RMSHE-MSH/Mechanical_Design_Course_Project_Open_Source/README.md

# 机械设计课程设计开源项目
# Mechanical Design Course Project Open Source

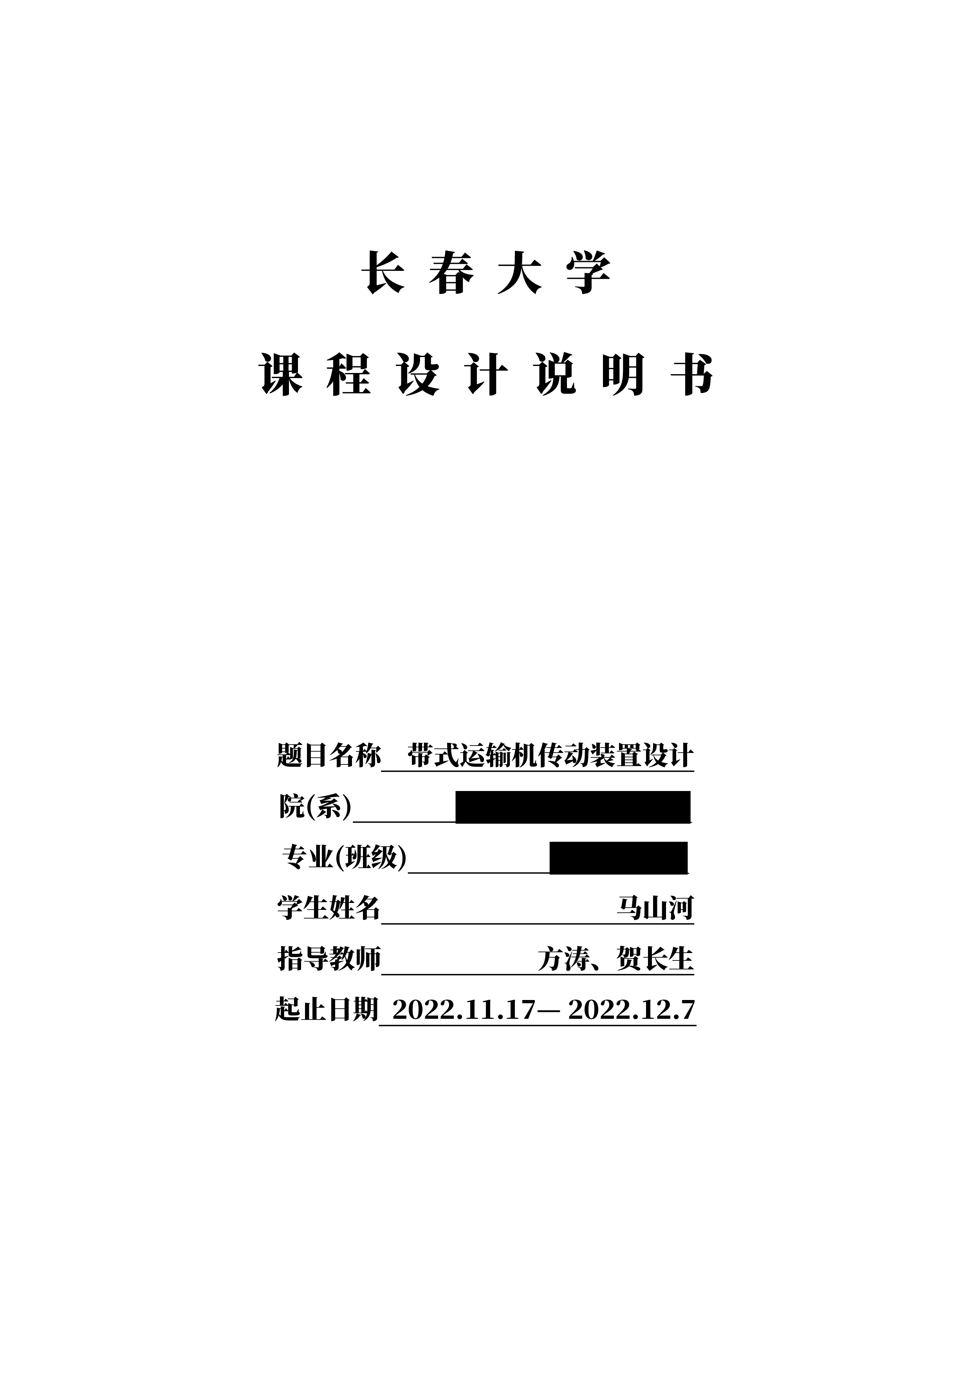
[picture p1: instruction/1.png]
instr

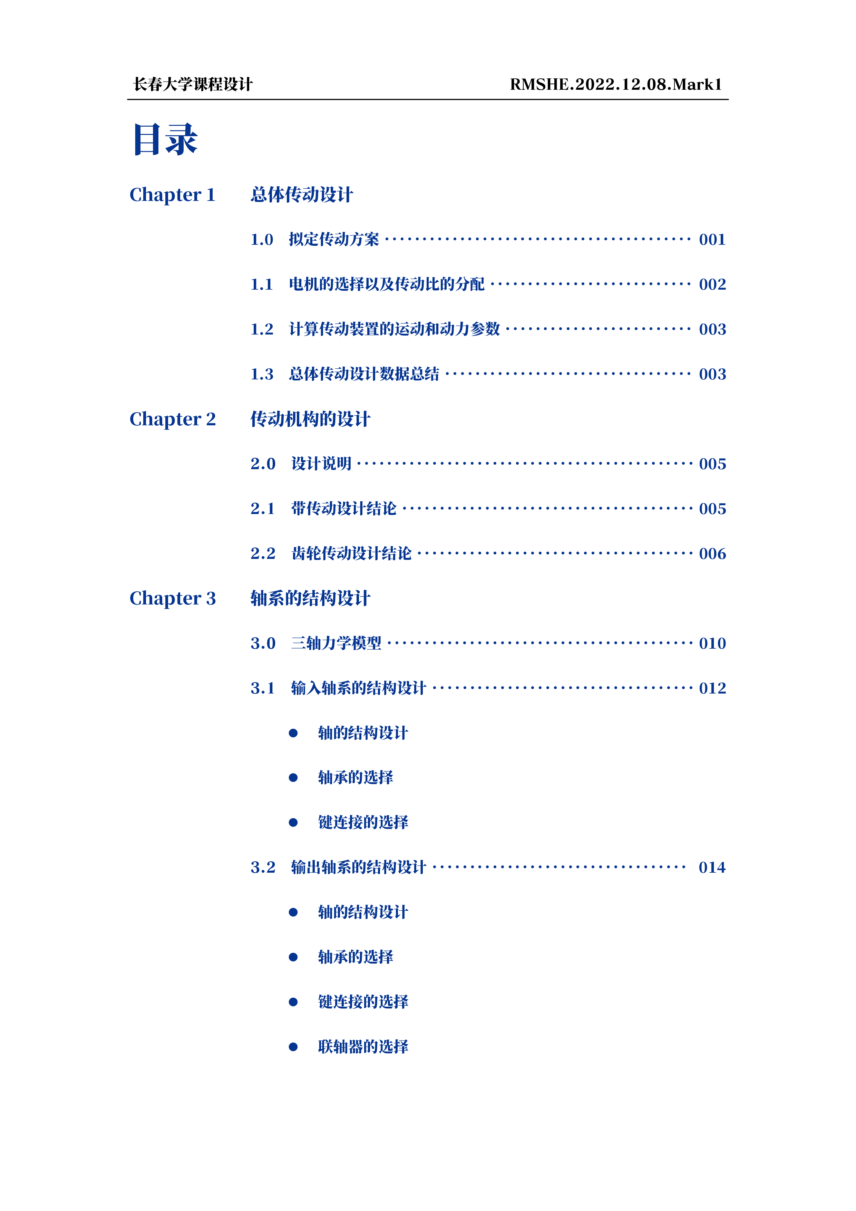
[picture p2: instruction/2.png]
instr

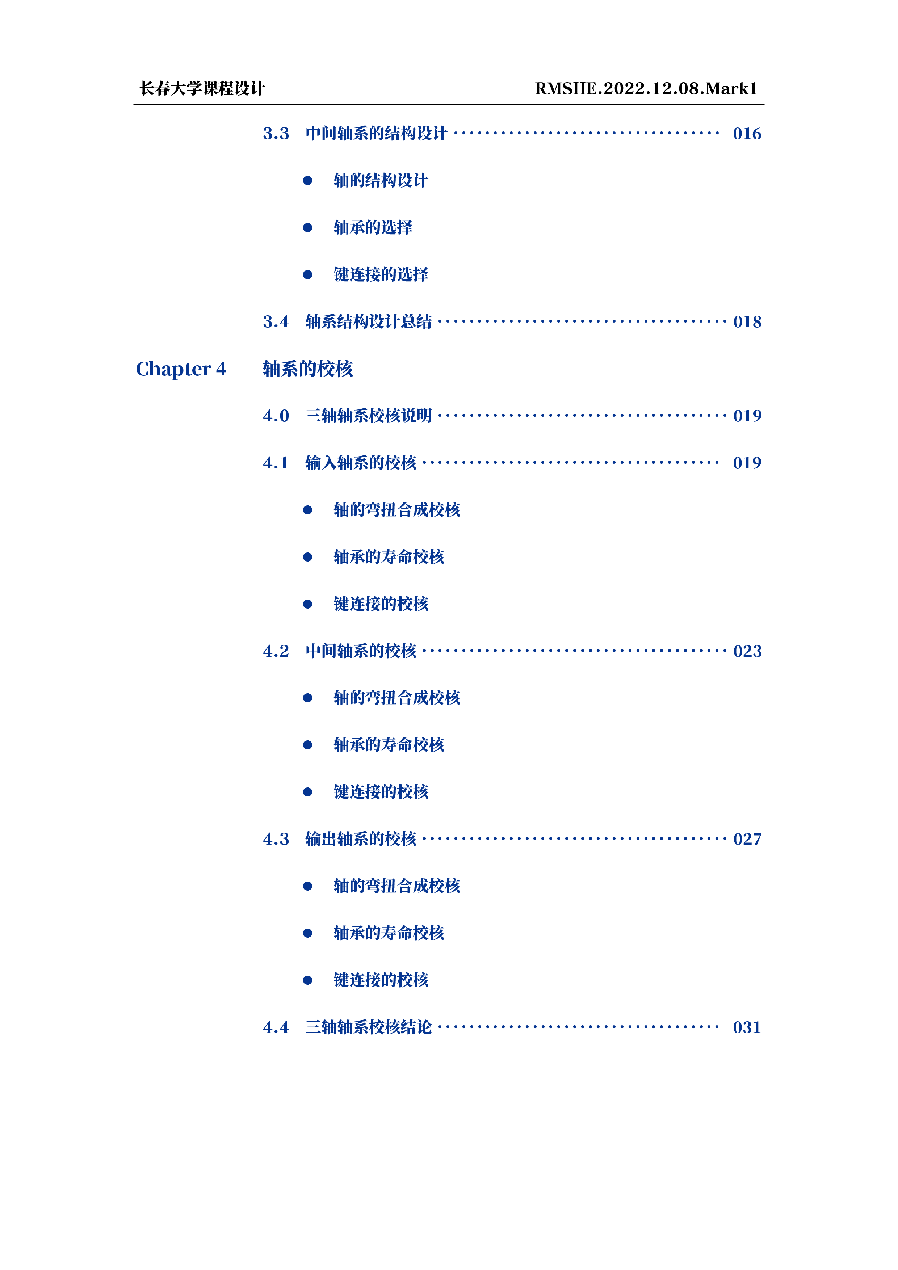
[picture p3: instruction/3.png]
instr

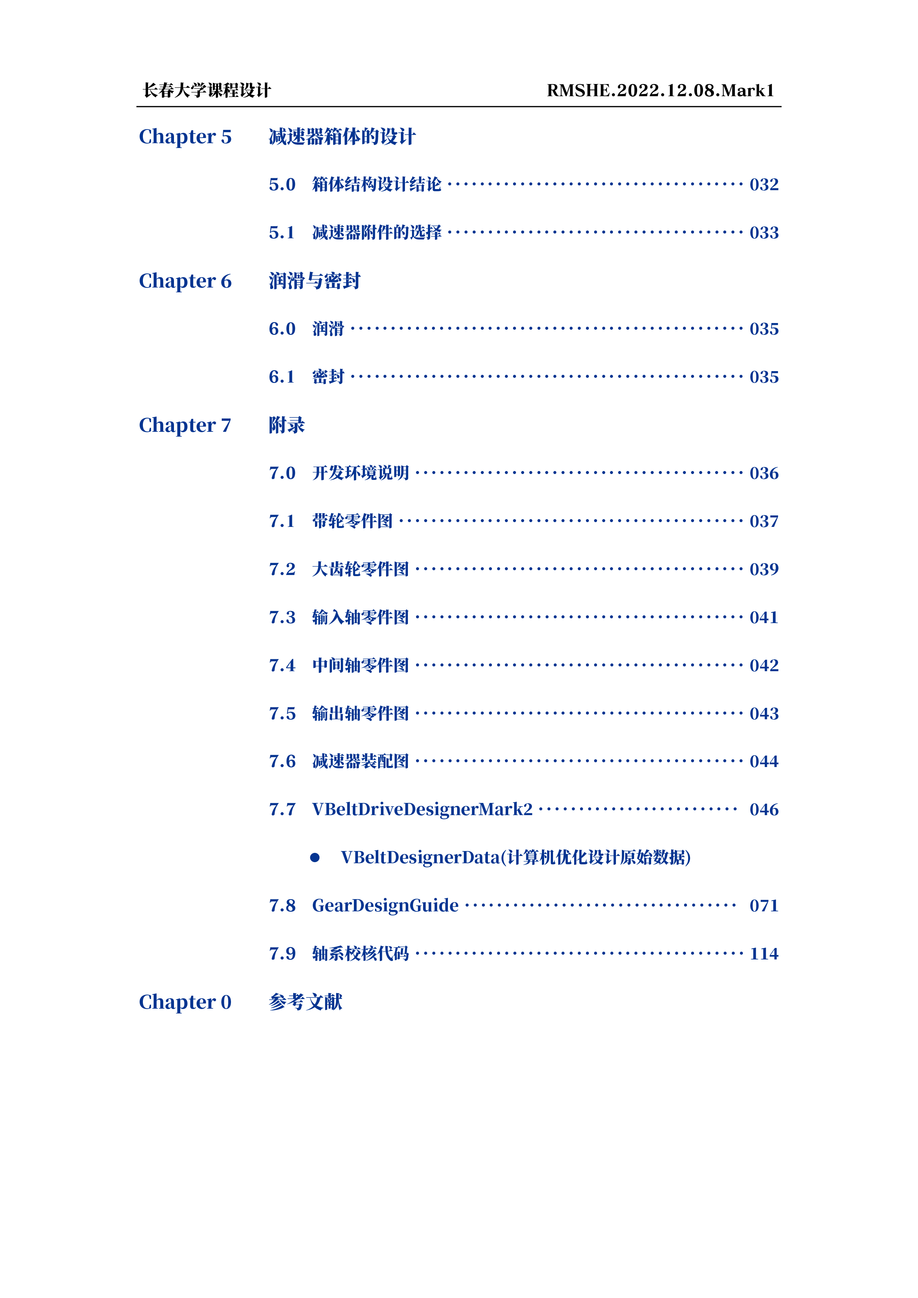
[picture p4: instruction/4.png]
instr

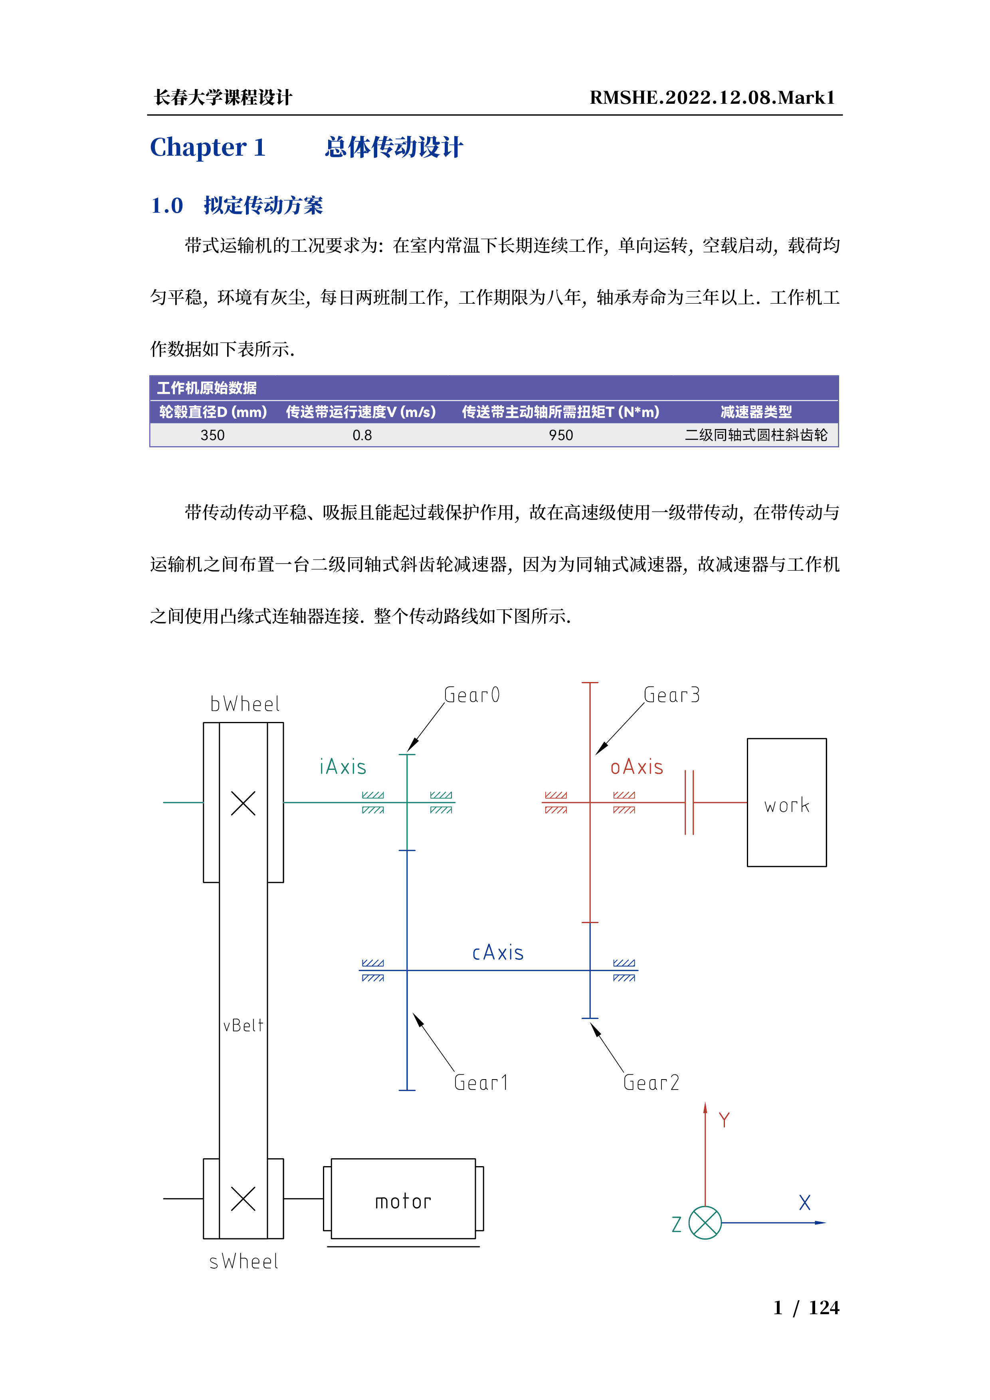
[picture p5: instruction/5.png]
instr

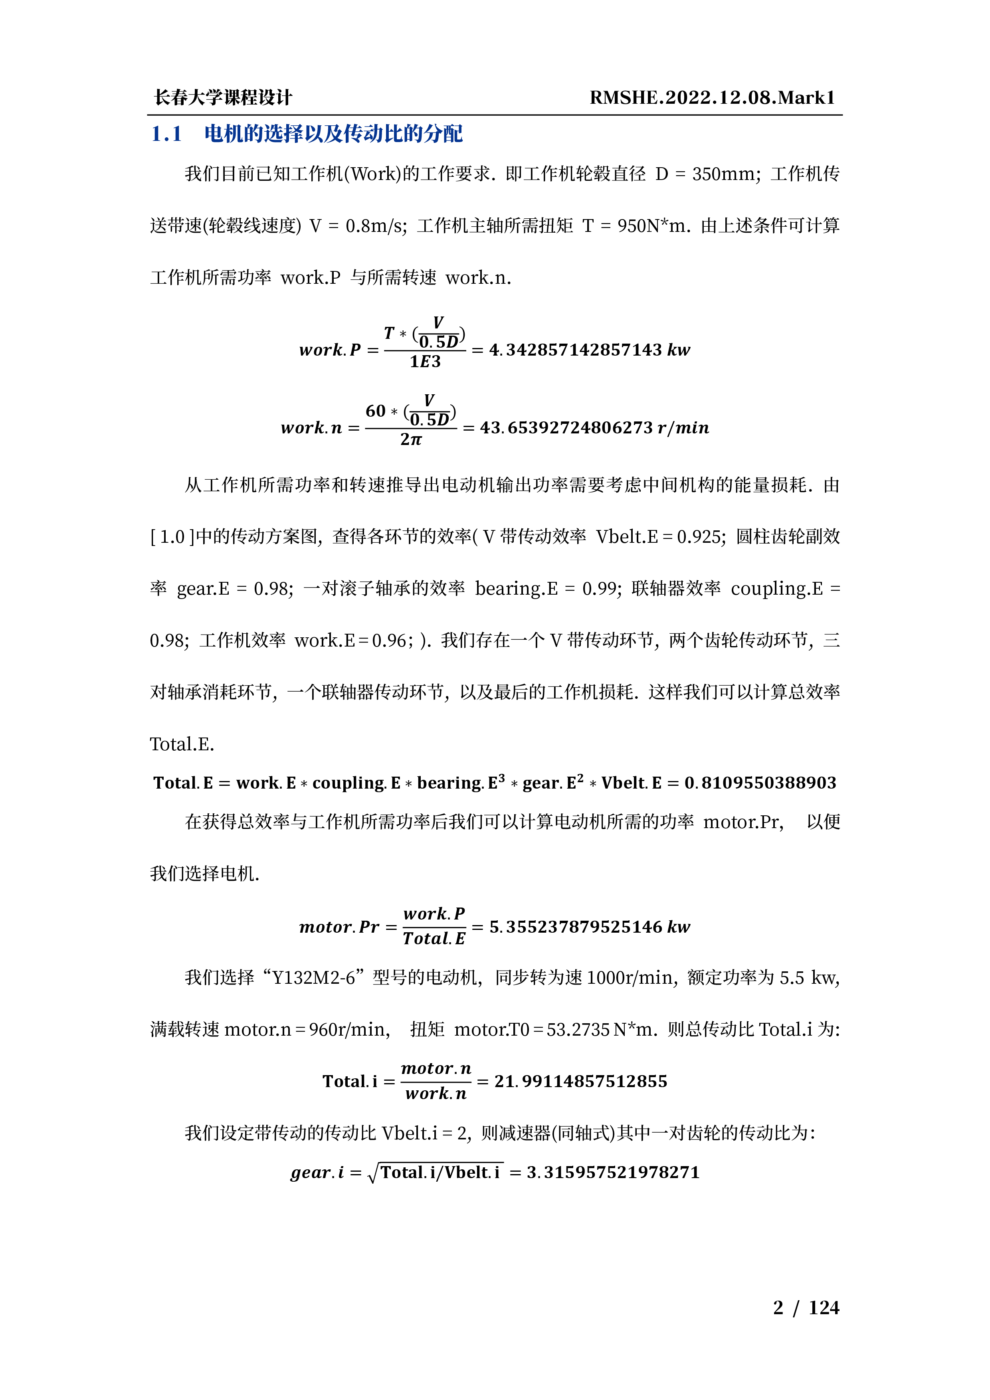
[picture p6: instruction/6.png]
instr

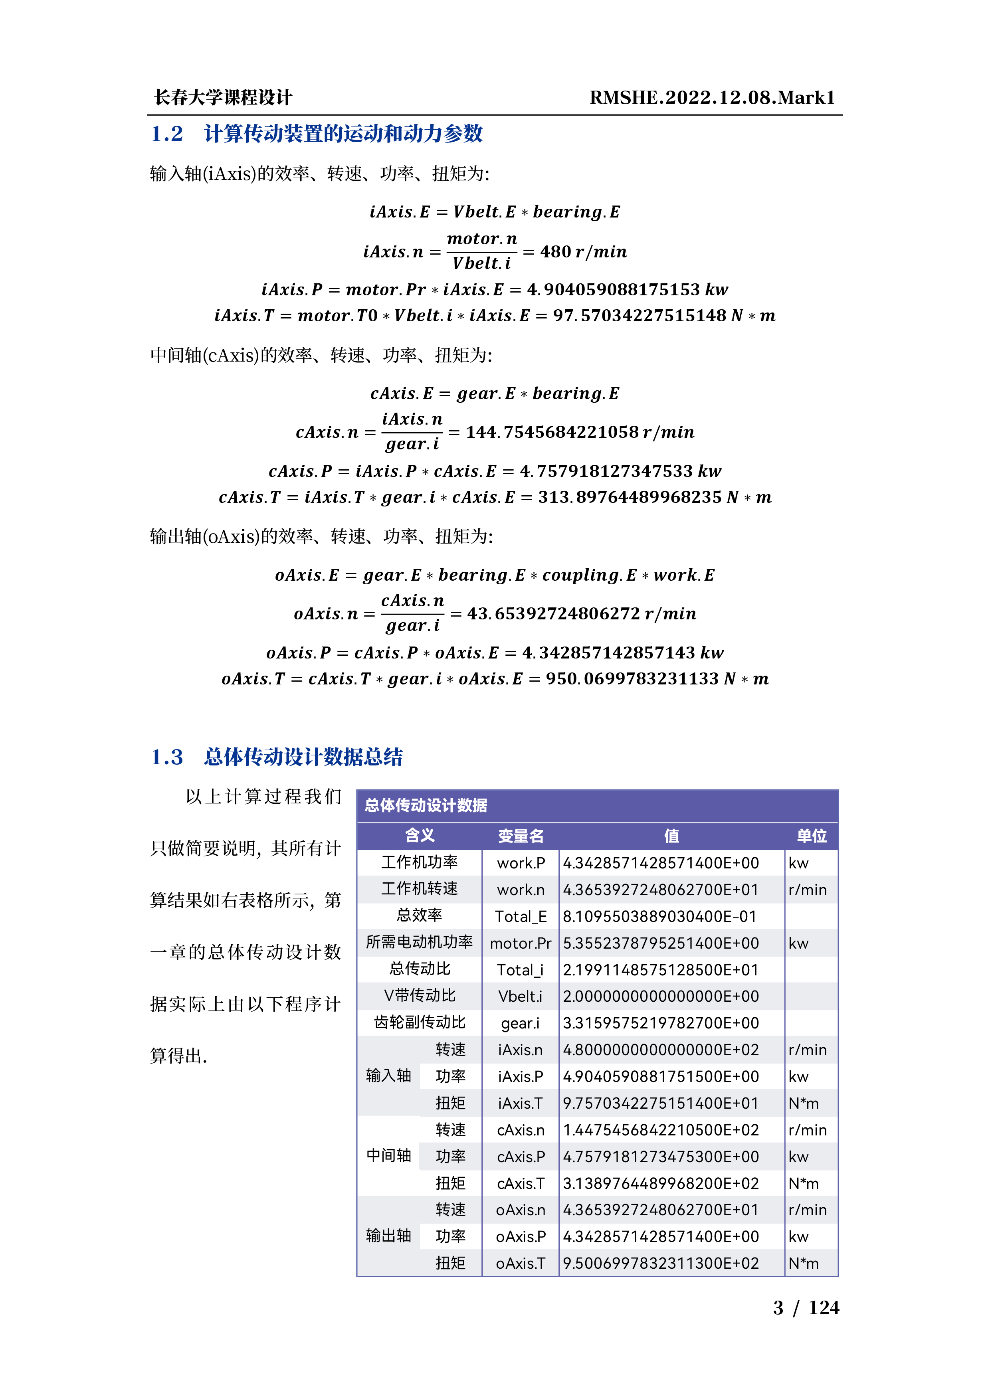
[picture p7: instruction/7.png]
instr

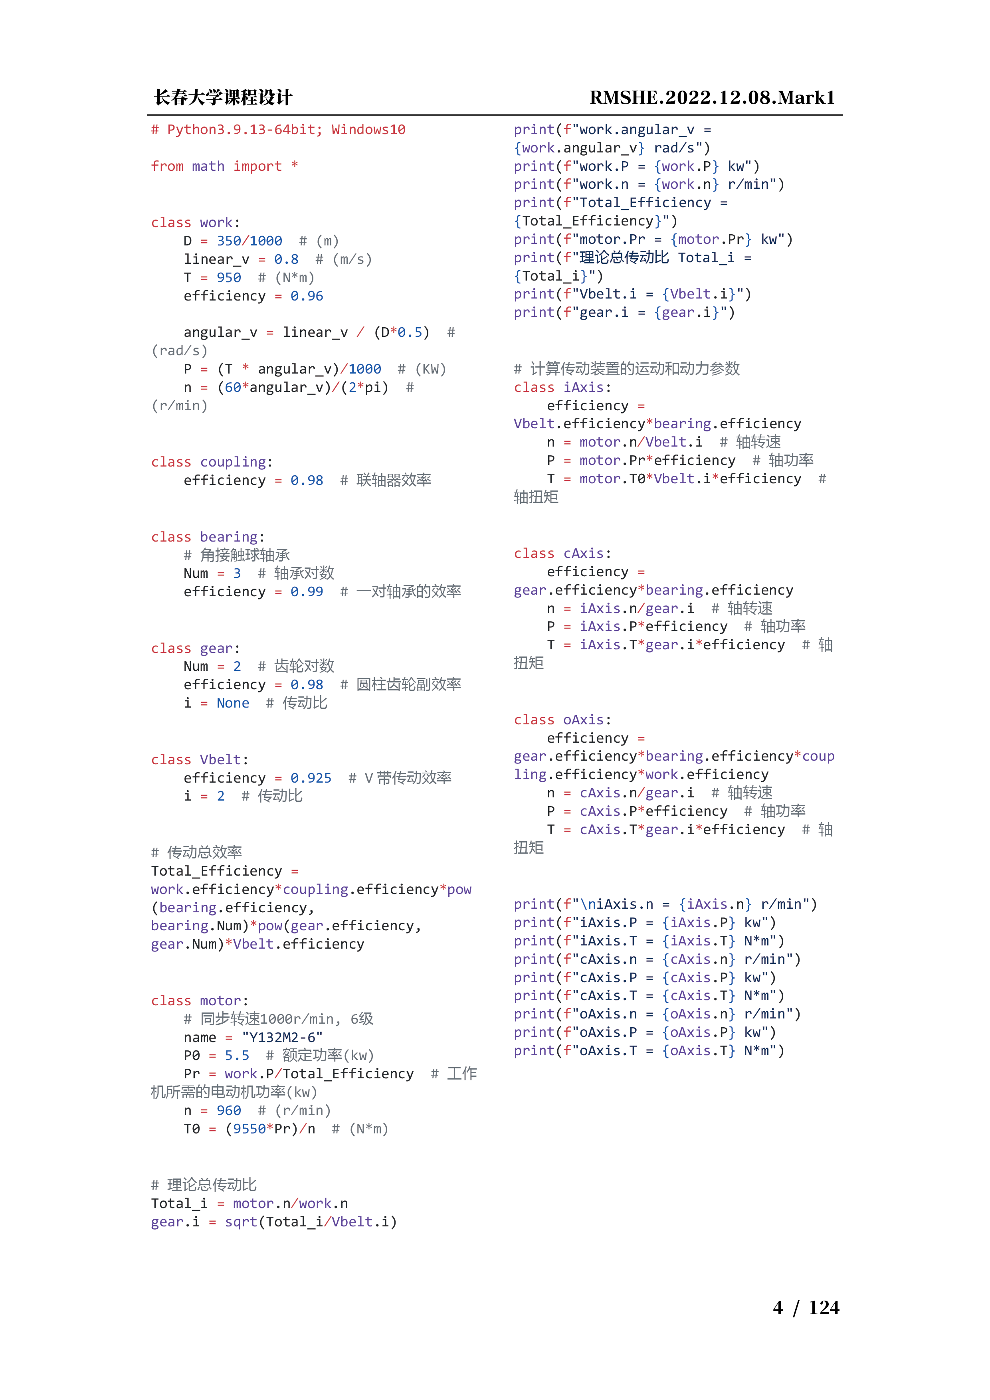
[picture p8: instruction/8.png]
instr

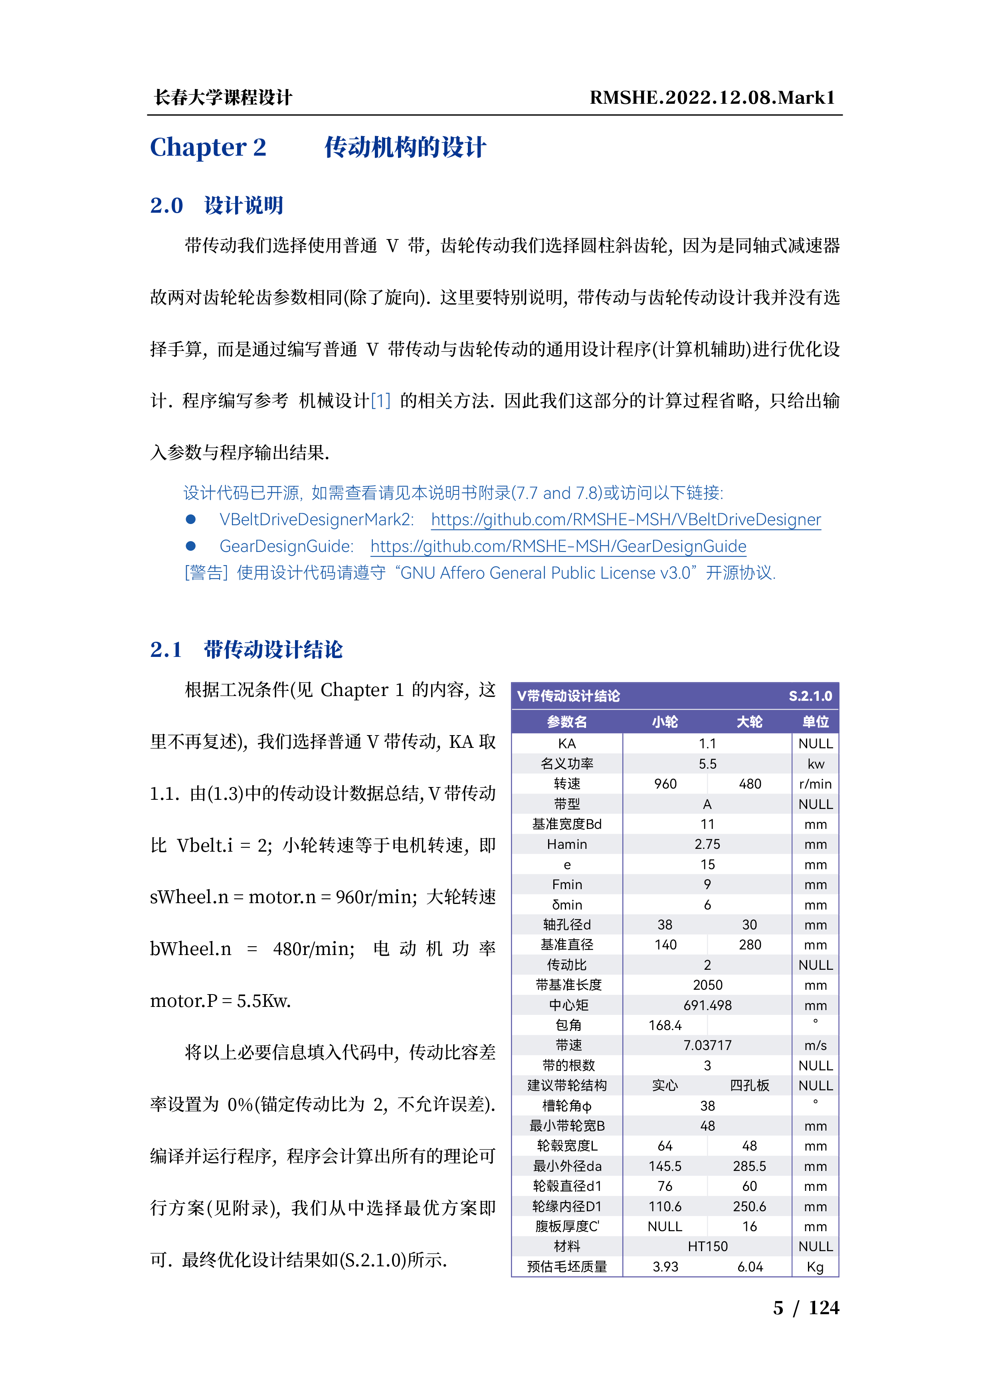
[picture p9: instruction/9.png]
instr

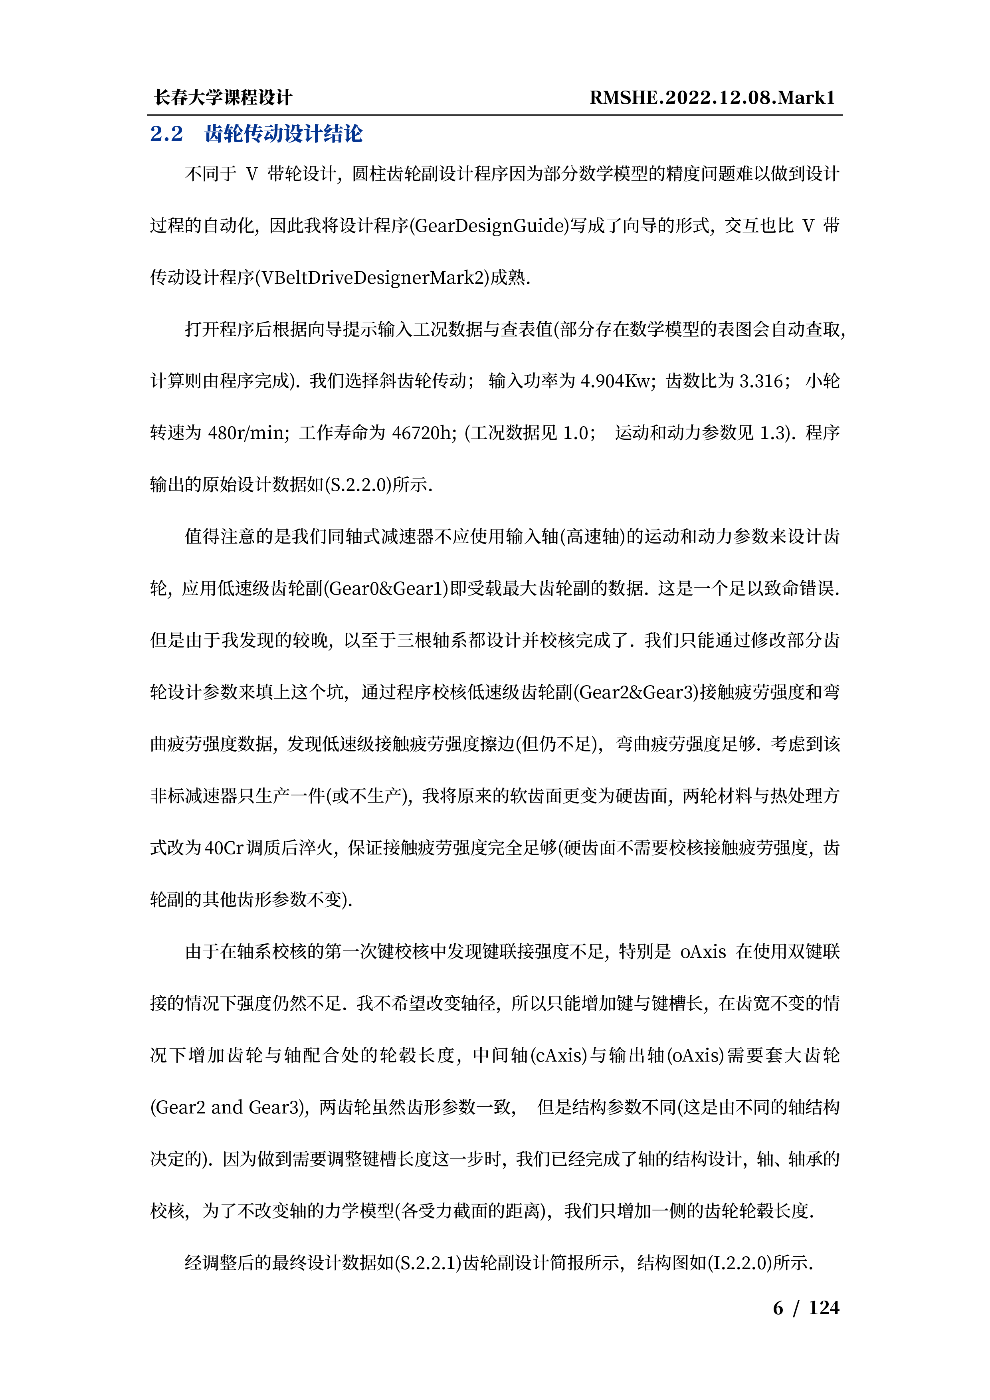
[picture p10: instruction/10.png]
instr

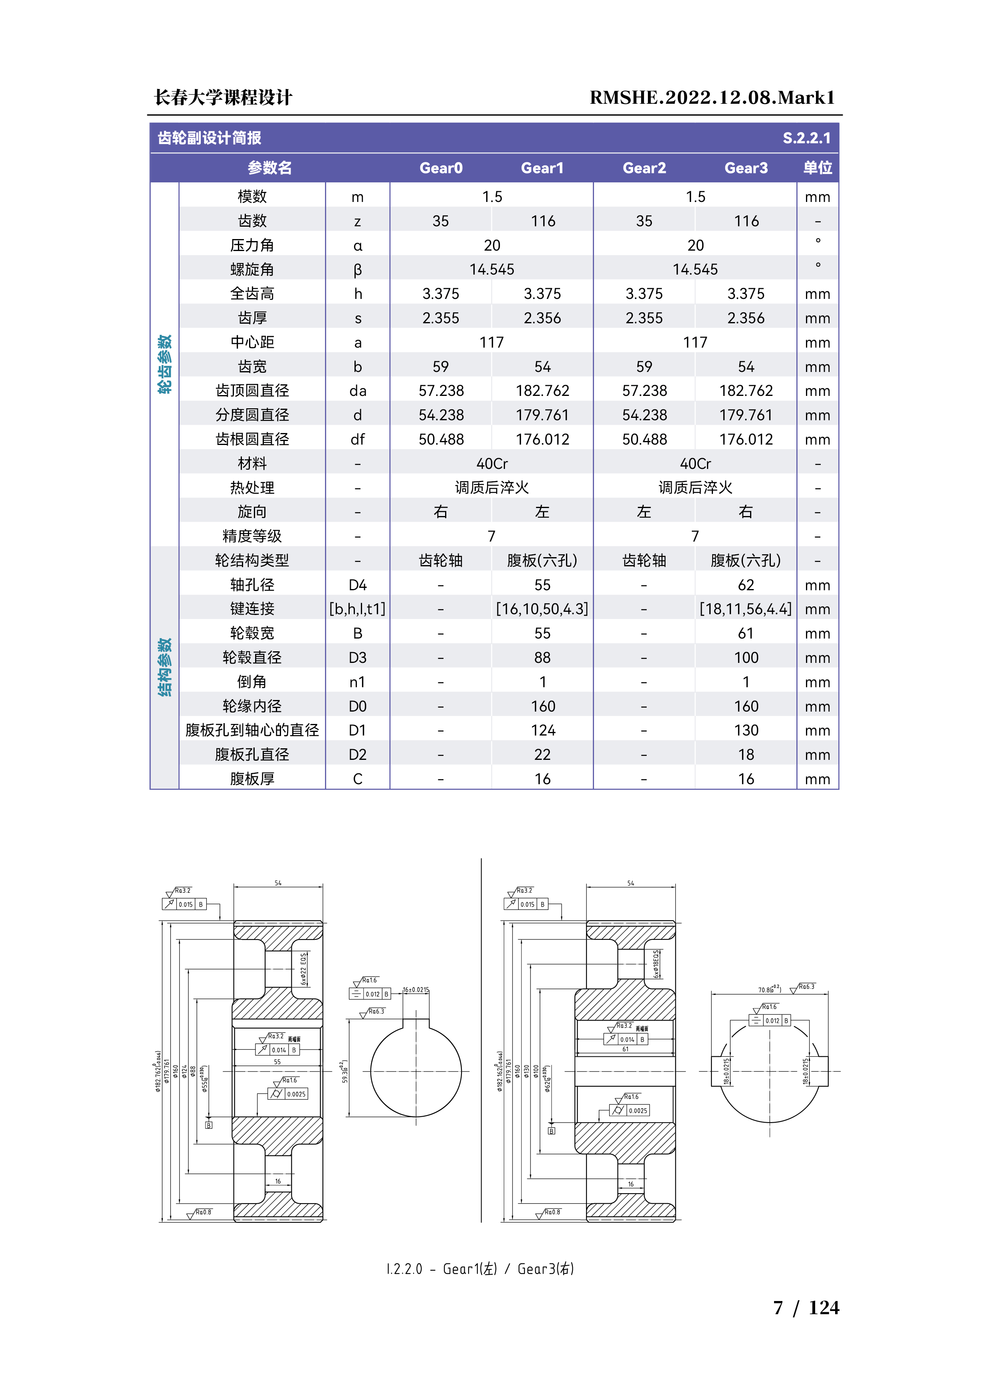
[picture p11: instruction/11.png]
instr

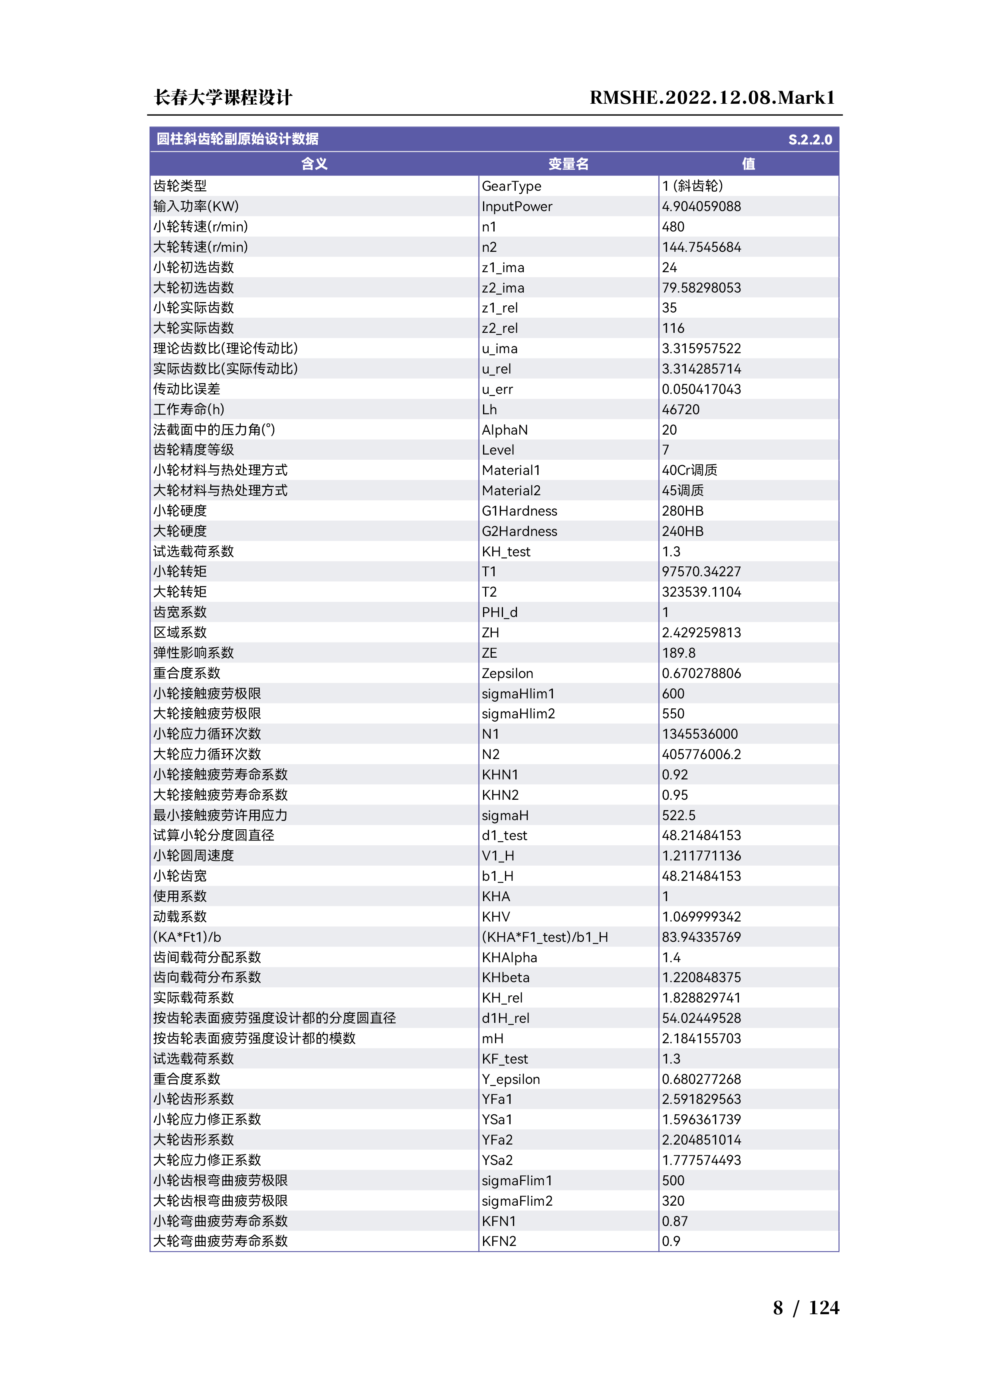
[picture p12: instruction/12.png]
instr

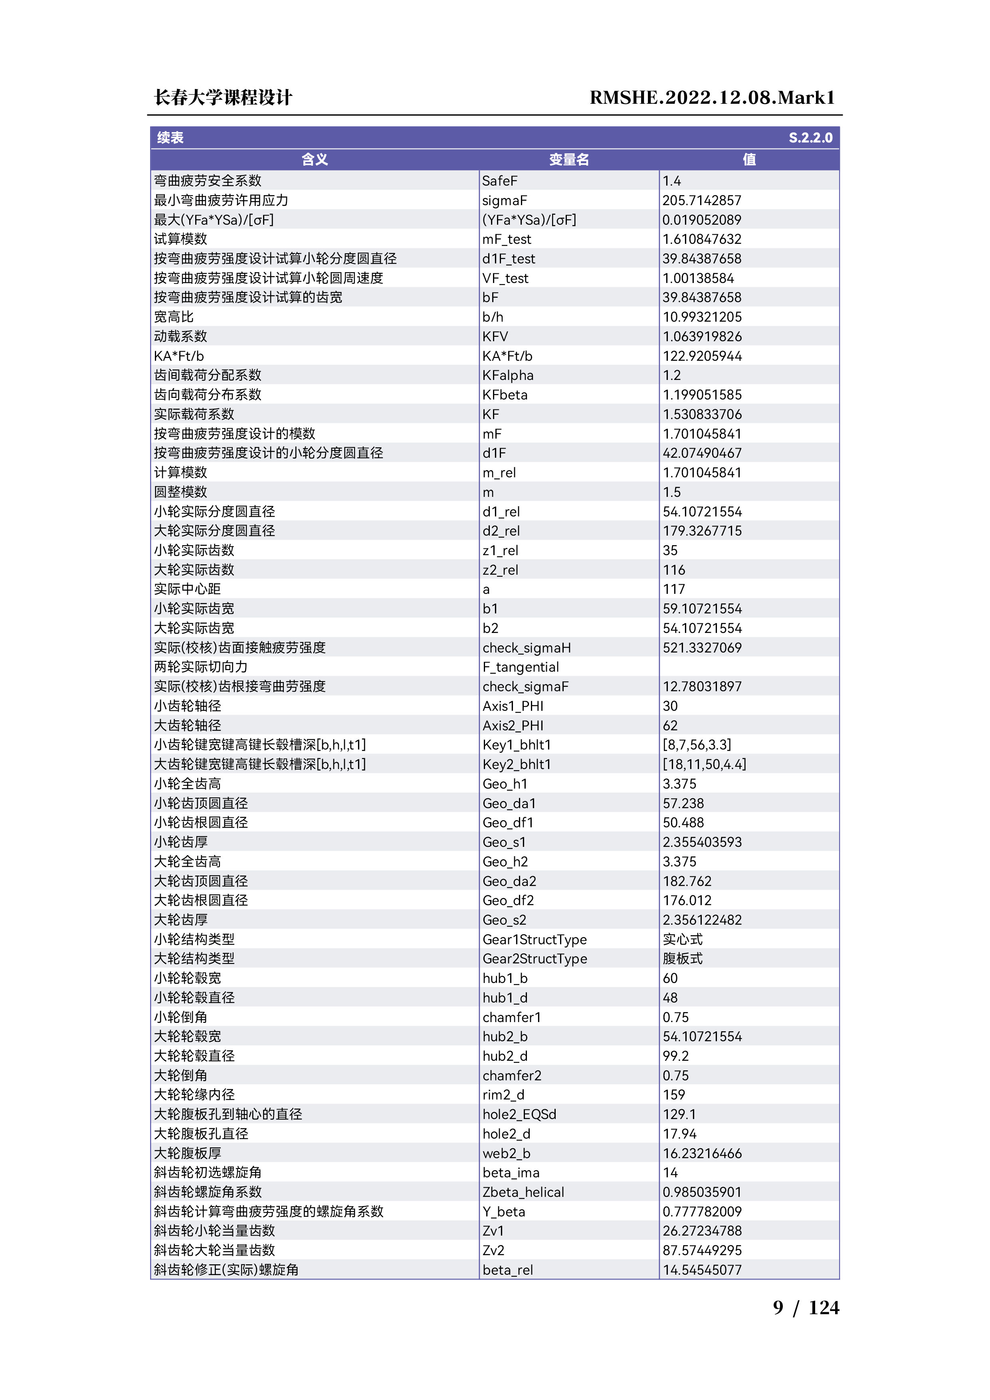
[picture p13: instruction/13.png]
instr

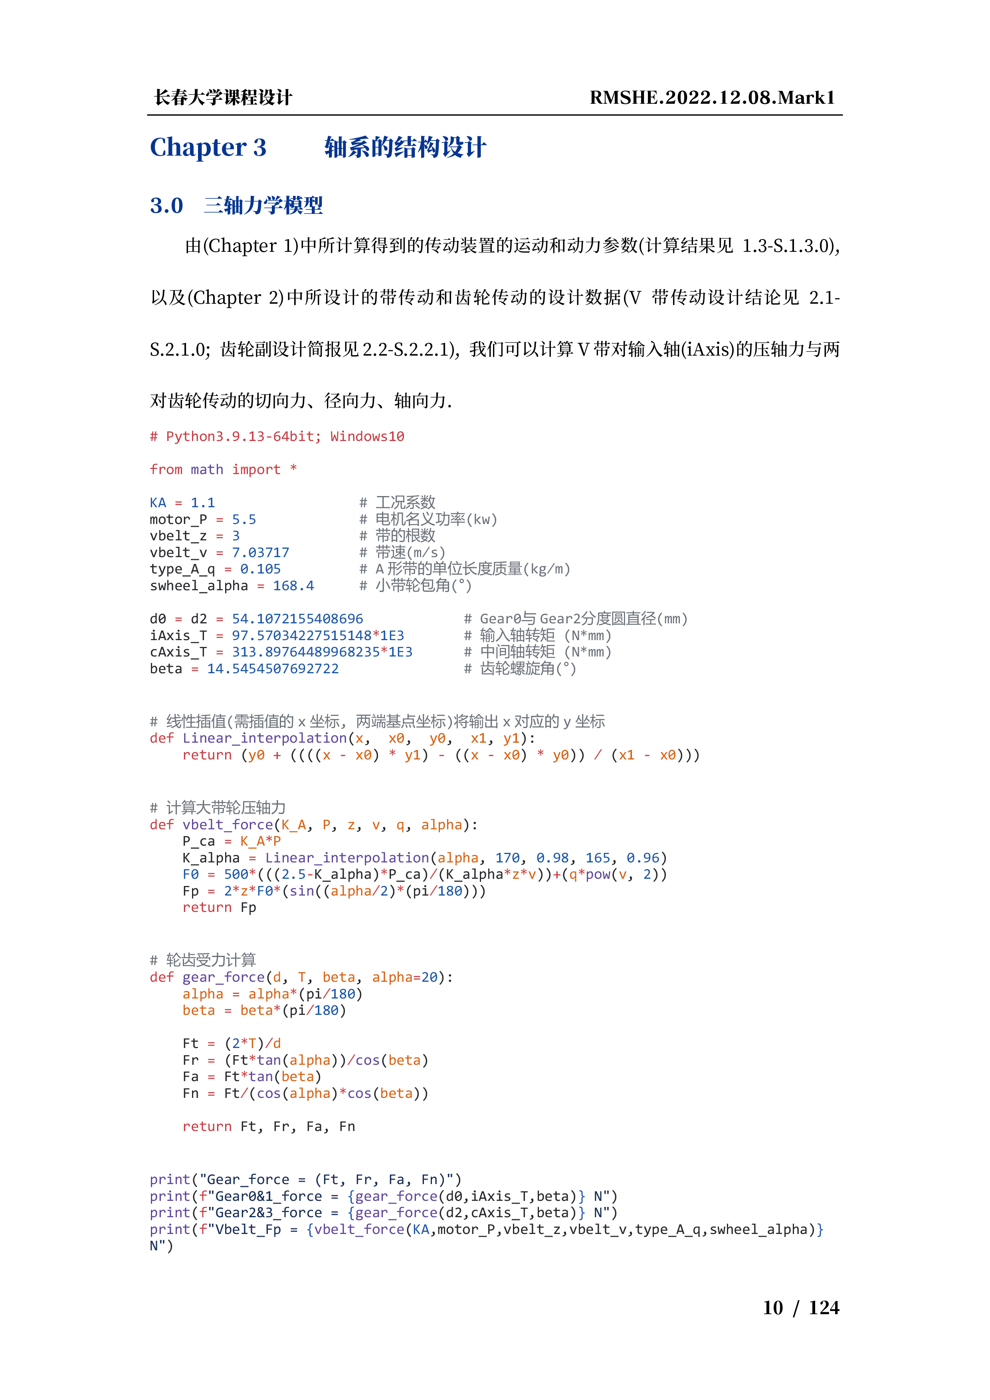
[picture p14: instruction/14.png]
instr

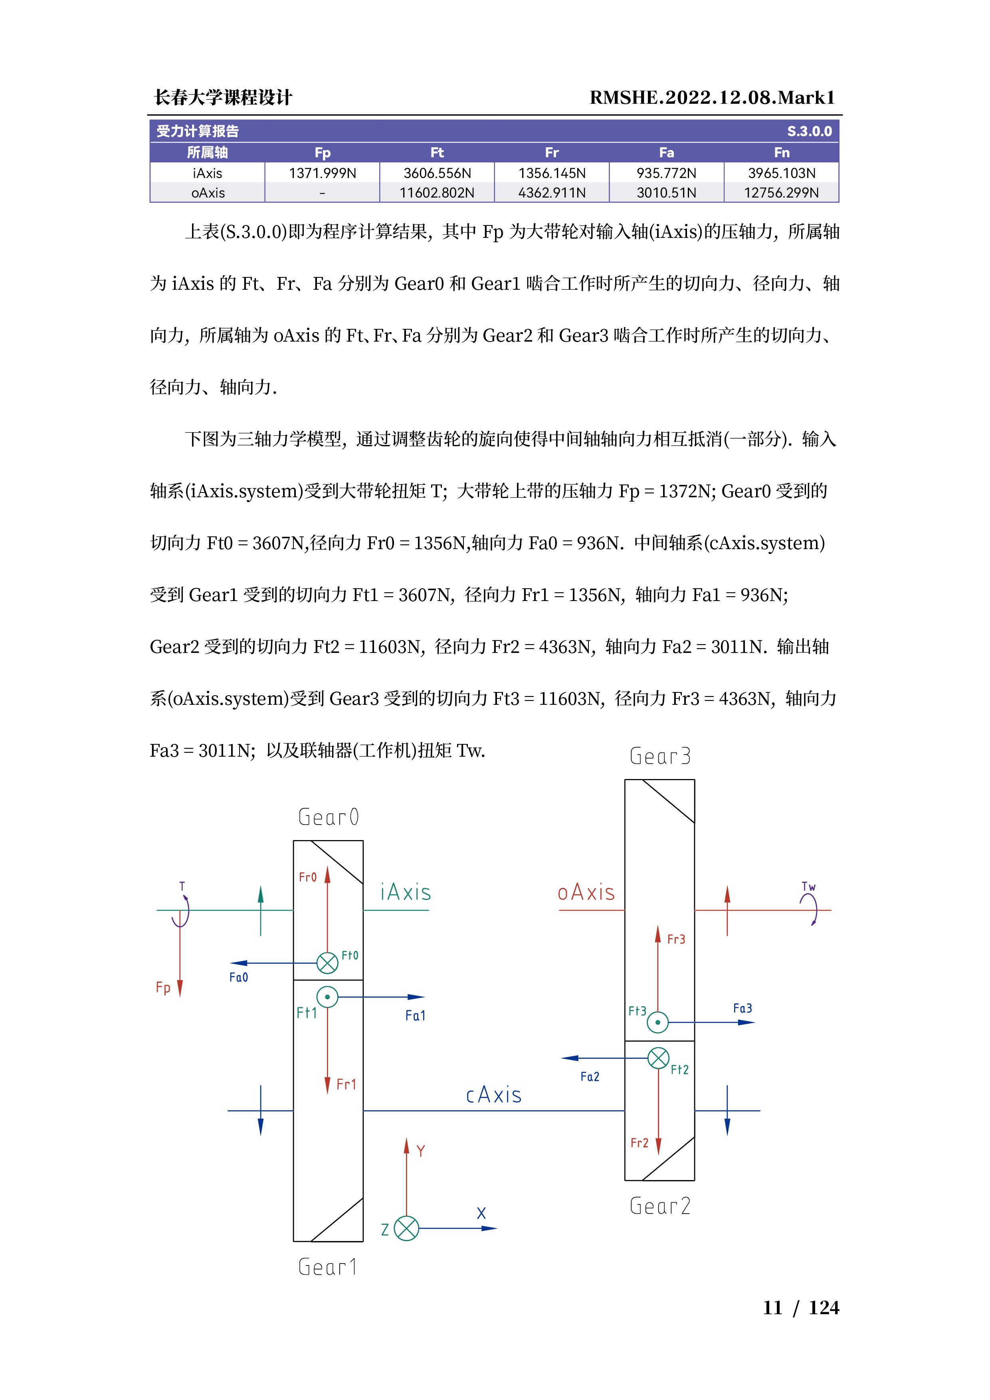
[picture p15: instruction/15.png]
instr

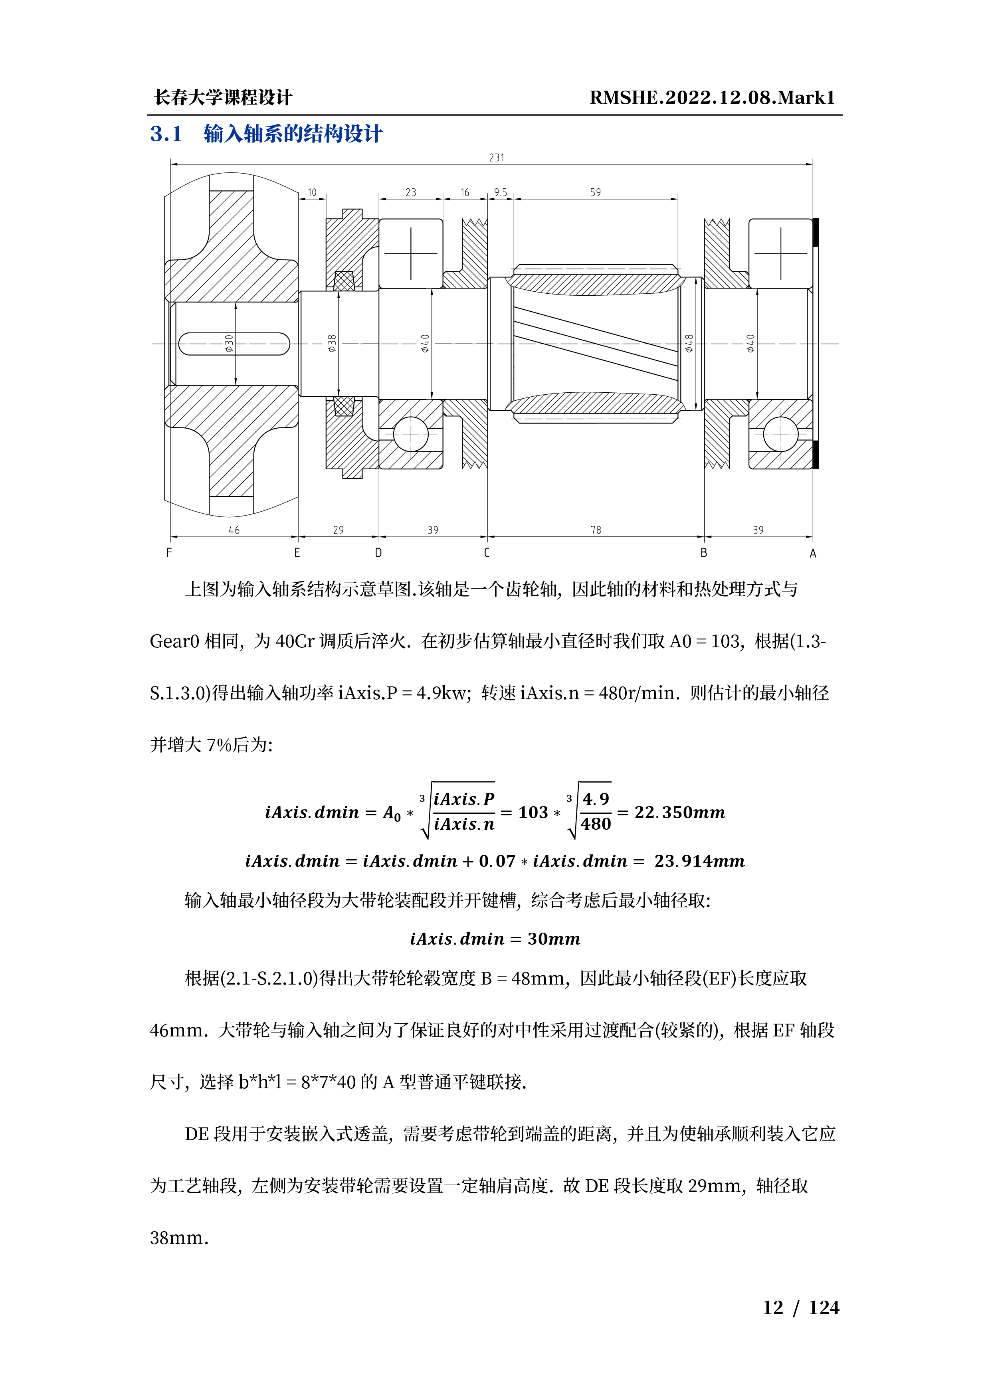
[picture p16: instruction/16.png]
instr

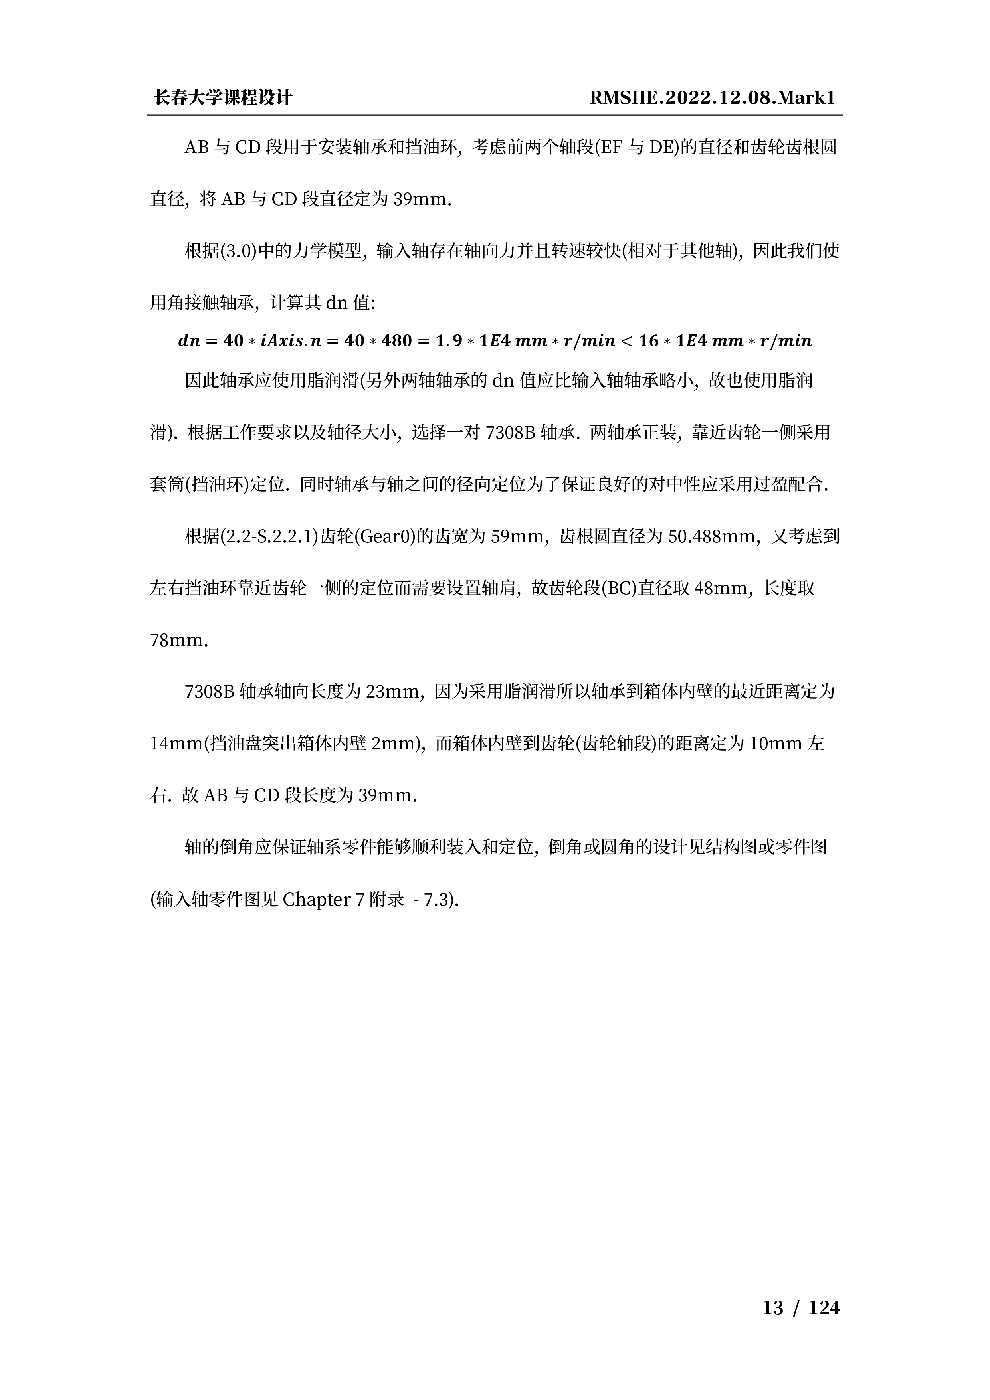
[picture p17: instruction/17.png]
instr

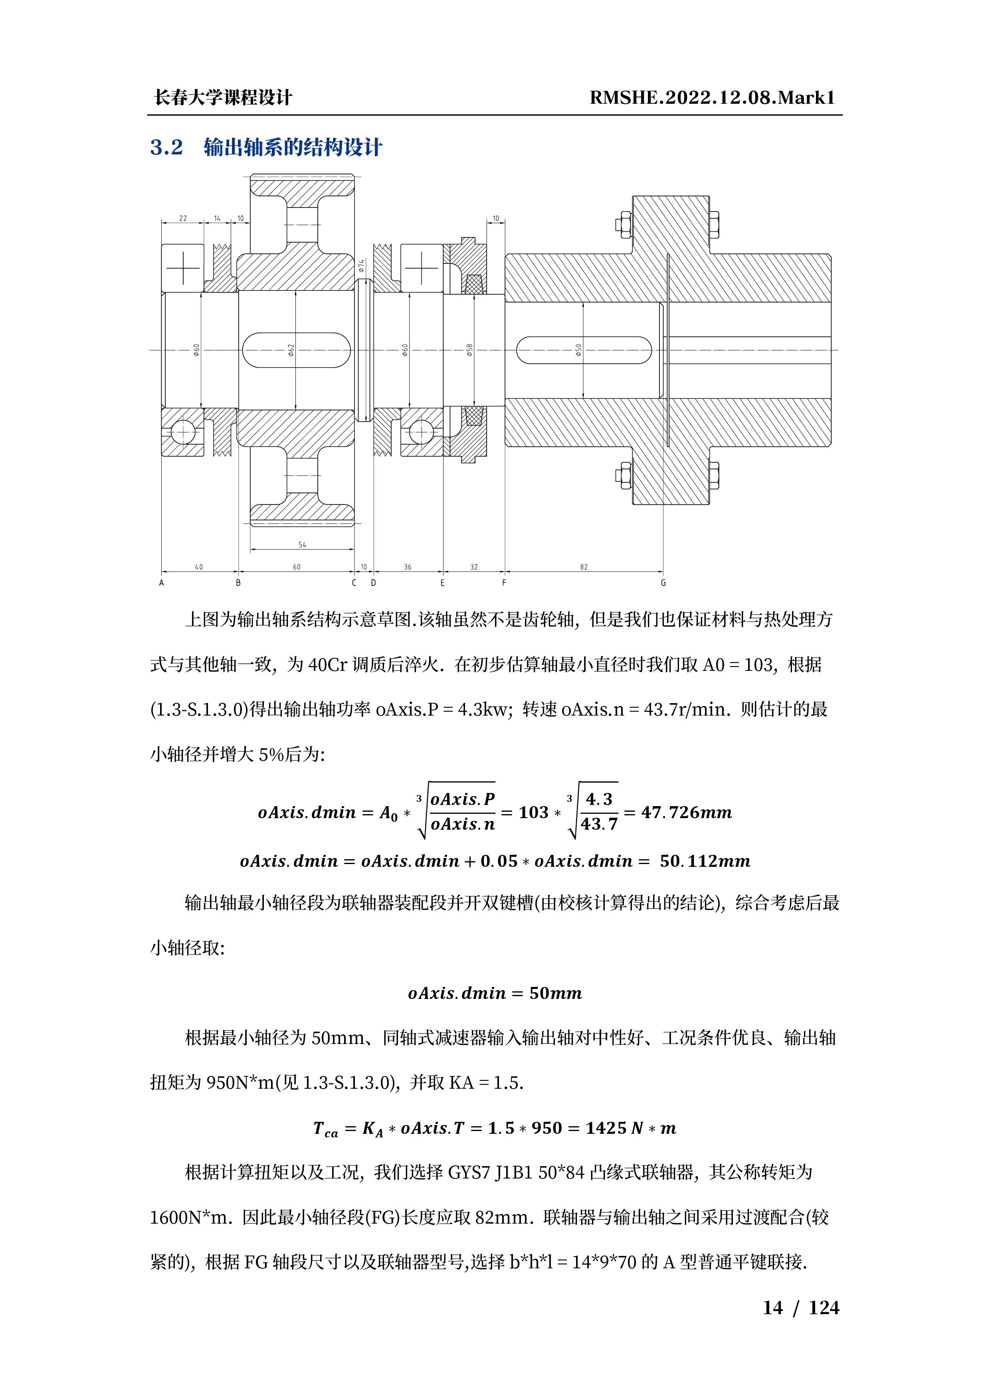
[picture p18: instruction/18.png]
instr

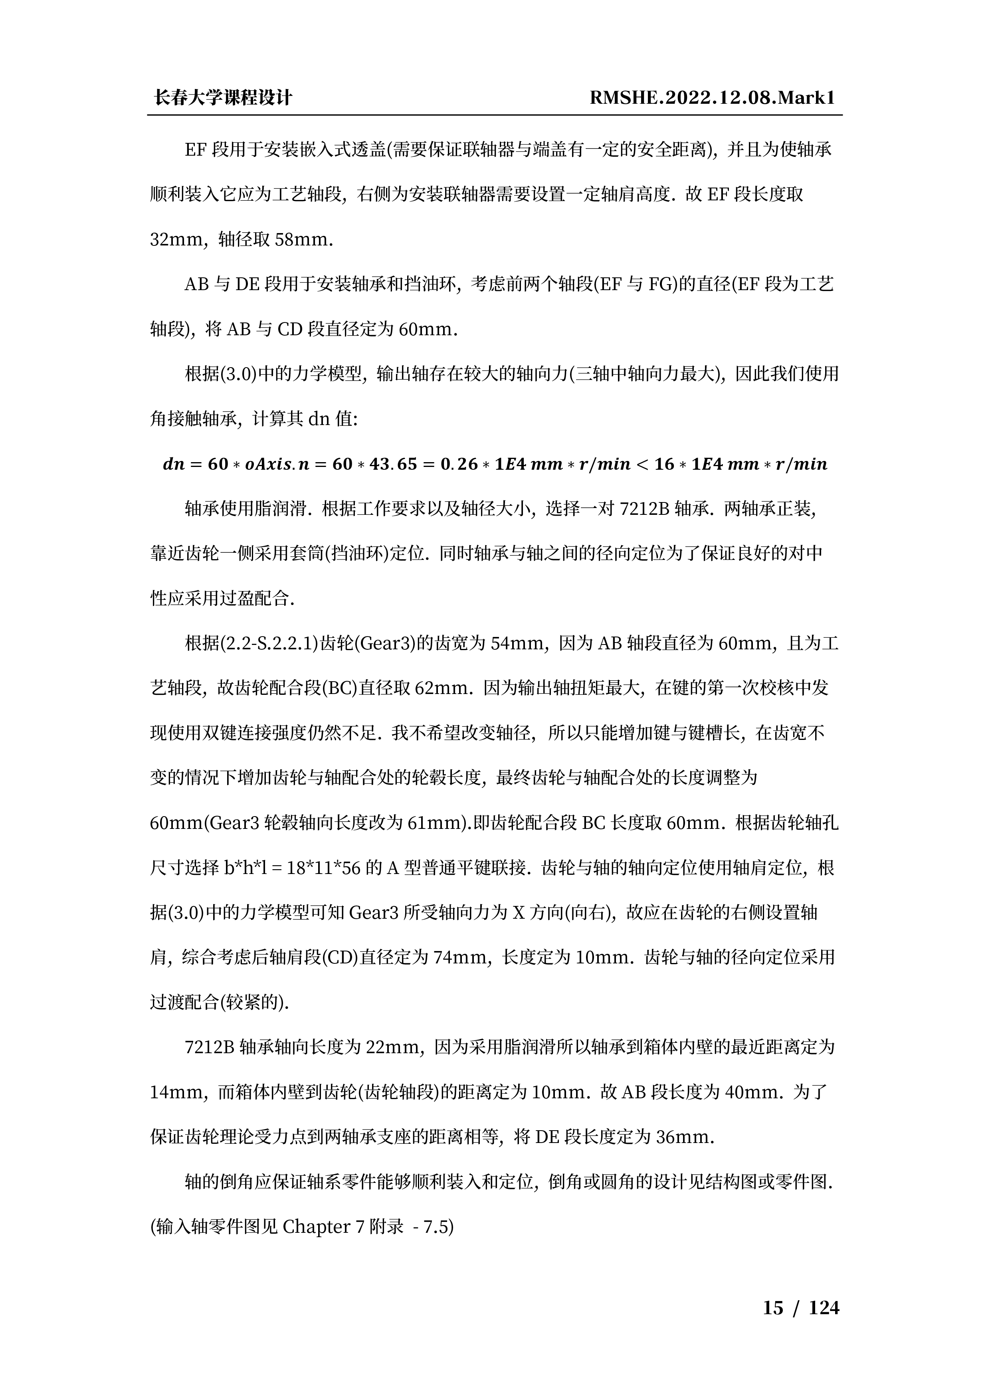
[picture p19: instruction/19.png]
instr

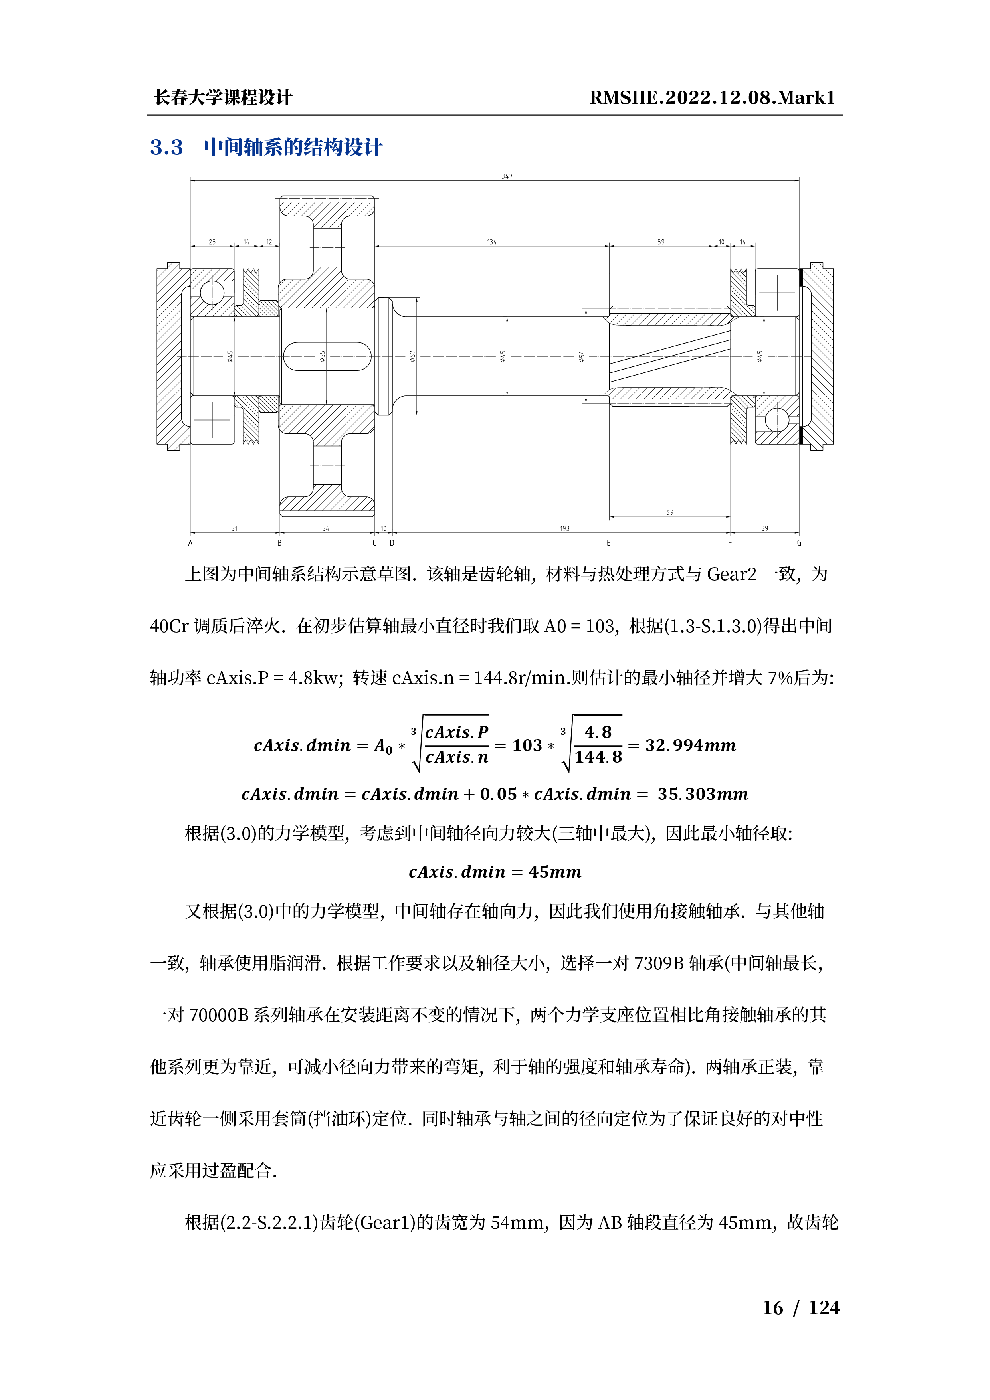
[picture p20: instruction/20.png]
instr

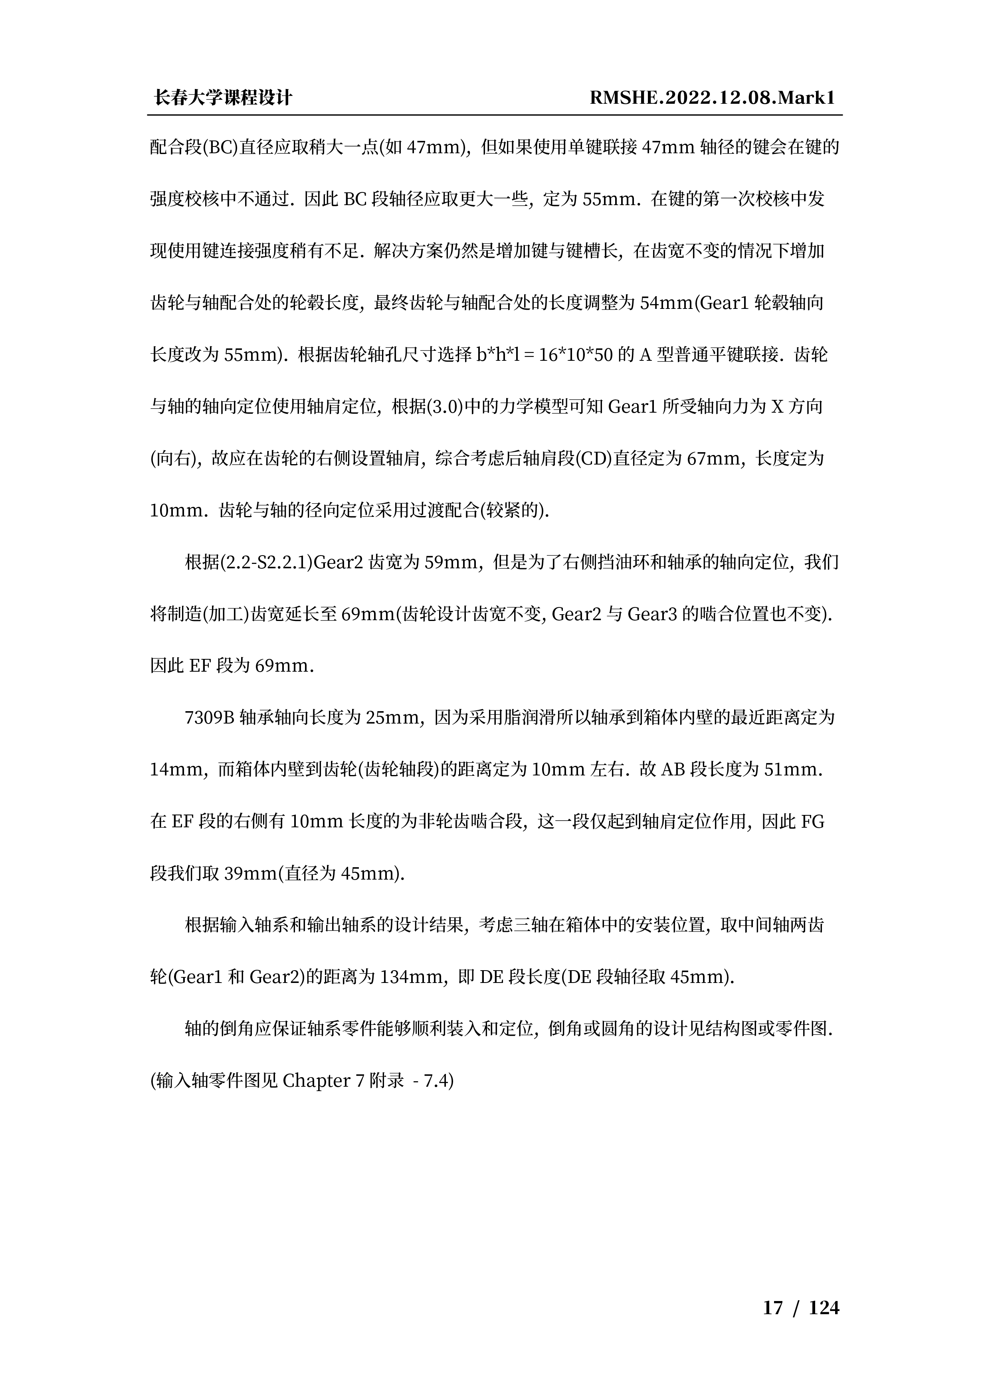
[picture p21: instruction/21.png]
instr

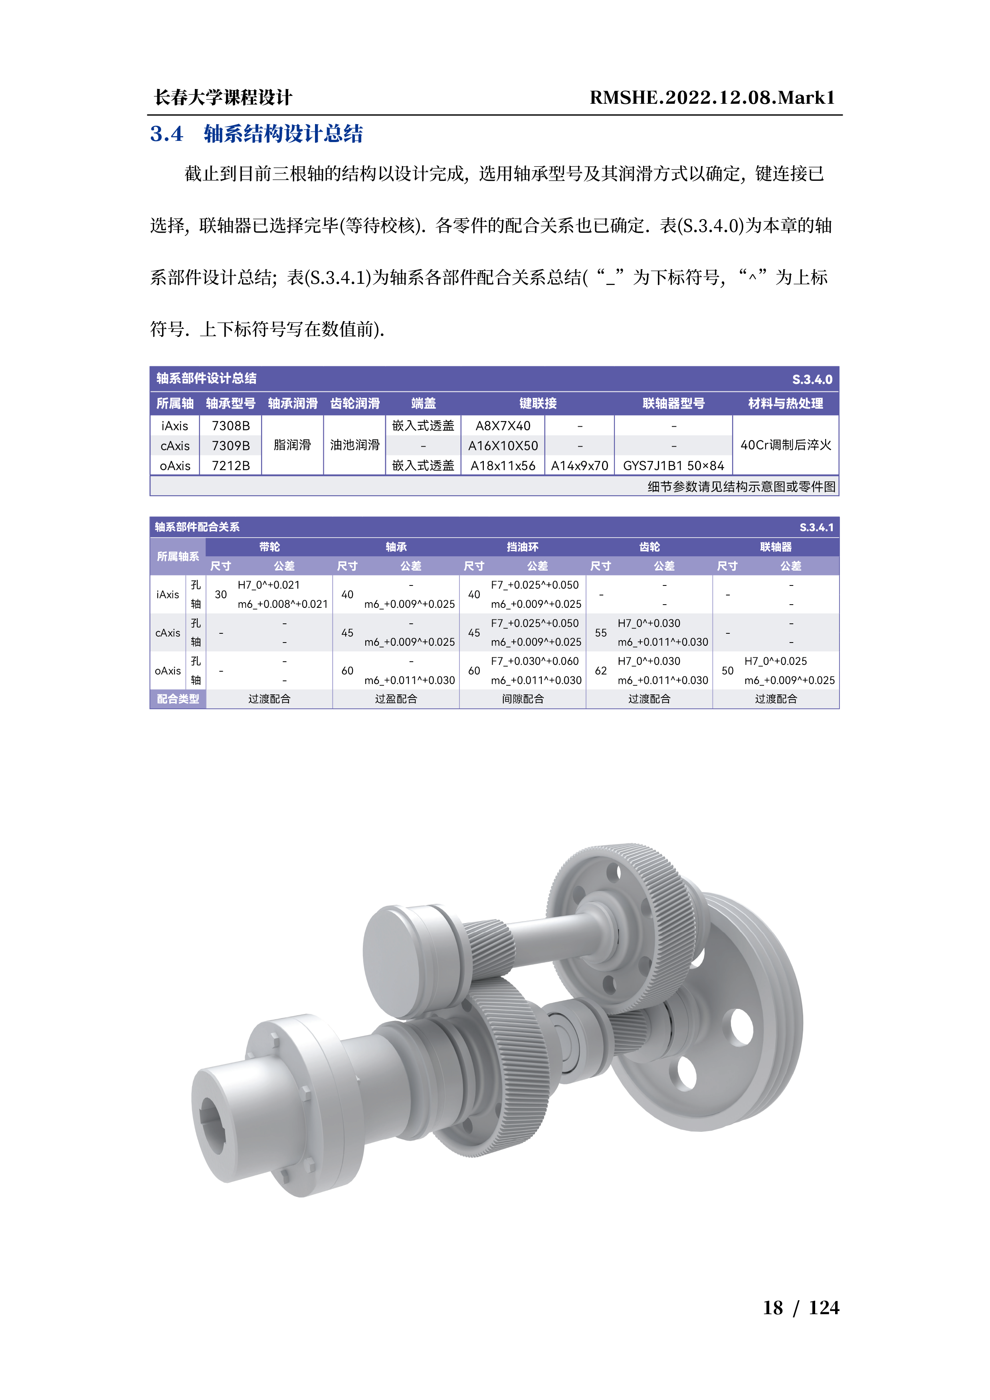
[picture p22: instruction/22.png]
instr

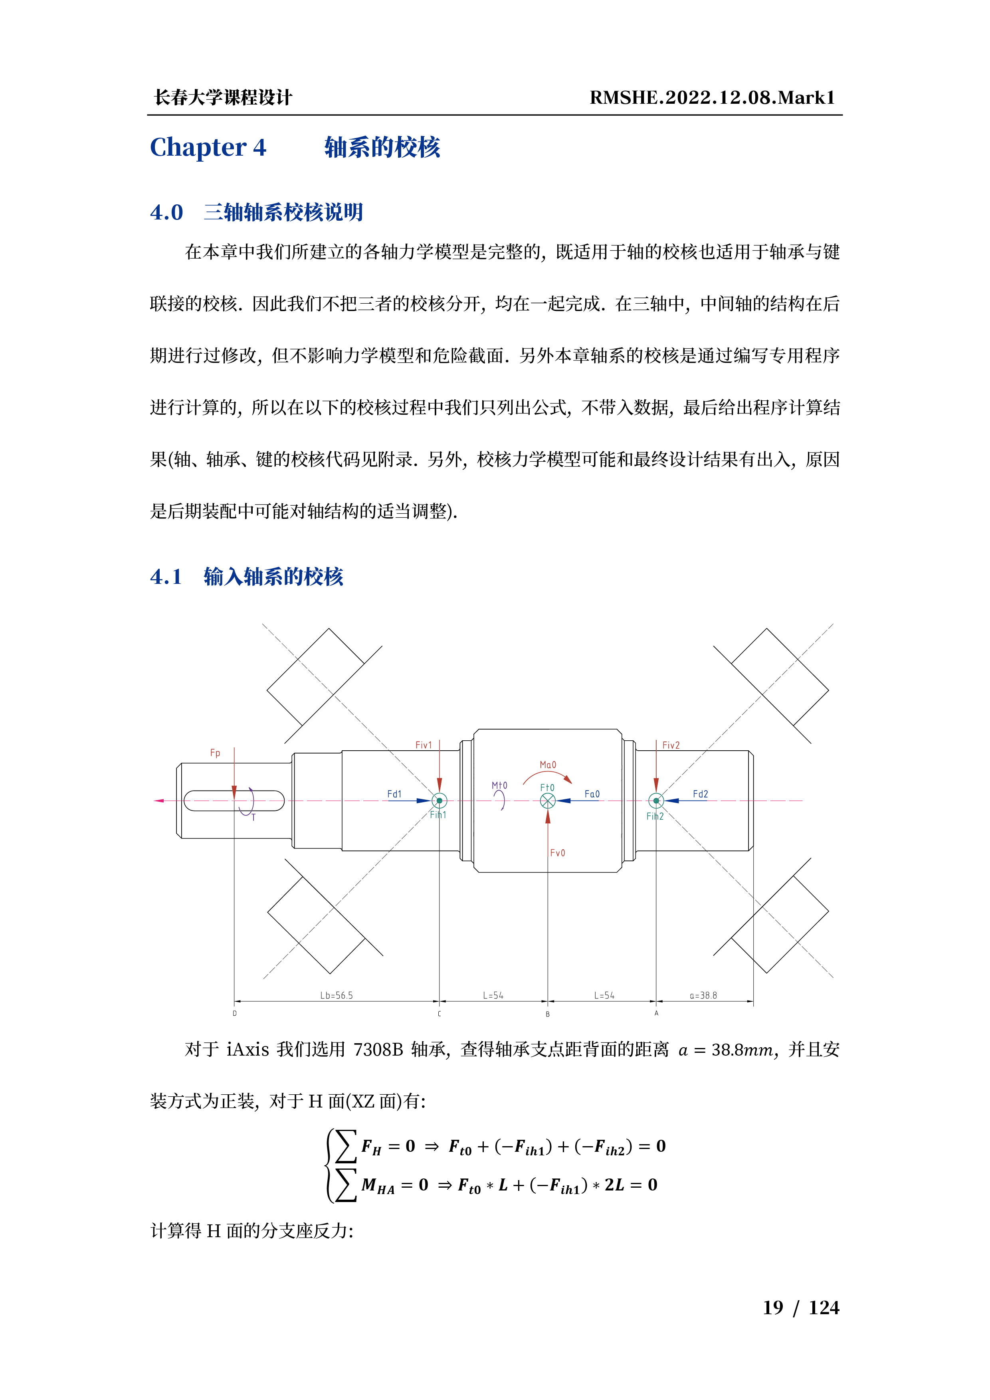
[picture p23: instruction/23.png]
instr

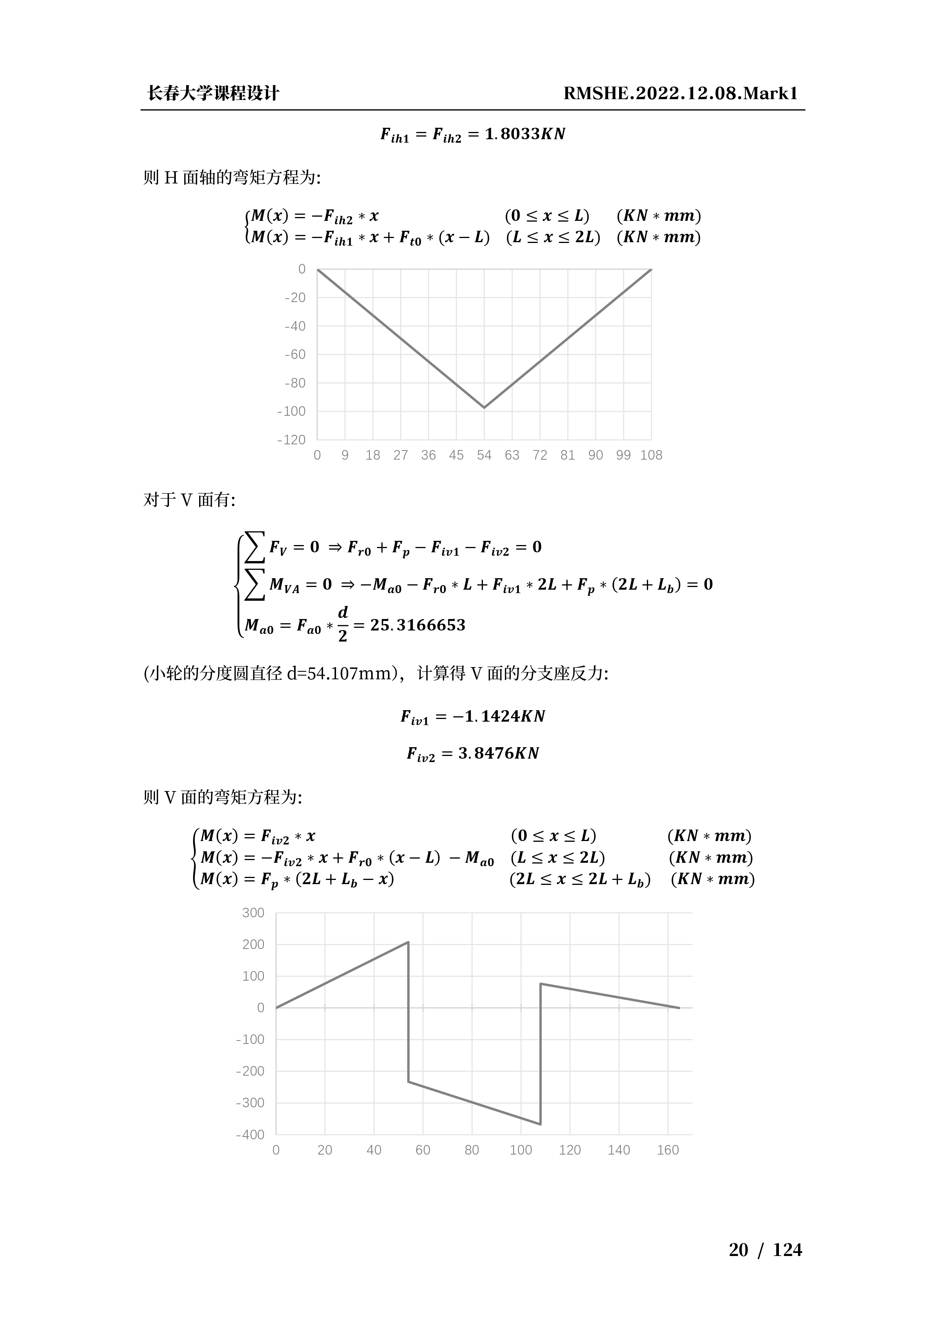
[picture p24: instruction/24.png]
instr

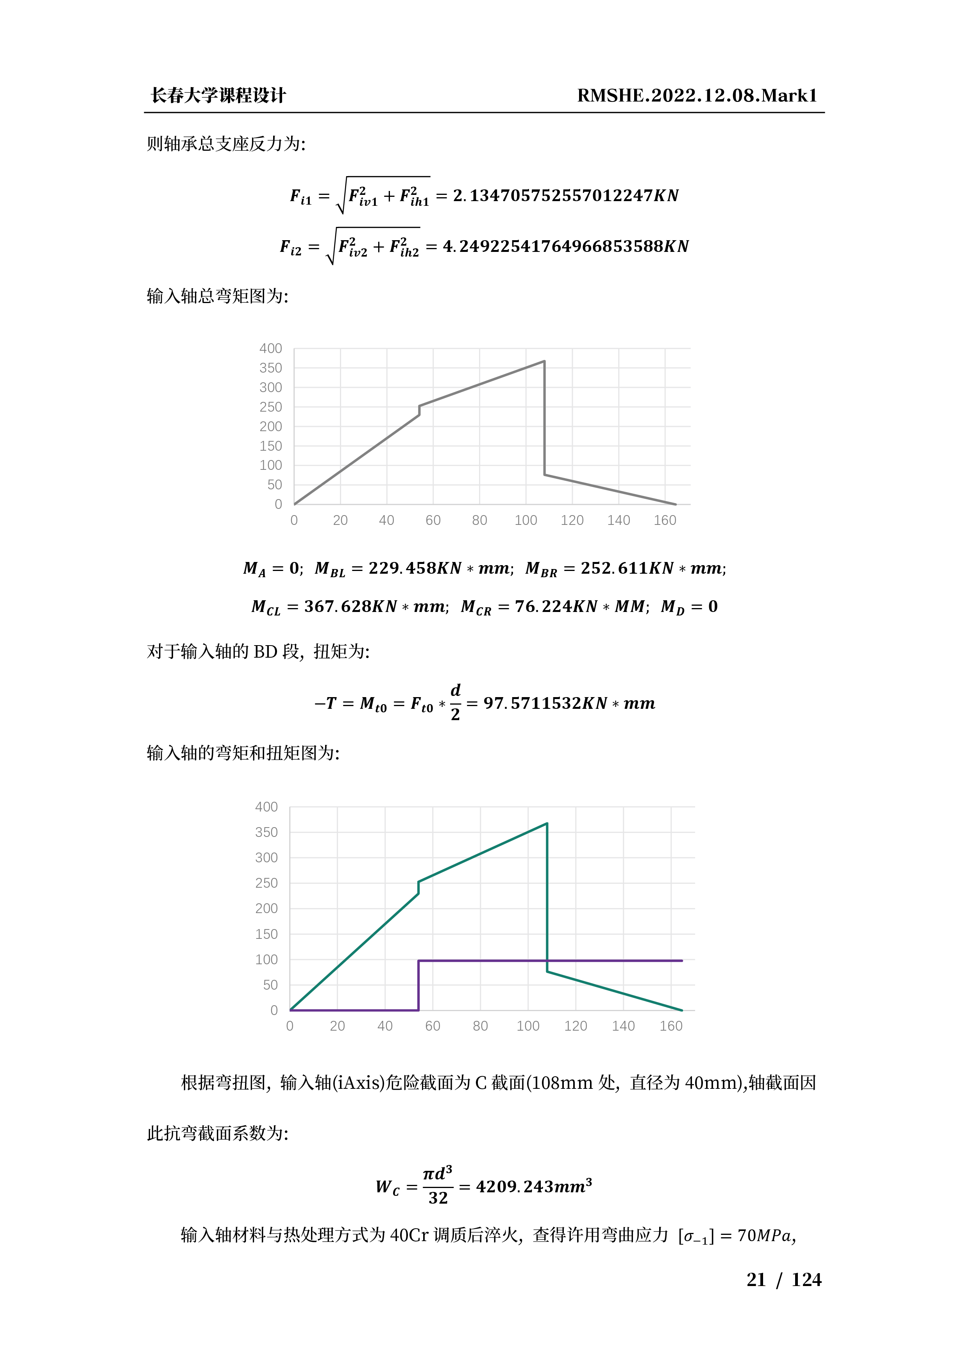
[picture p25: instruction/25.png]
instr

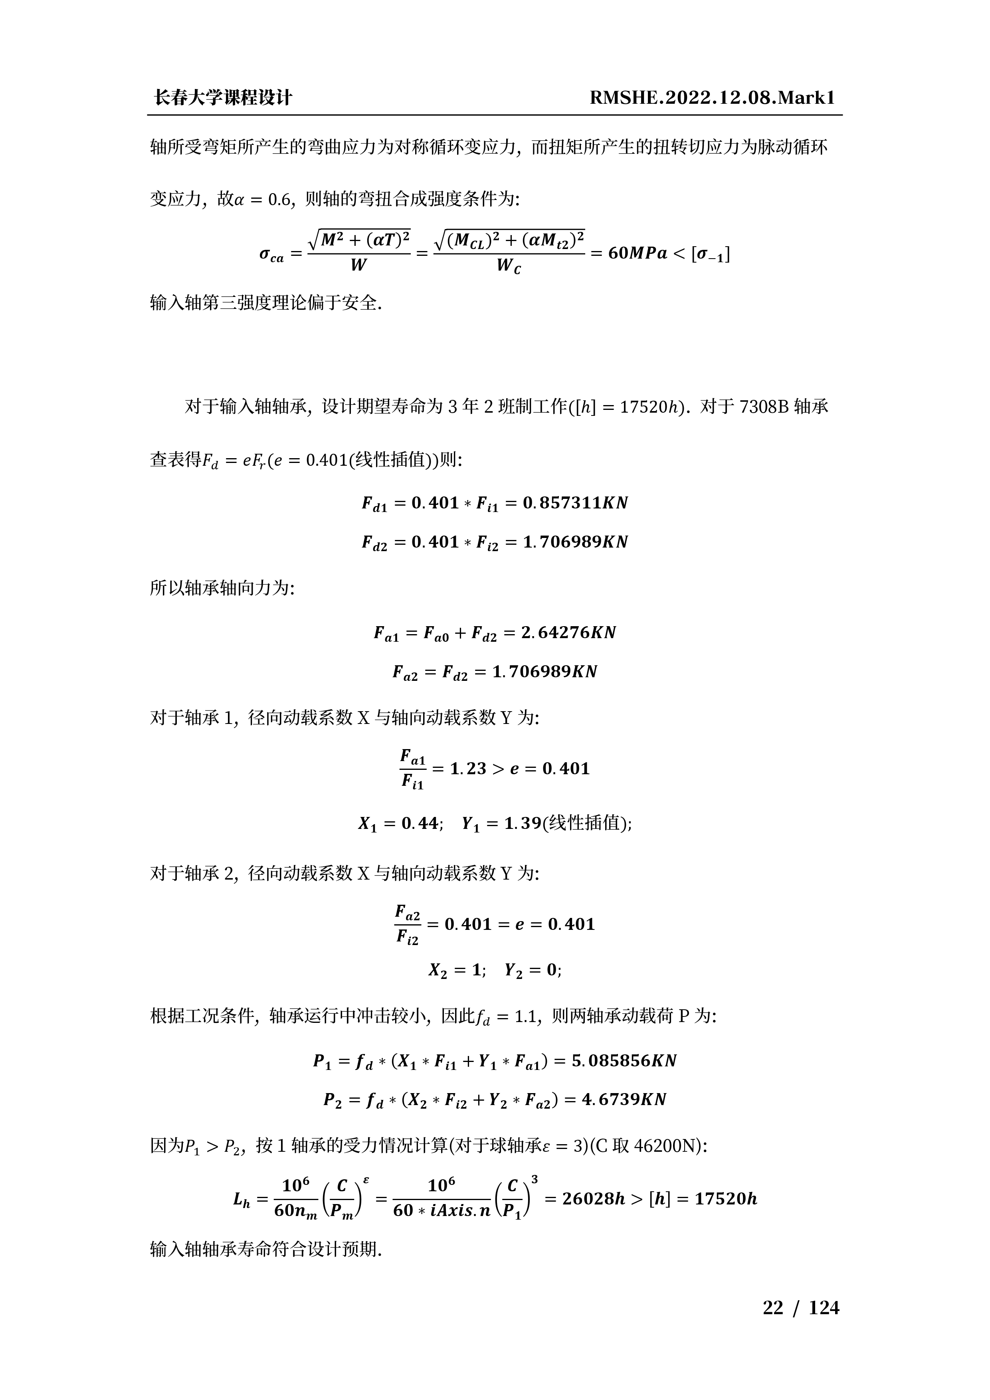
[picture p26: instruction/26.png]
instr

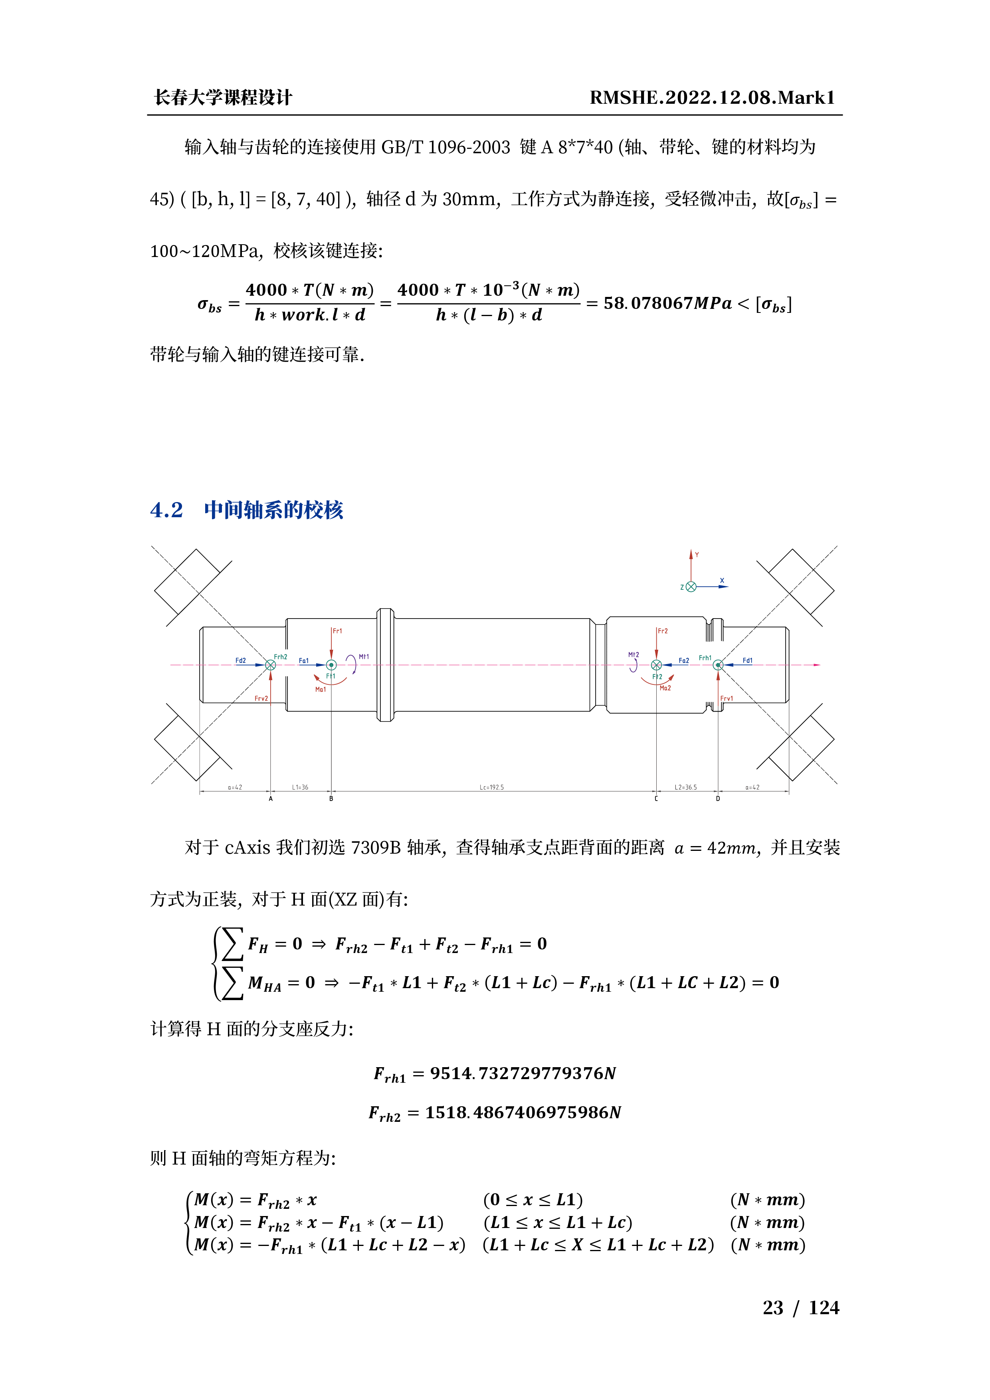
[picture p27: instruction/27.png]
instr

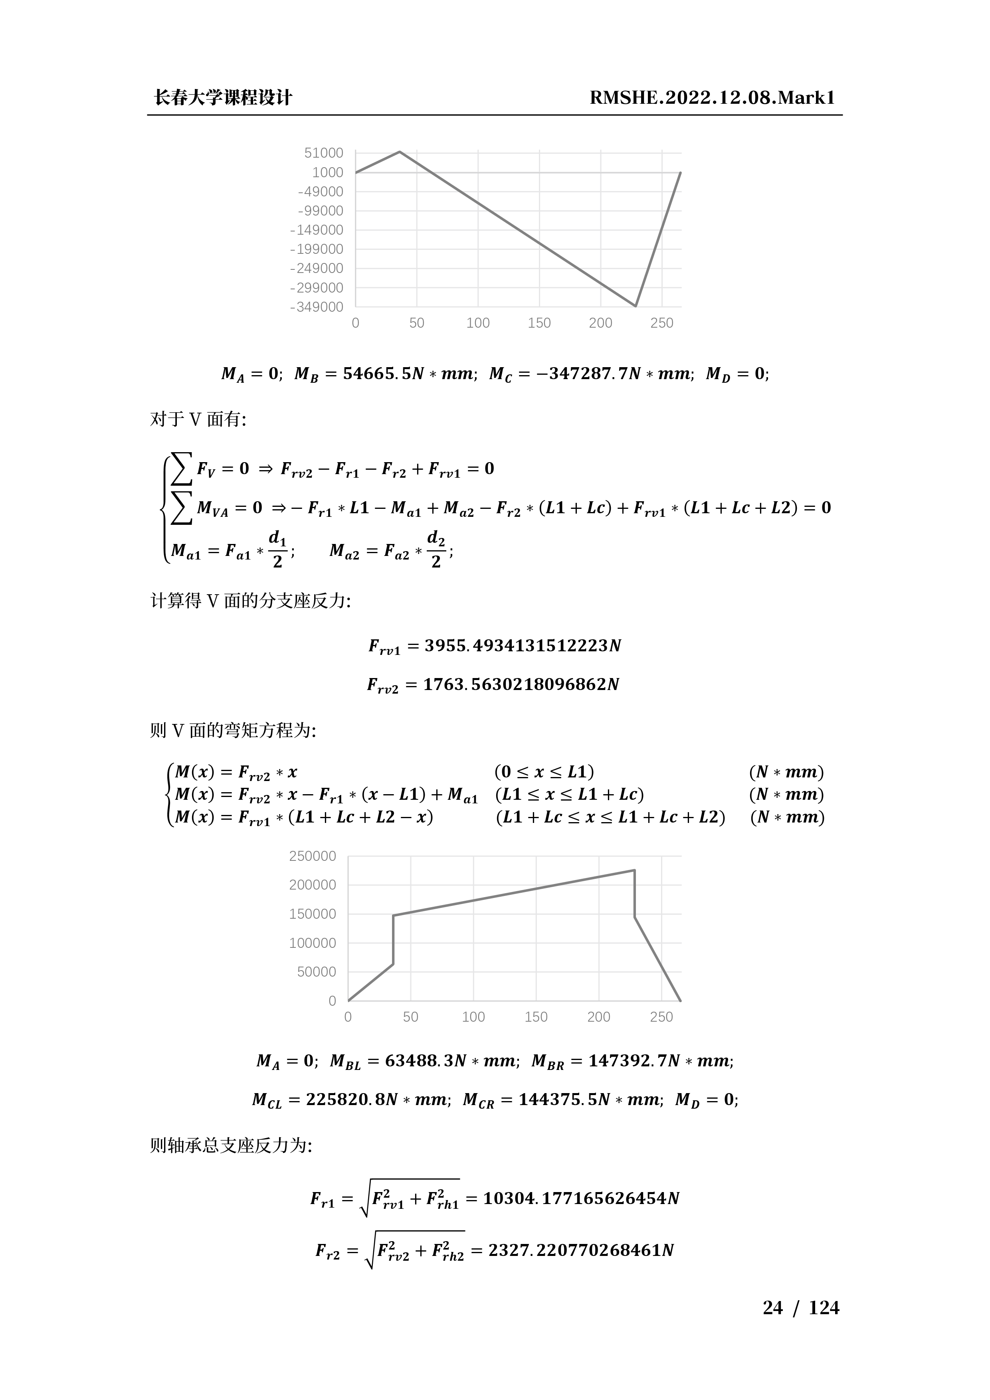
[picture p28: instruction/28.png]
instr

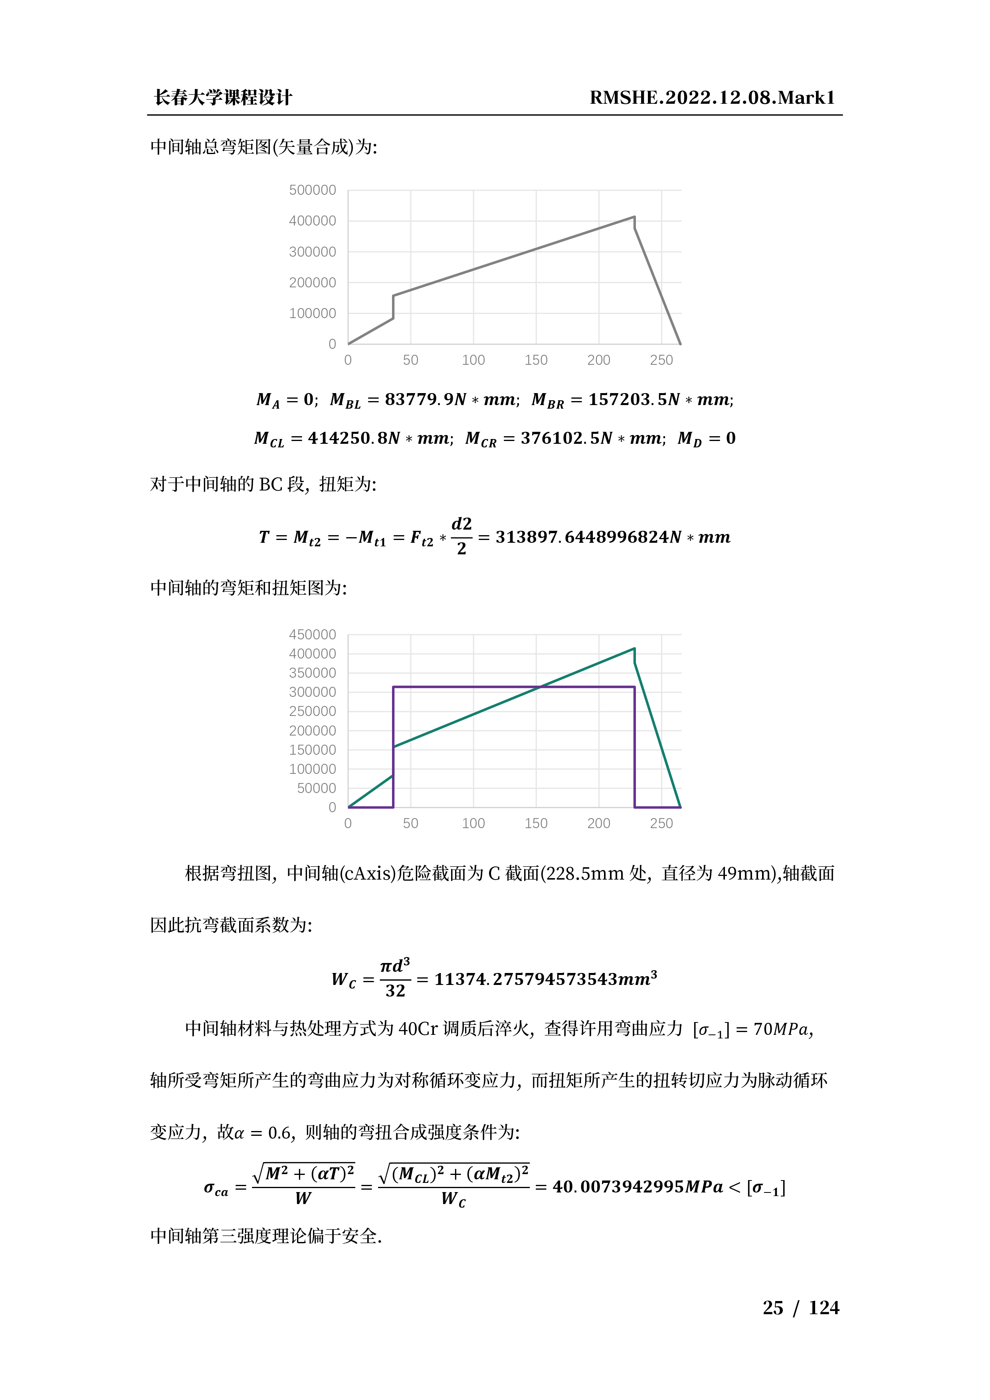
[picture p29: instruction/29.png]
instr

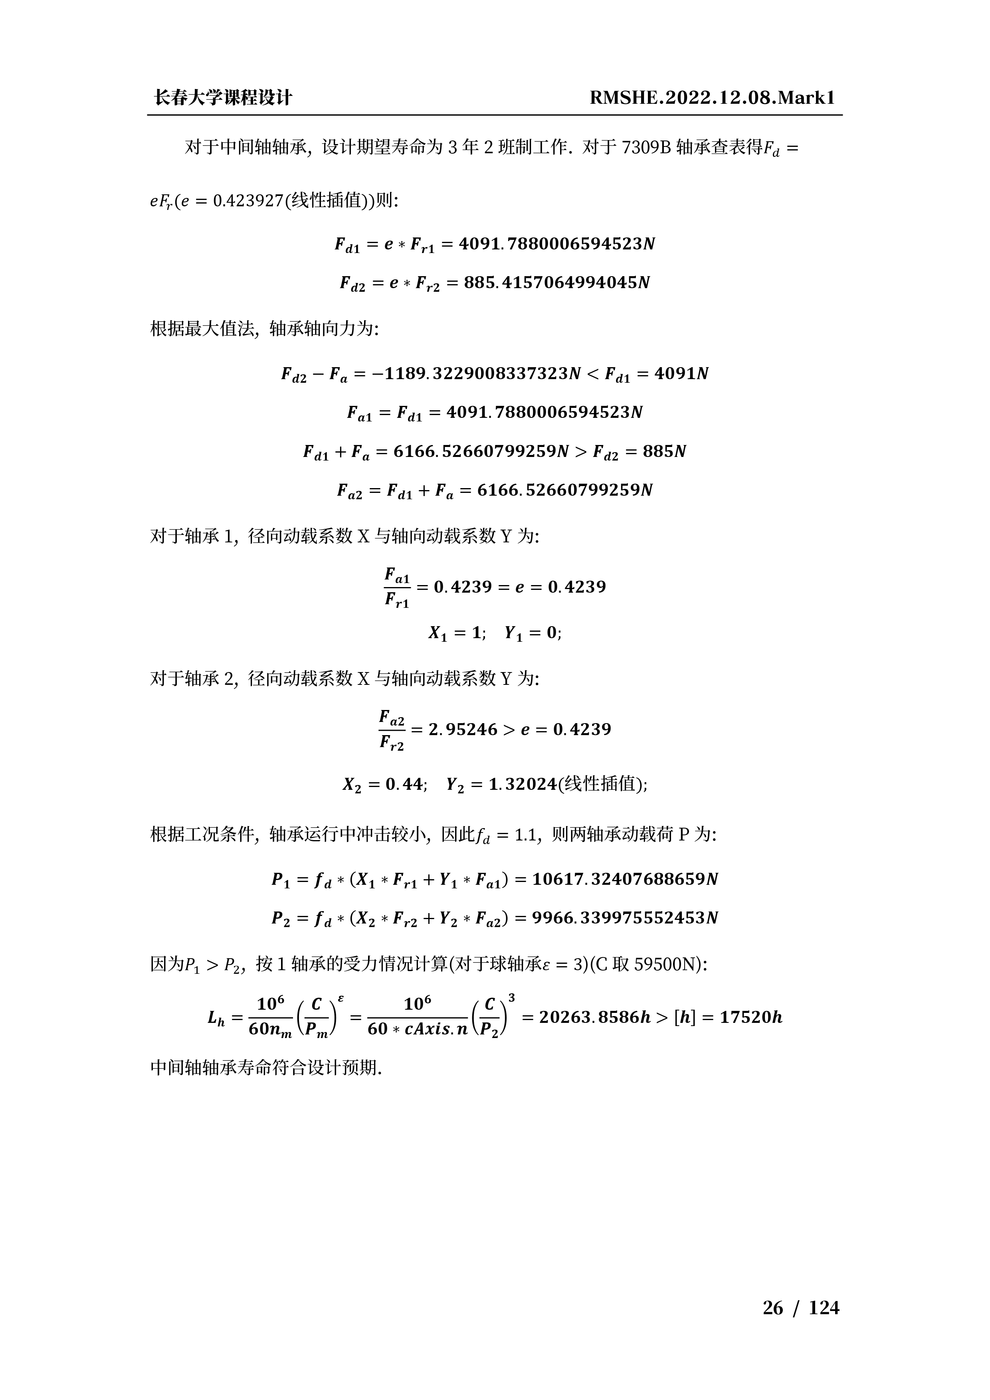
[picture p30: instruction/30.png]
instr

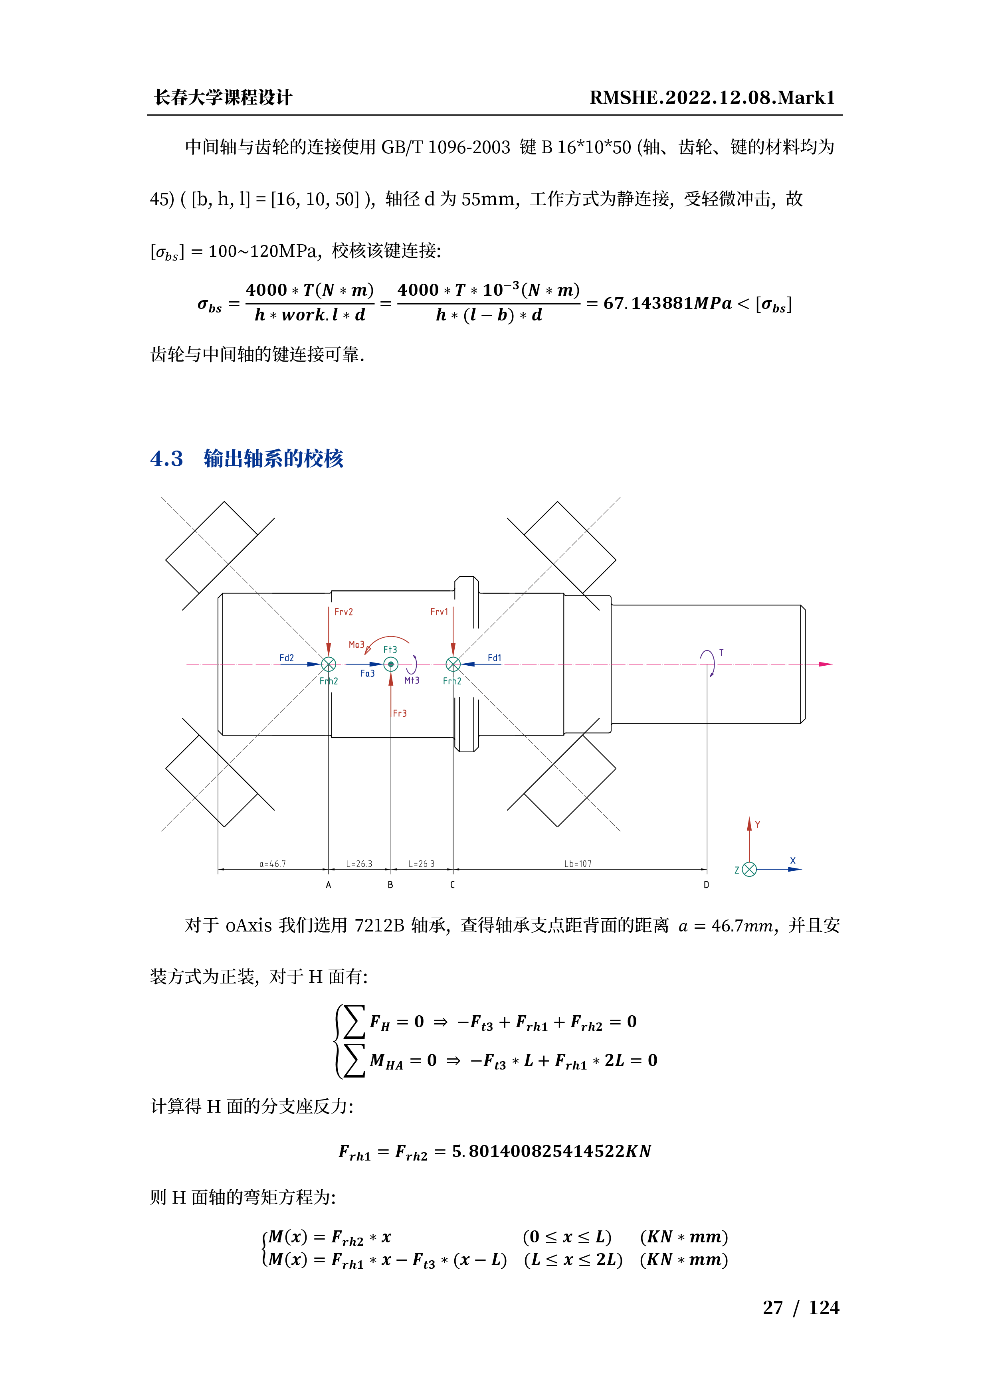
[picture p31: instruction/31.png]
instr

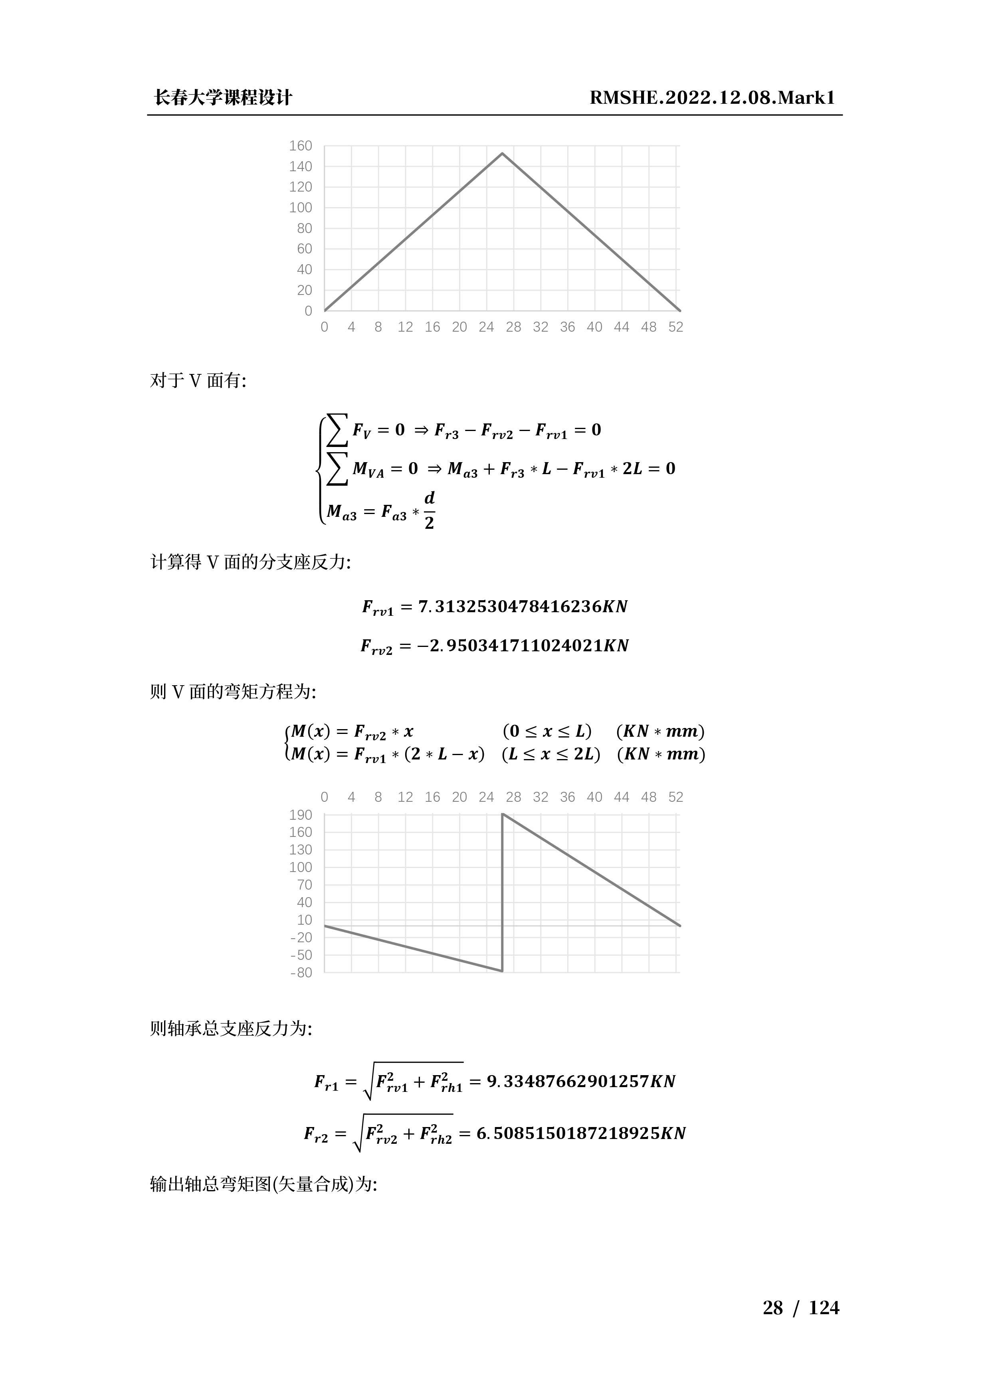
[picture p32: instruction/32.png]
instr

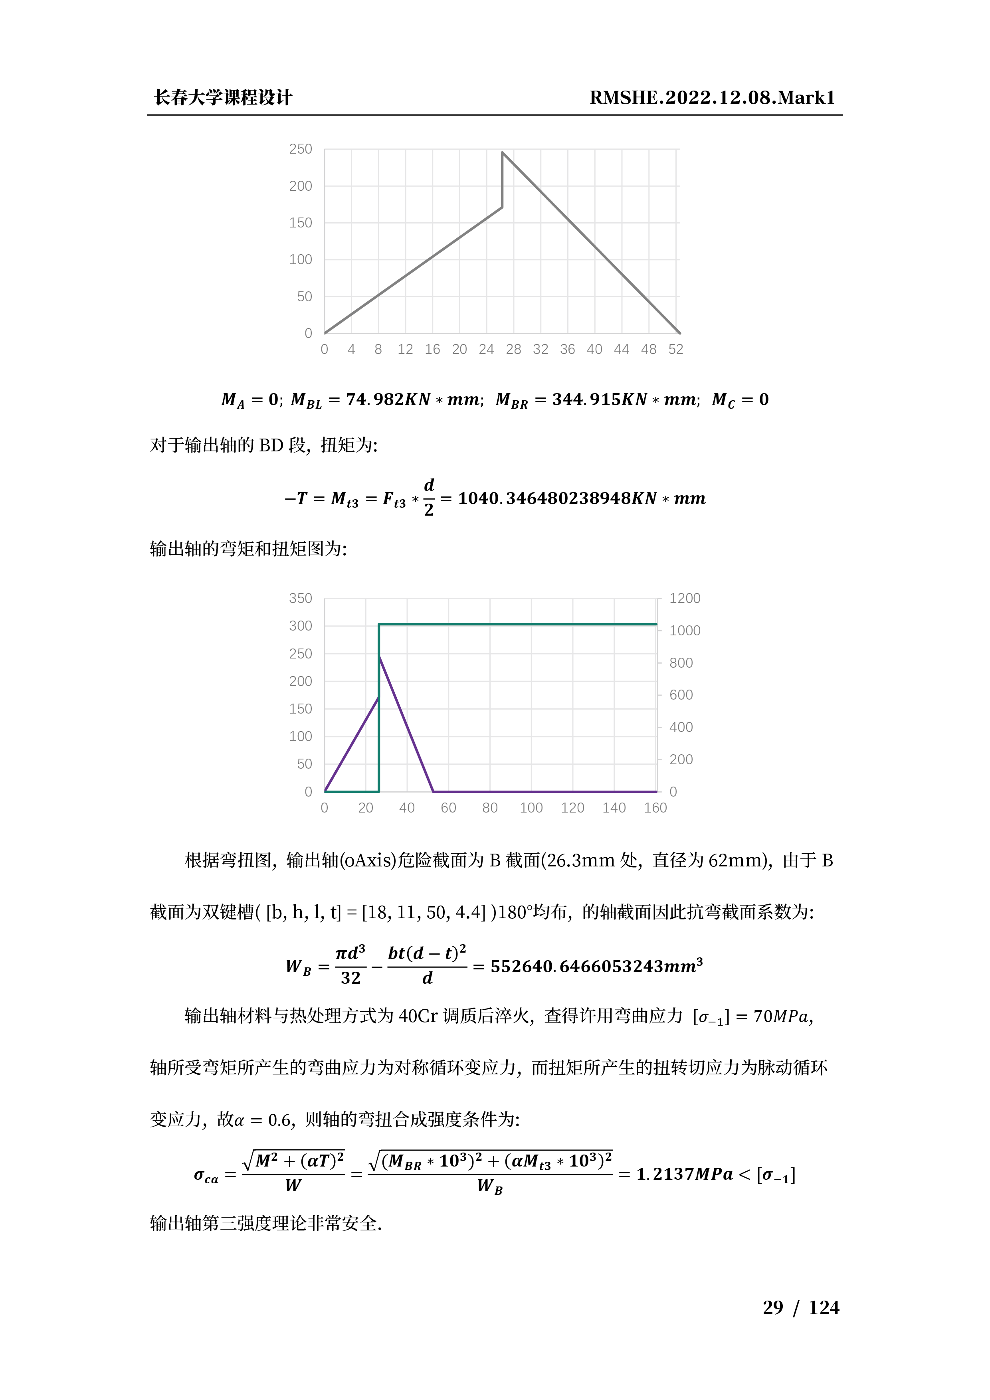
[picture p33: instruction/33.png]
instr

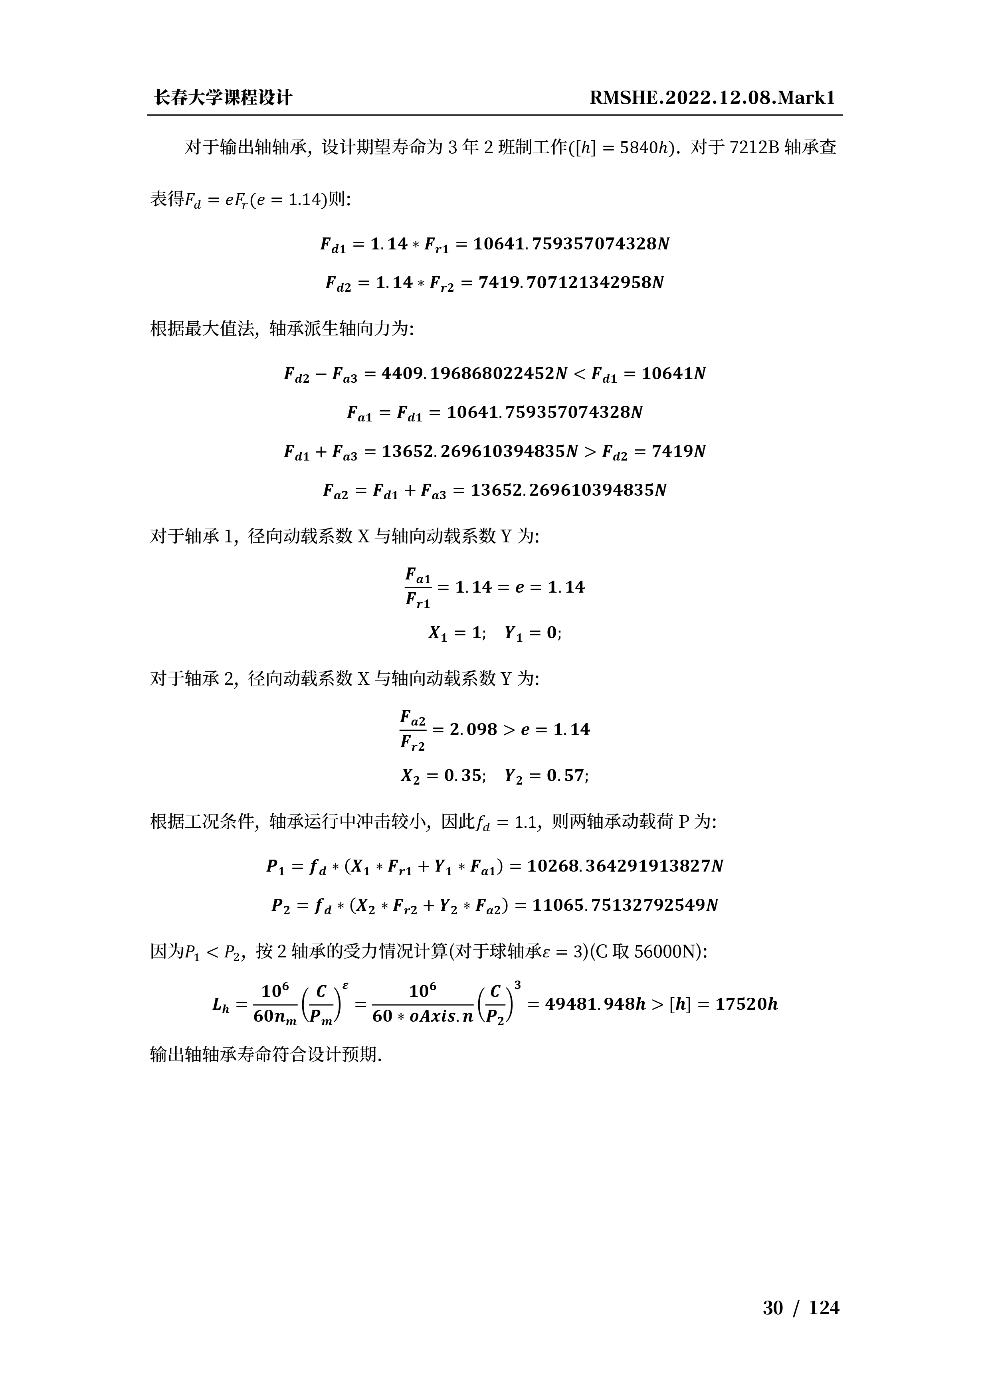
[picture p34: instruction/34.png]
instr

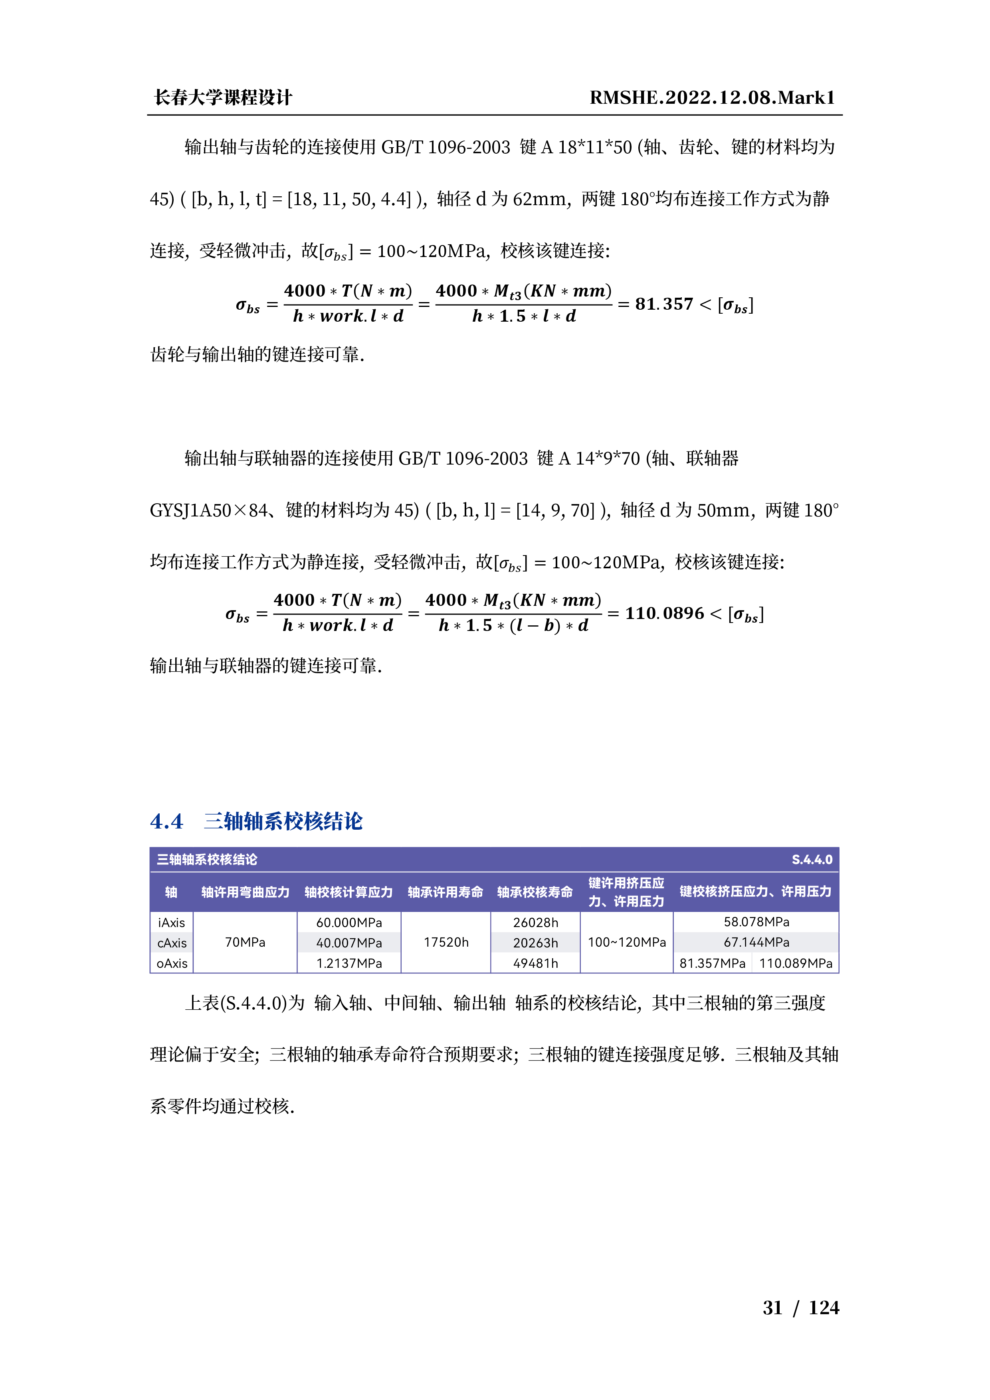
[picture p35: instruction/35.png]
instr

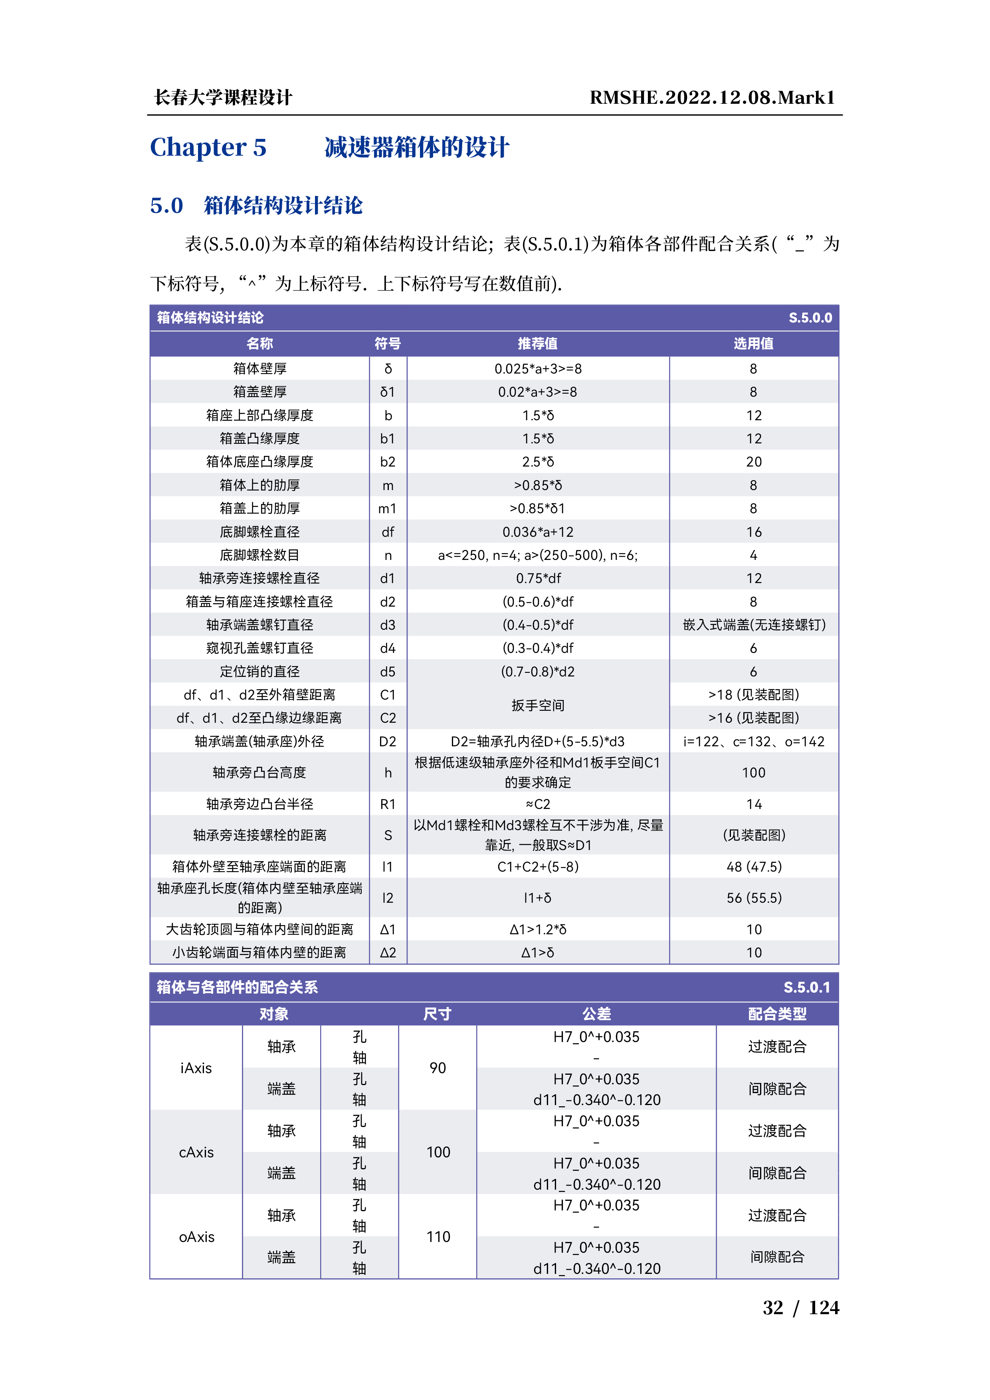
[picture p36: instruction/36.png]
instr

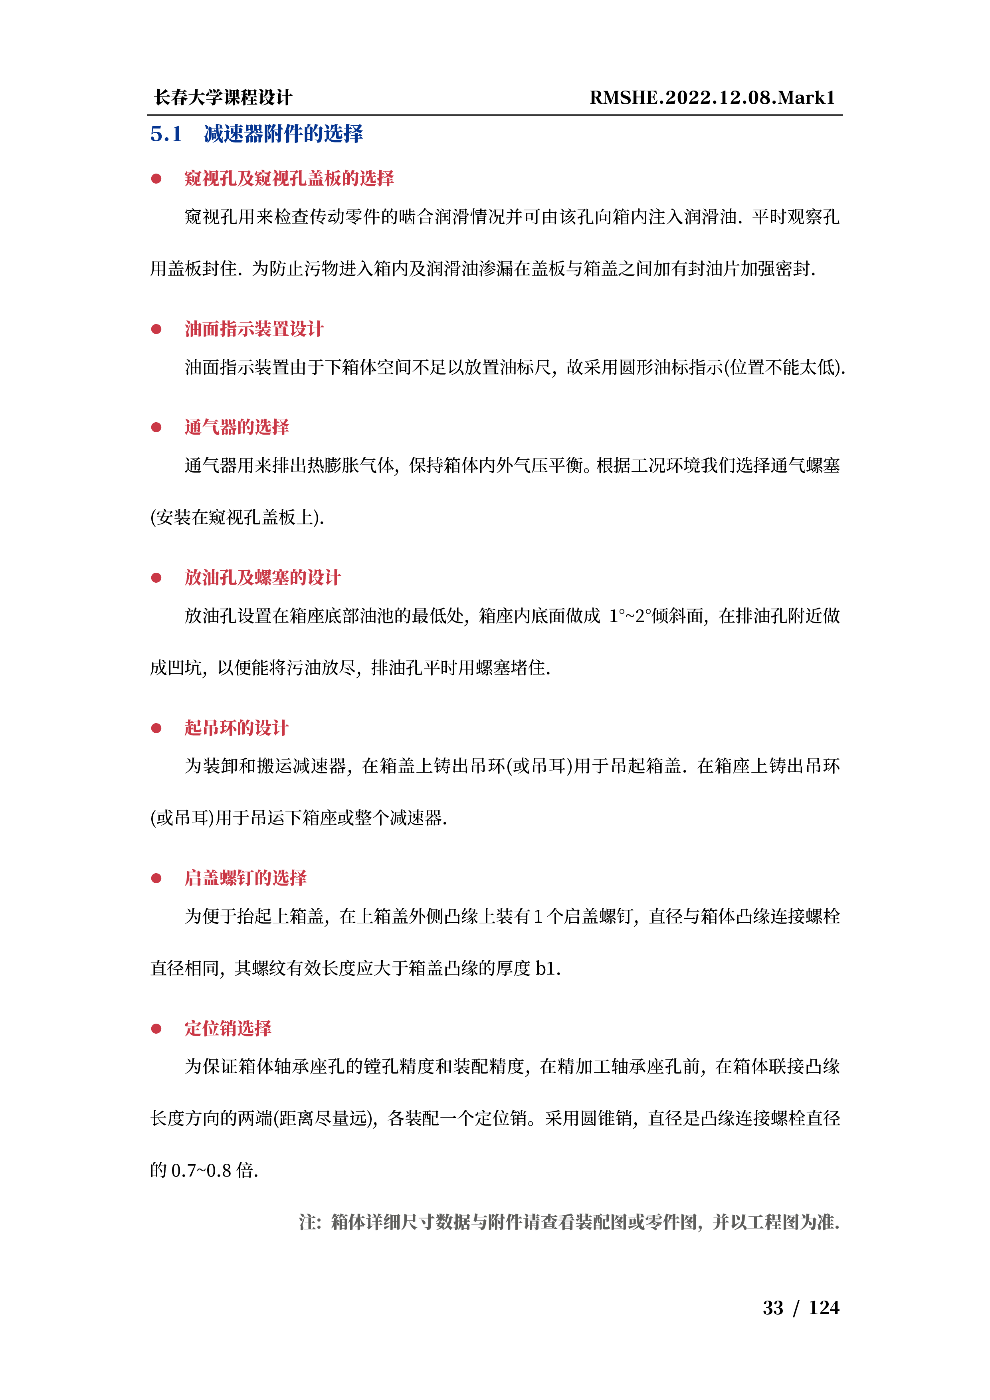
[picture p37: instruction/37.png]
instr

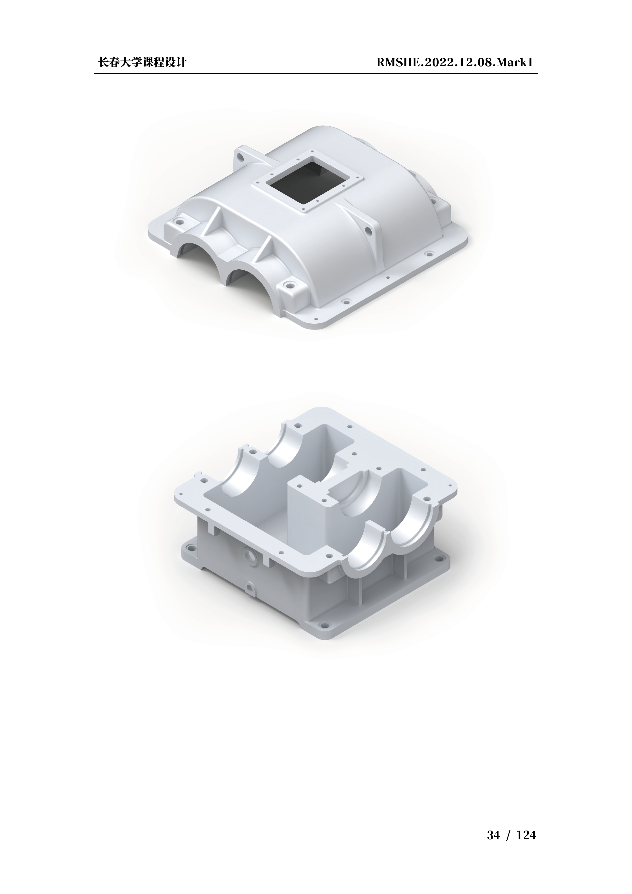
[picture p38: instruction/38.png]
instr

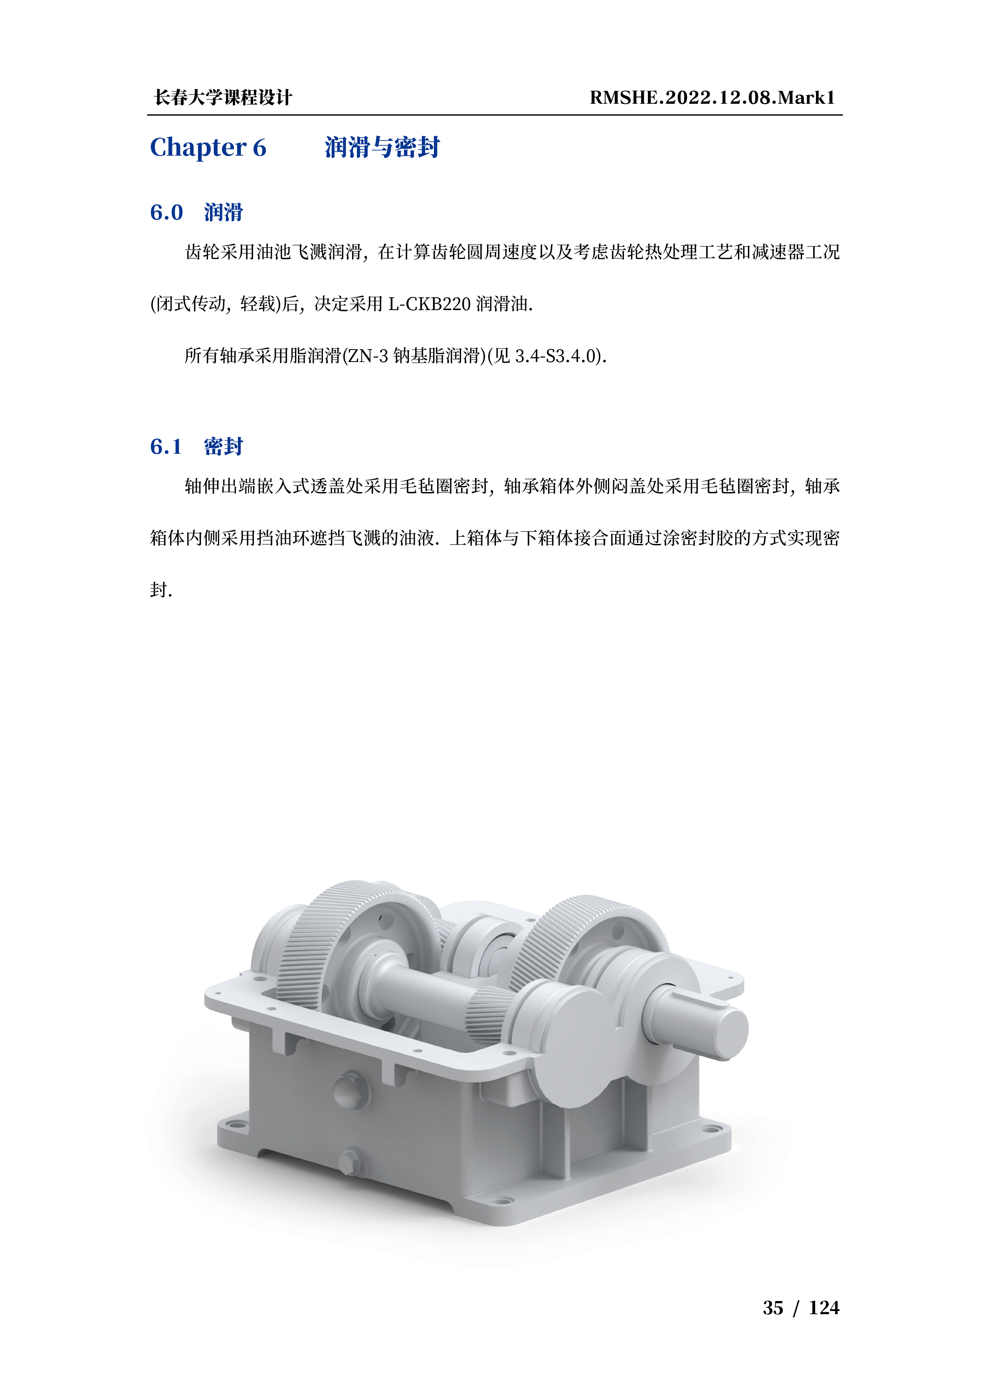
[picture p39: instruction/39.png]
instr

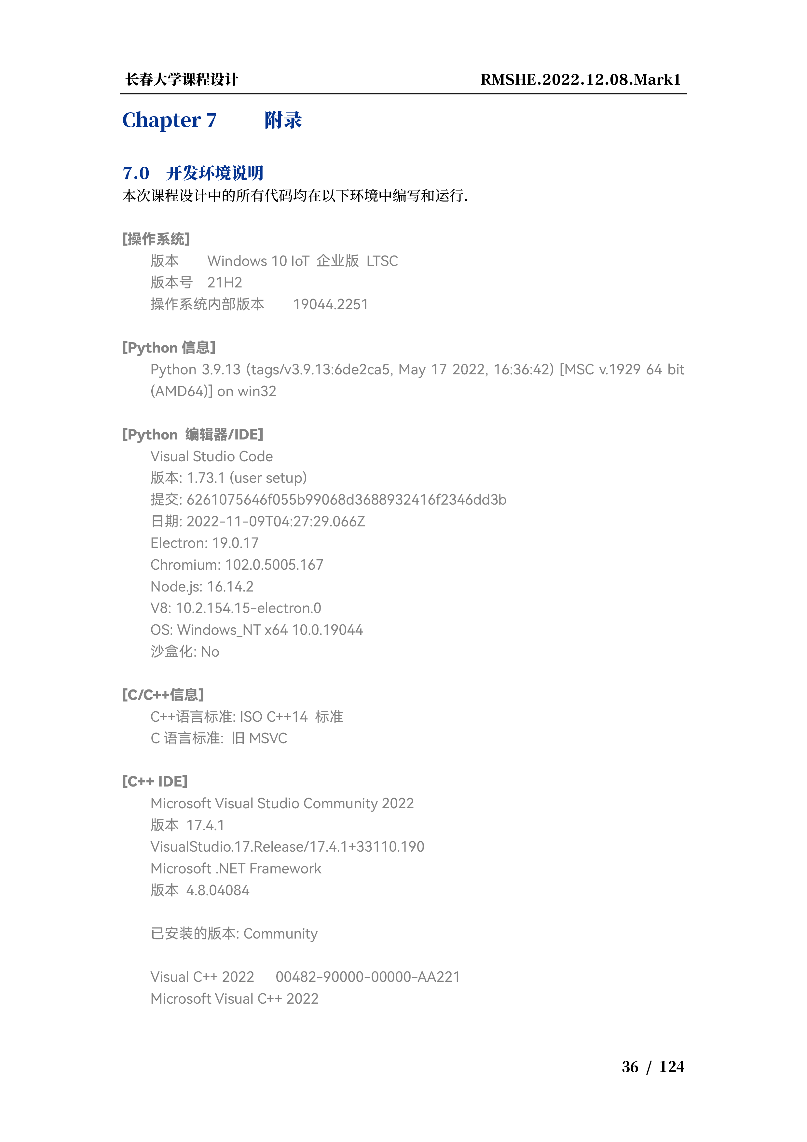
[picture p40: instruction/40.png]
instr

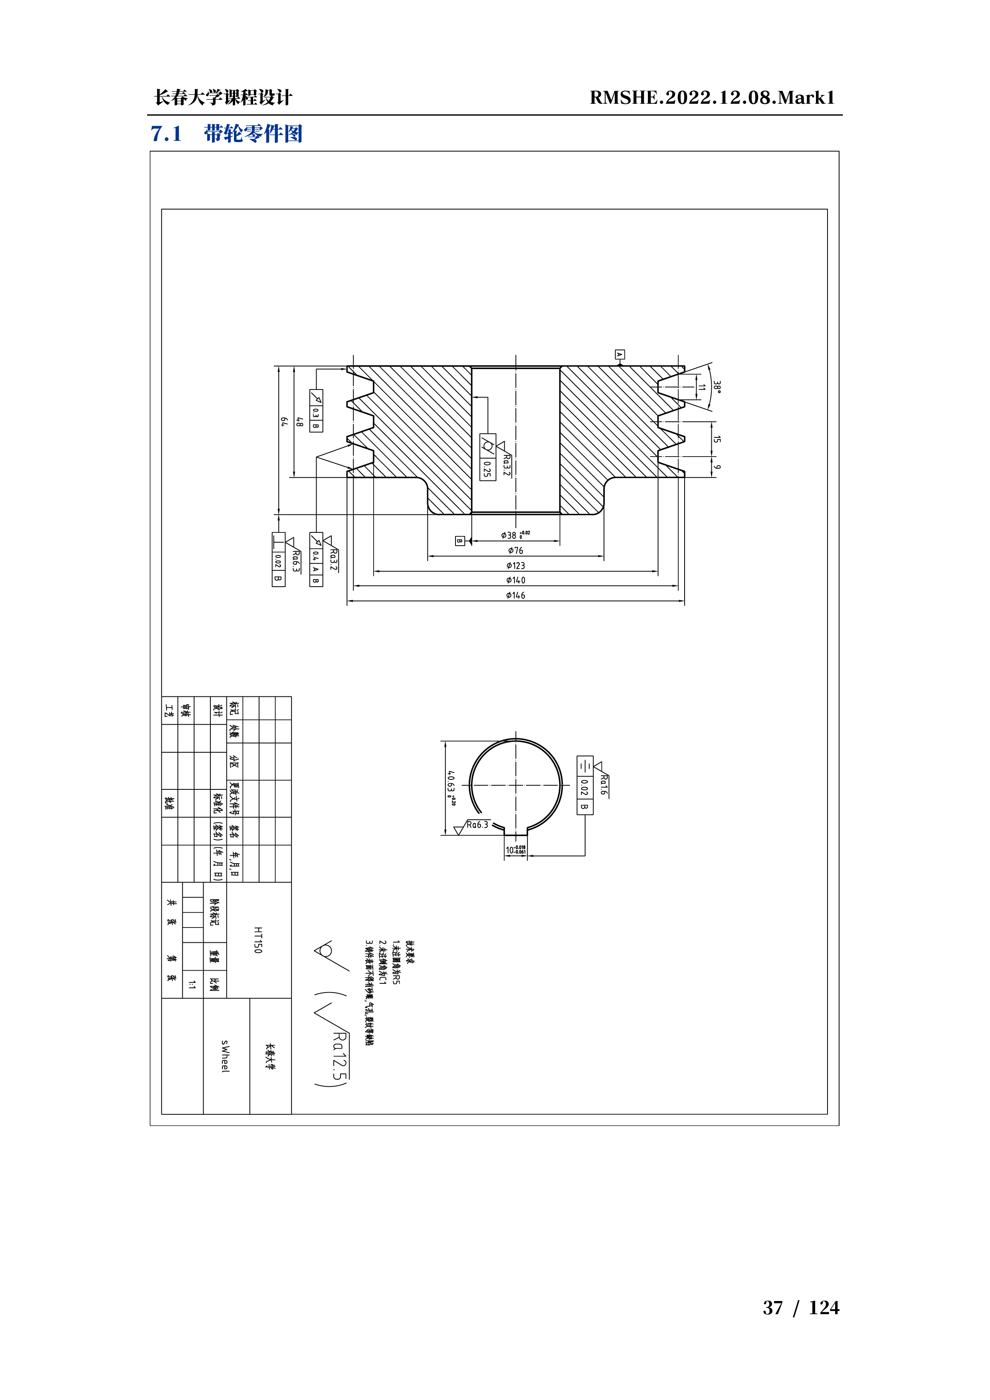
[picture p41: instruction/41.png]
instr

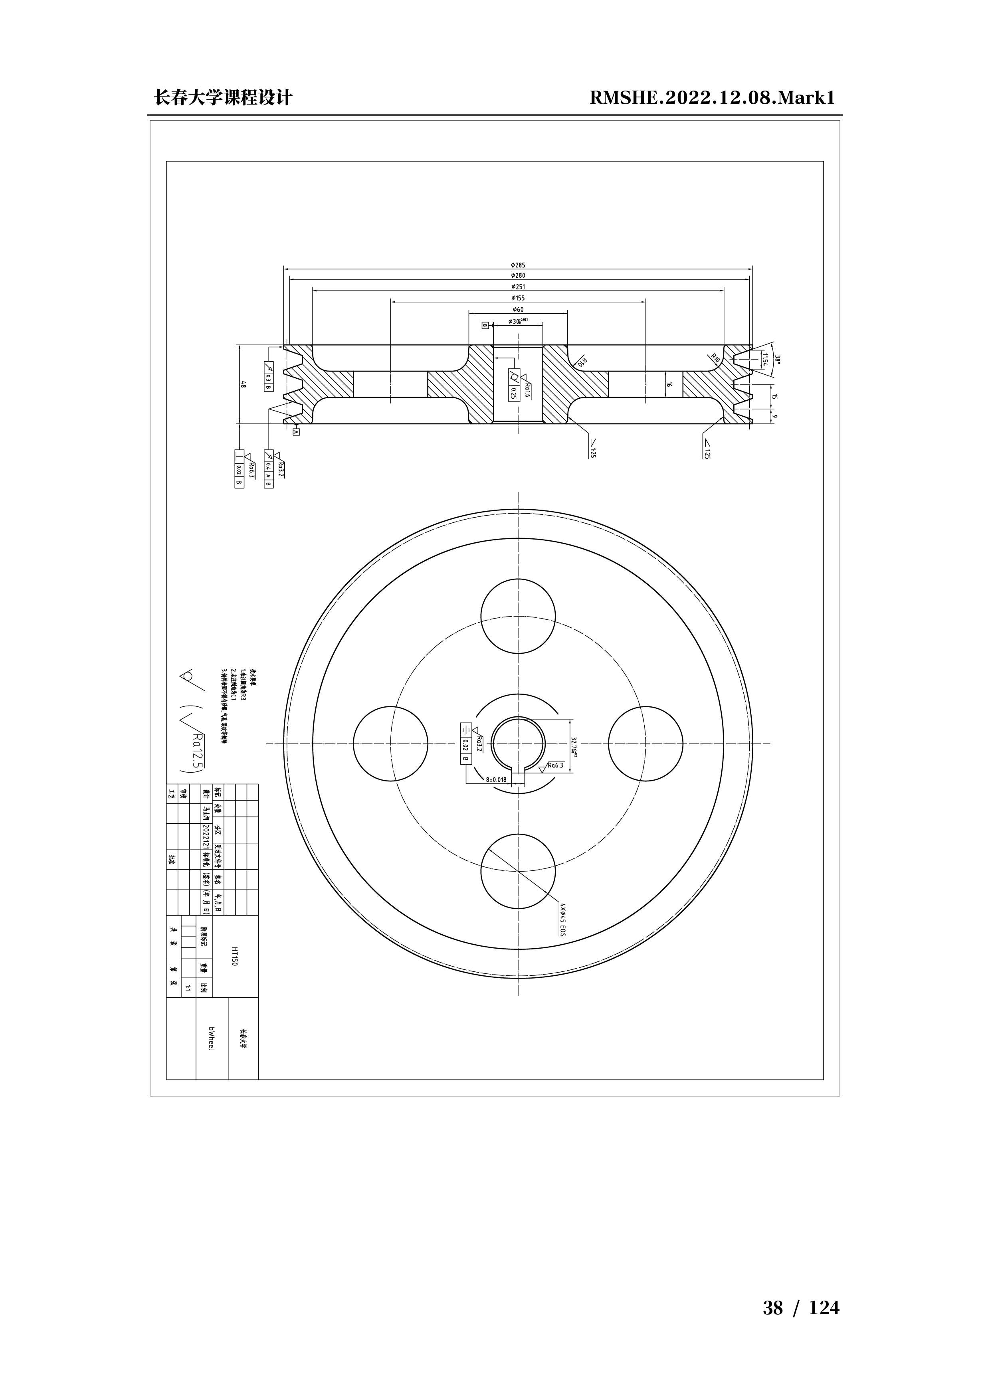
[picture p42: instruction/42.png]
instr

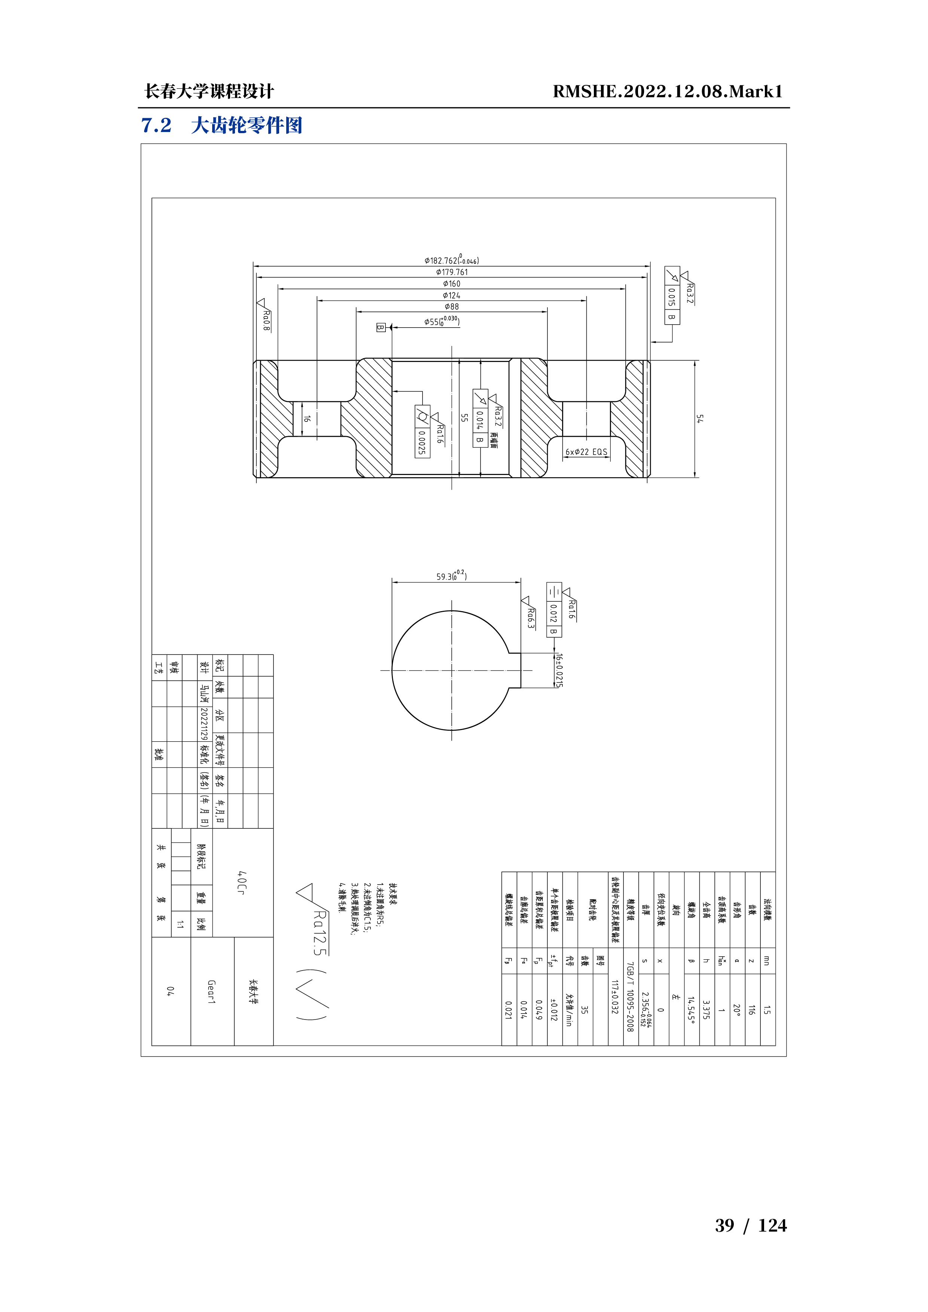
[picture p43: instruction/43.png]
instr

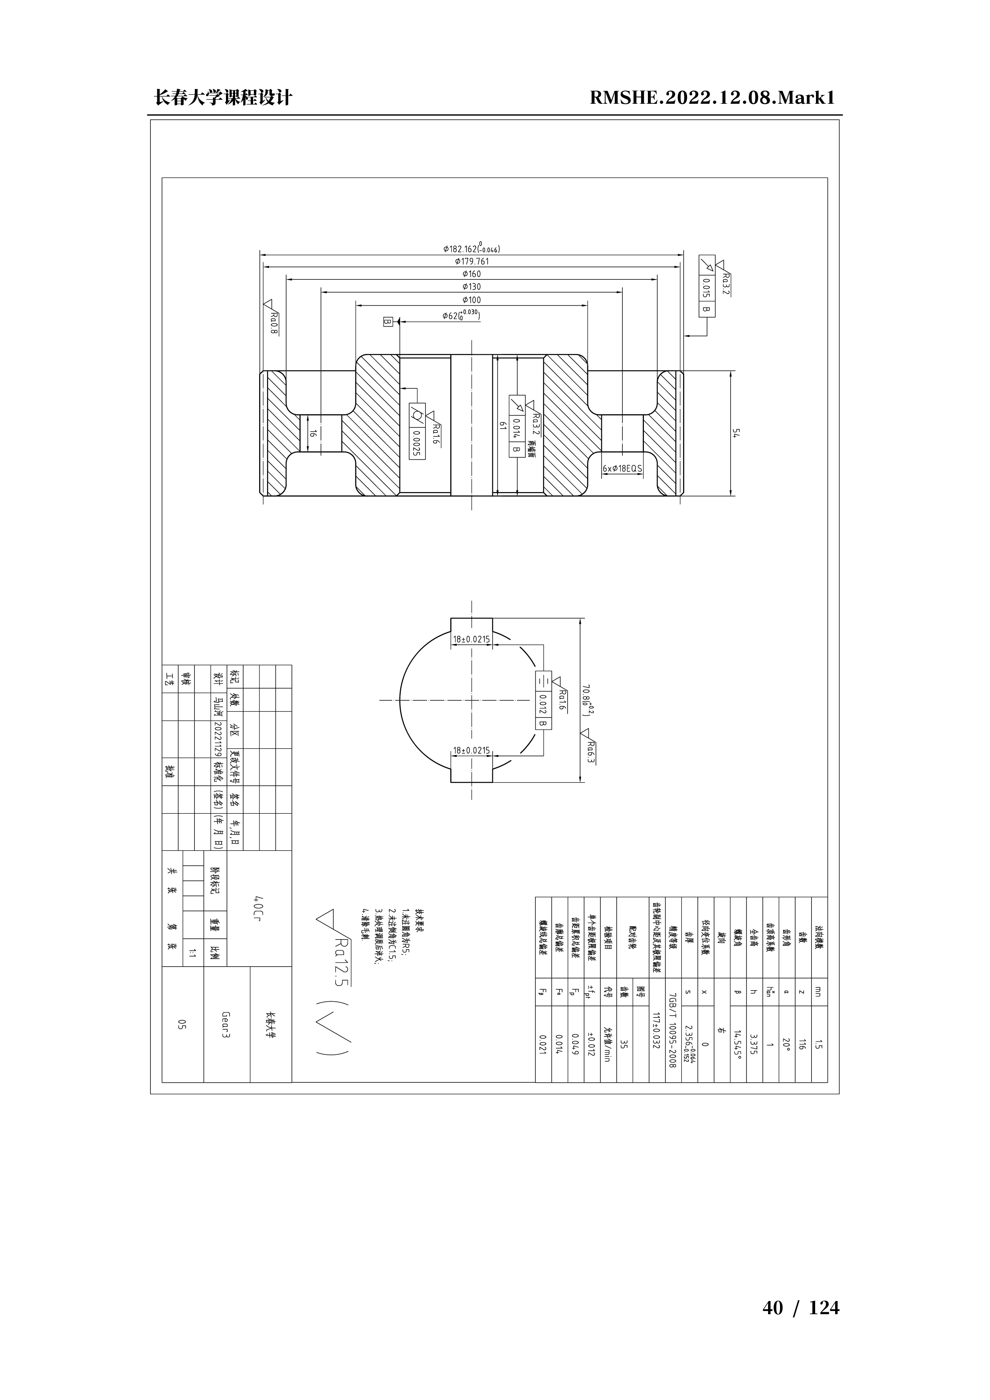
[picture p44: instruction/44.png]
instr

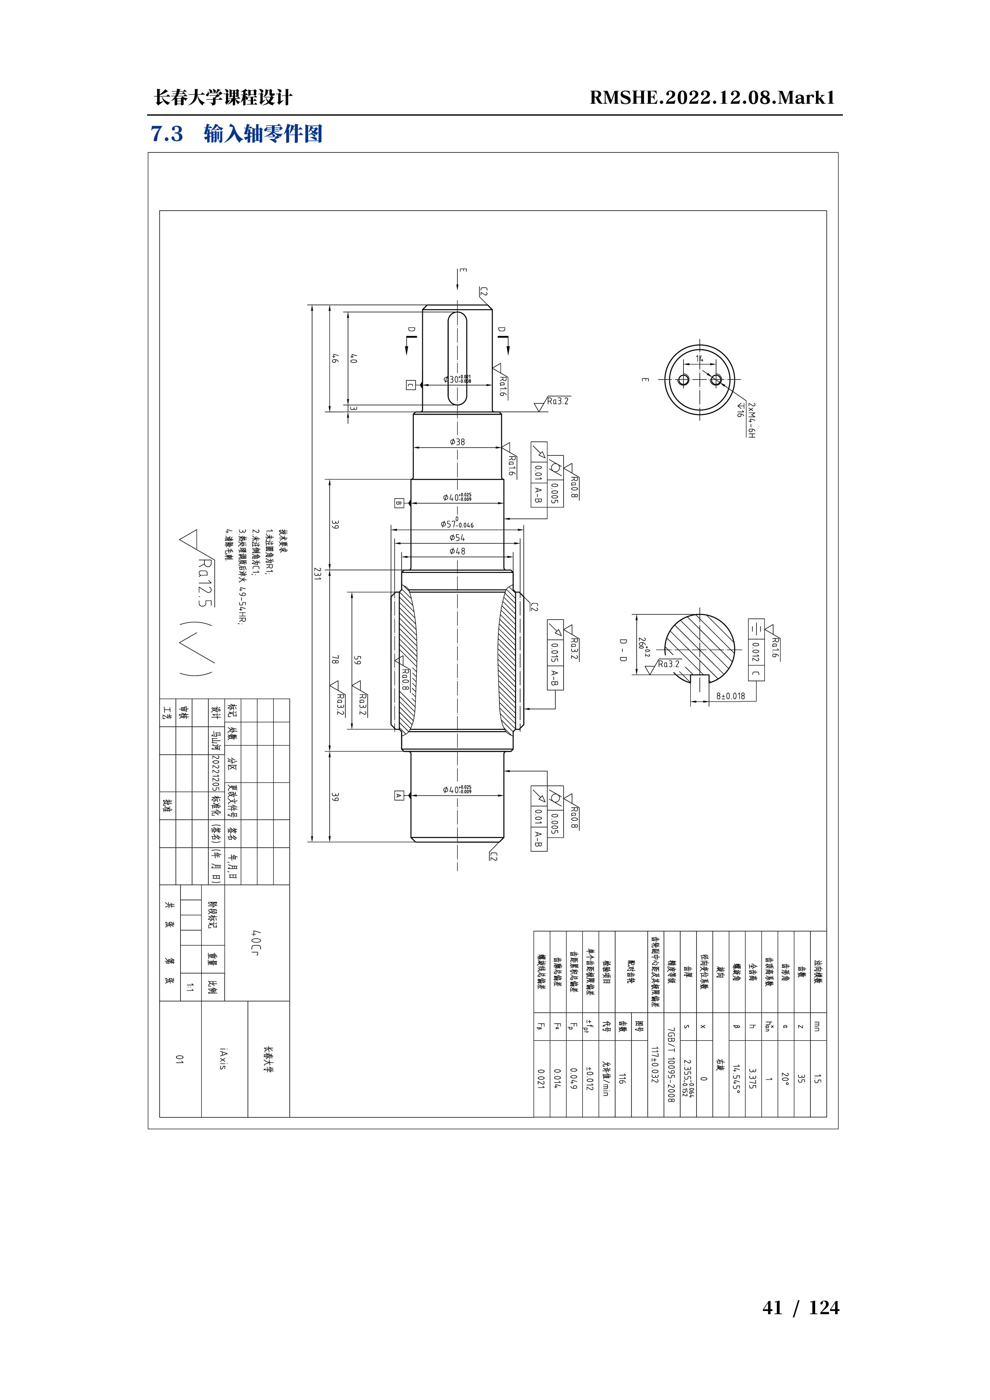
[picture p45: instruction/45.png]
instr

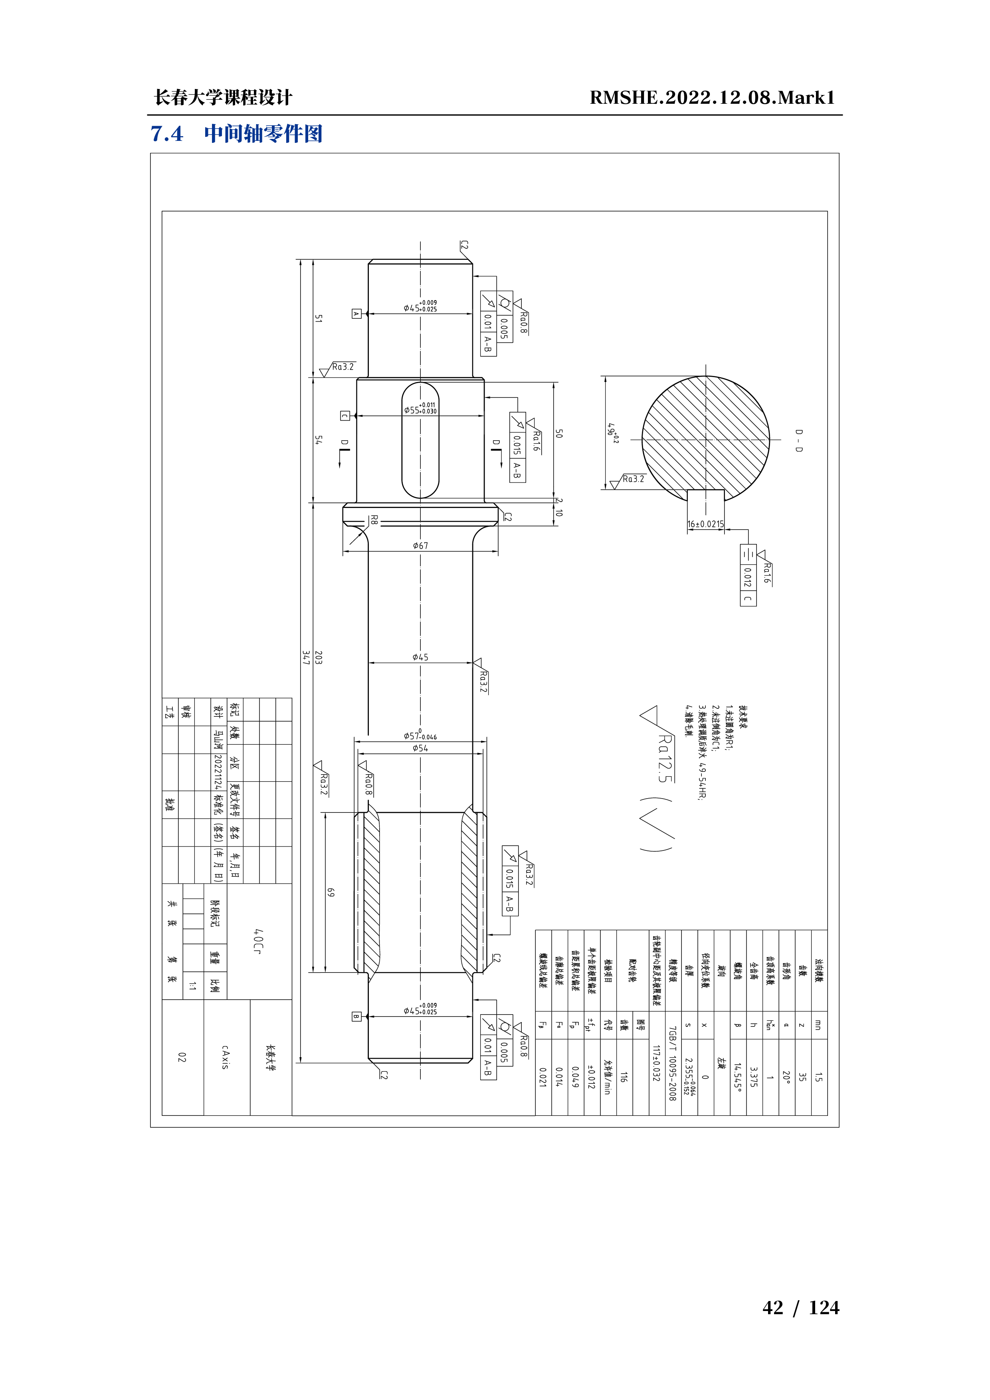
[picture p46: instruction/46.png]
instr

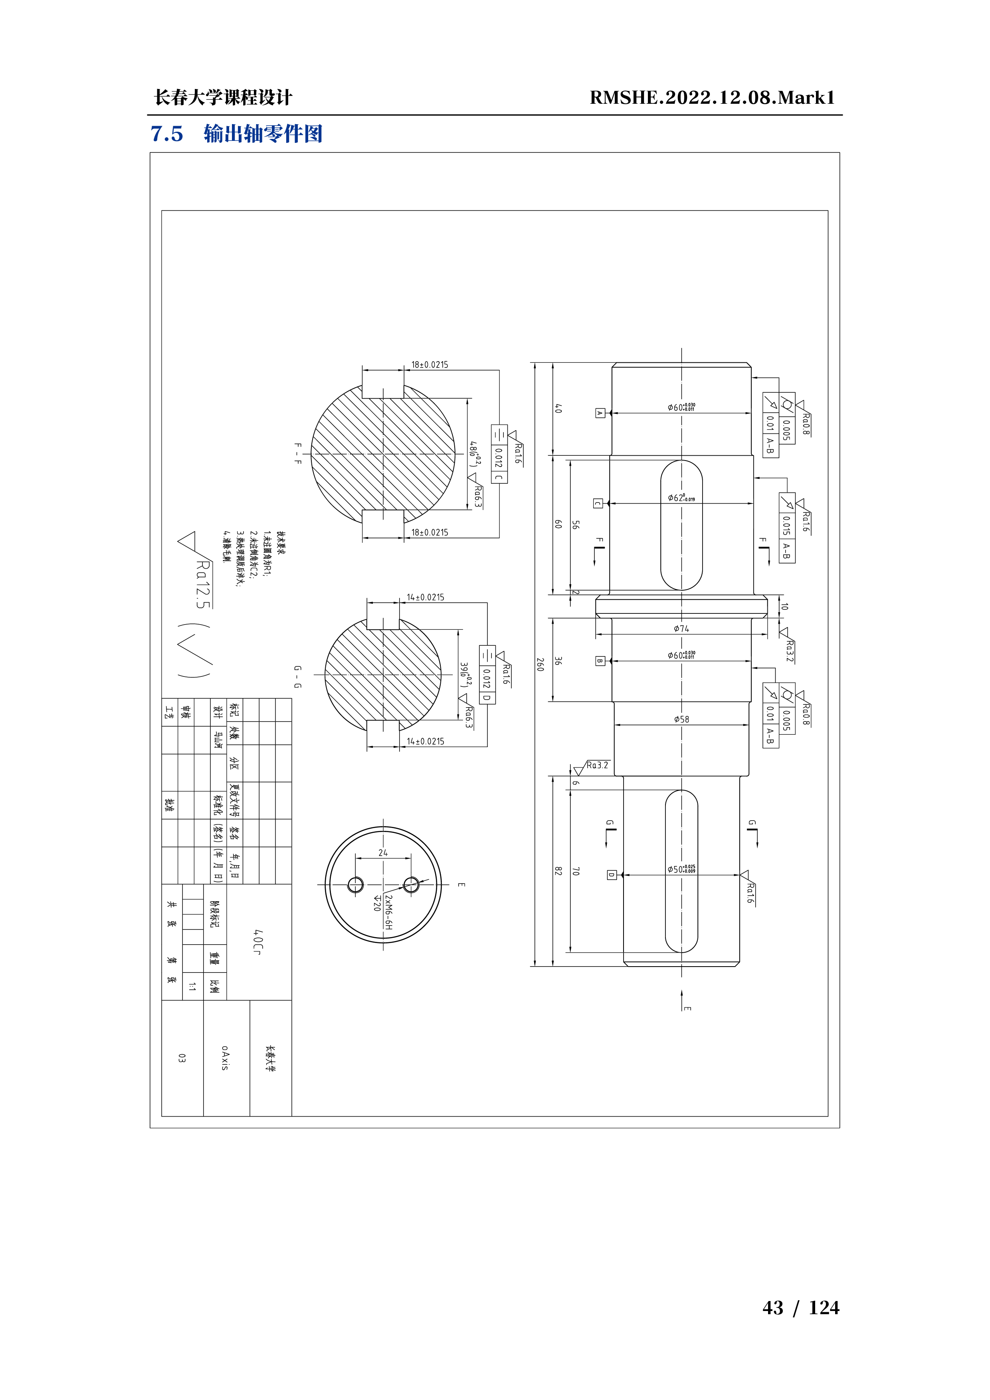
[picture p47: instruction/47.png]
instr

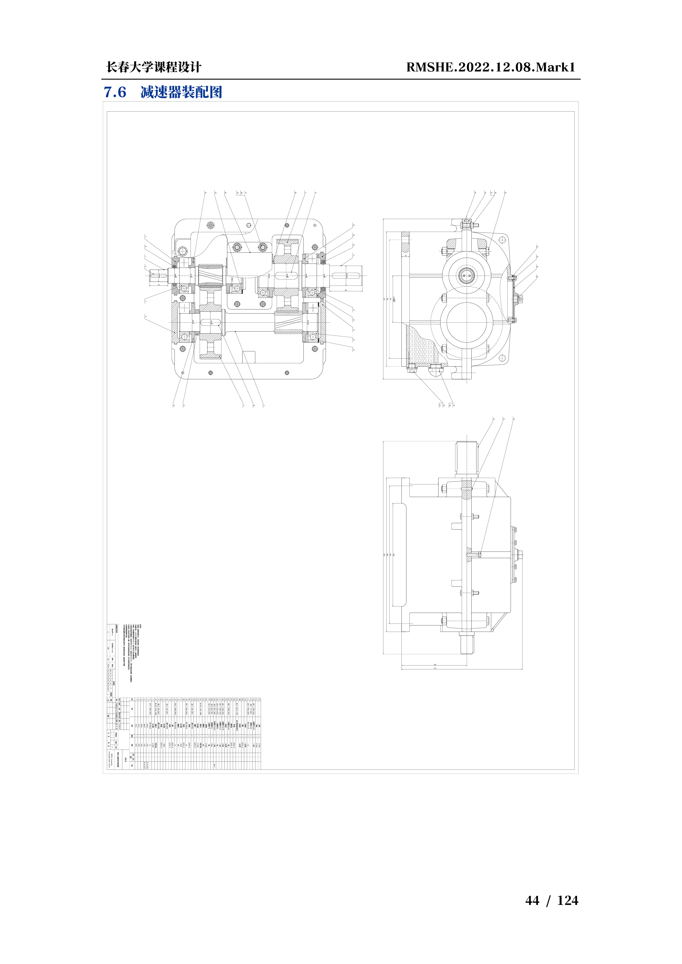
[picture p48: instruction/48.png]
instr

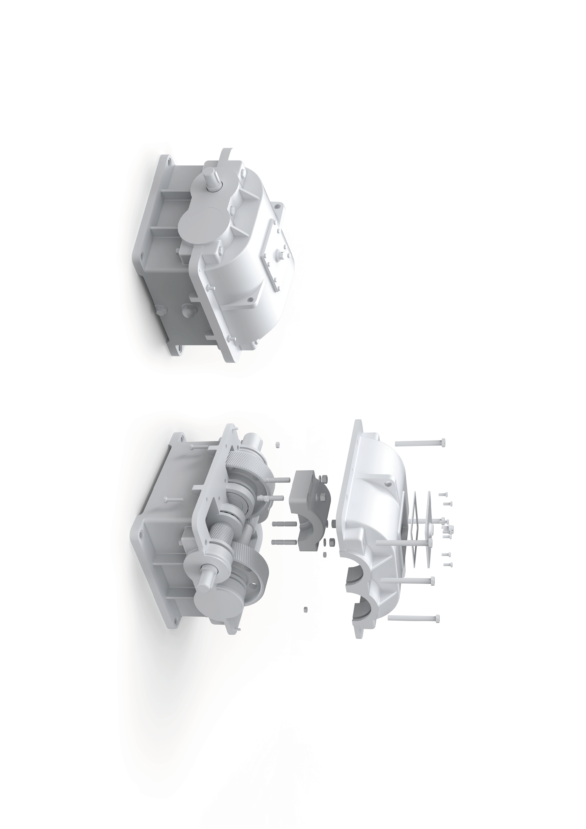
[picture p49: instruction/49.png]
instr

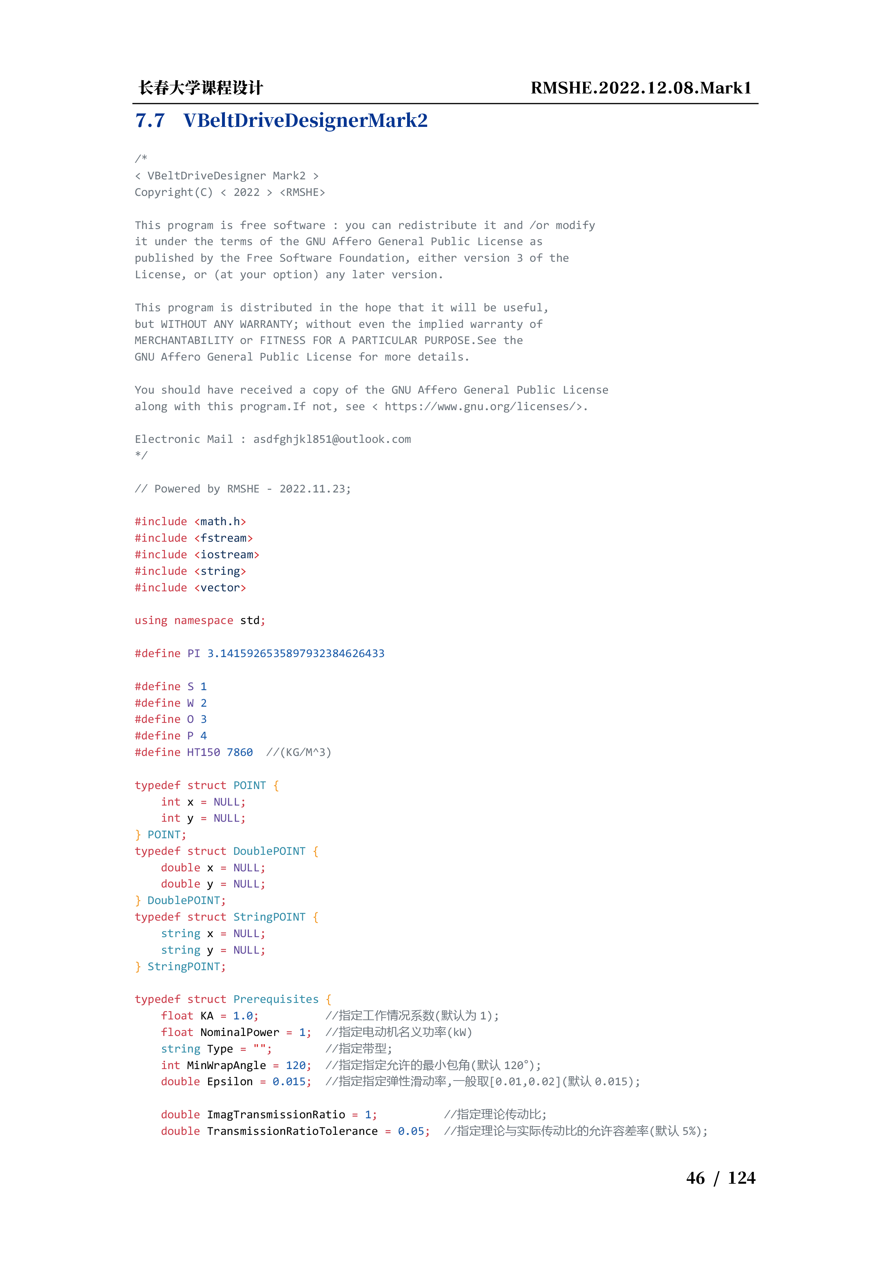
[picture p50: instruction/50.png]
instr

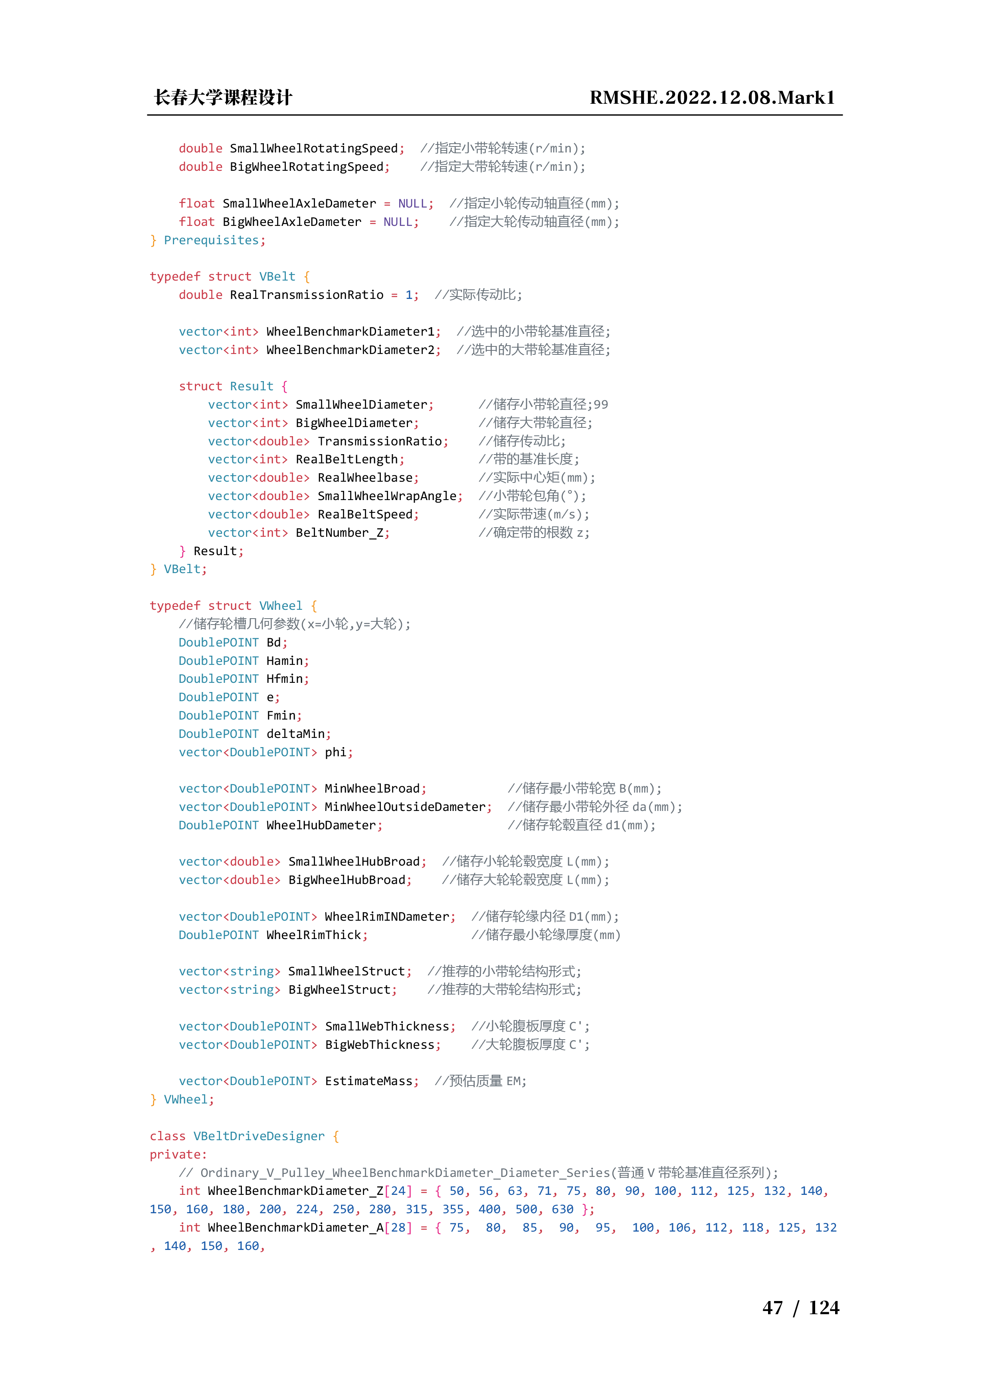
[picture p51: instruction/51.png]
instr

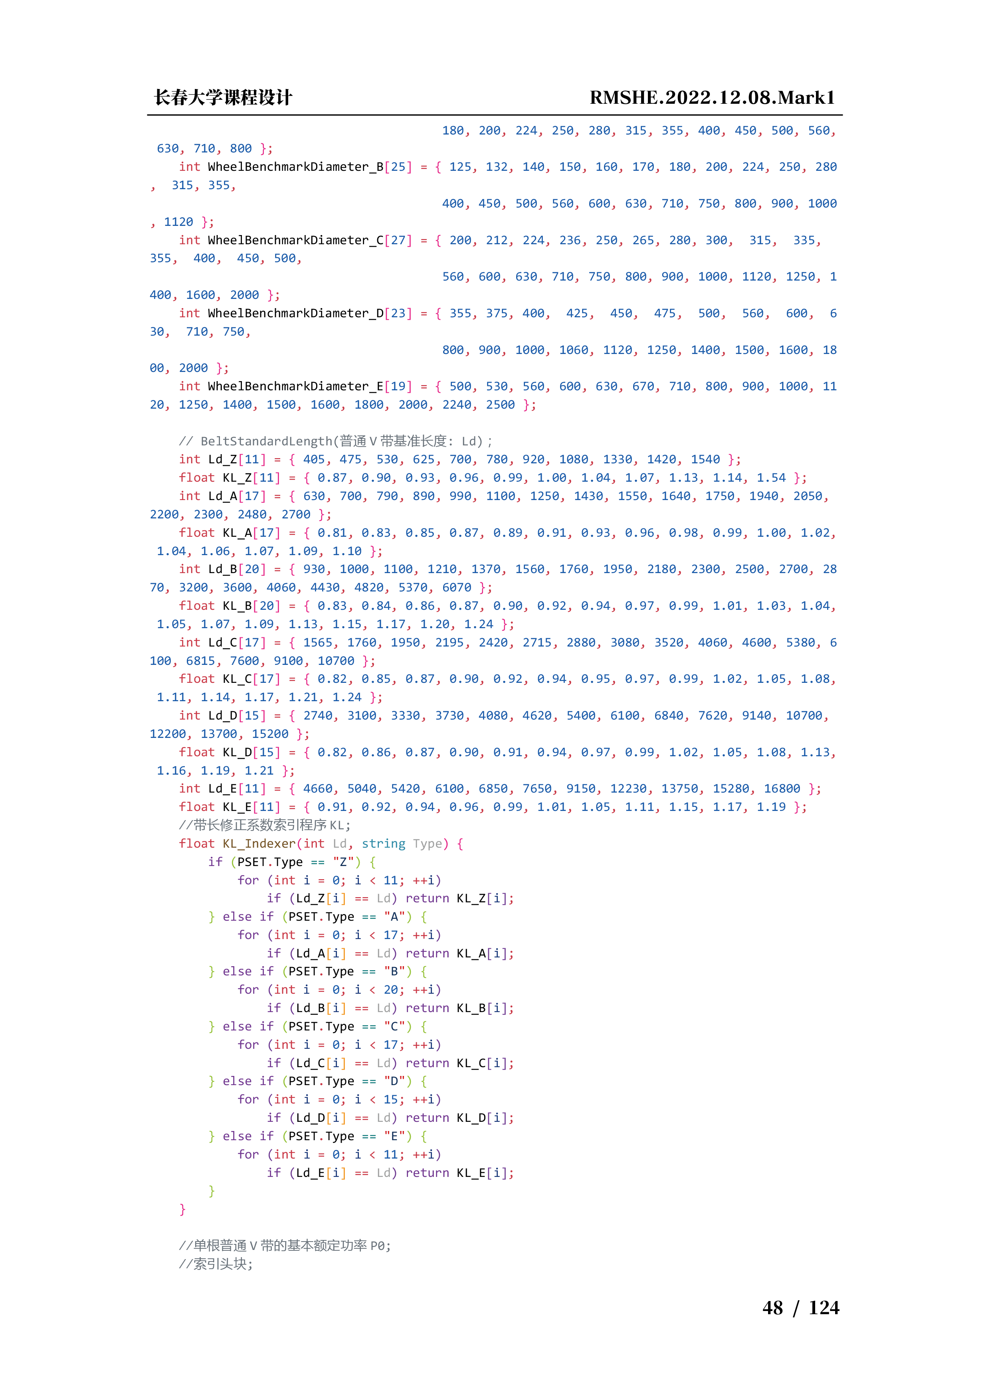
[picture p52: instruction/52.png]
instr

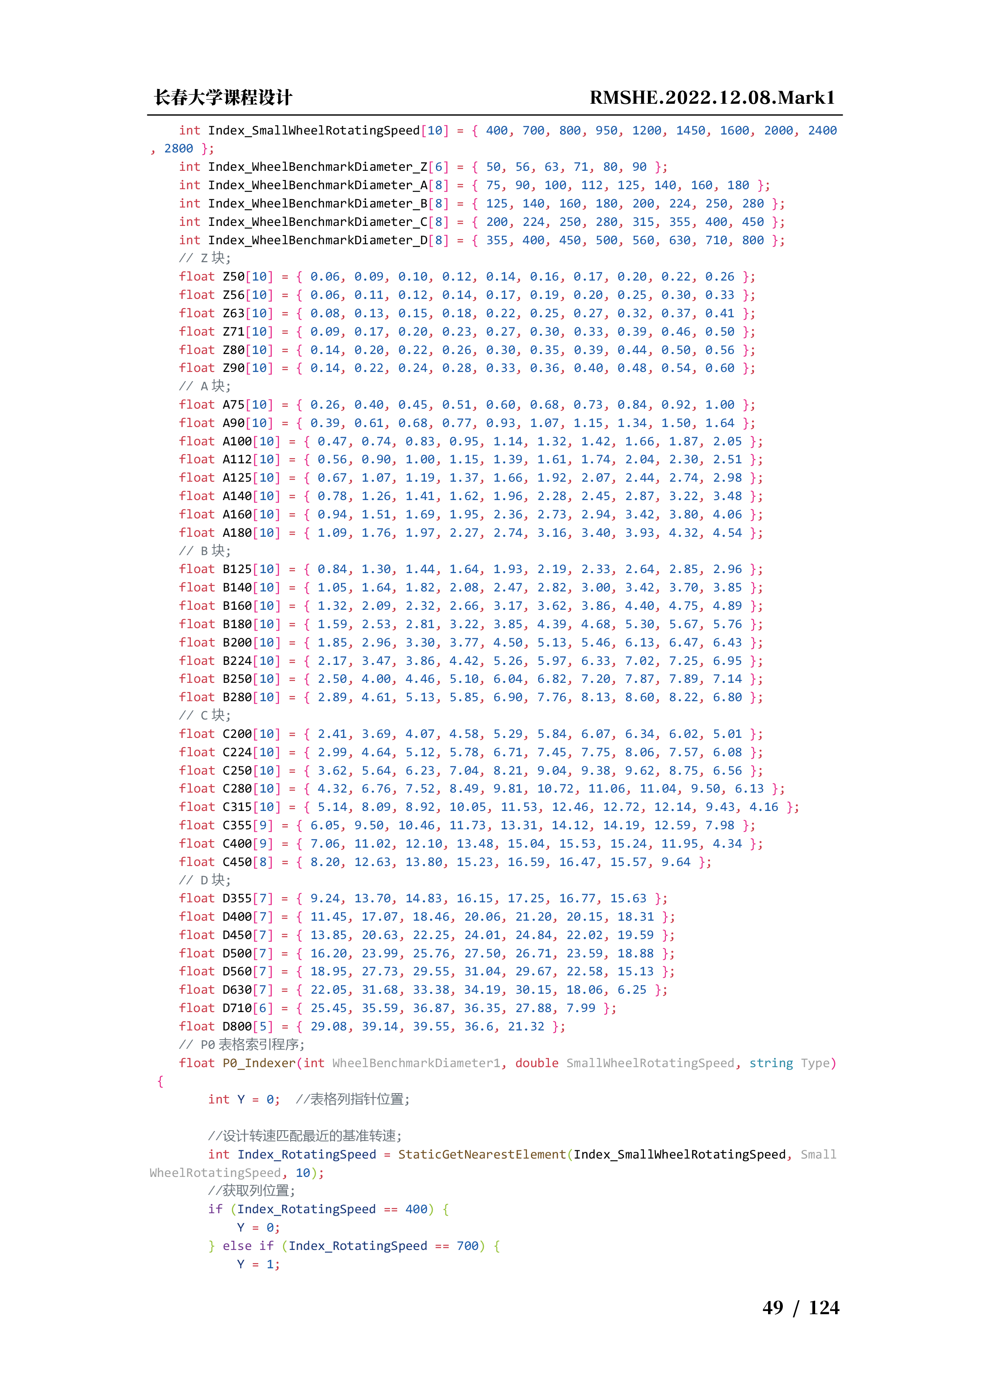
[picture p53: instruction/53.png]
instr

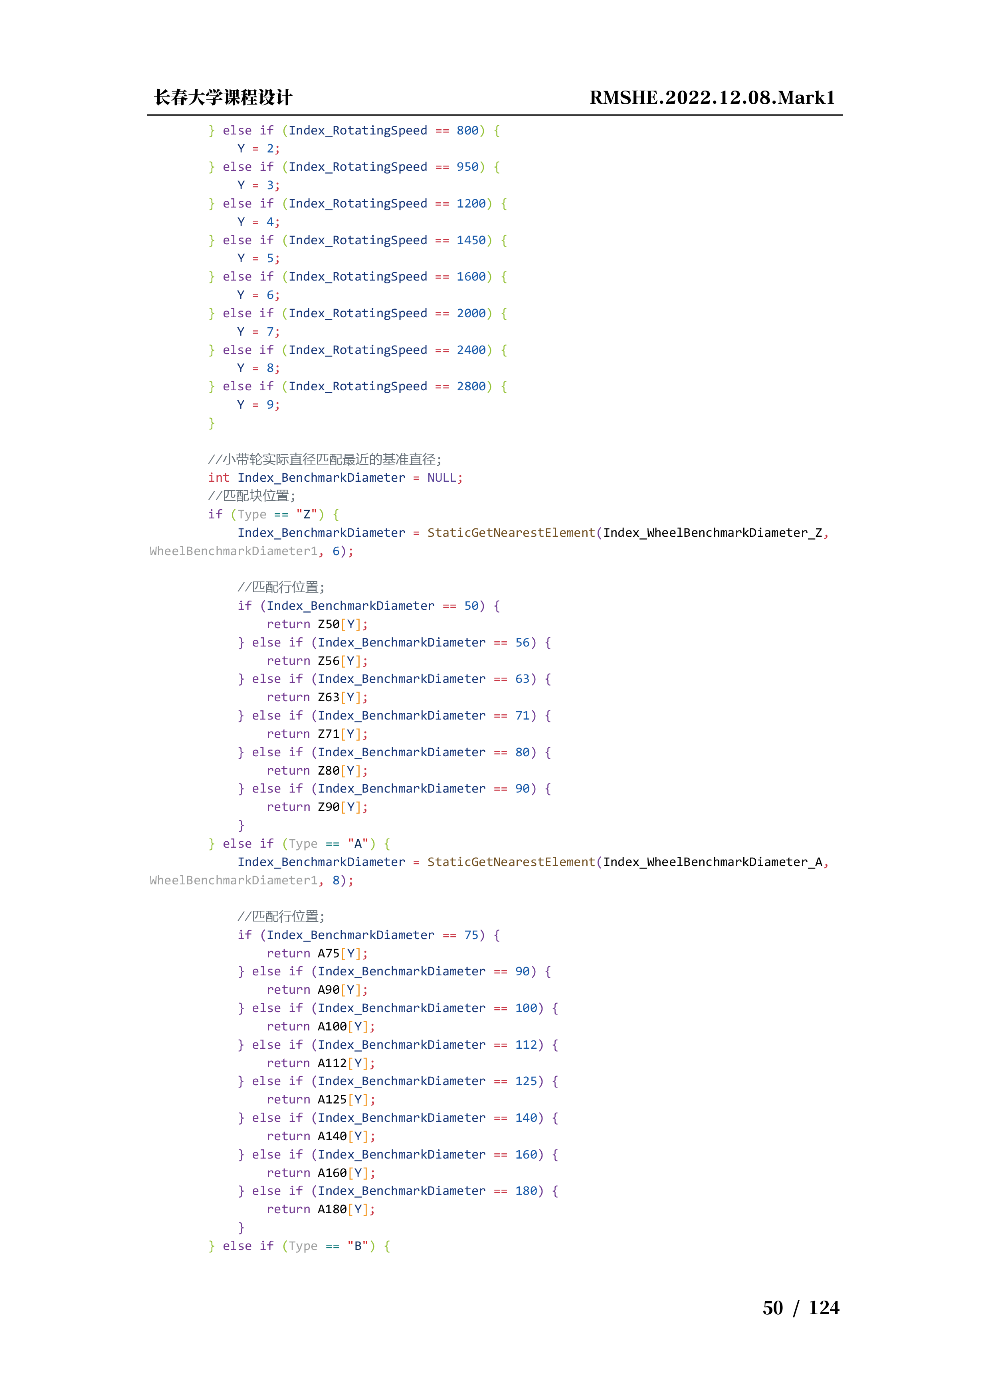
[picture p54: instruction/54.png]
instr

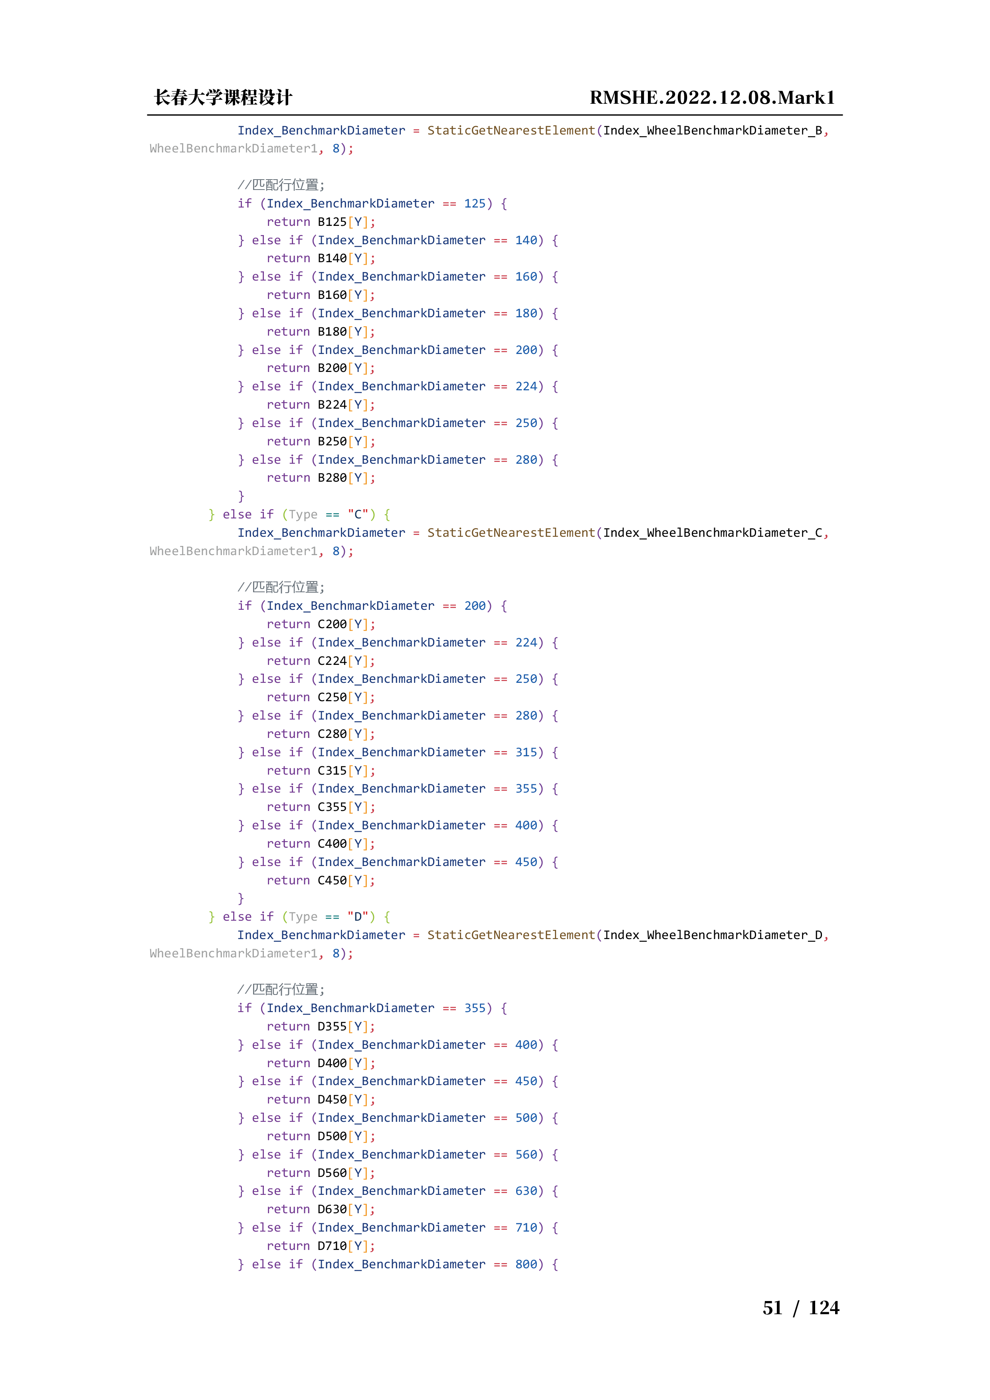
[picture p55: instruction/55.png]
instr

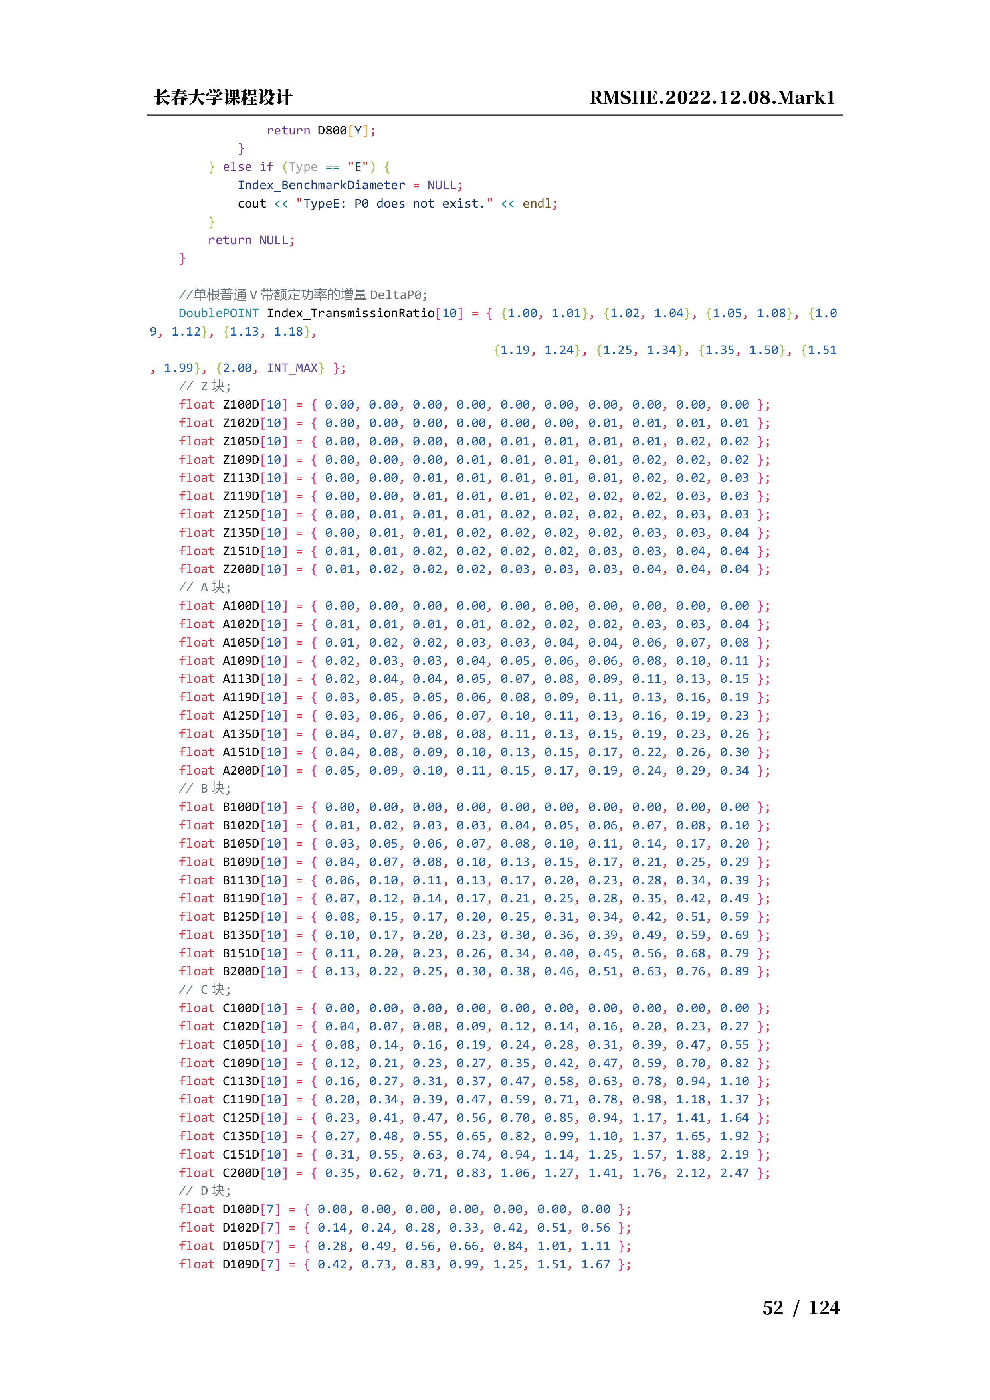
[picture p56: instruction/56.png]
instr

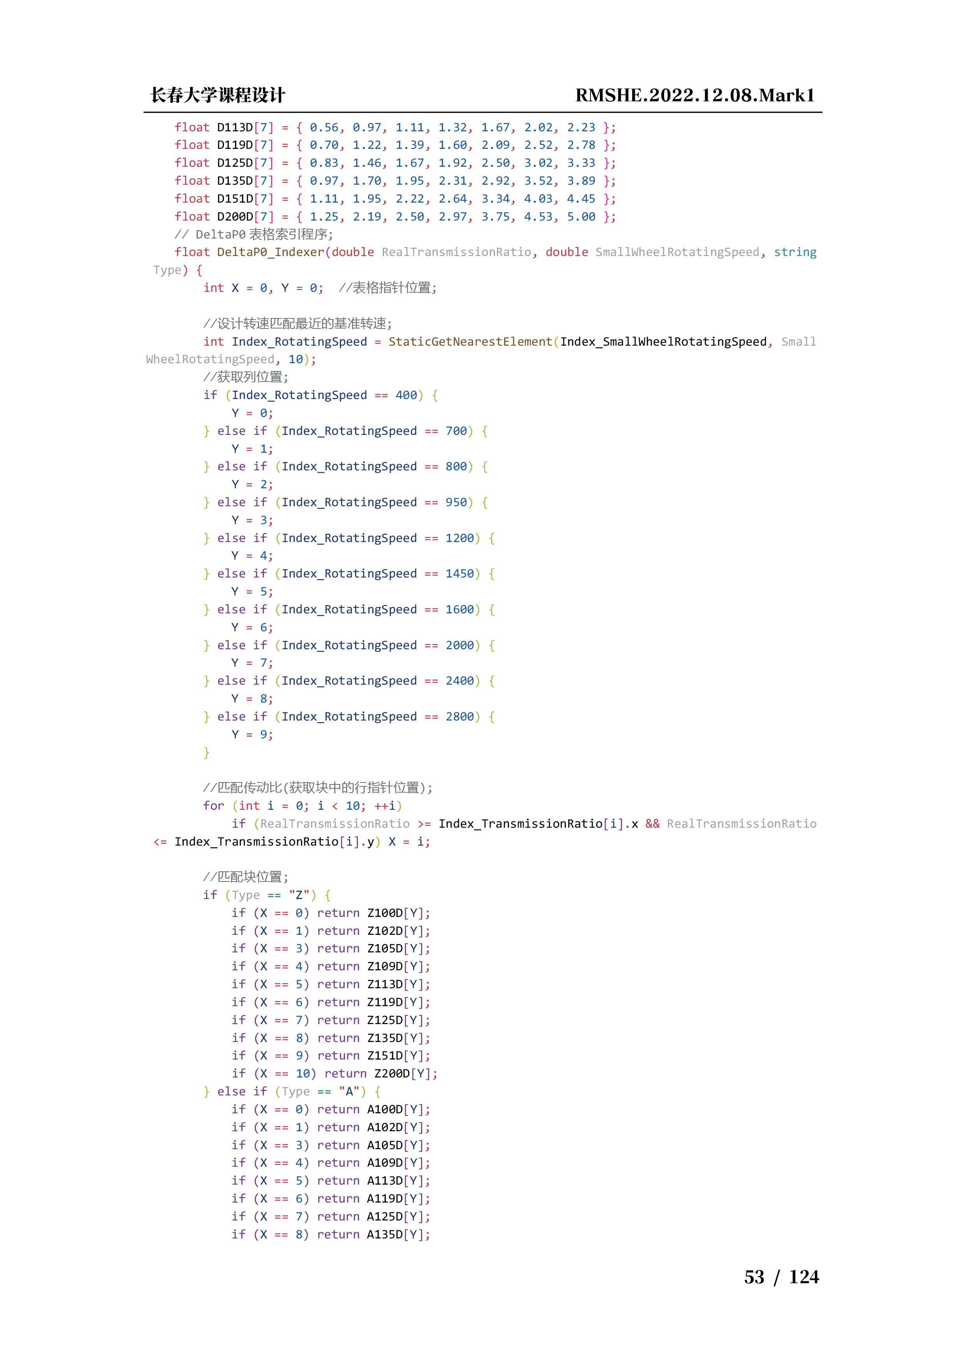
[picture p57: instruction/57.png]
instr

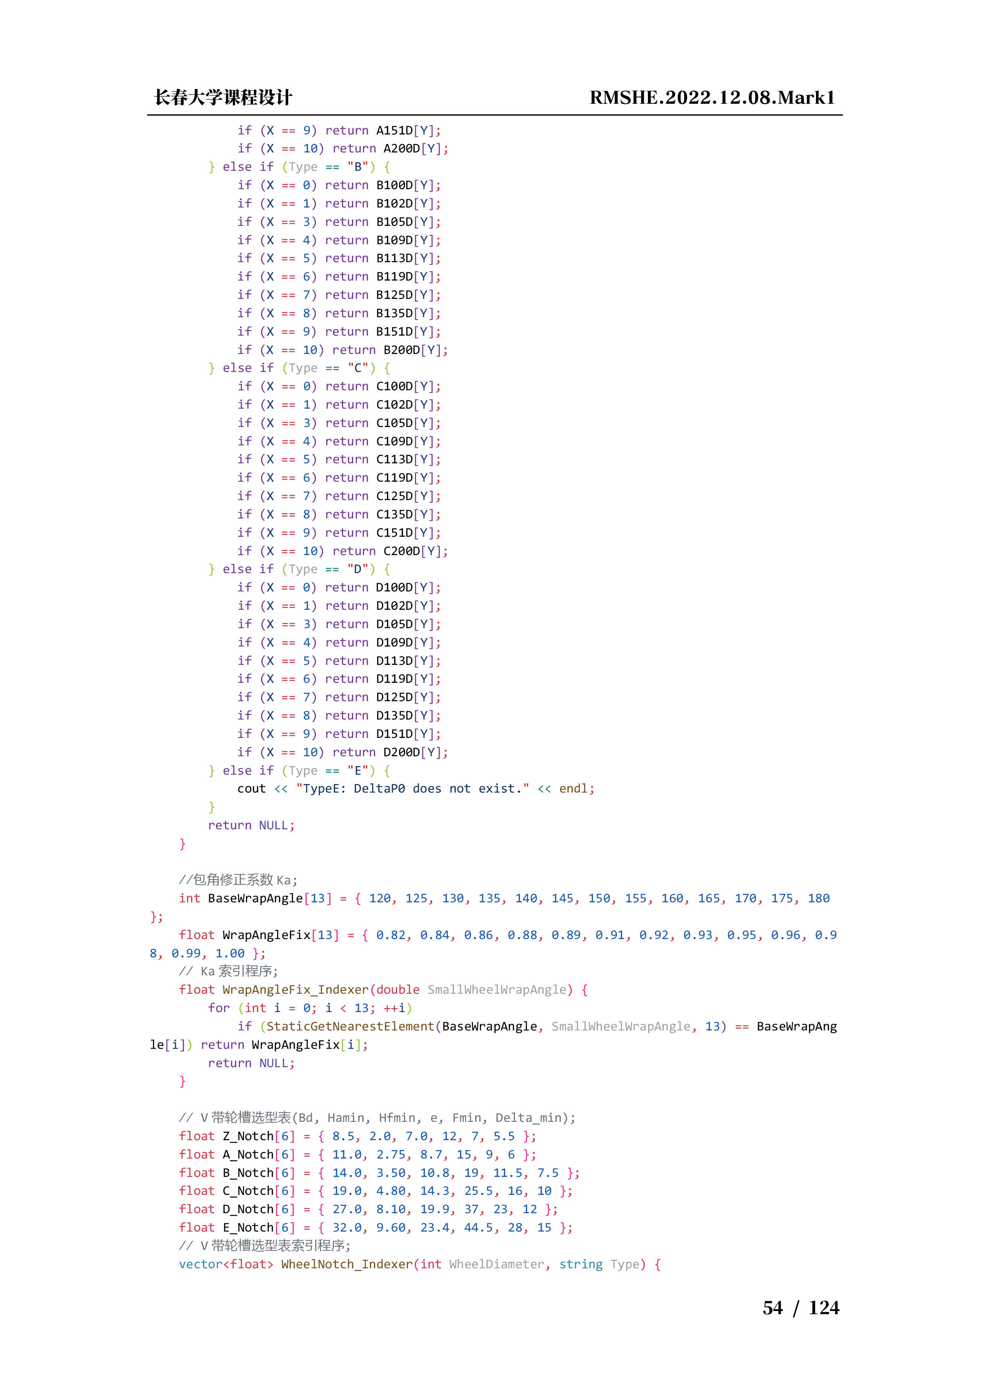
[picture p58: instruction/58.png]
instr

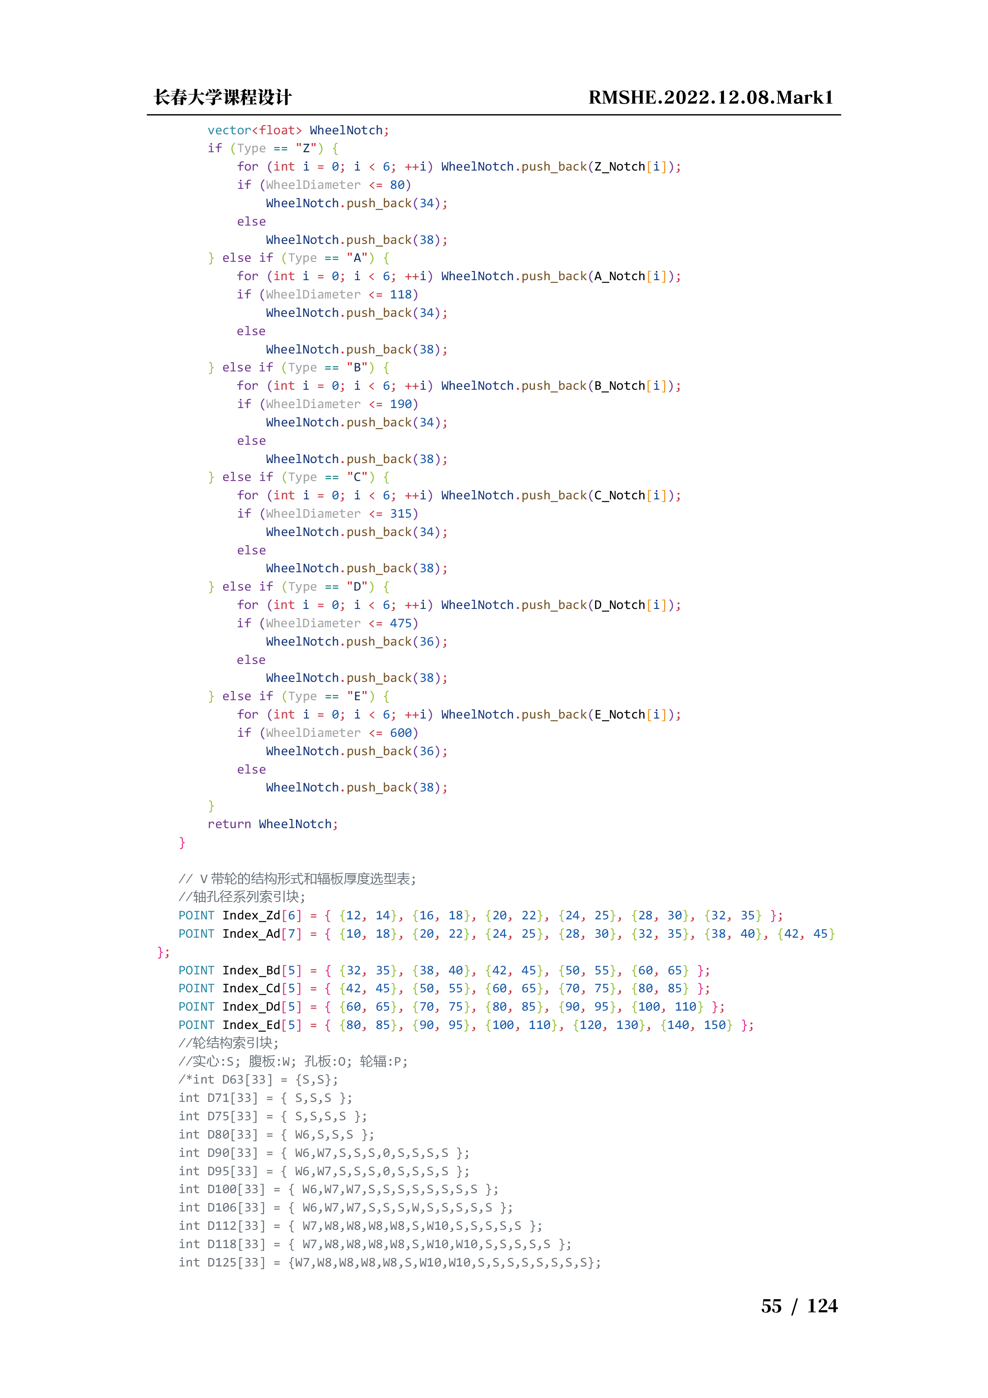
[picture p59: instruction/59.png]
instr

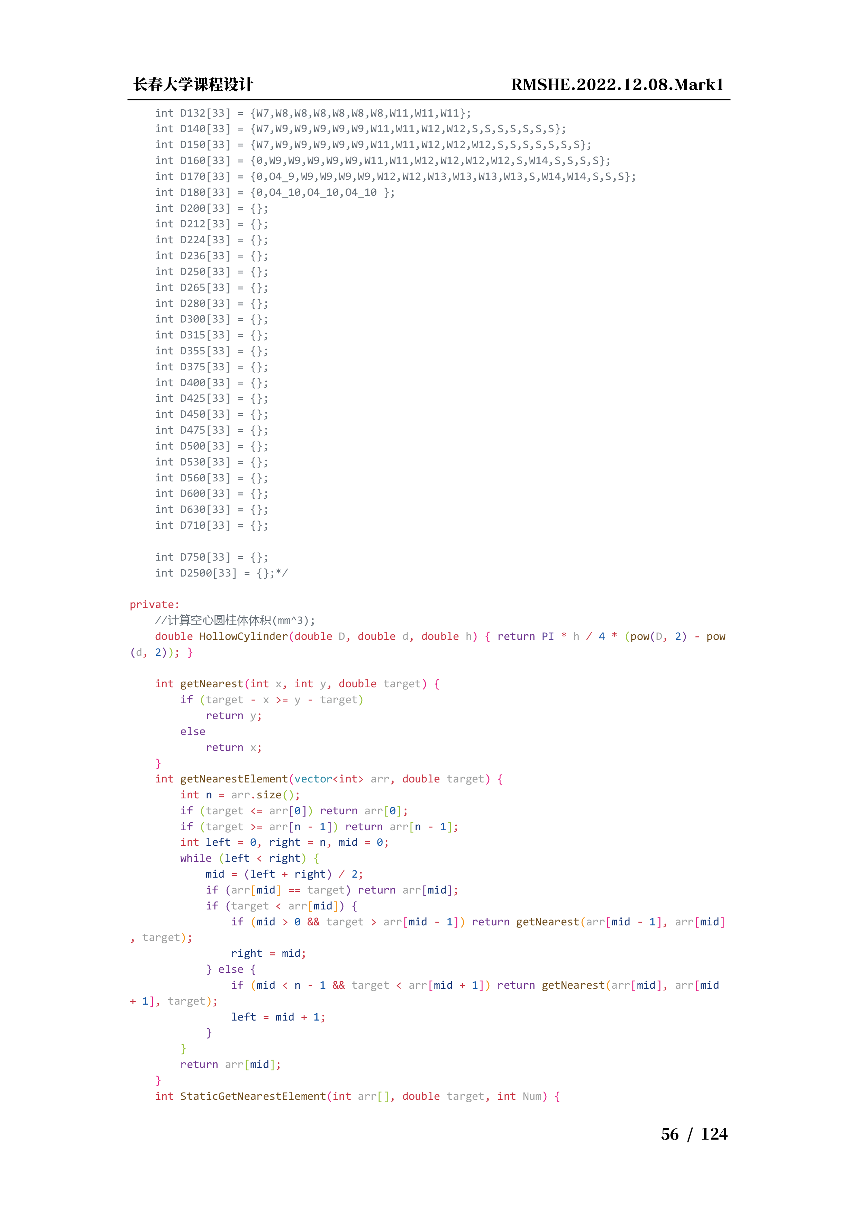
[picture p60: instruction/60.png]
instr

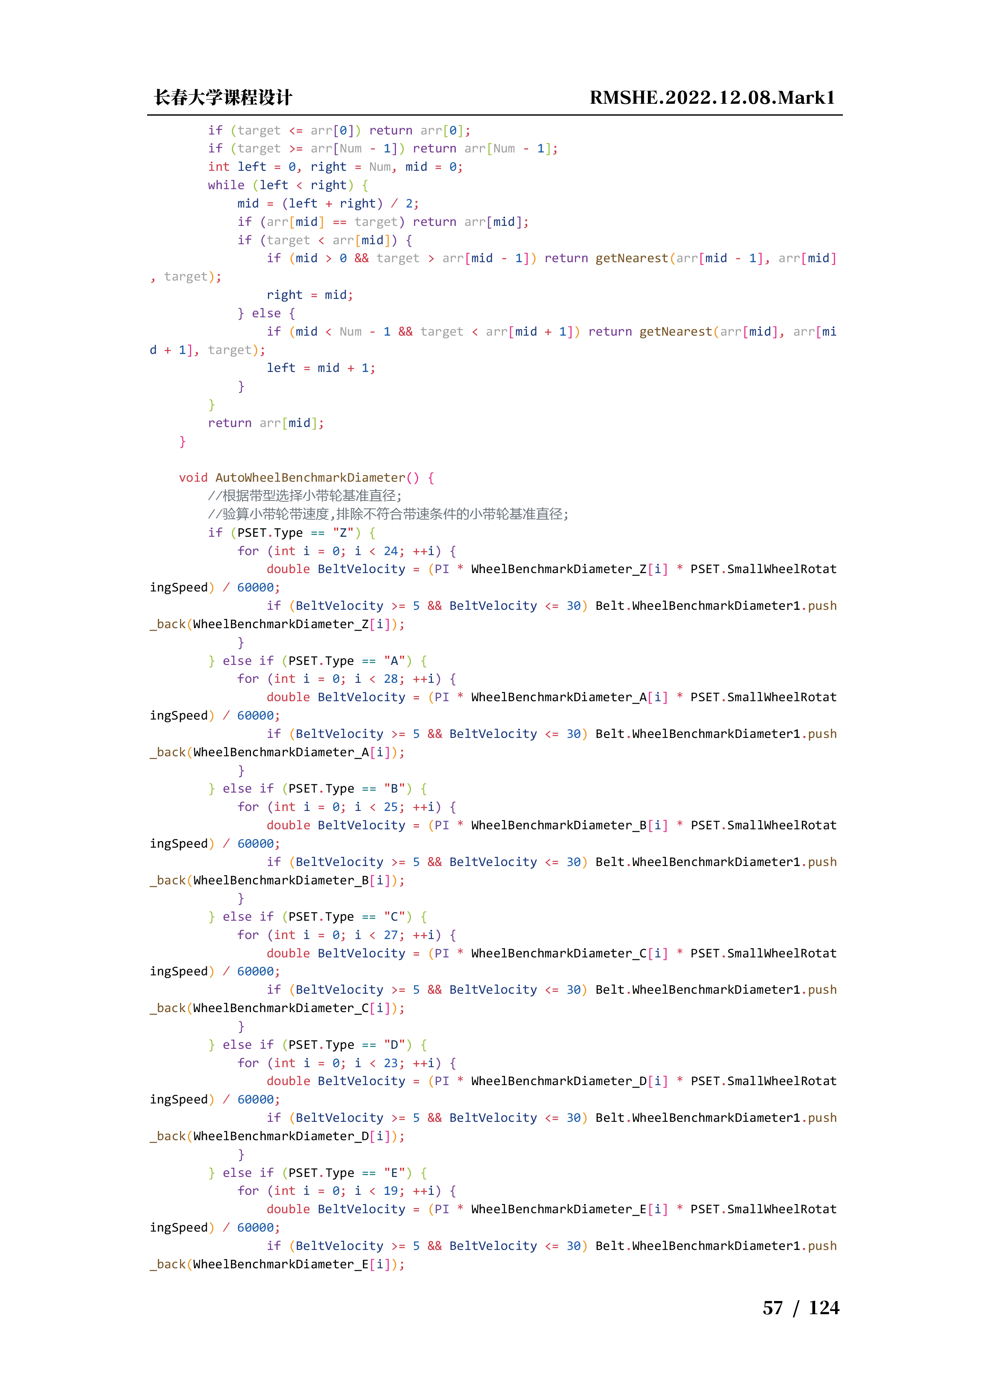
[picture p61: instruction/61.png]
instr

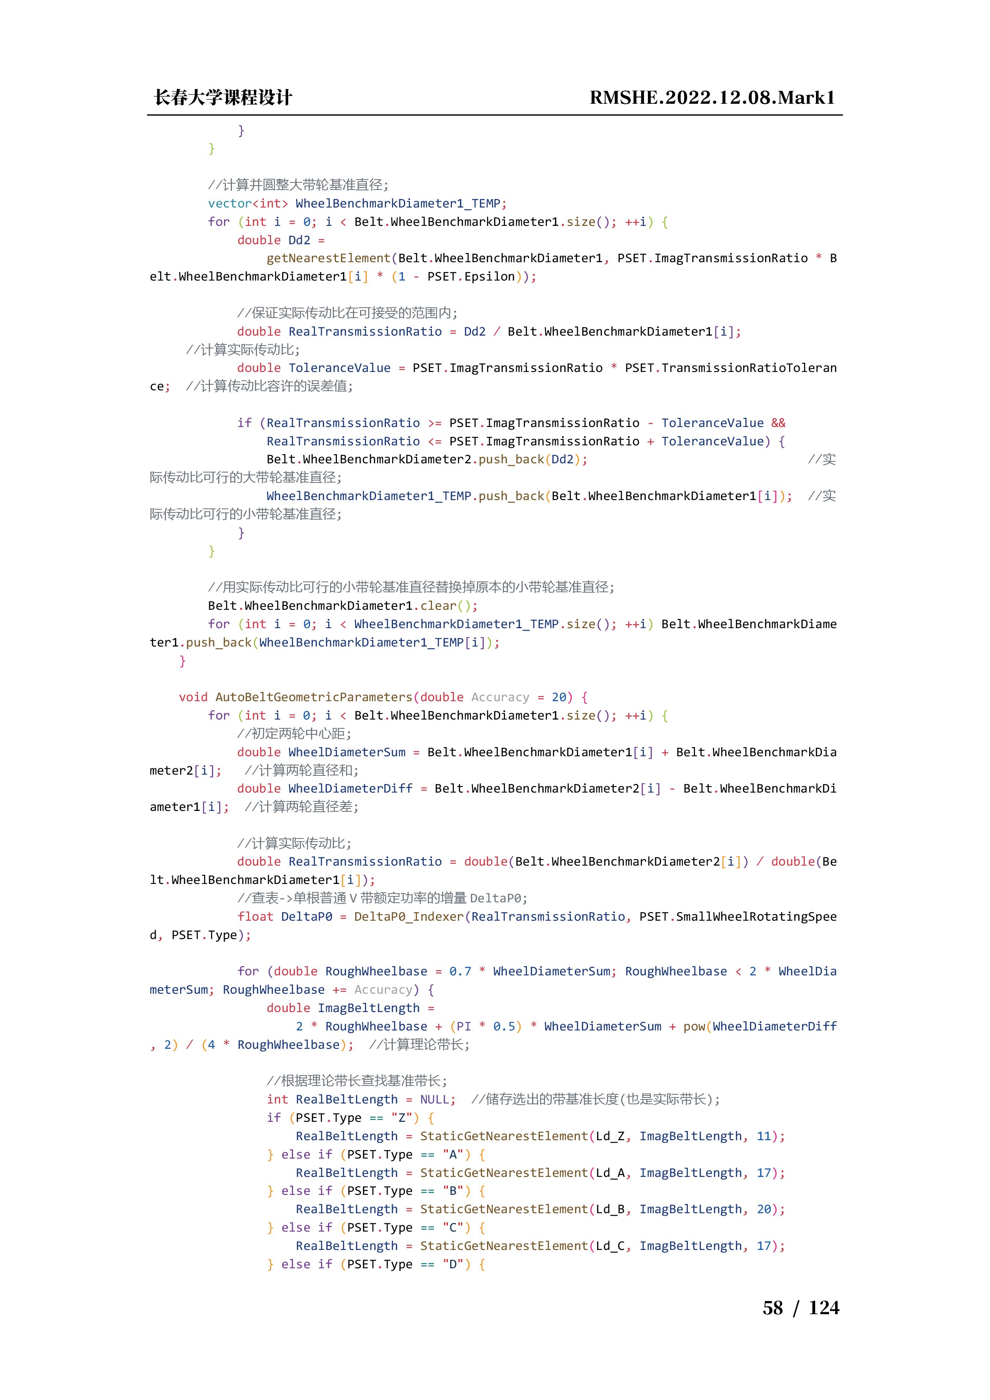
[picture p62: instruction/62.png]
instr

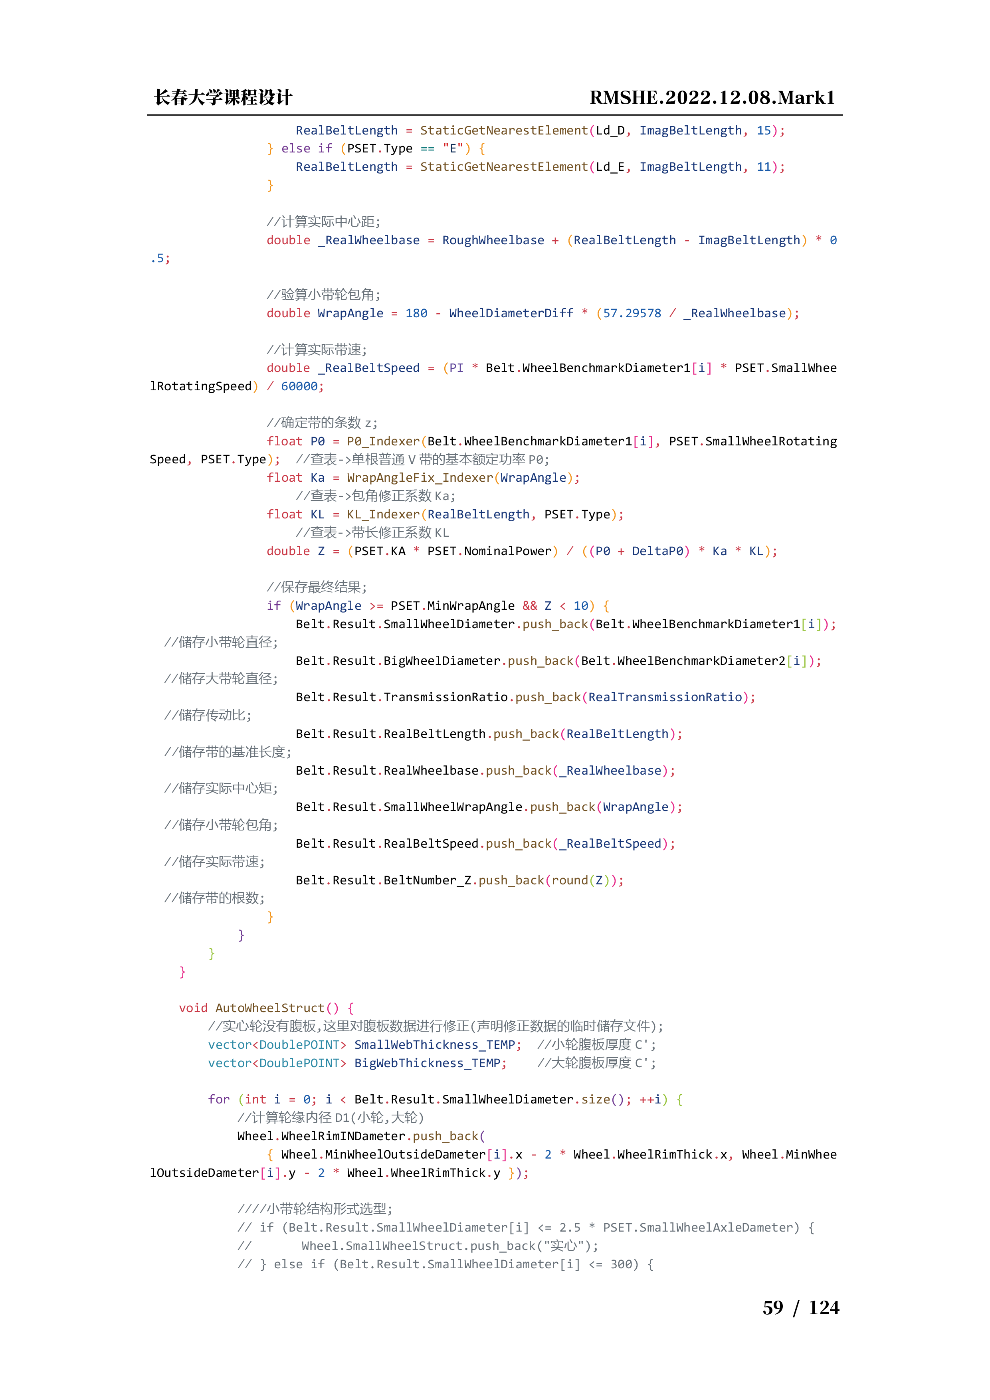
[picture p63: instruction/63.png]
instr

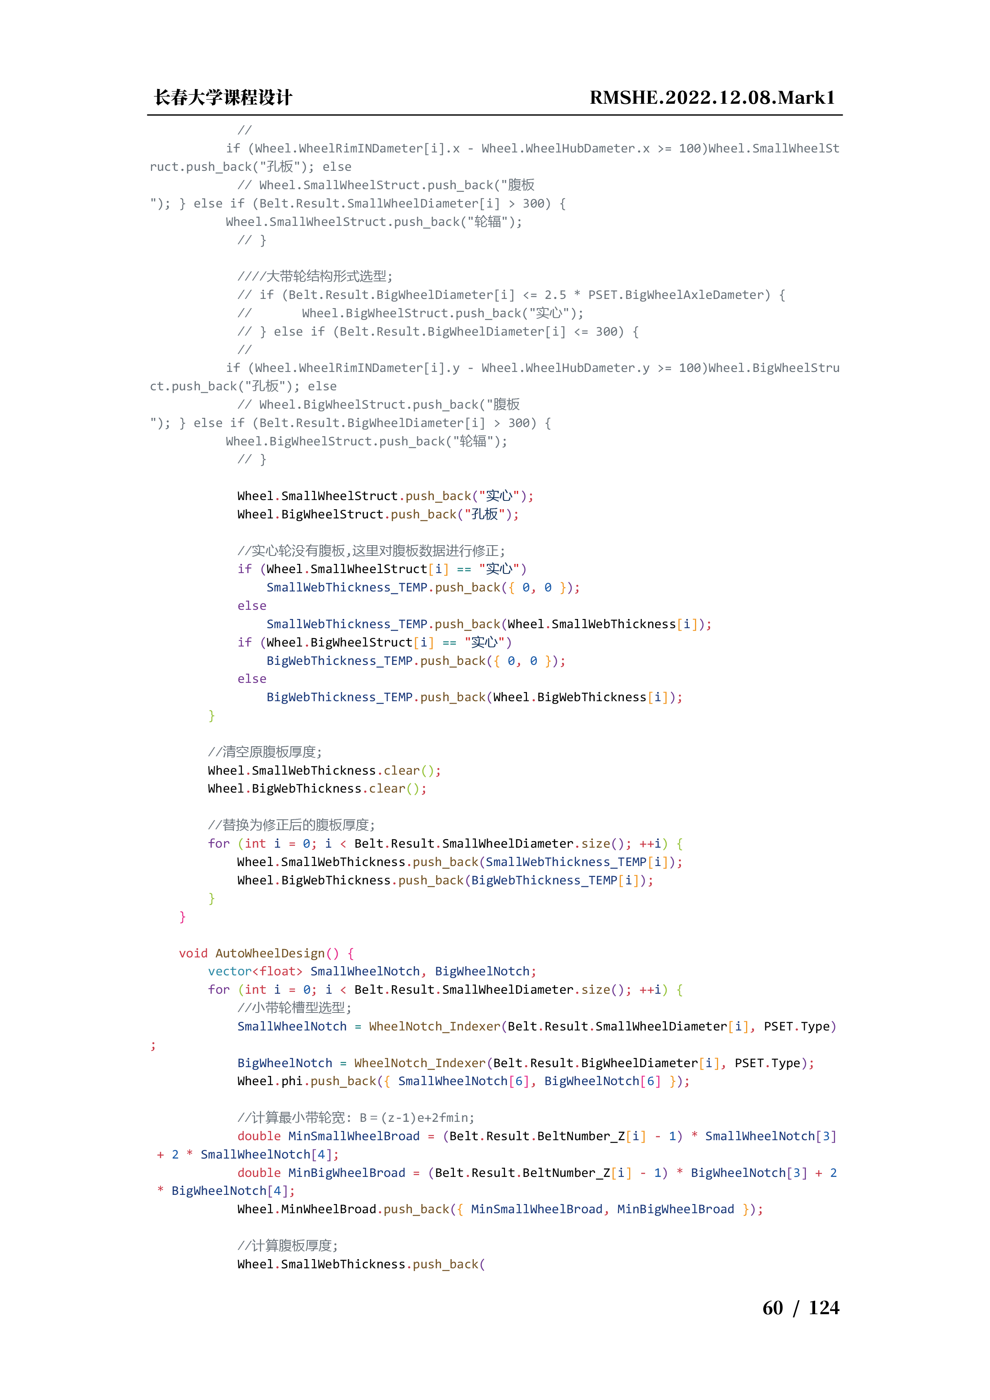
[picture p64: instruction/64.png]
instr

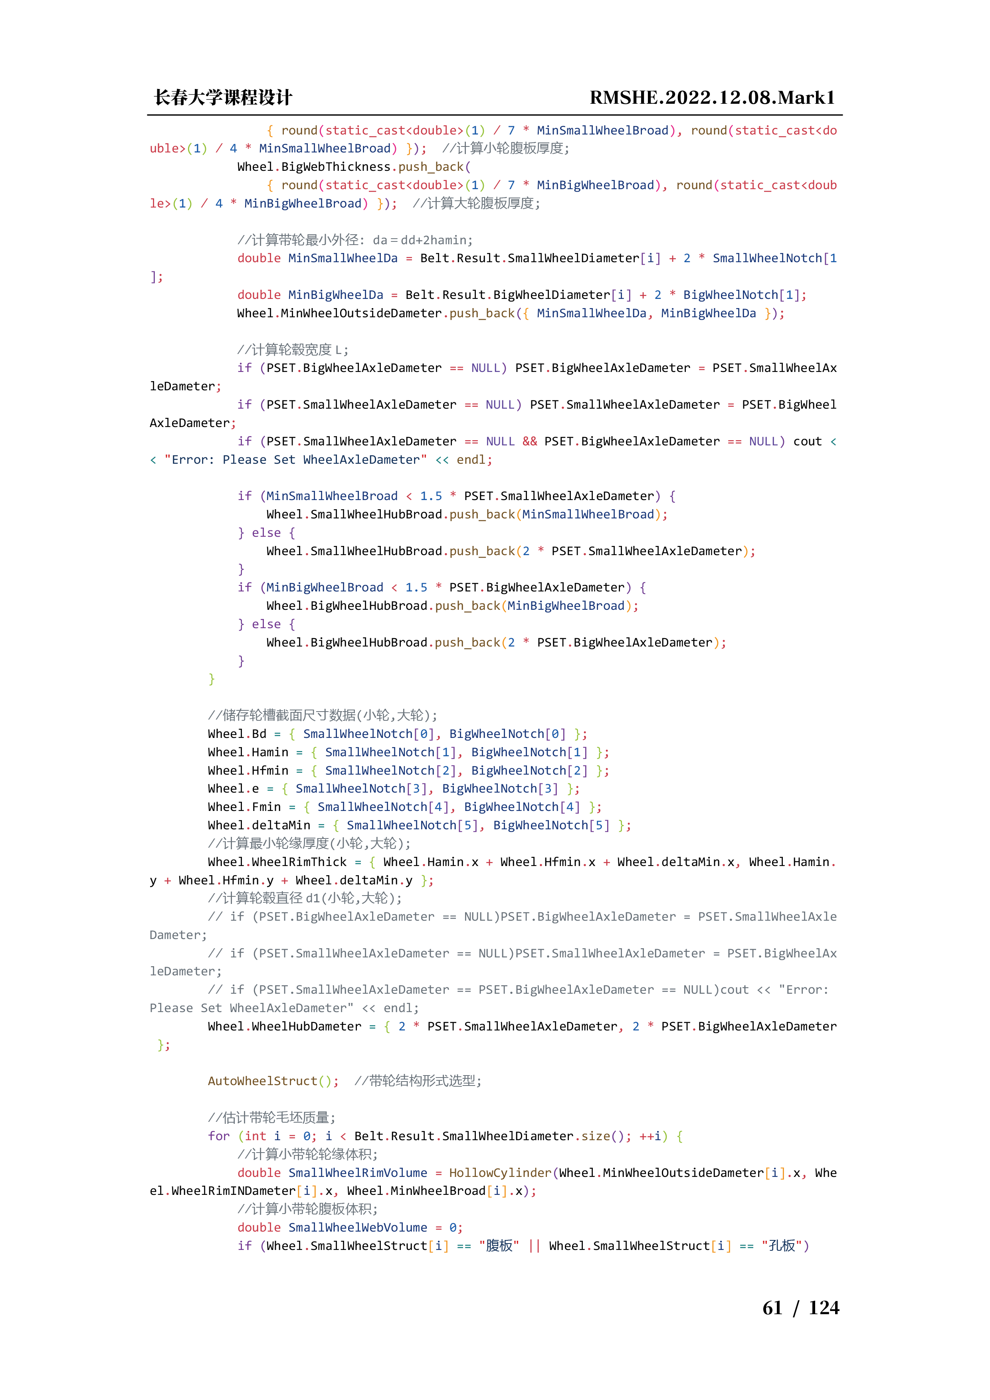
[picture p65: instruction/65.png]
instr

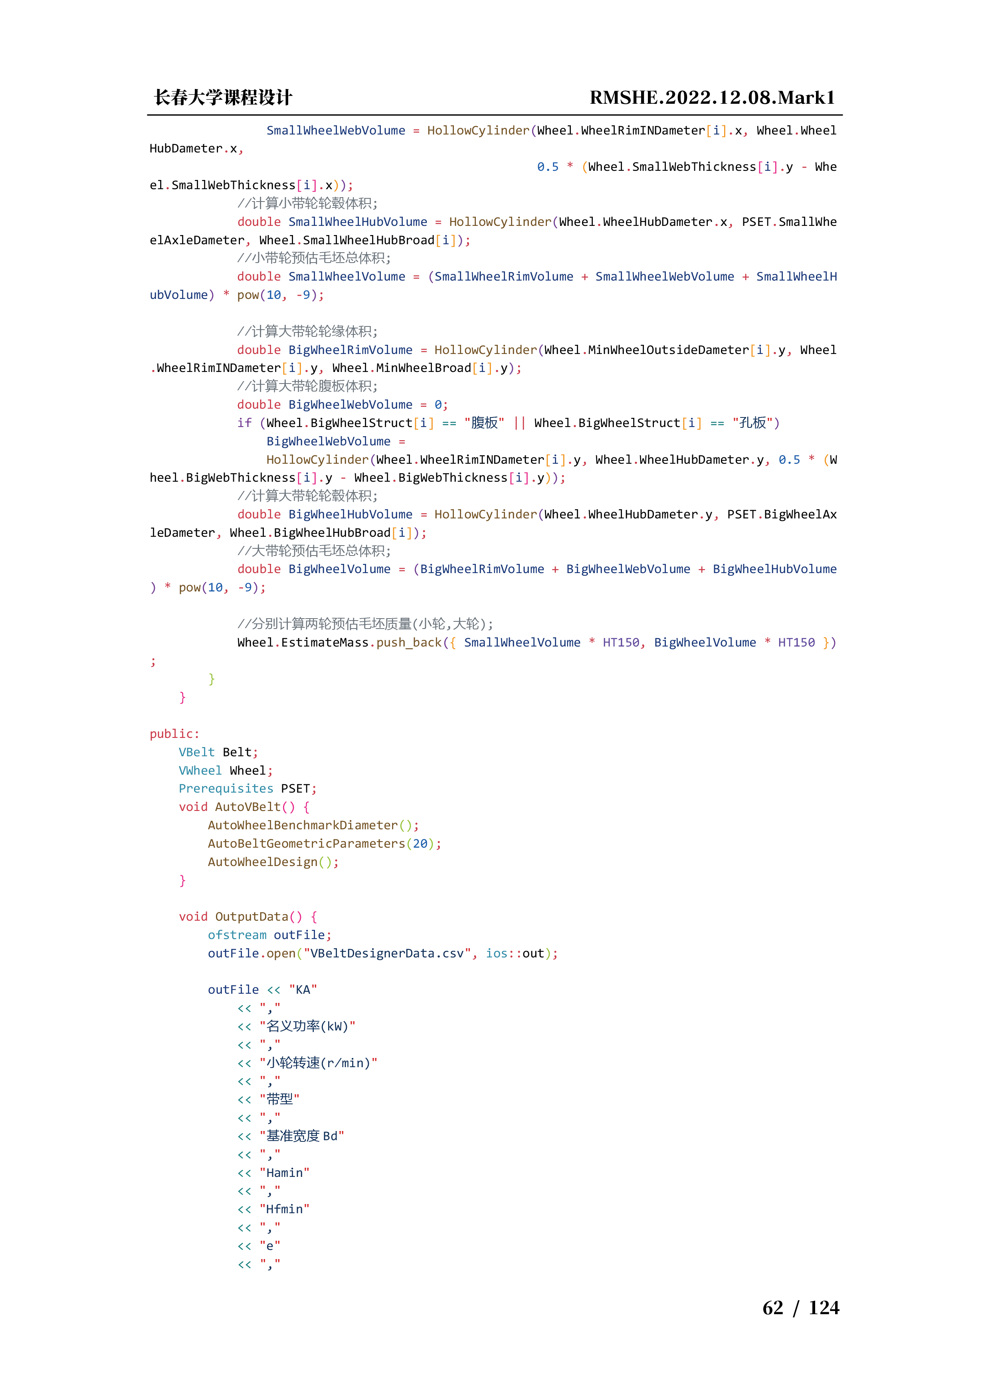
[picture p66: instruction/66.png]
instr

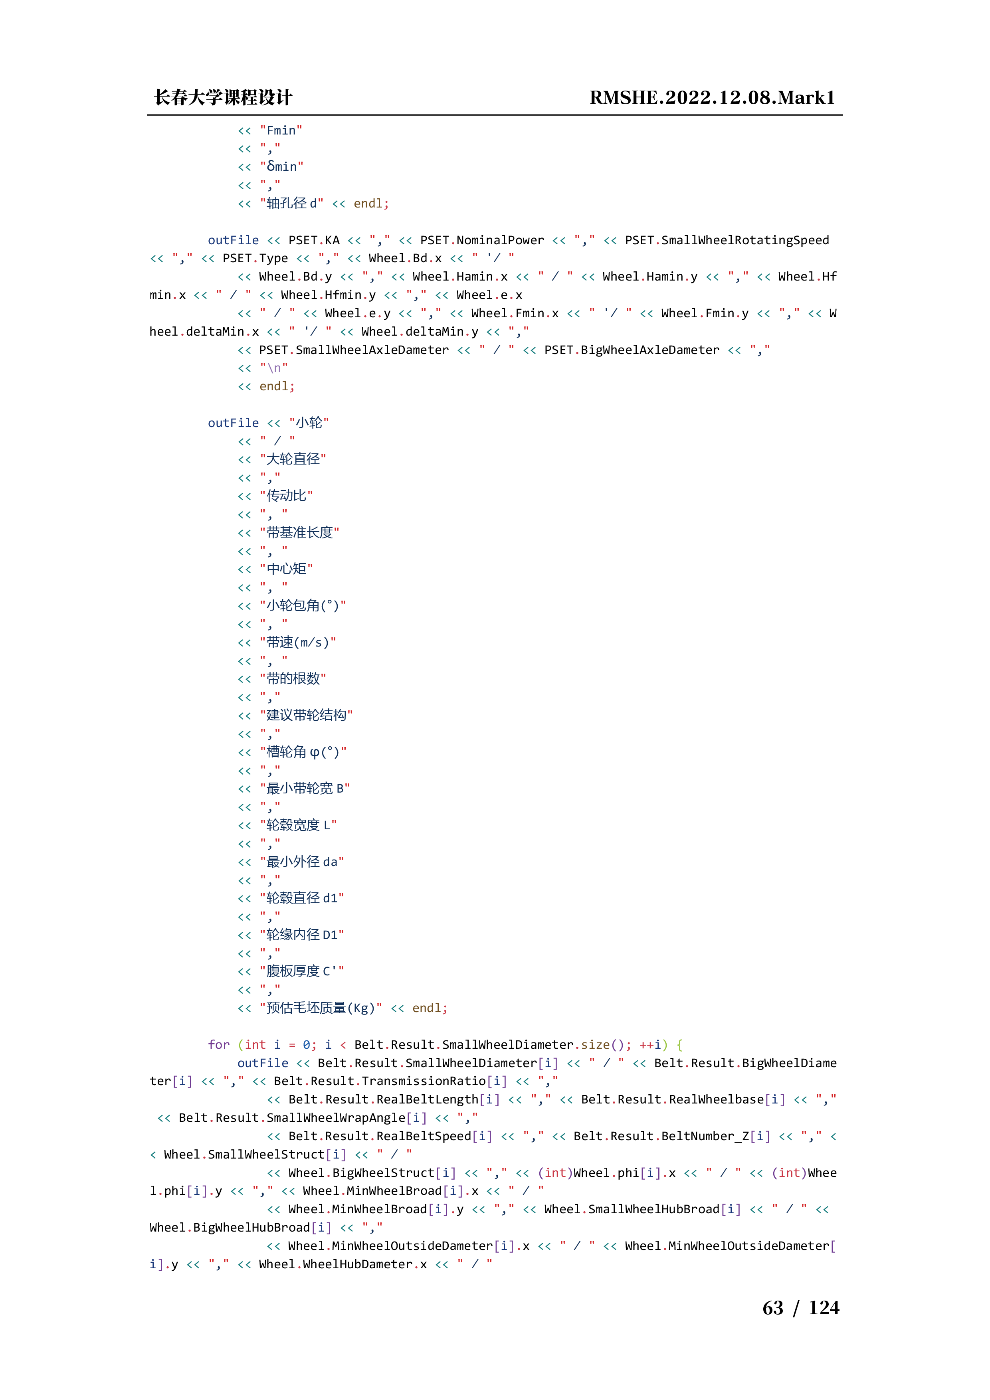
[picture p67: instruction/67.png]
instr

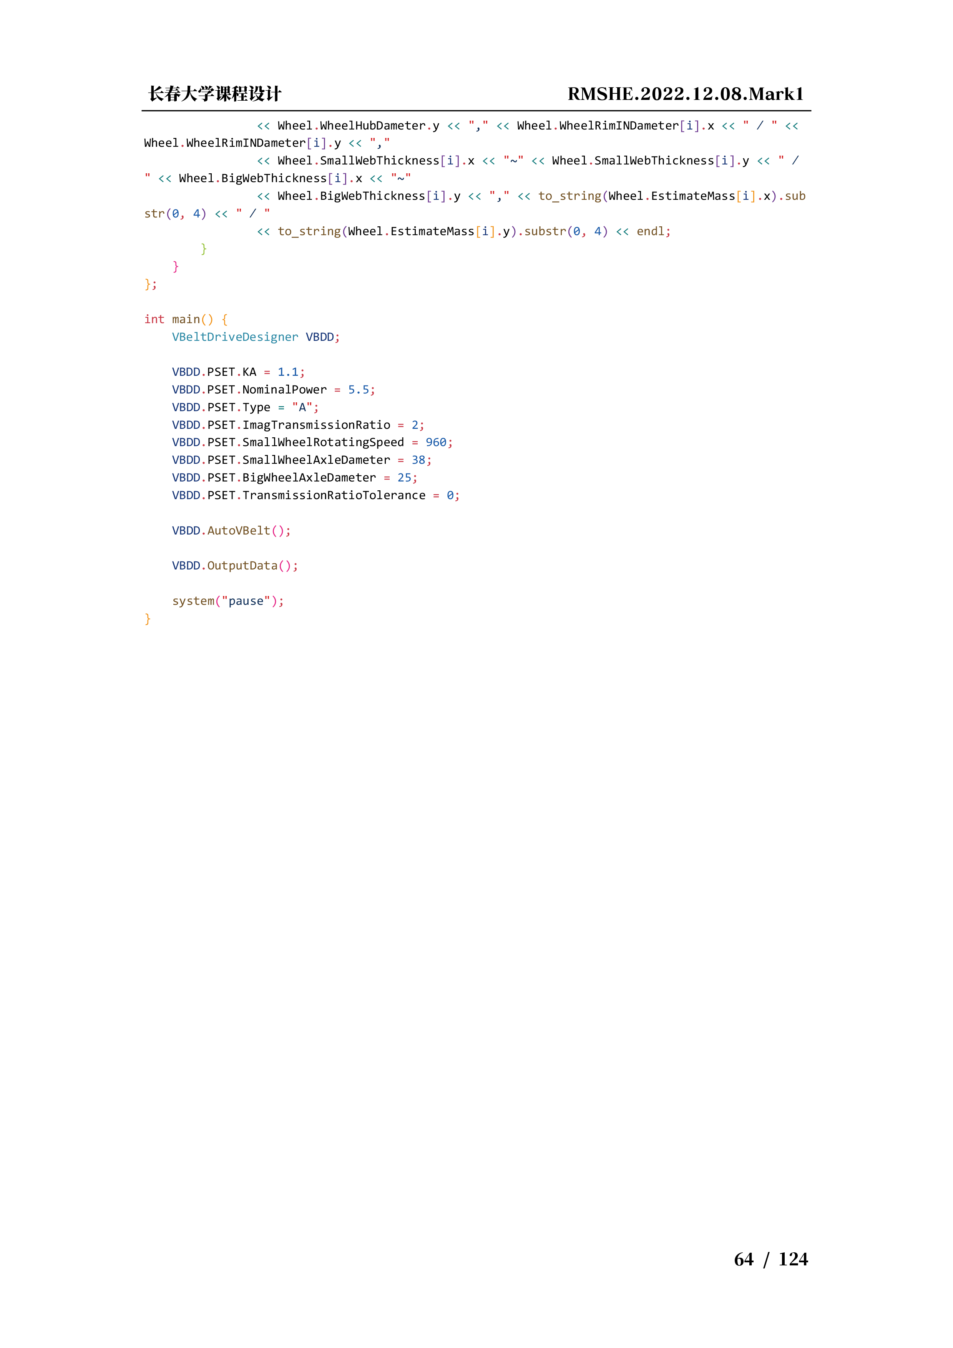
[picture p68: instruction/68.png]
instr

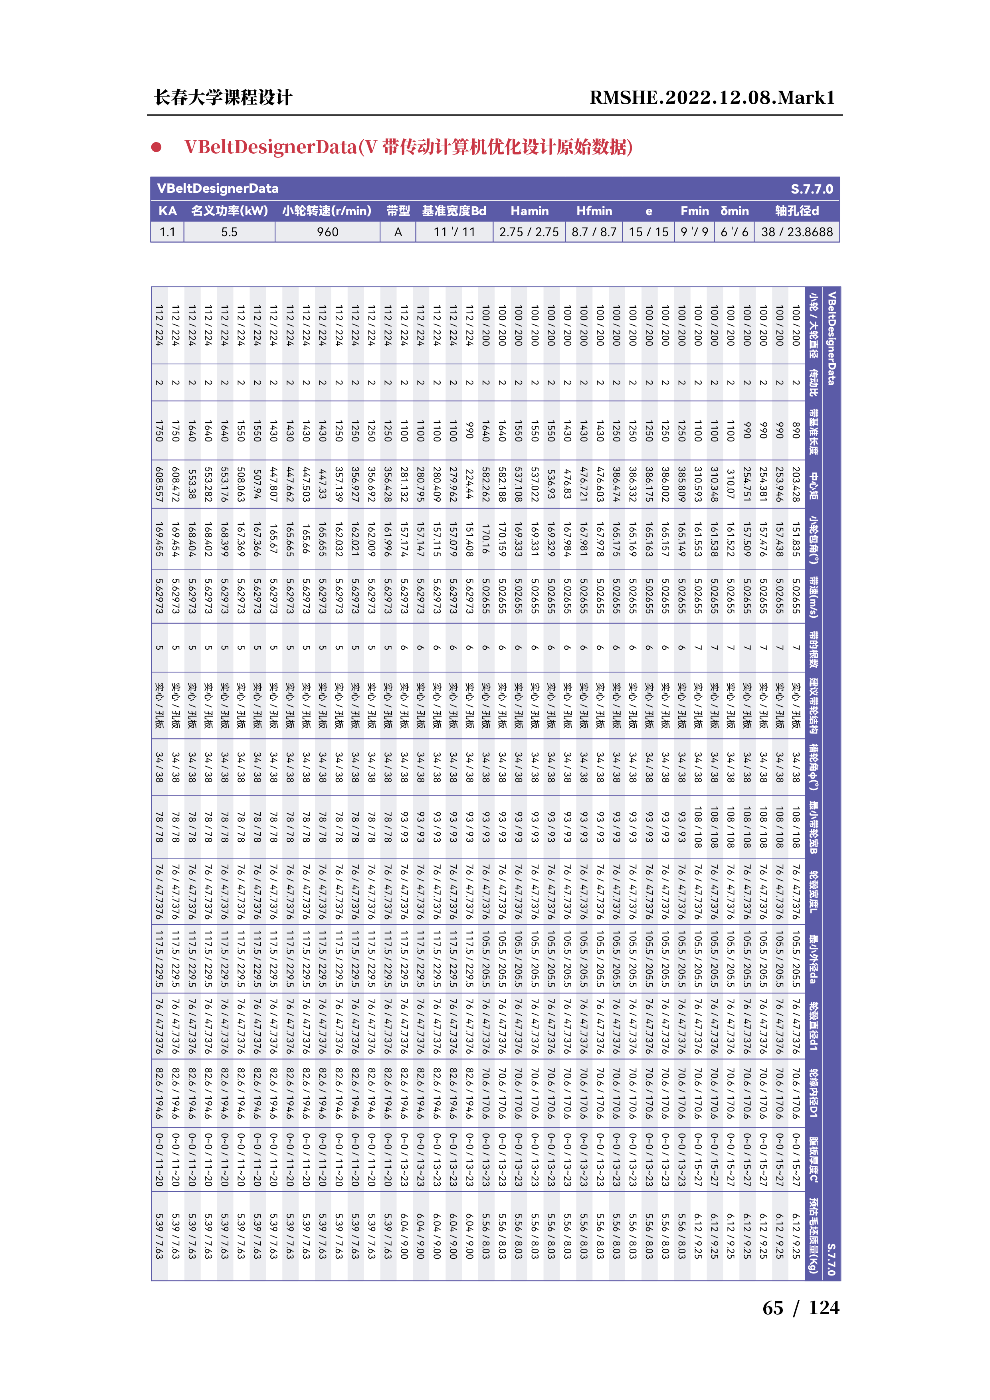
[picture p69: instruction/69.png]
instr

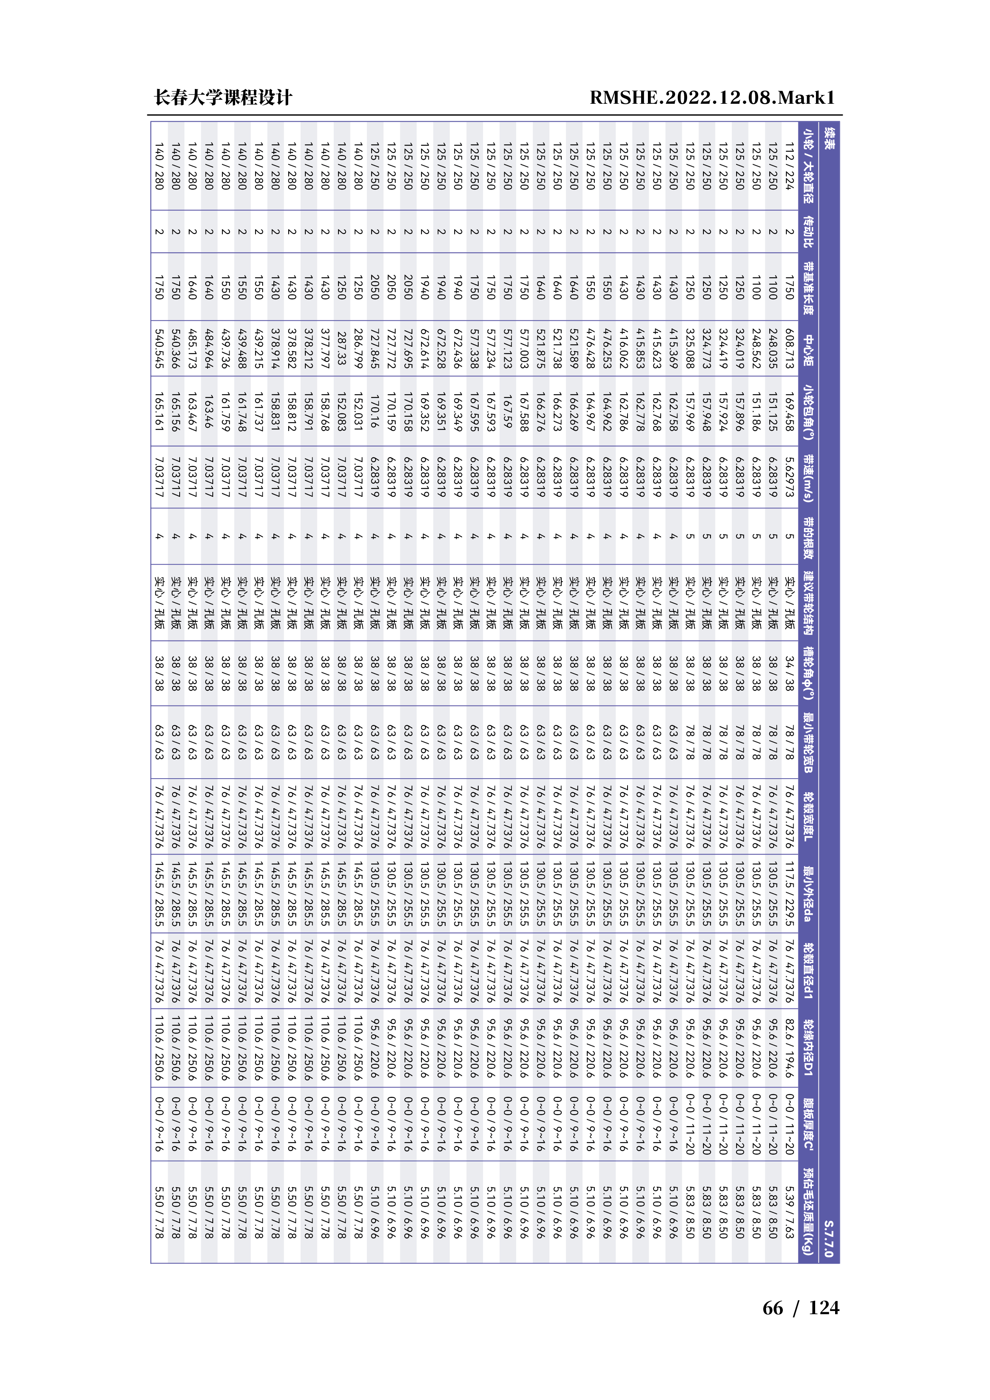
[picture p70: instruction/70.png]
instr

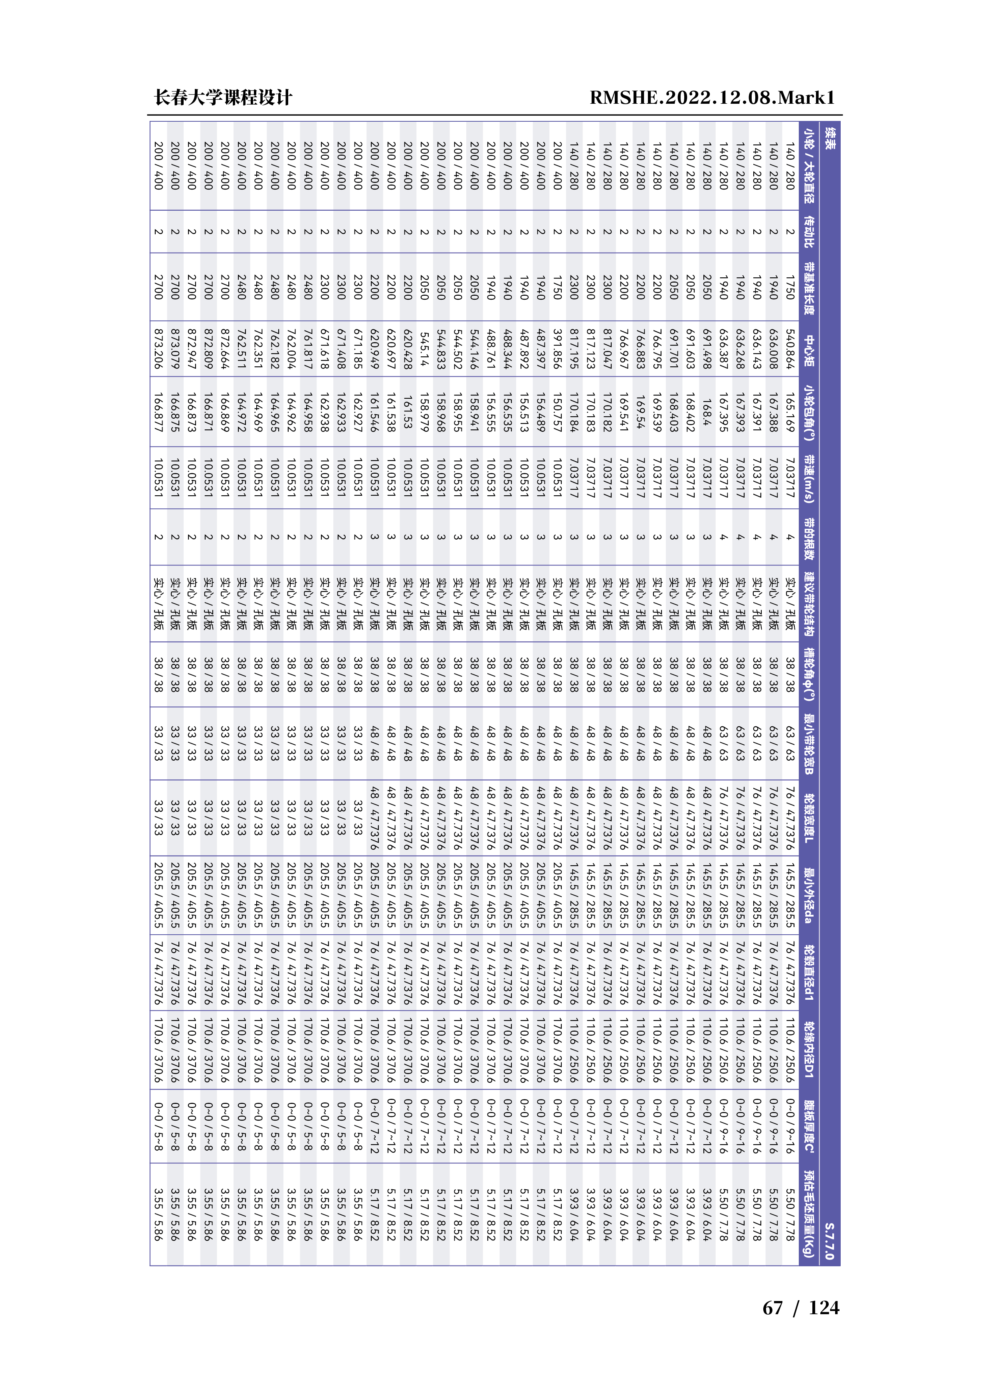
[picture p71: instruction/71.png]
instr

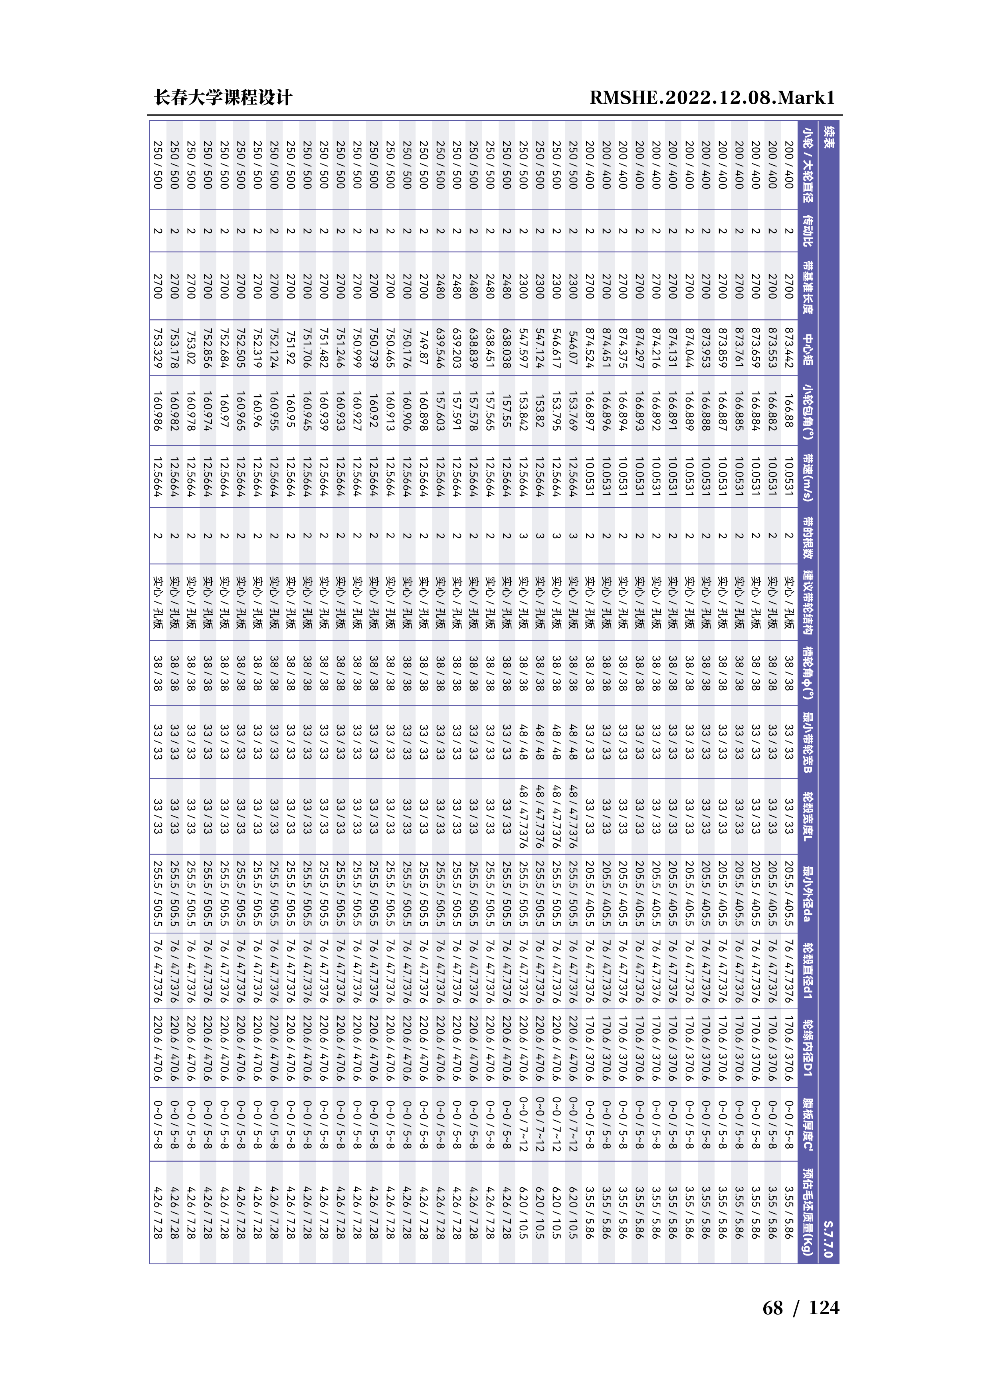
[picture p72: instruction/72.png]
instr

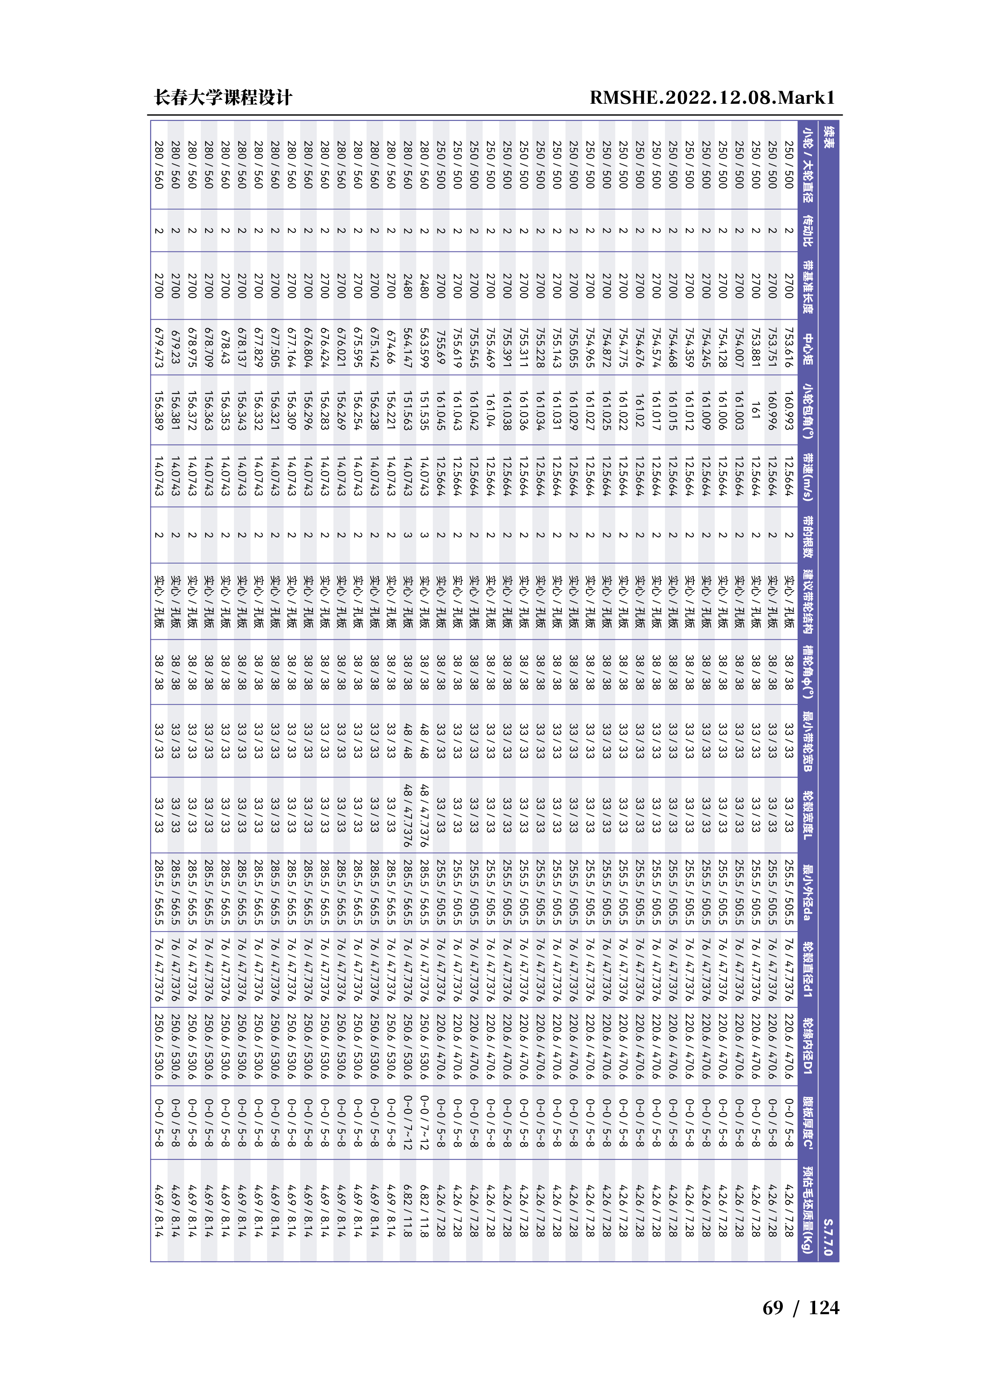
[picture p73: instruction/73.png]
instr

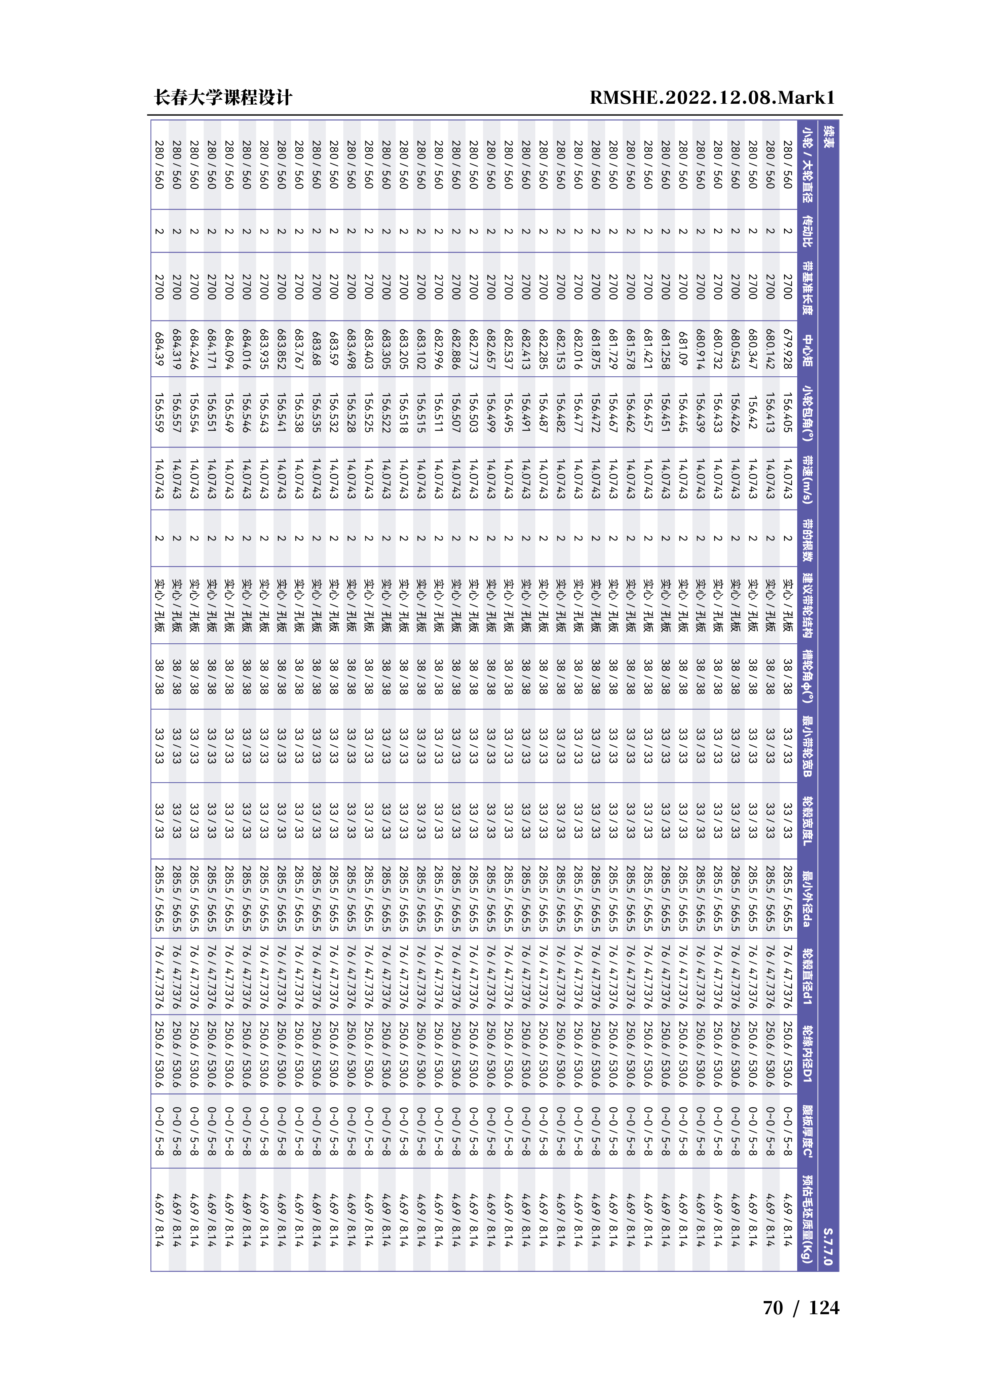
[picture p74: instruction/74.png]
instr

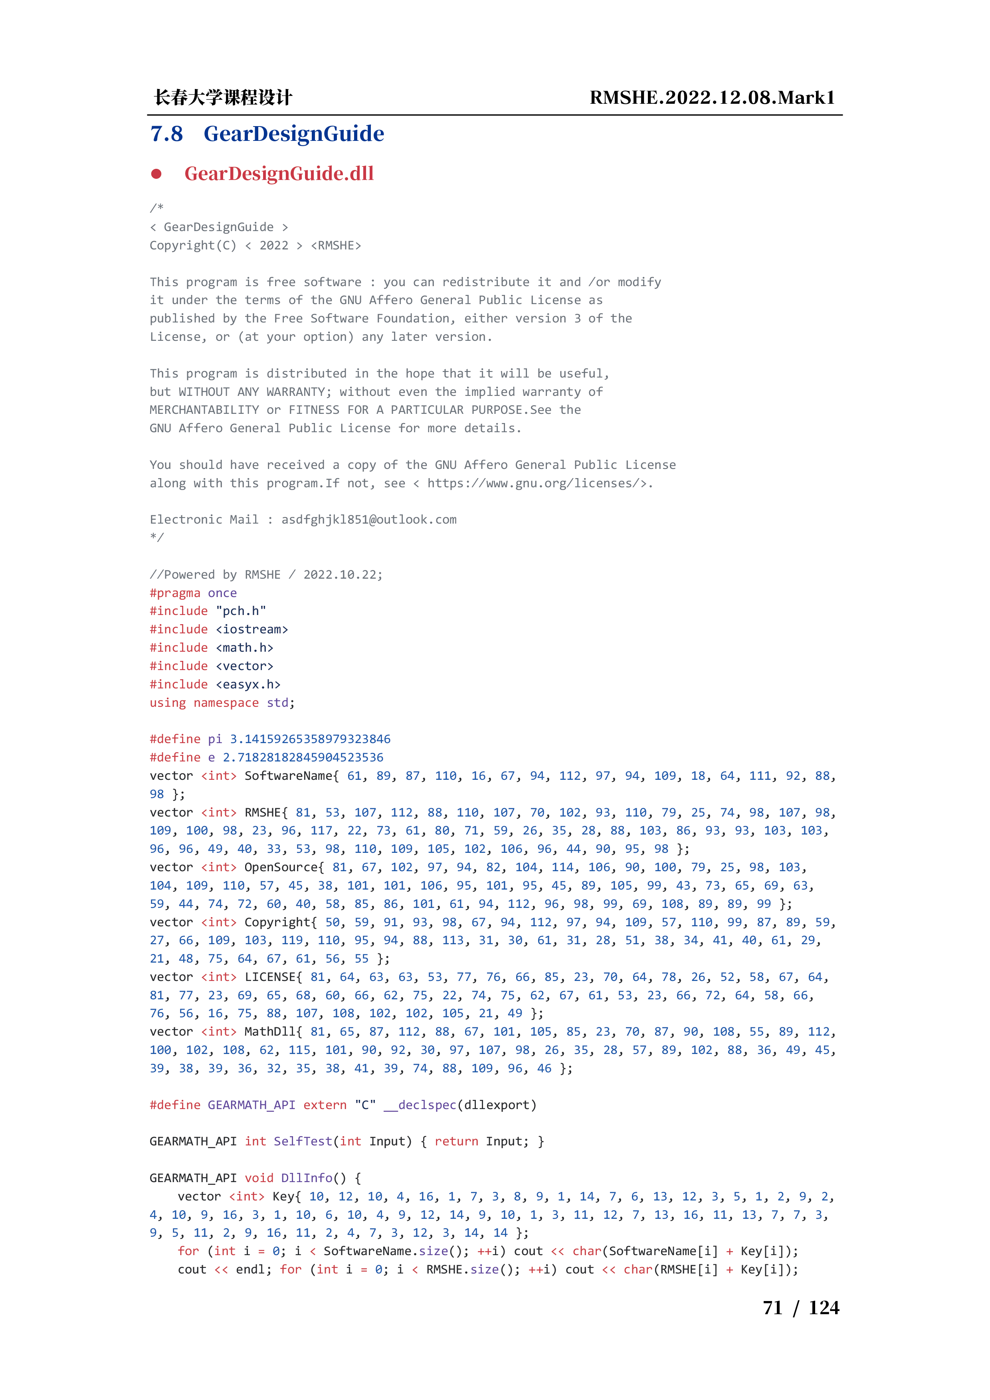
[picture p75: instruction/75.png]
instr

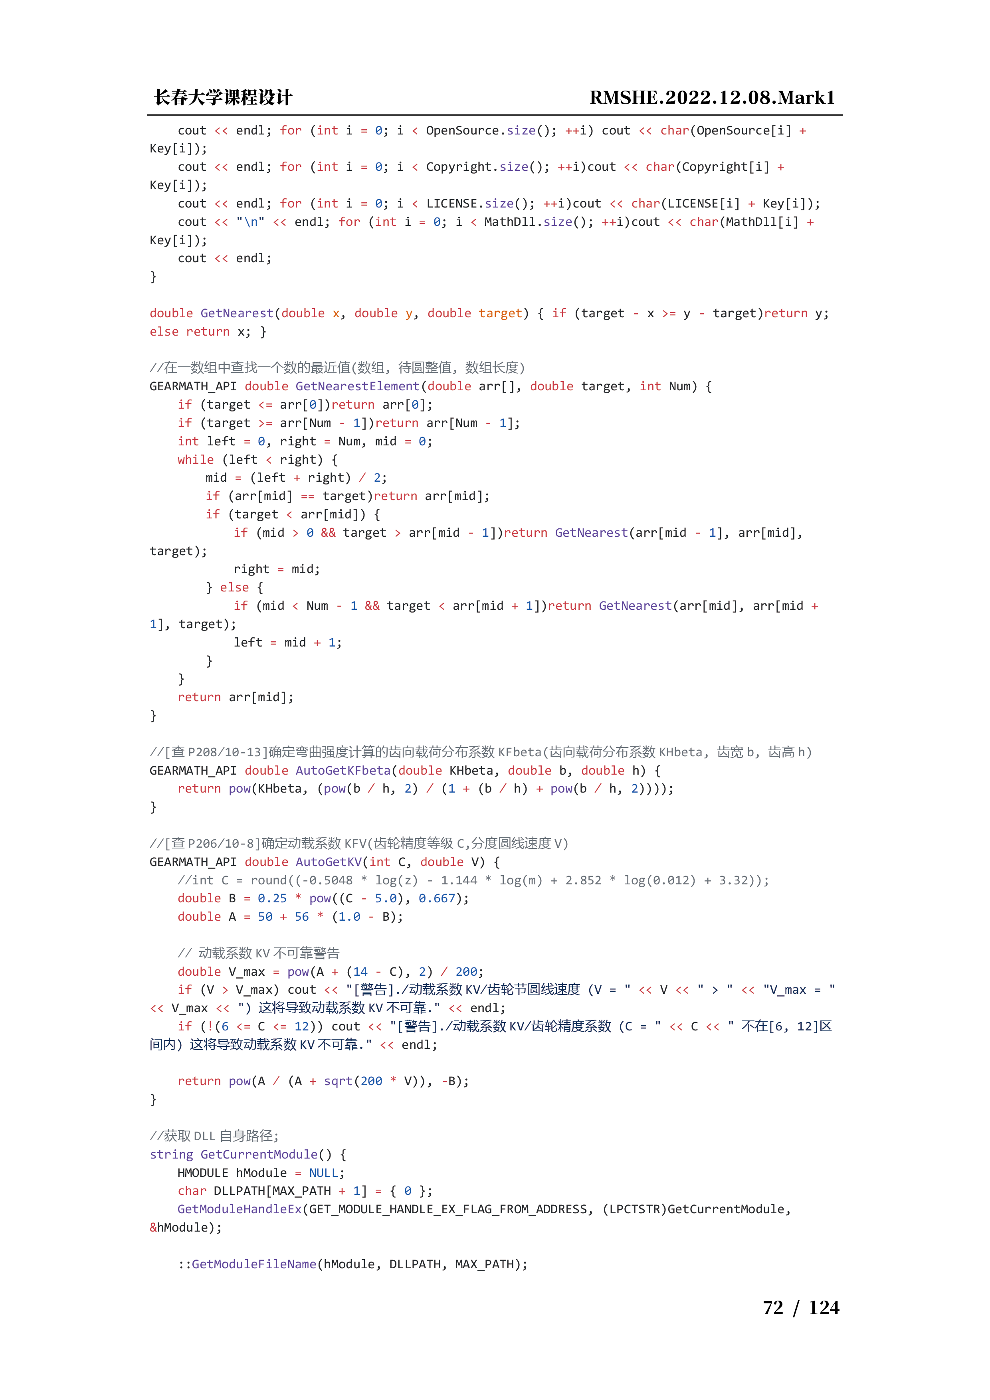
[picture p76: instruction/76.png]
instr

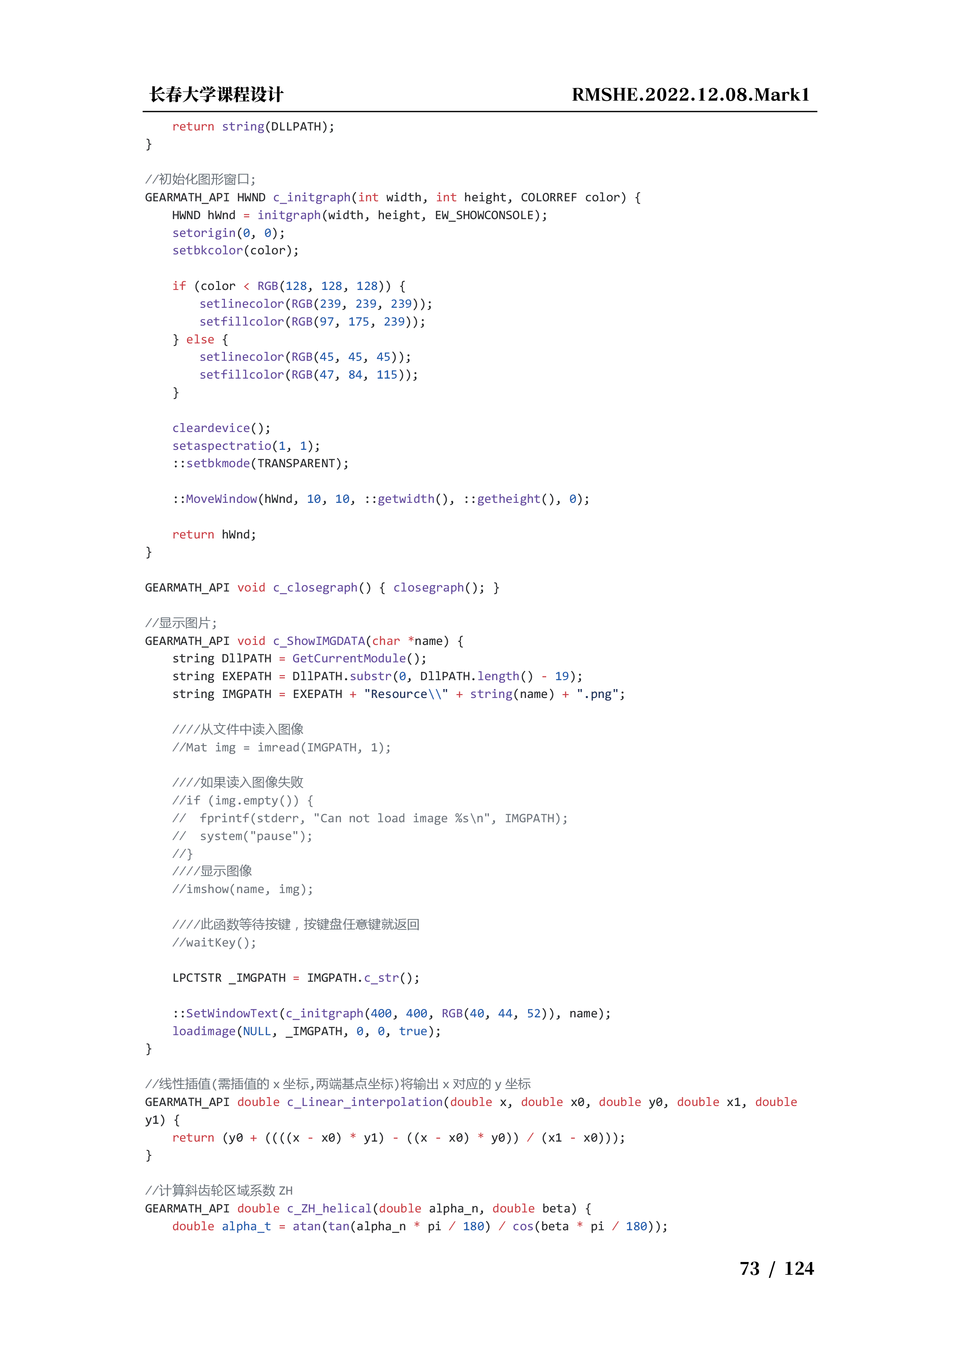
[picture p77: instruction/77.png]
instr

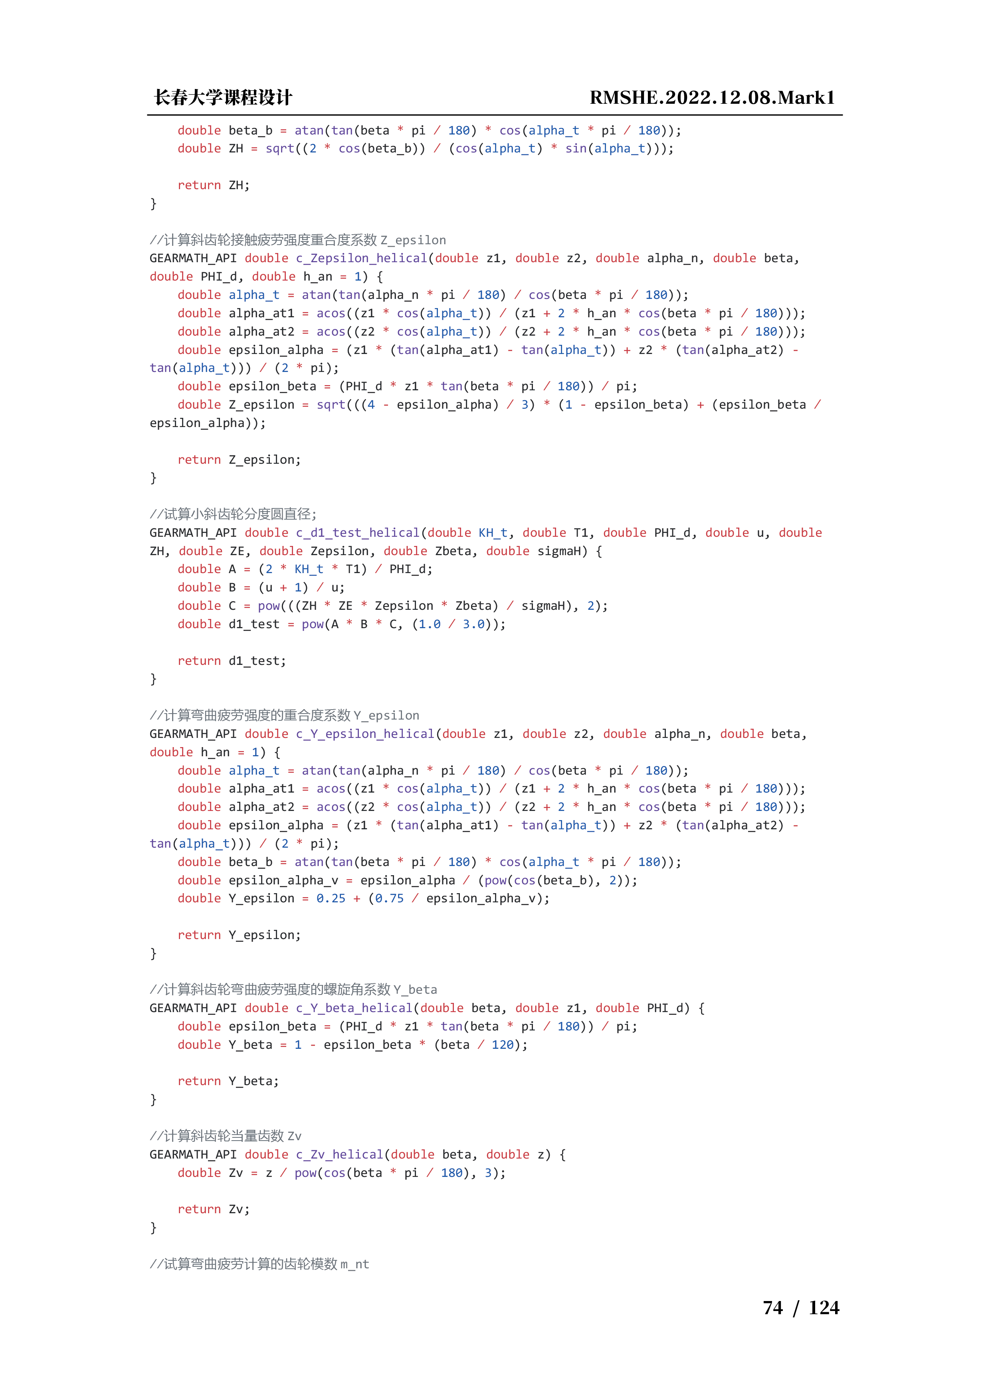
[picture p78: instruction/78.png]
instr

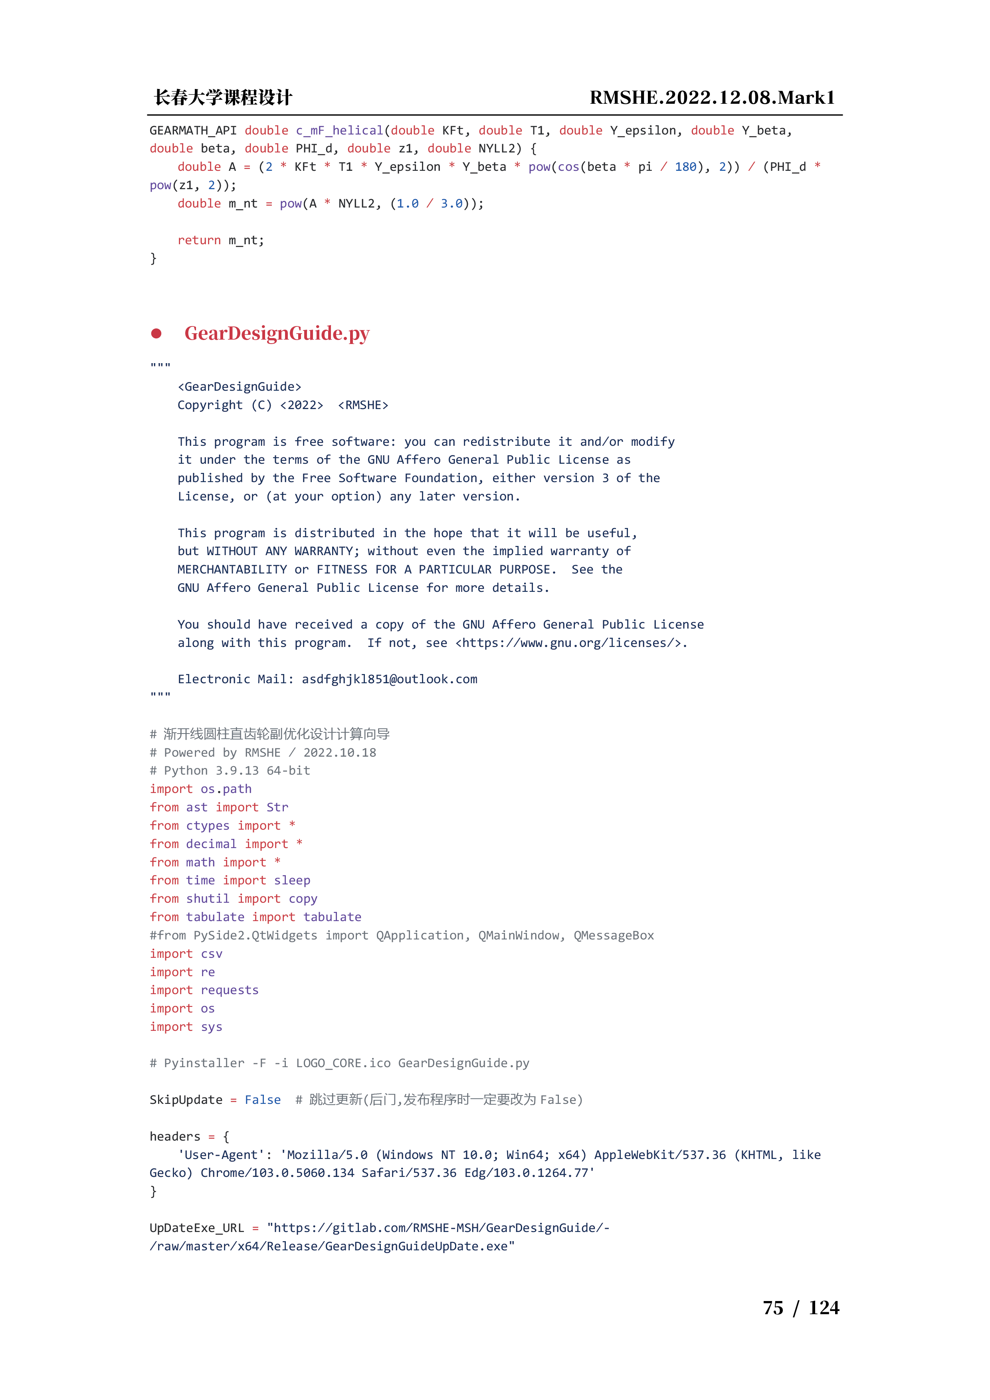
[picture p79: instruction/79.png]
instr

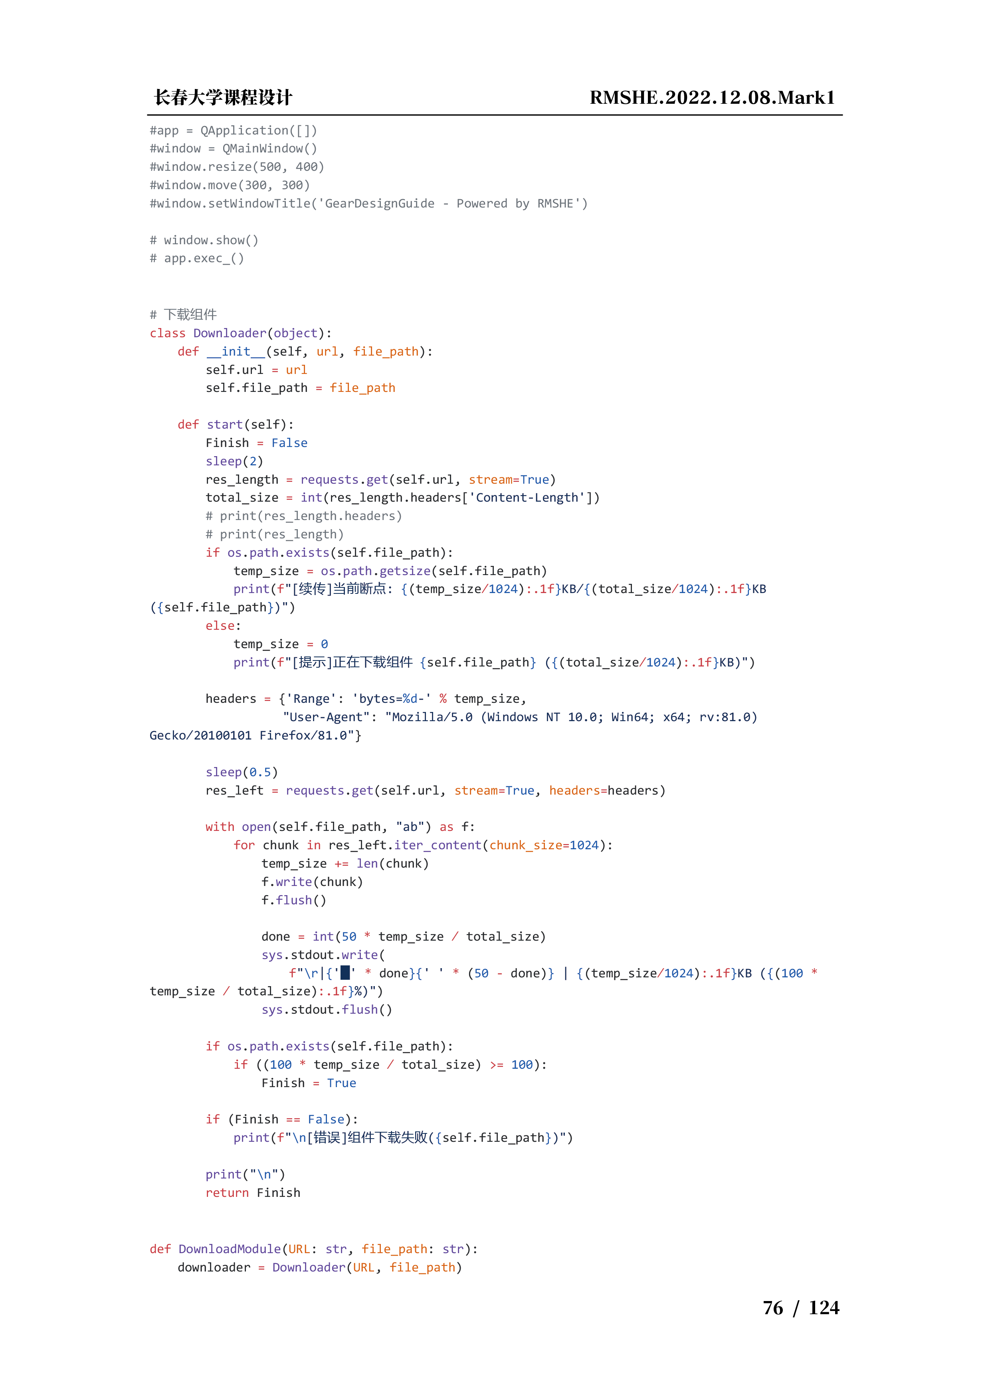
[picture p80: instruction/80.png]
instr

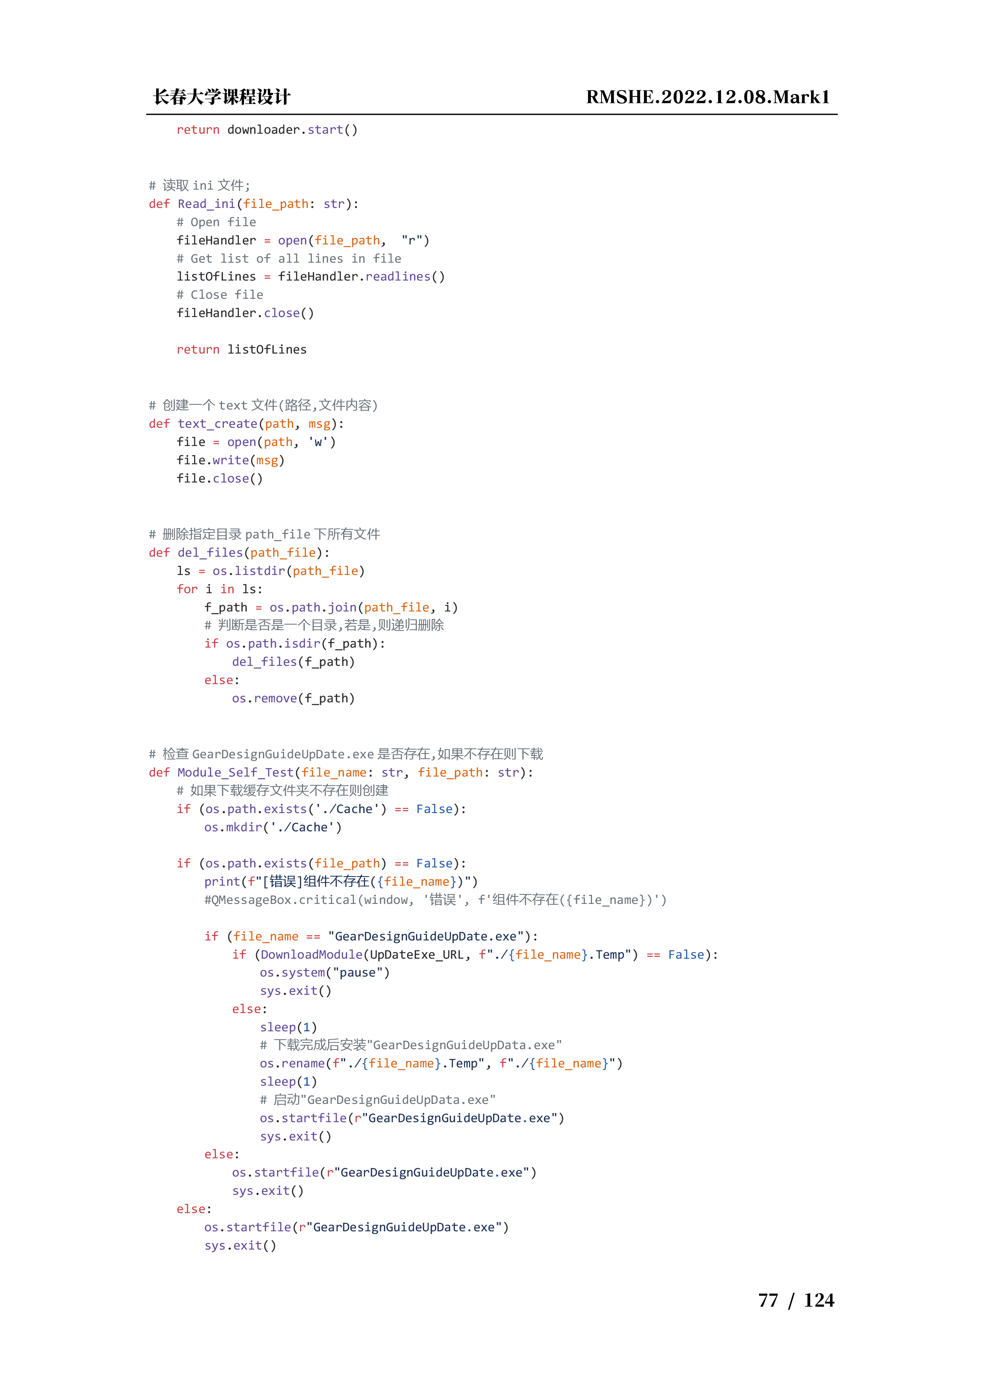
[picture p81: instruction/81.png]
instr

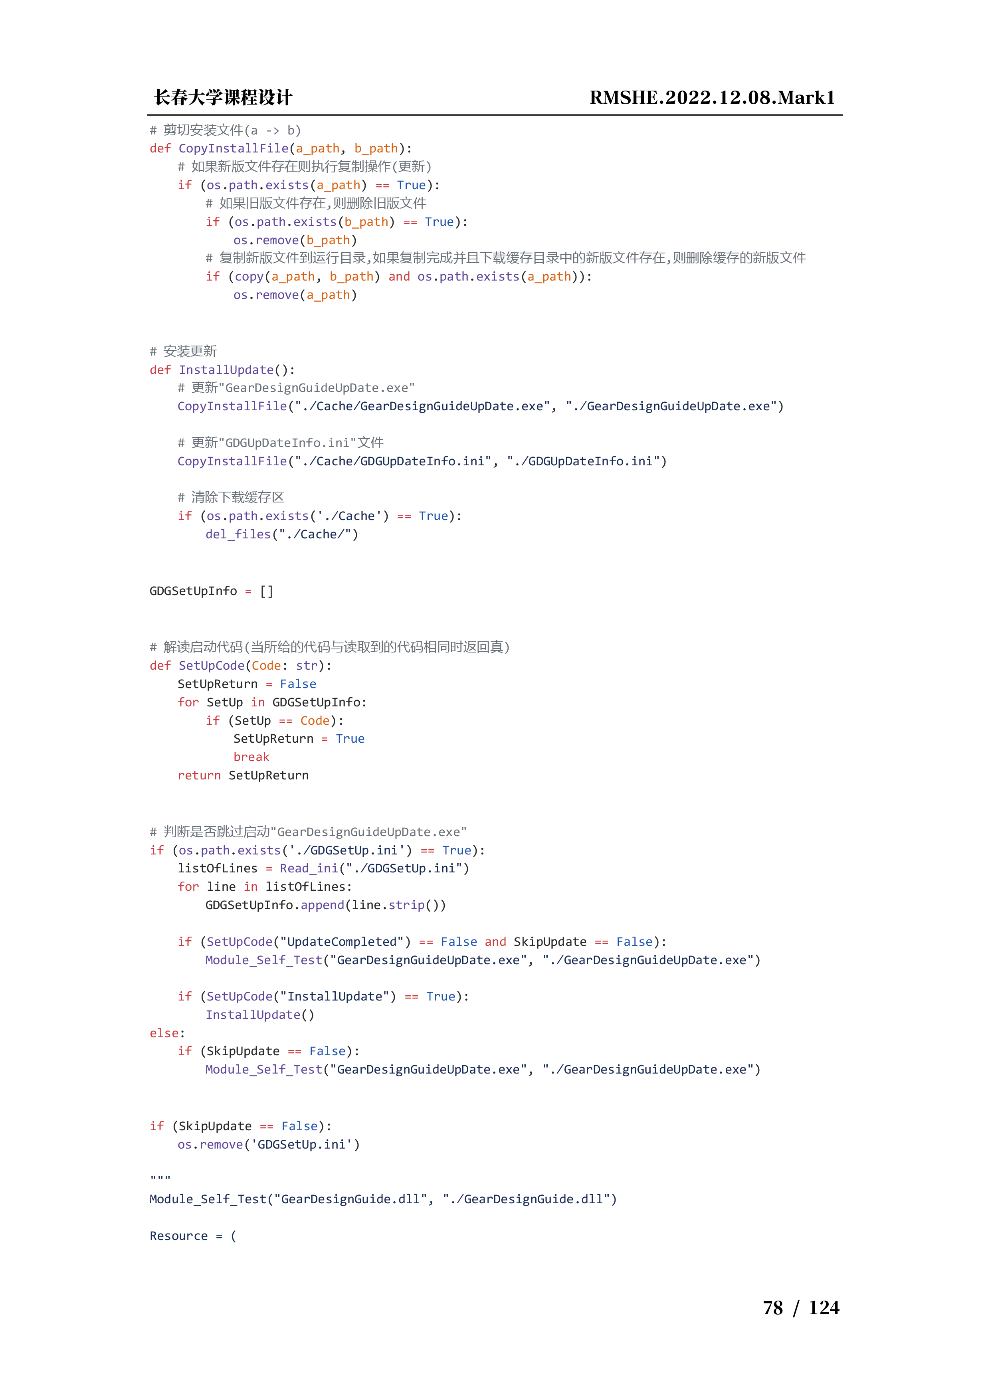
[picture p82: instruction/82.png]
instr

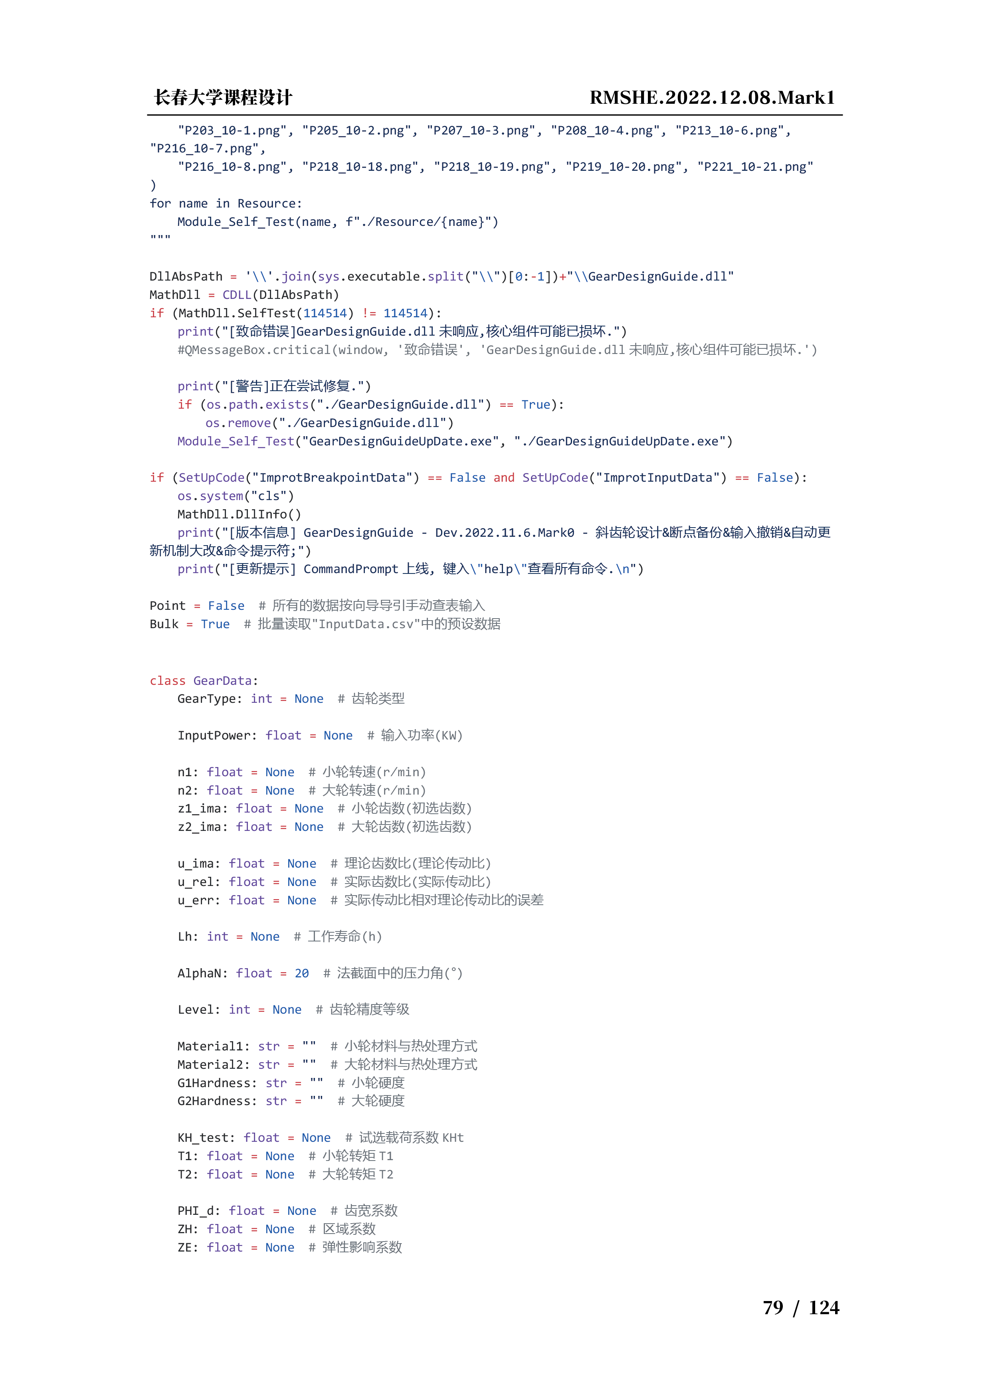
[picture p83: instruction/83.png]
instr

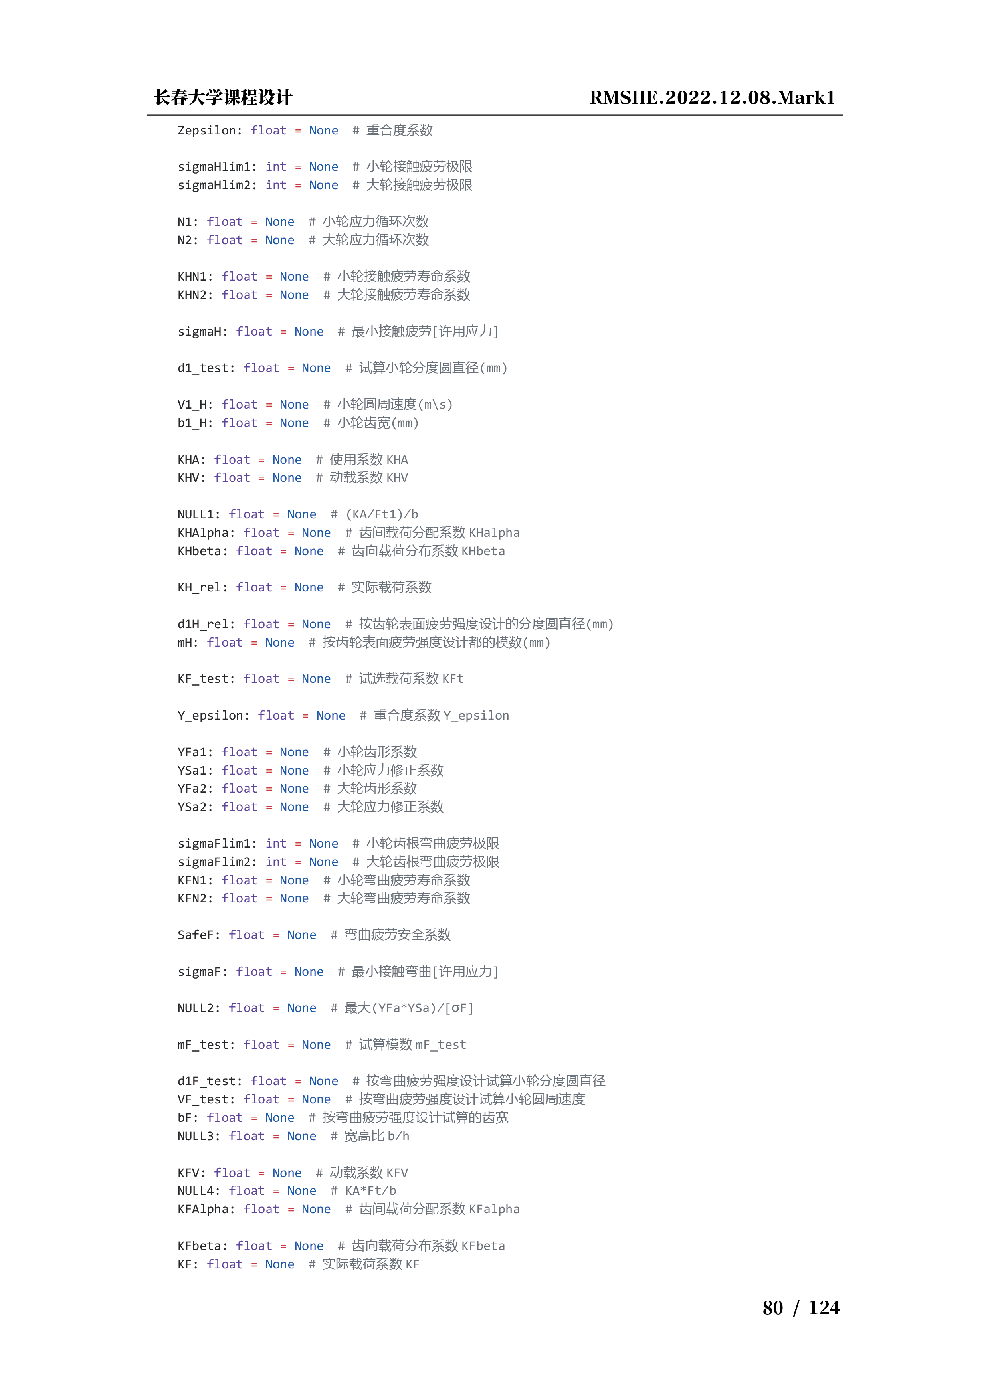
[picture p84: instruction/84.png]
instr

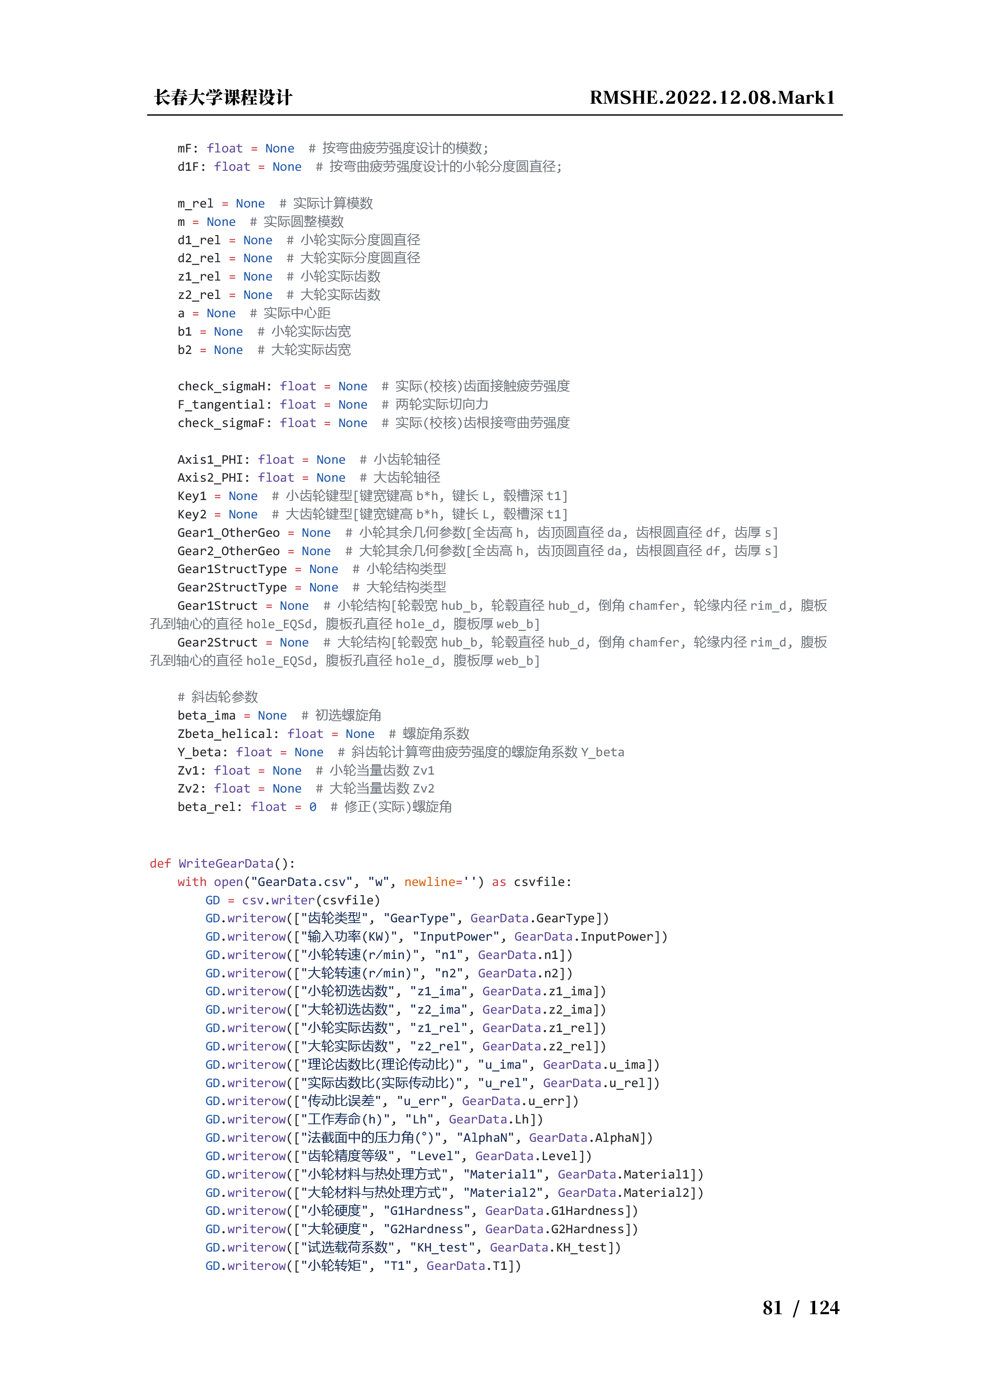
[picture p85: instruction/85.png]
instr

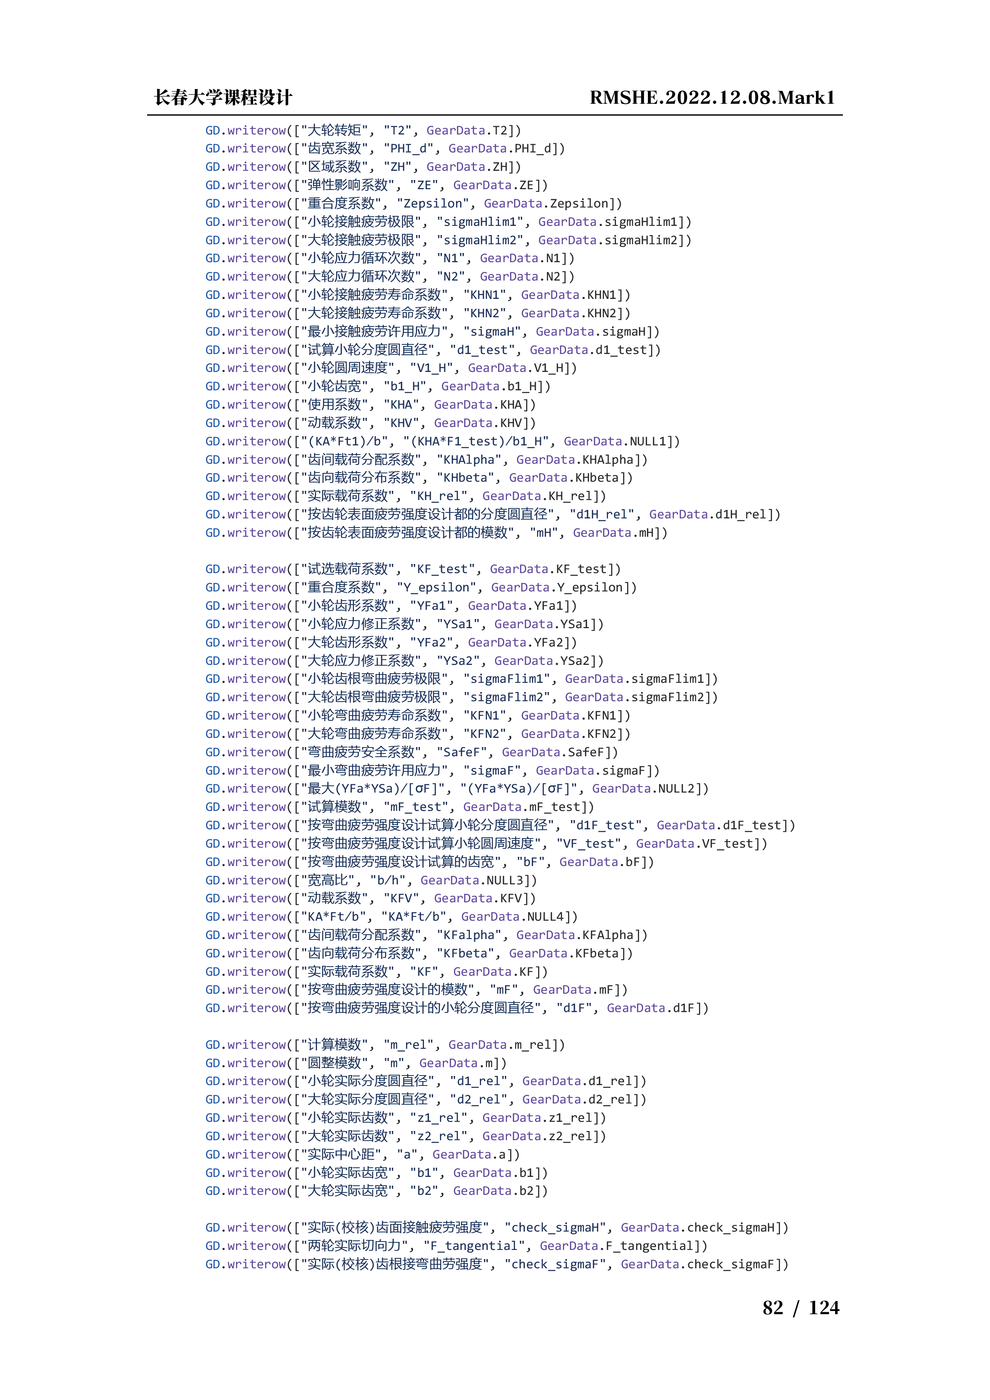
[picture p86: instruction/86.png]
instr

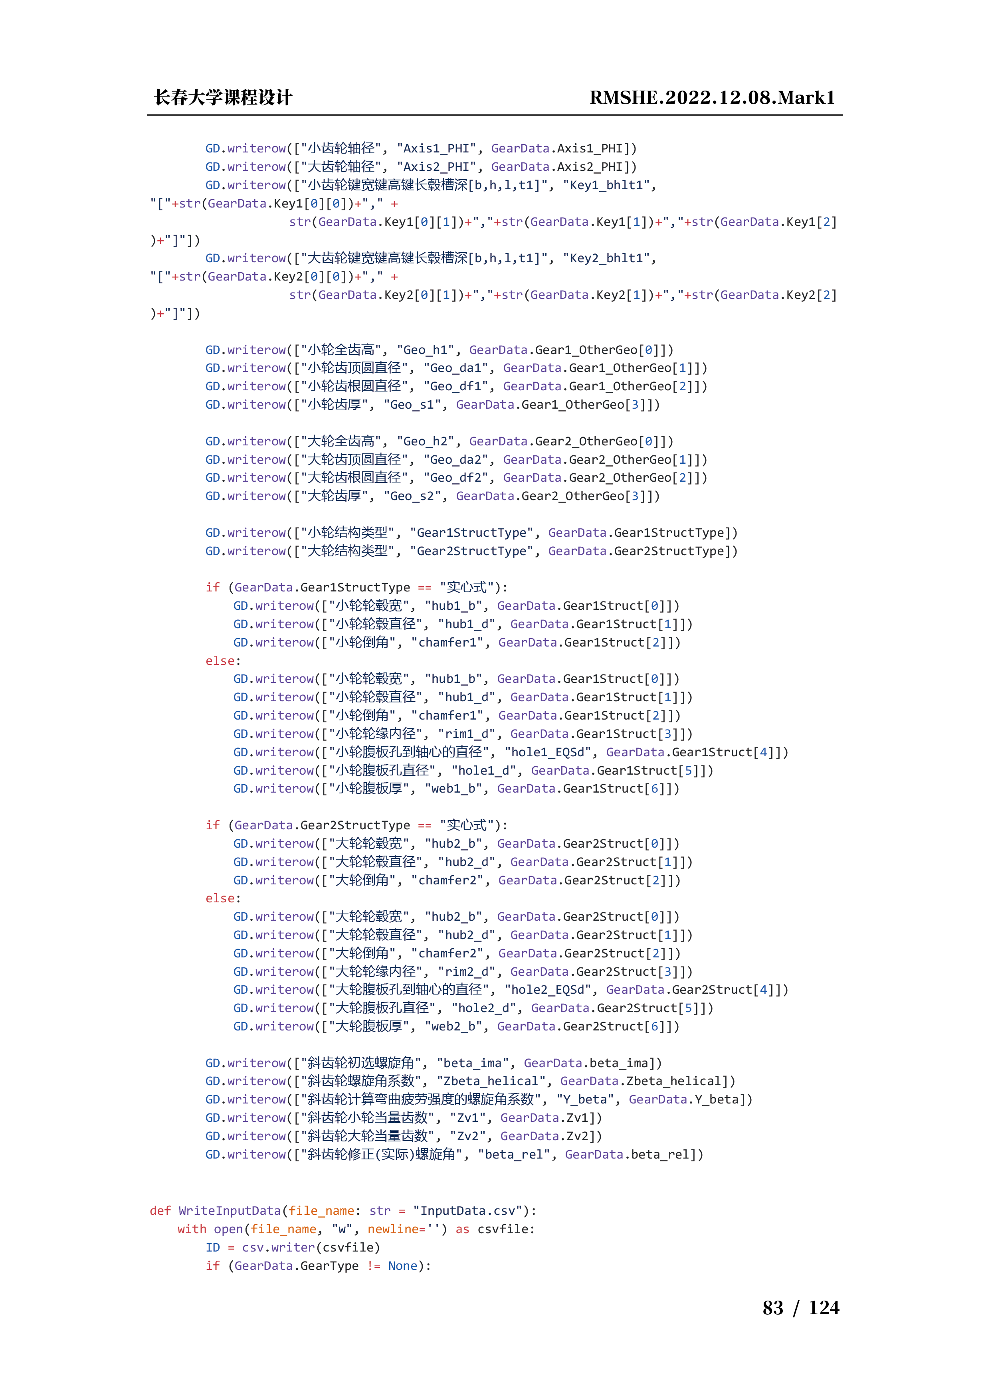
[picture p87: instruction/87.png]
instr

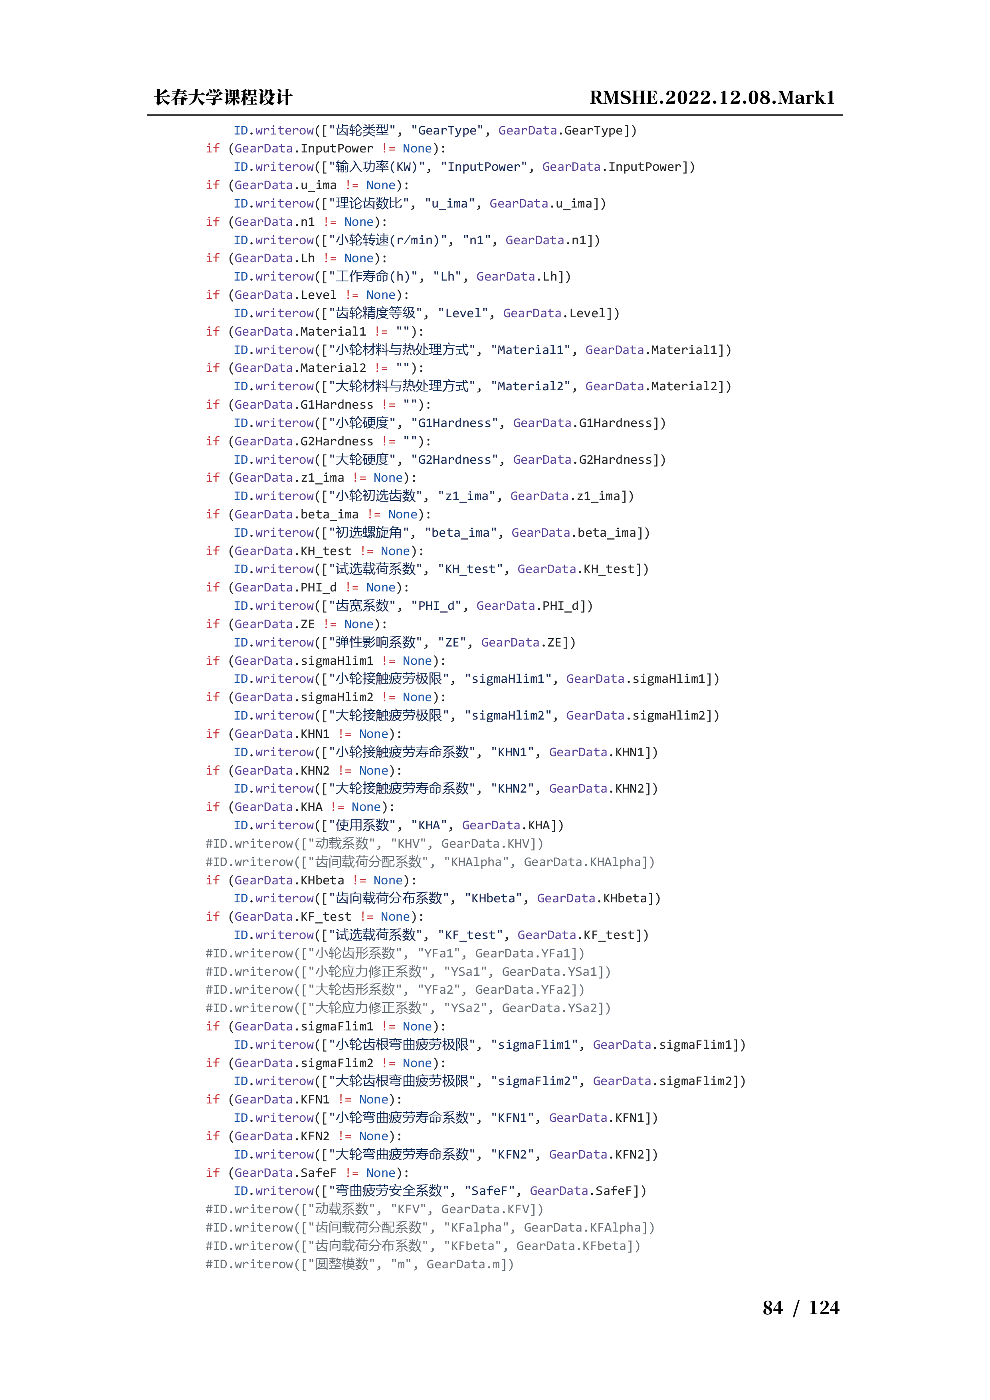
[picture p88: instruction/88.png]
instr

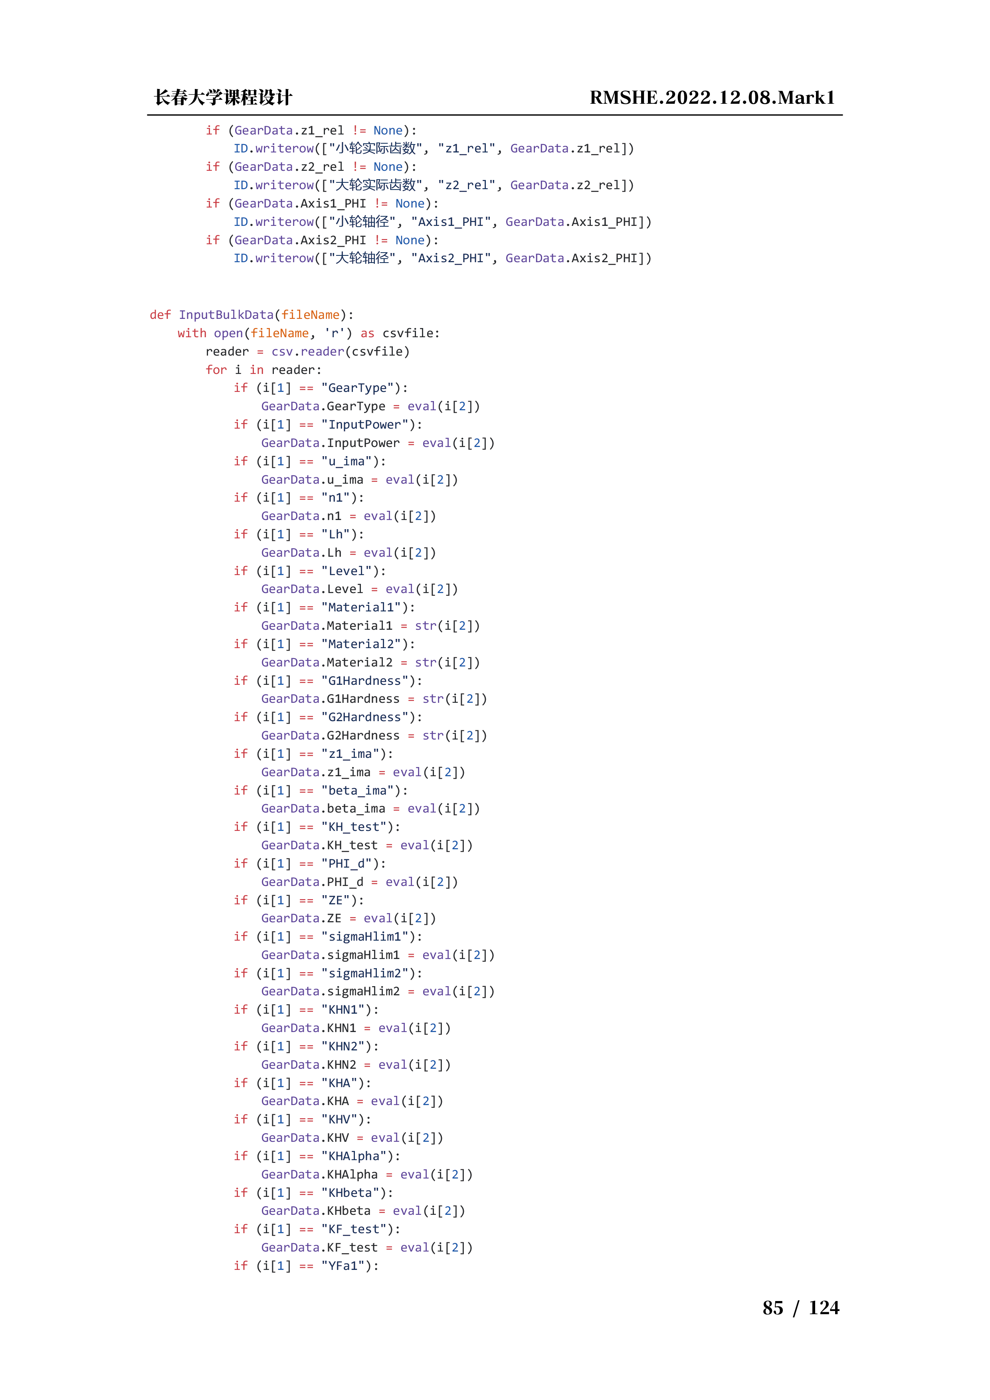
[picture p89: instruction/89.png]
instr

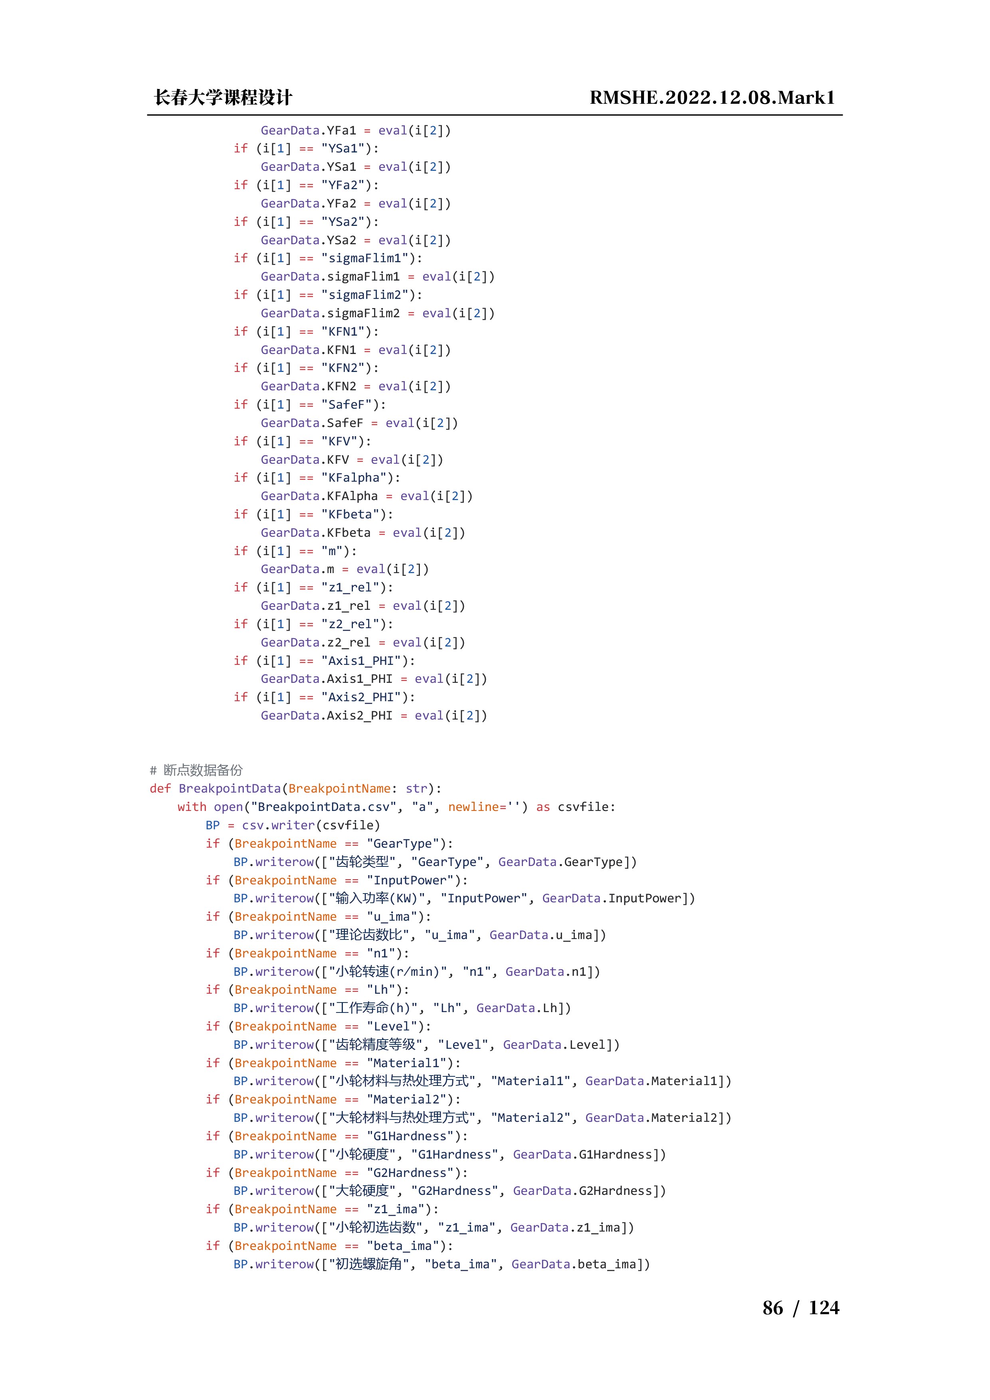
[picture p90: instruction/90.png]
instr

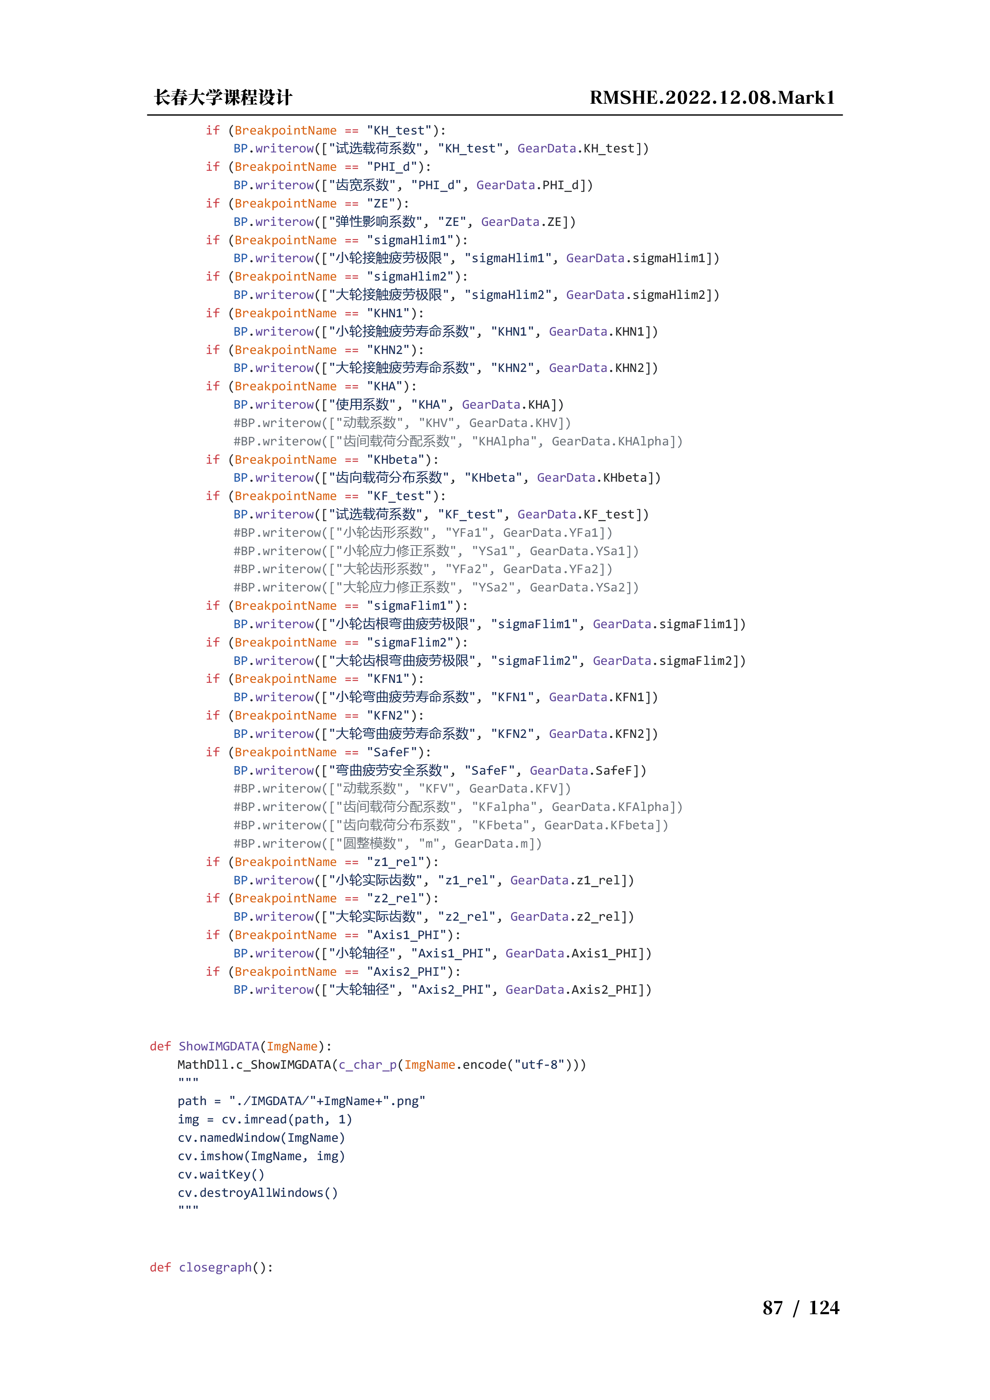
[picture p91: instruction/91.png]
instr

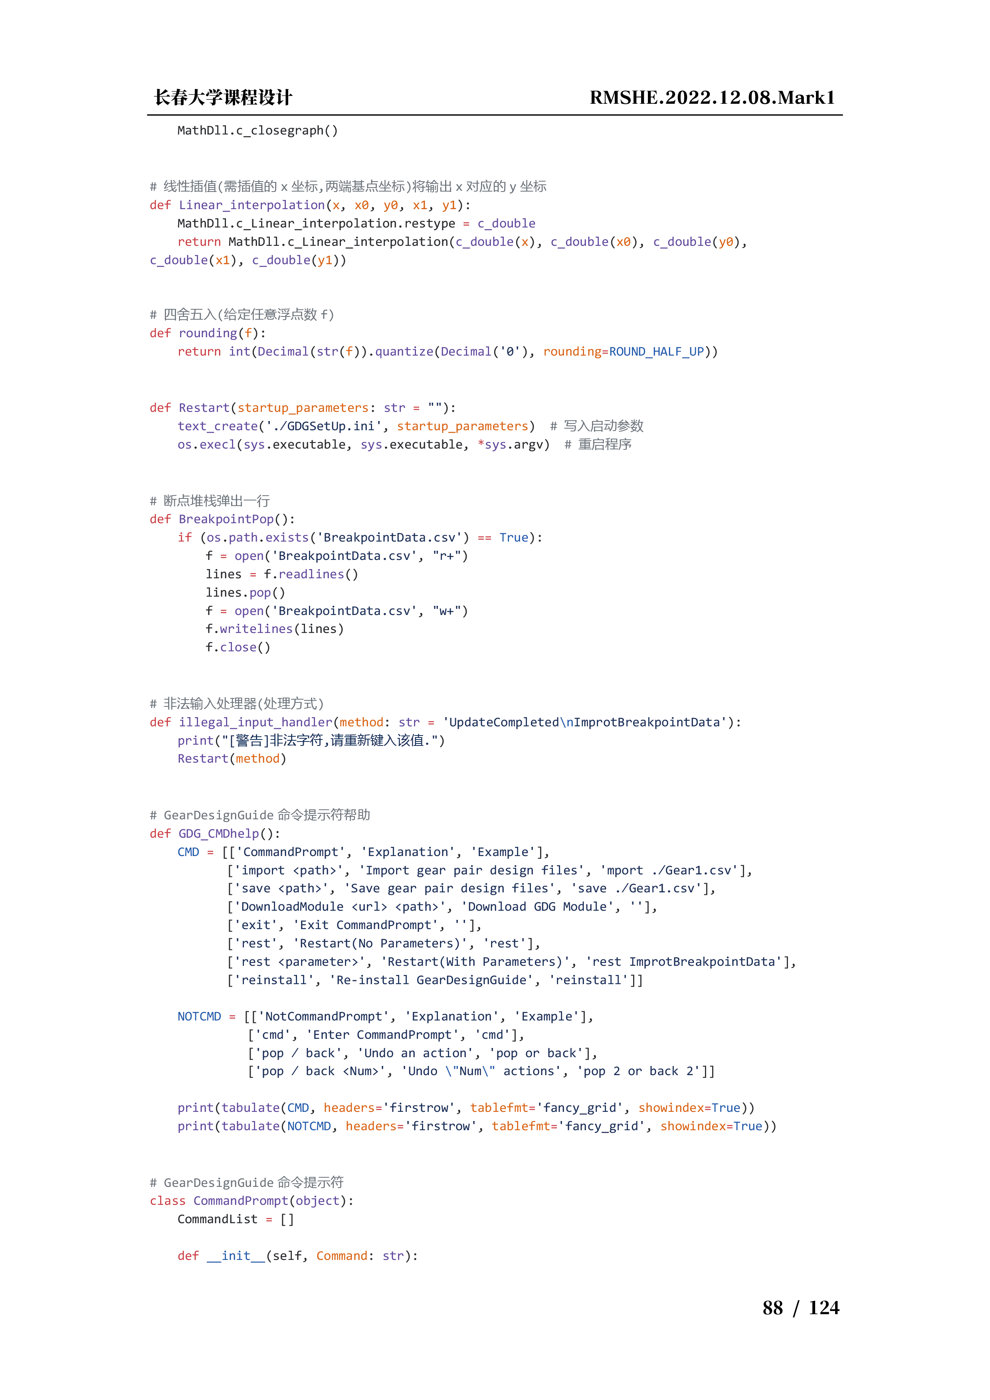
[picture p92: instruction/92.png]
instr

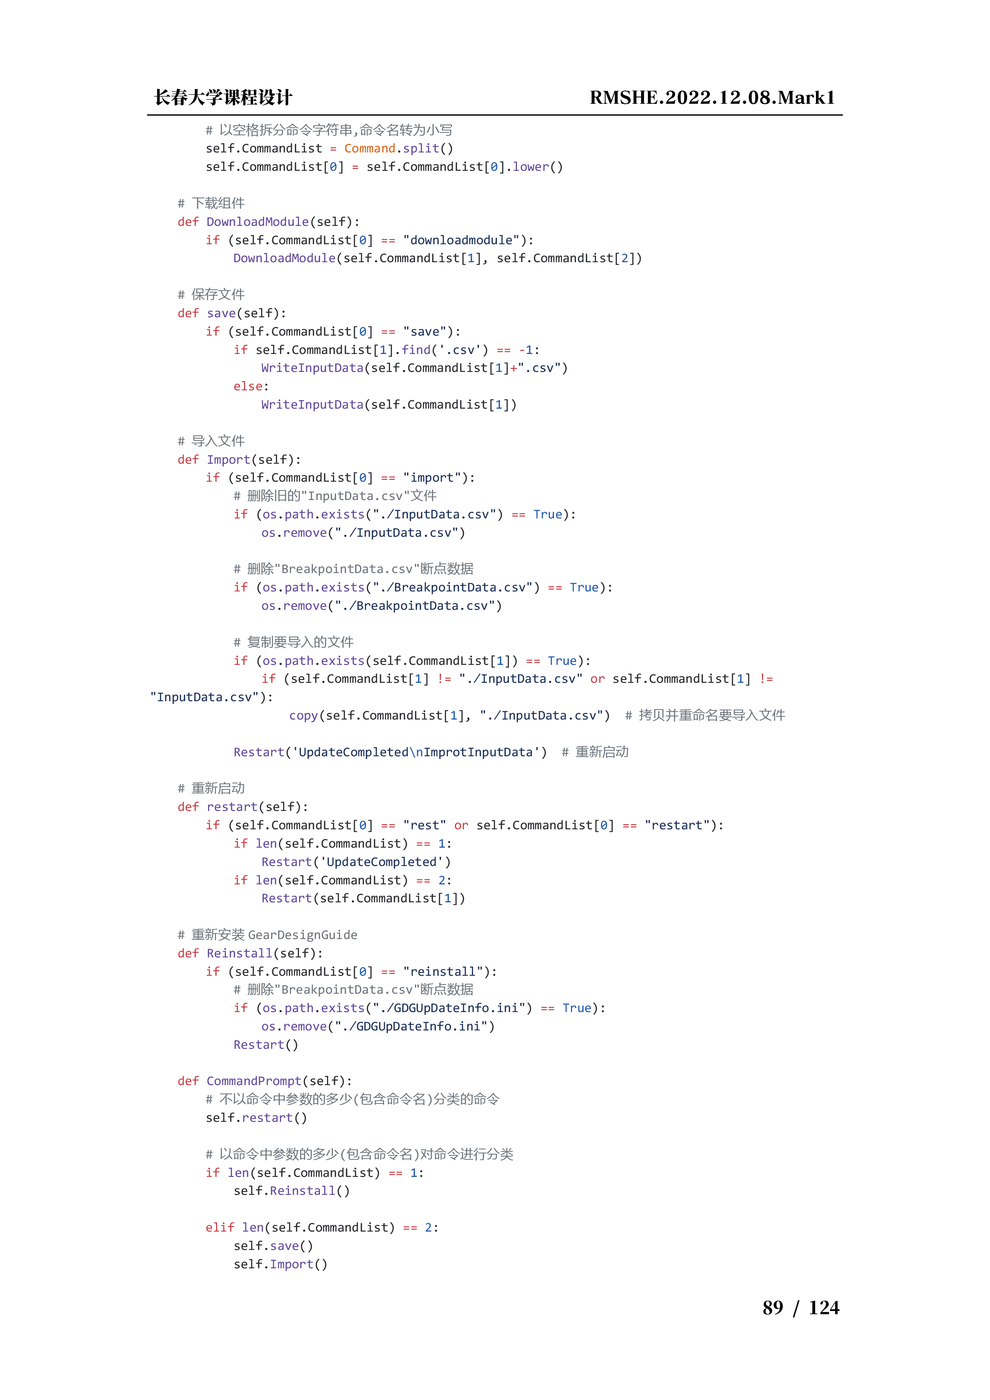
[picture p93: instruction/93.png]
instr

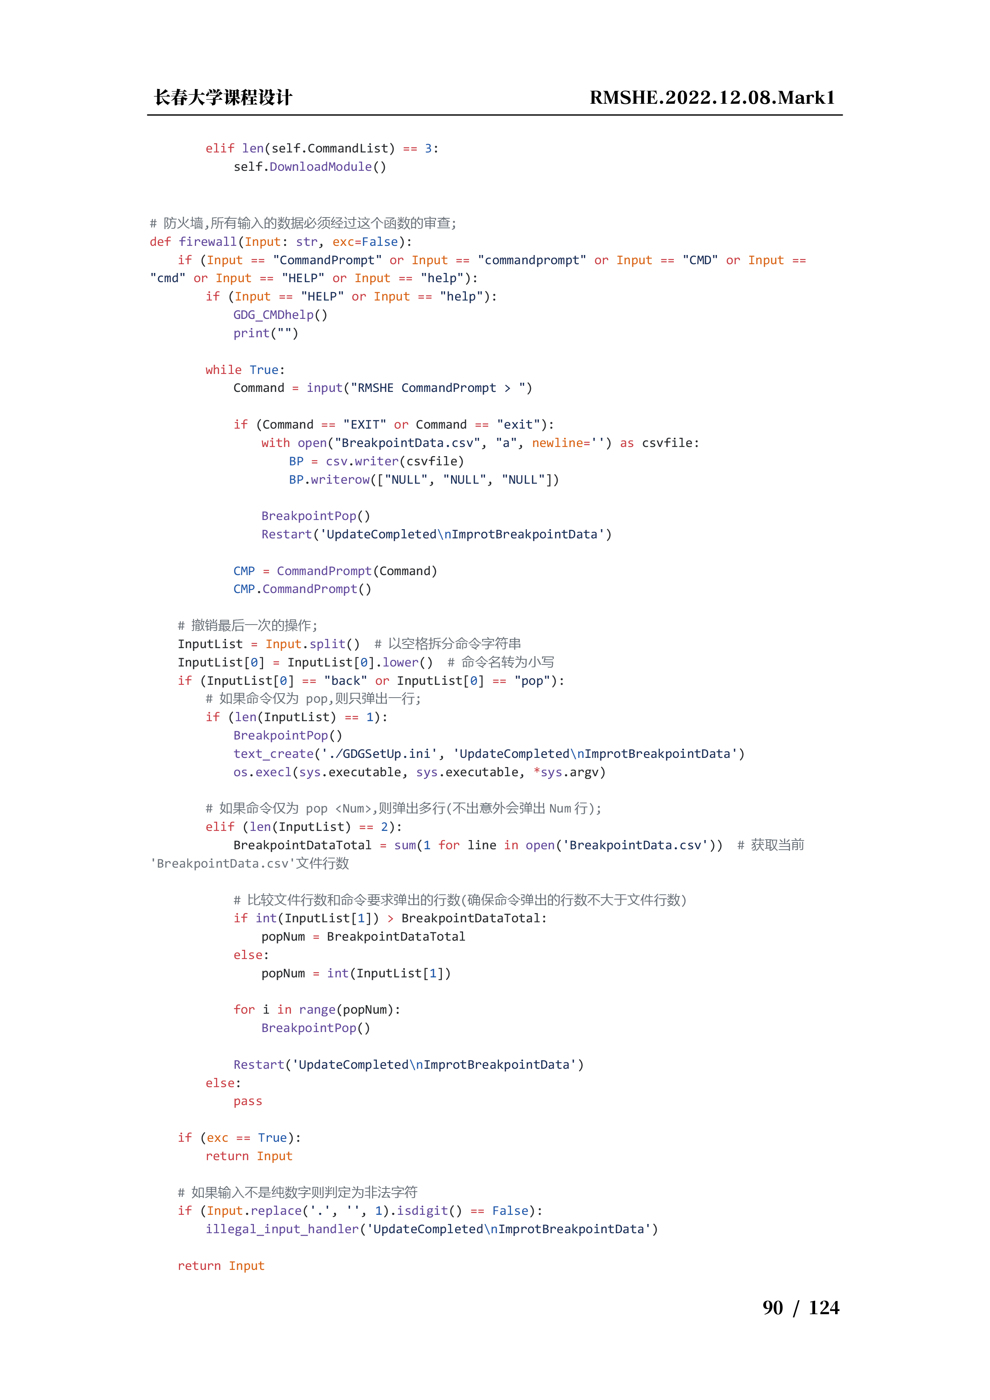
[picture p94: instruction/94.png]
instr

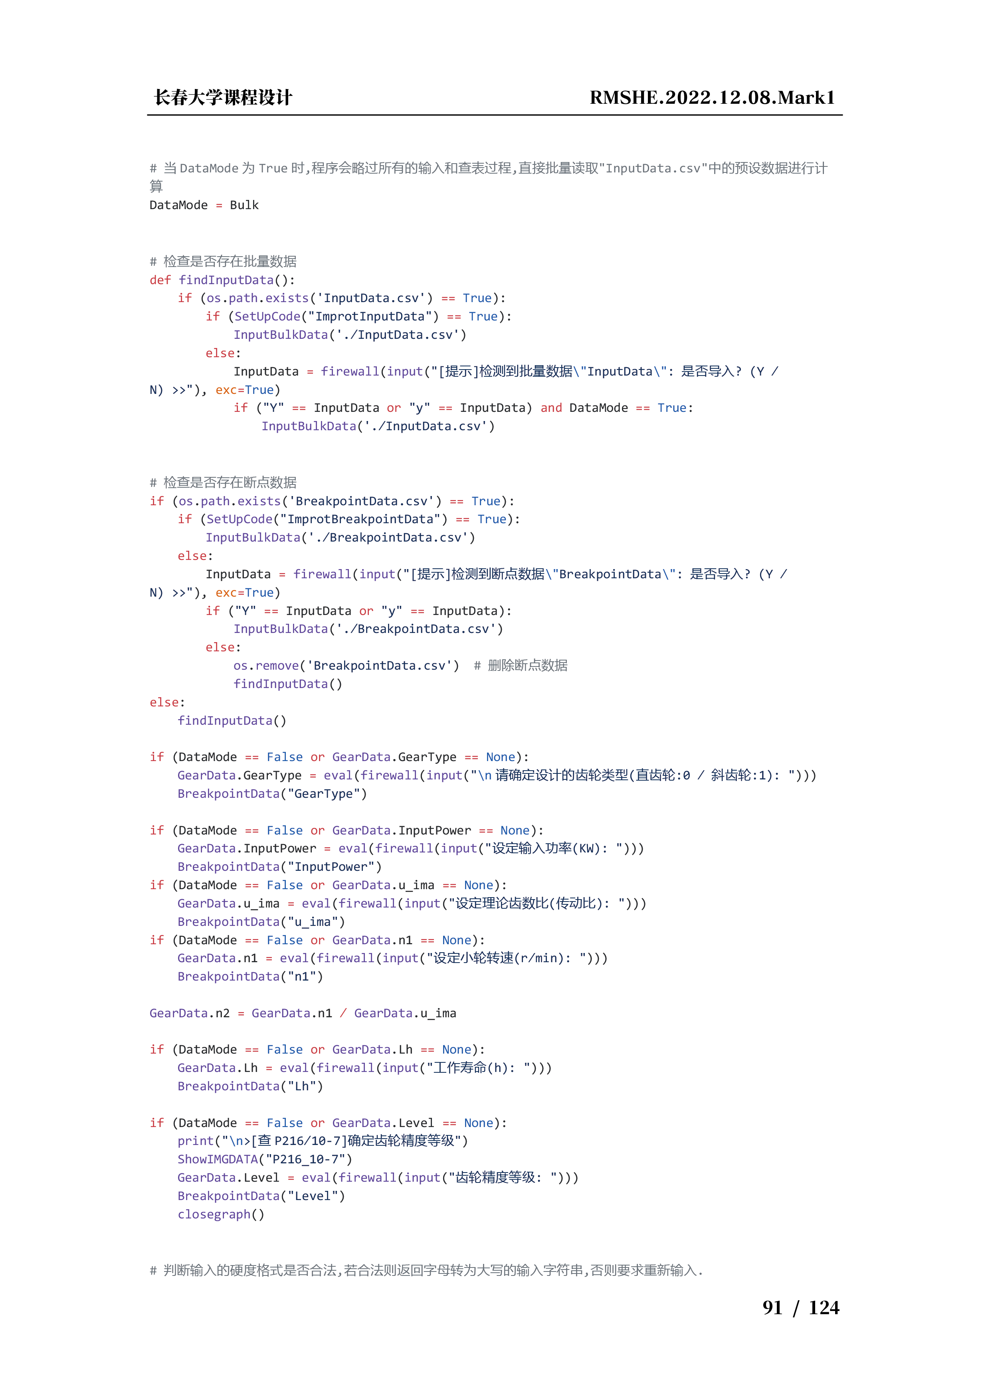
[picture p95: instruction/95.png]
instr

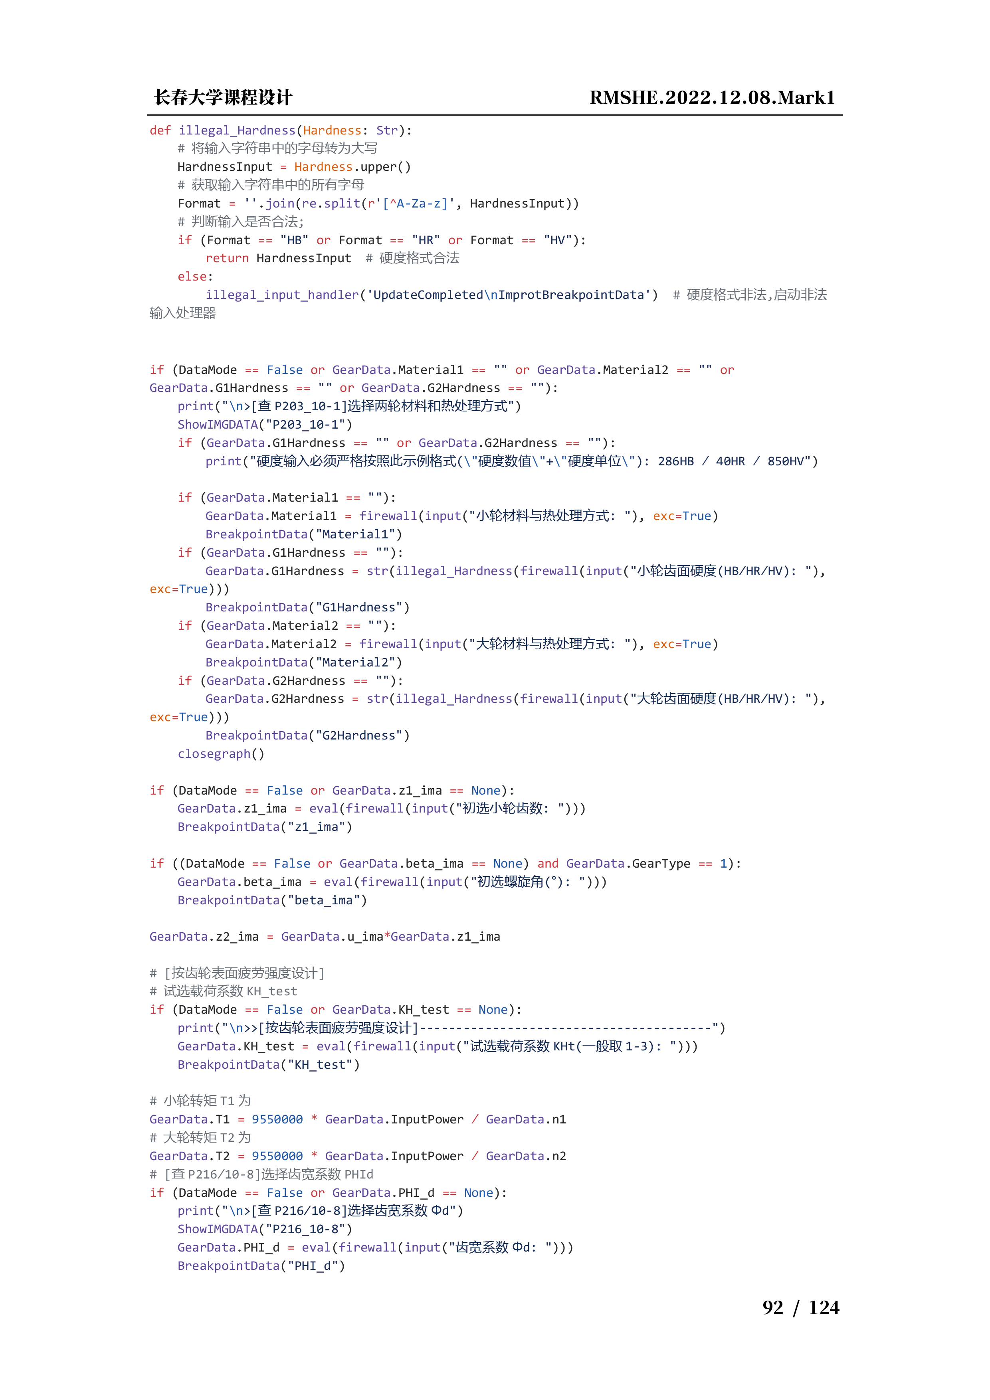
[picture p96: instruction/96.png]
instr

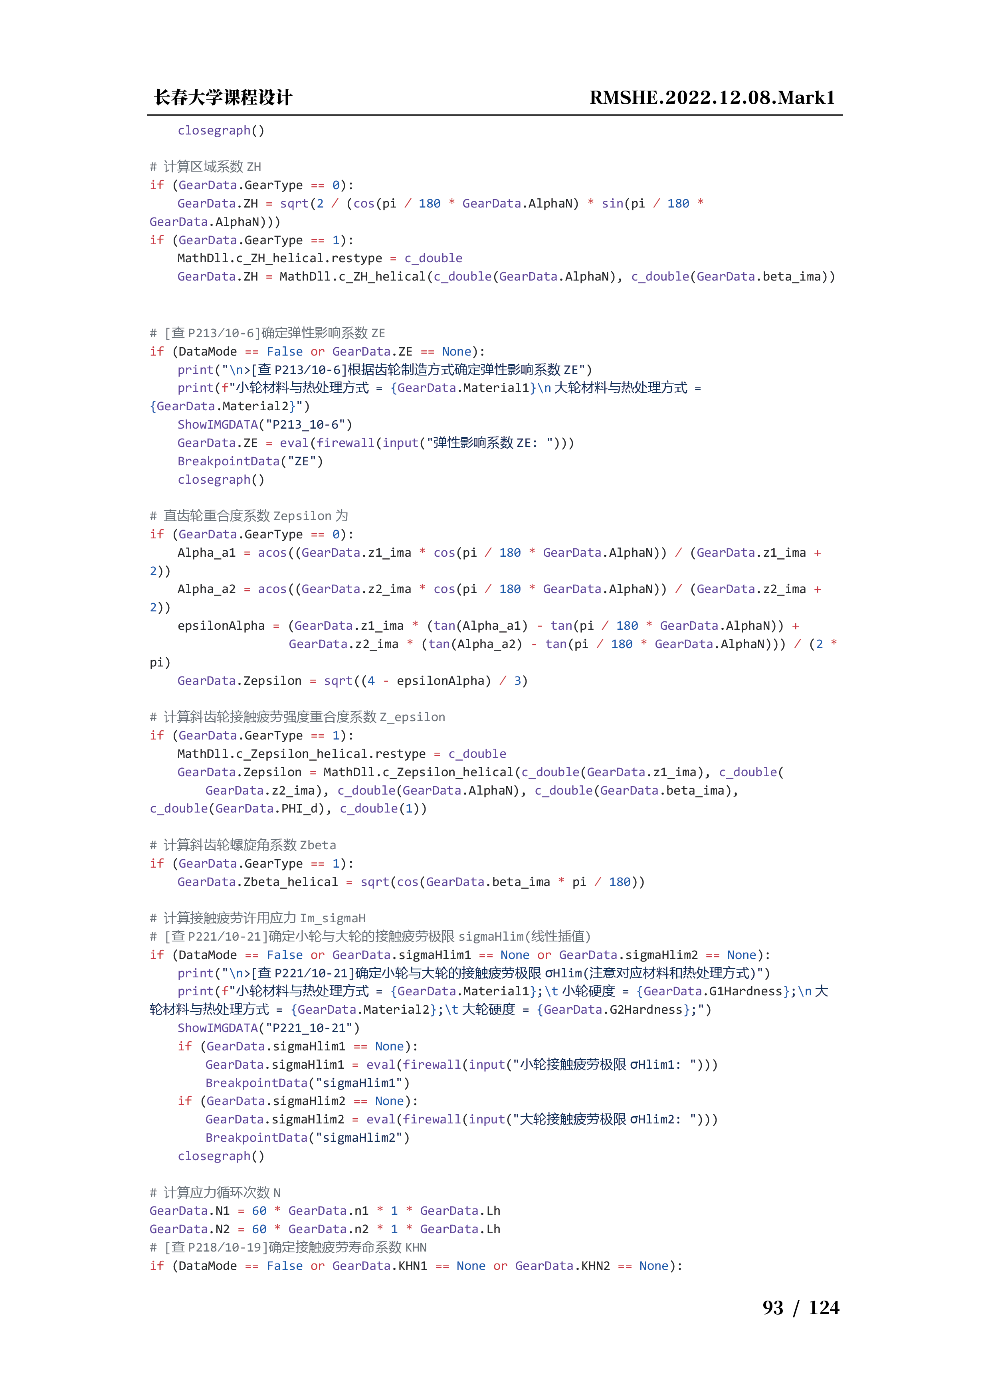
[picture p97: instruction/97.png]
instr

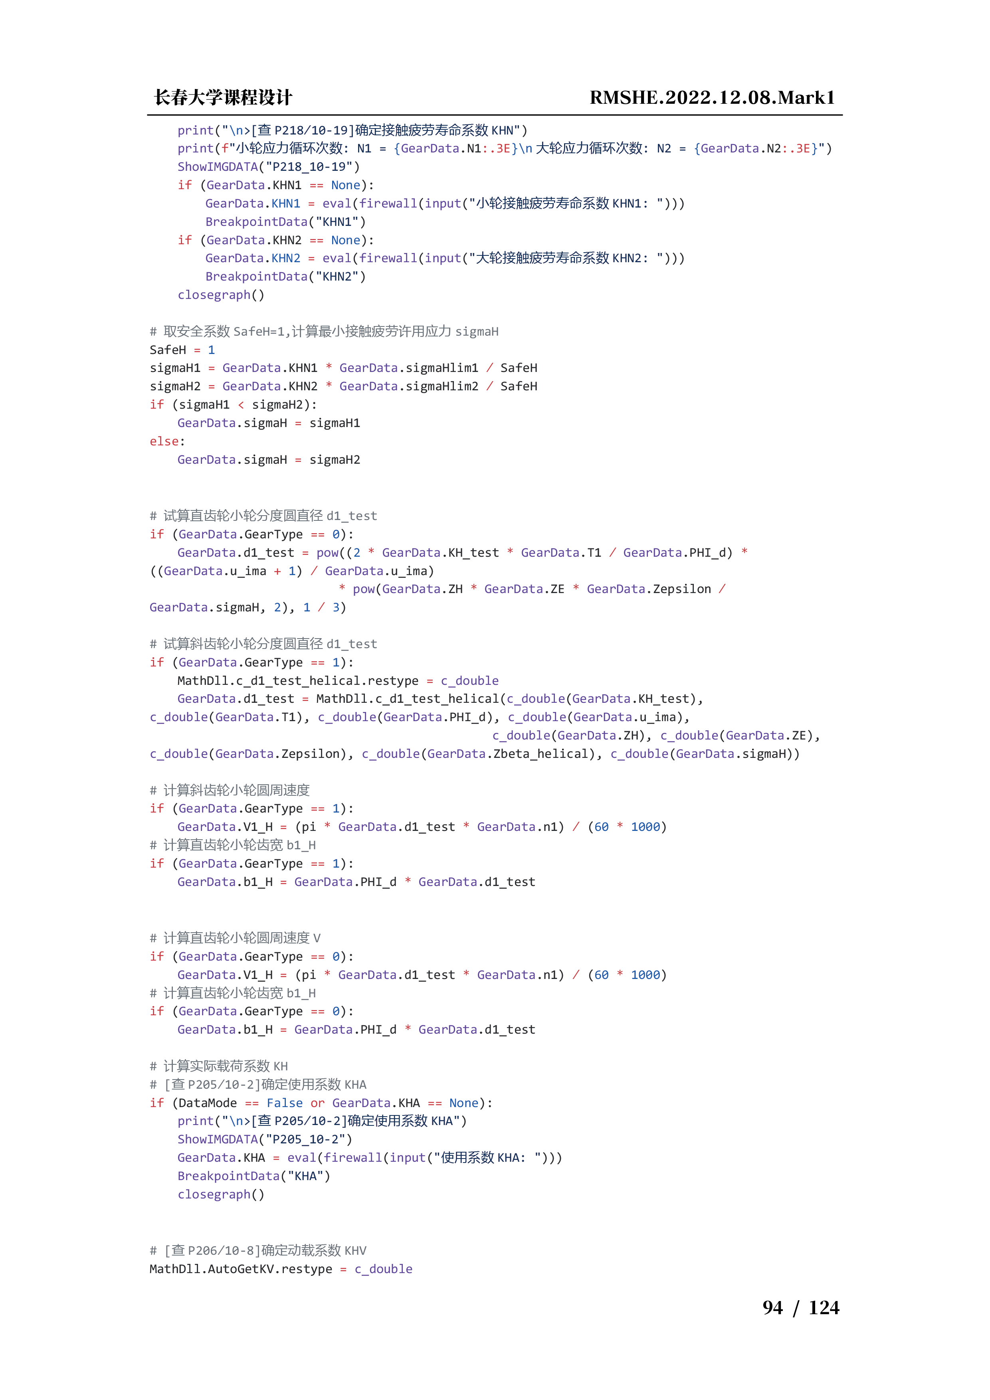
[picture p98: instruction/98.png]
instr

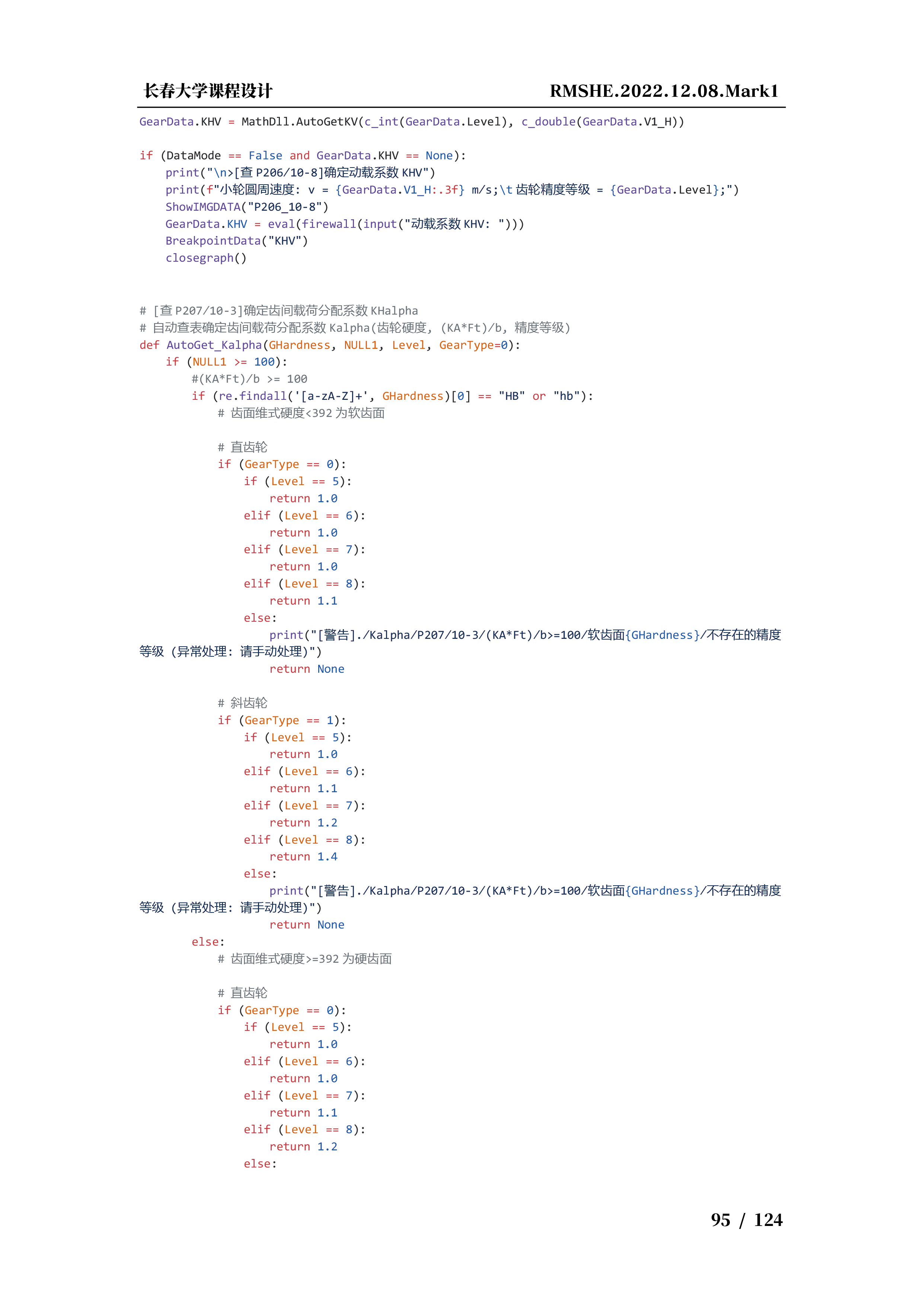
[picture p99: instruction/99.png]
instr

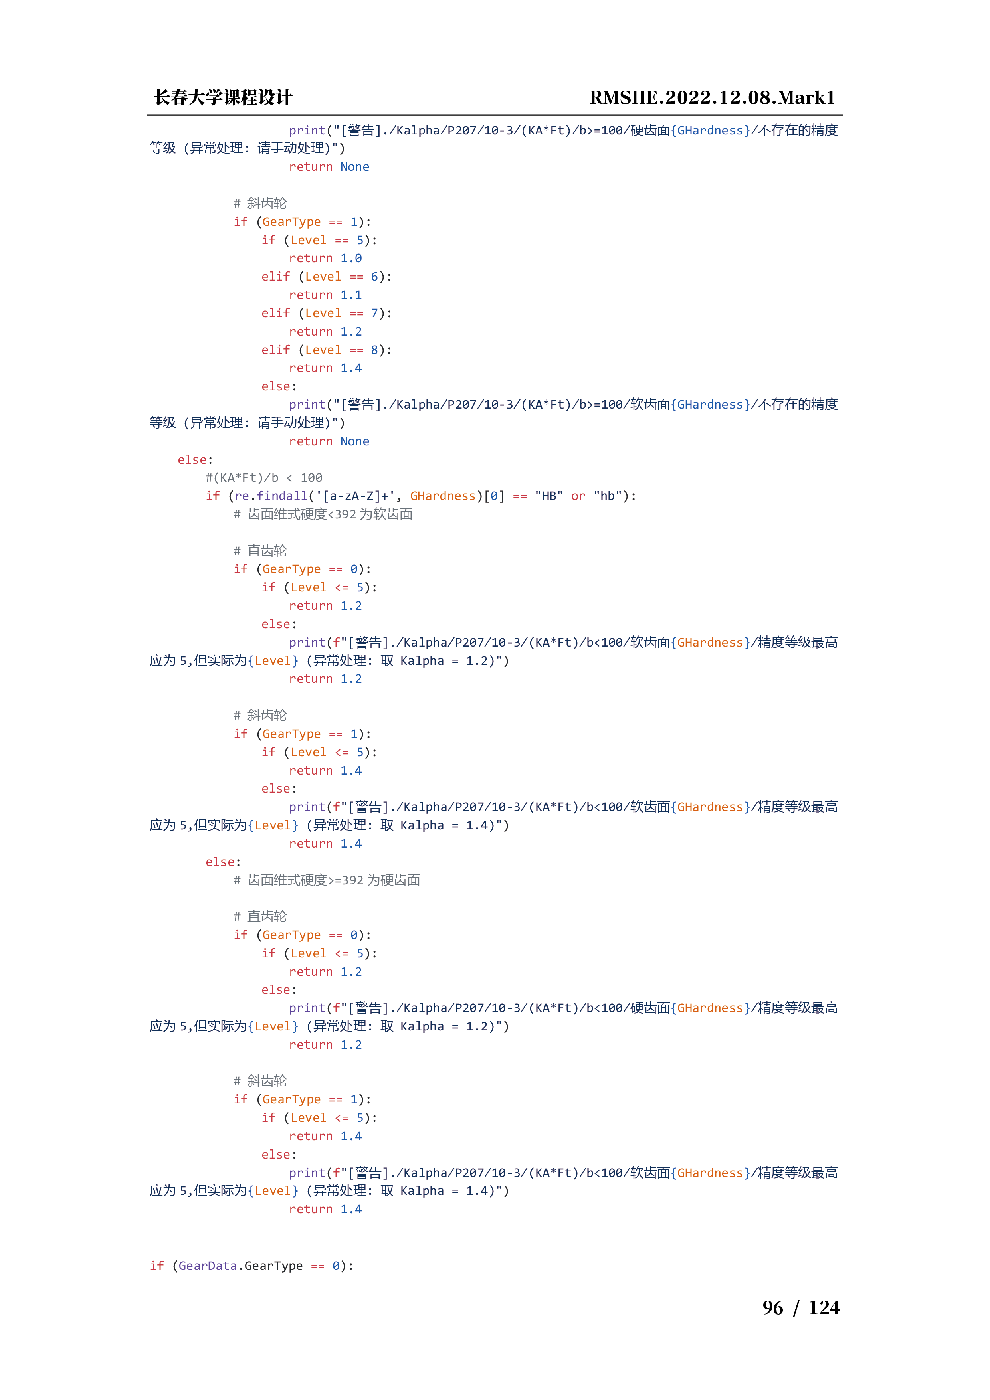
[picture p100: instruction/100.png]
instr

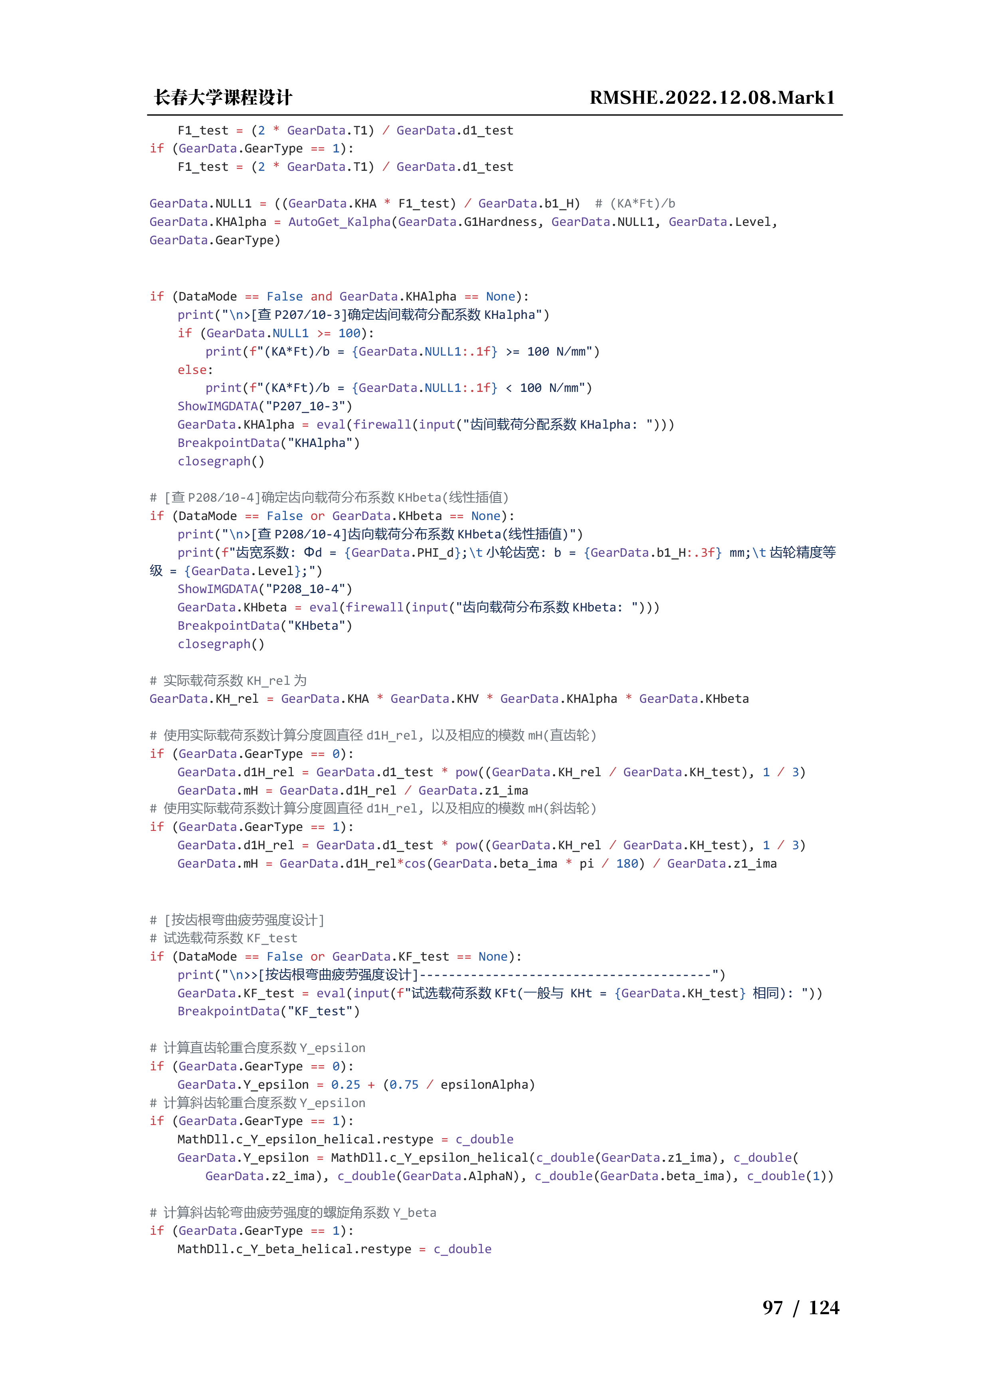
[picture p101: instruction/101.png]
instr

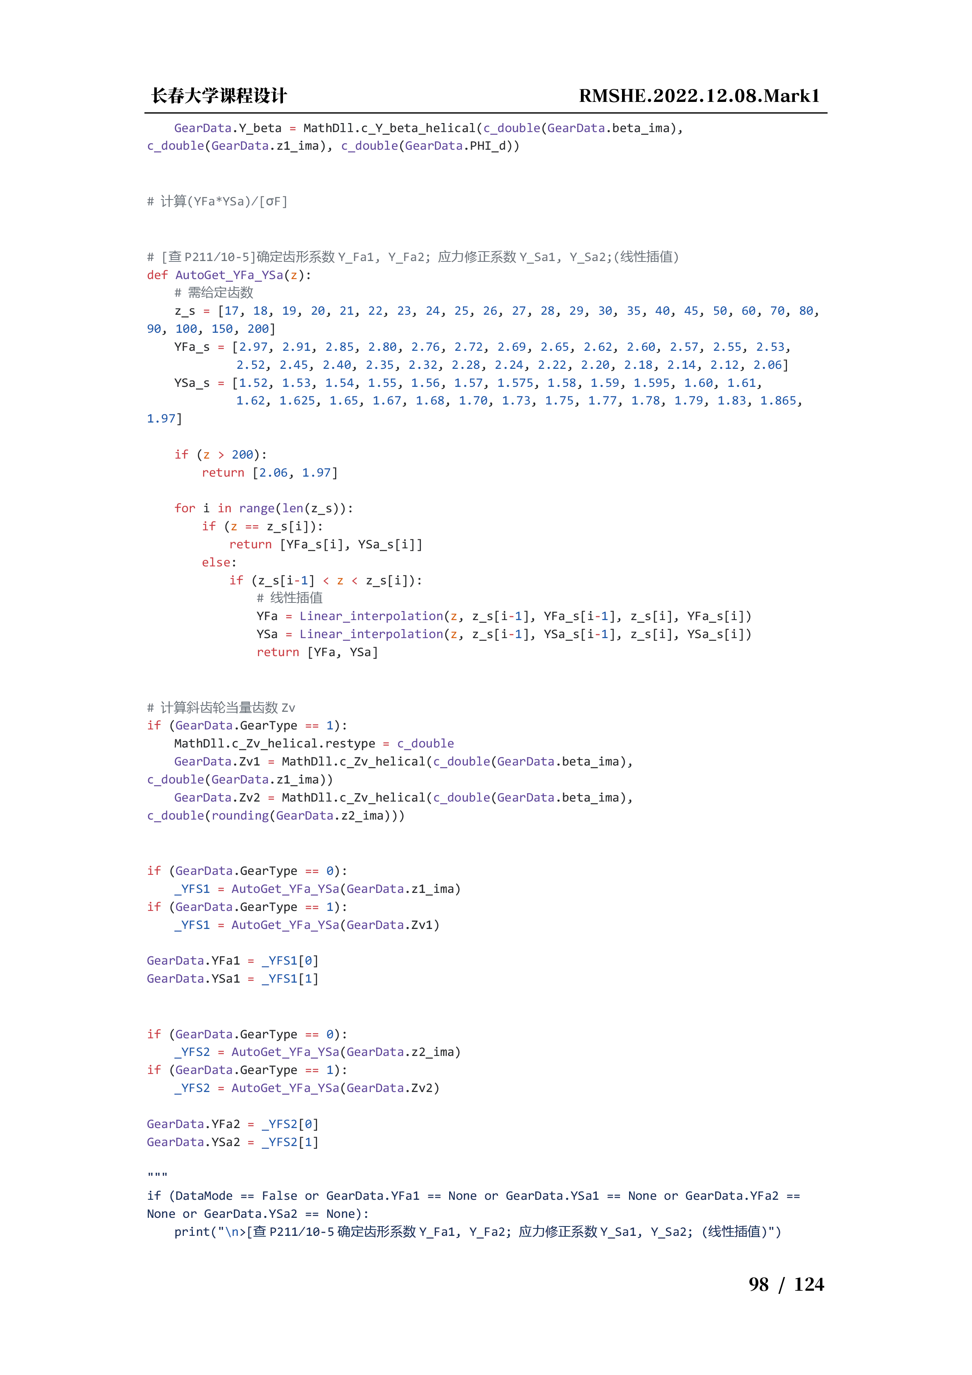
[picture p102: instruction/102.png]
instr

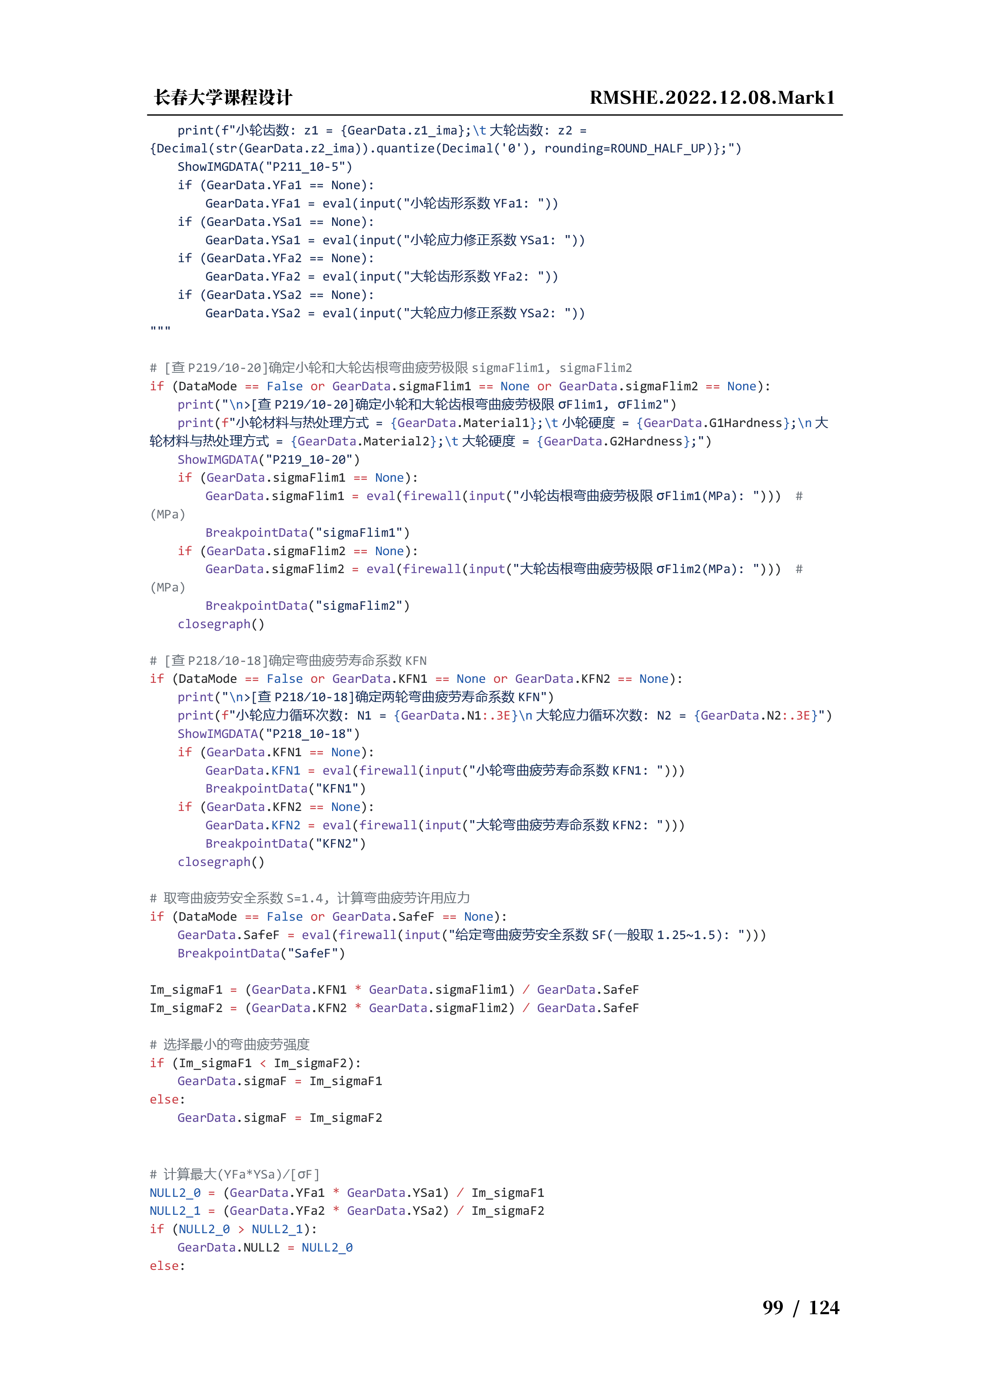
[picture p103: instruction/103.png]
instr

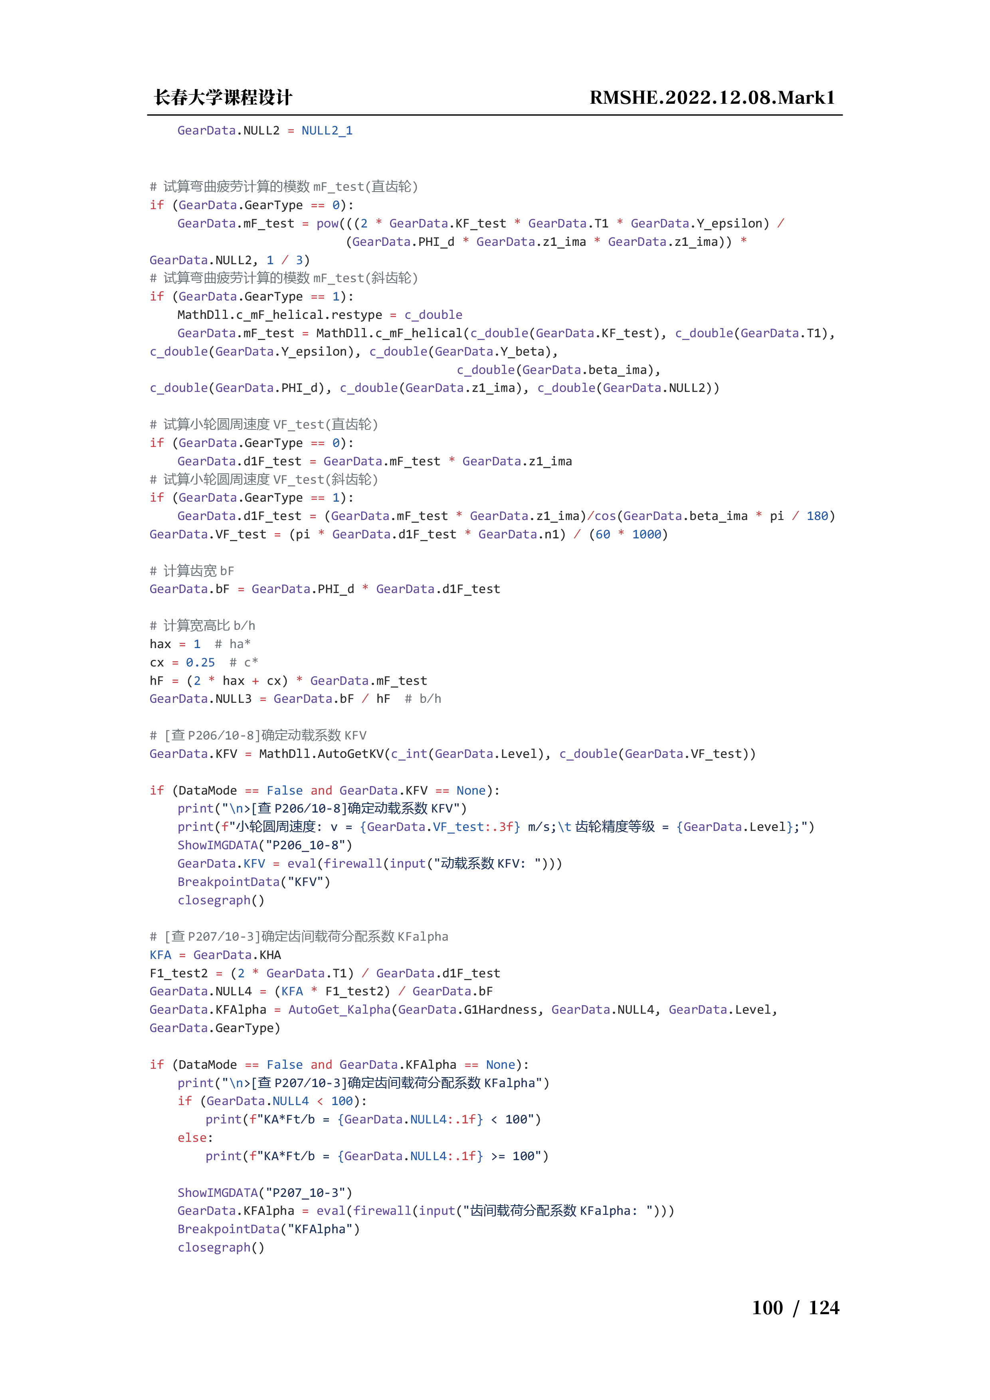
[picture p104: instruction/104.png]
instr

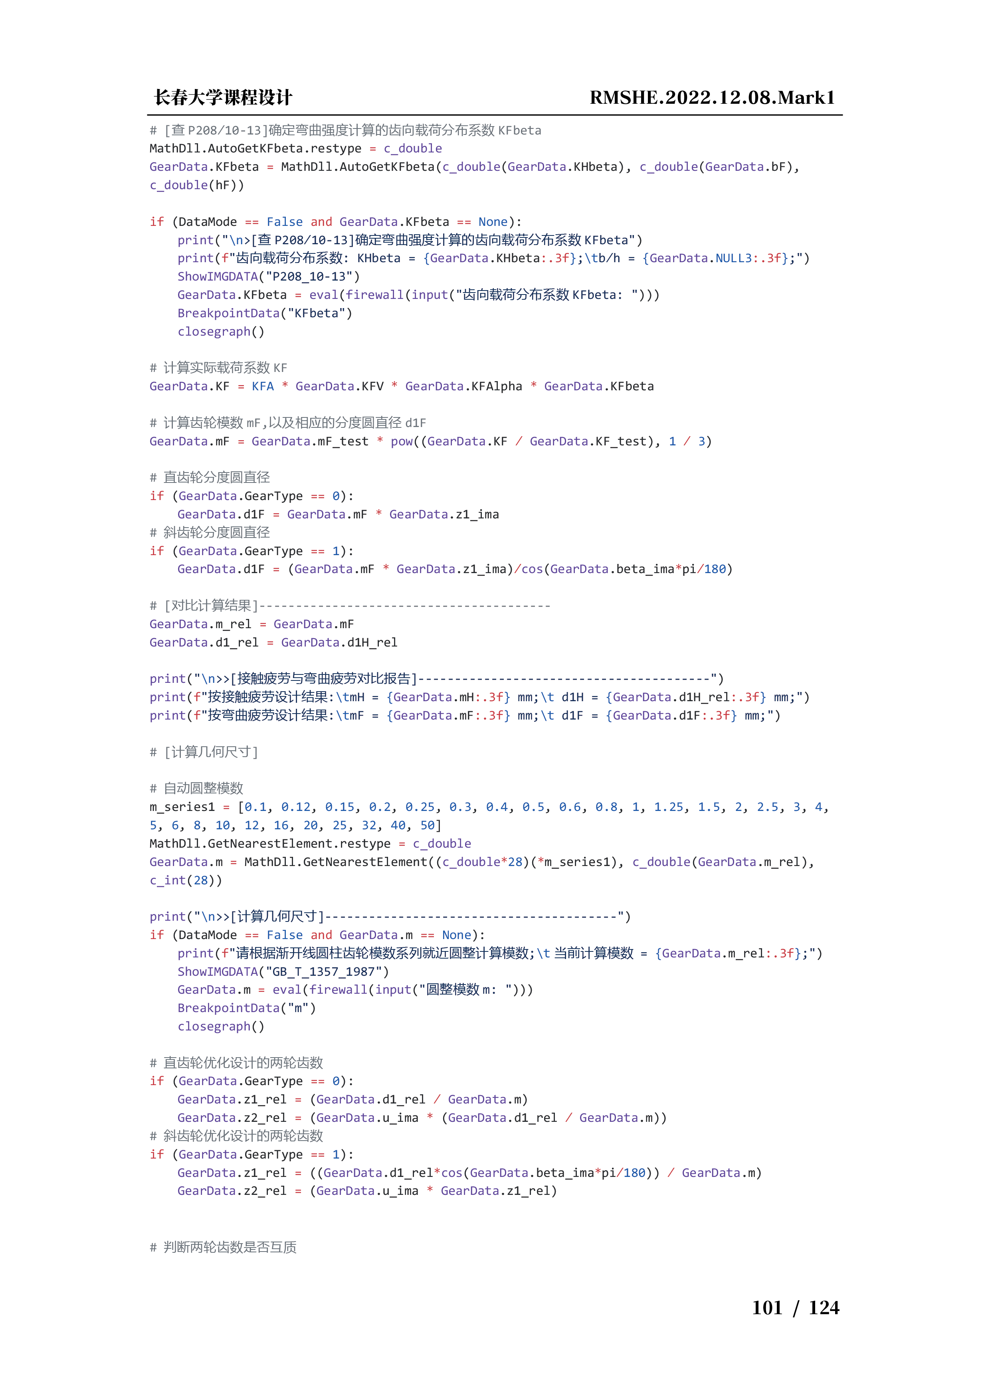
[picture p105: instruction/105.png]
instr

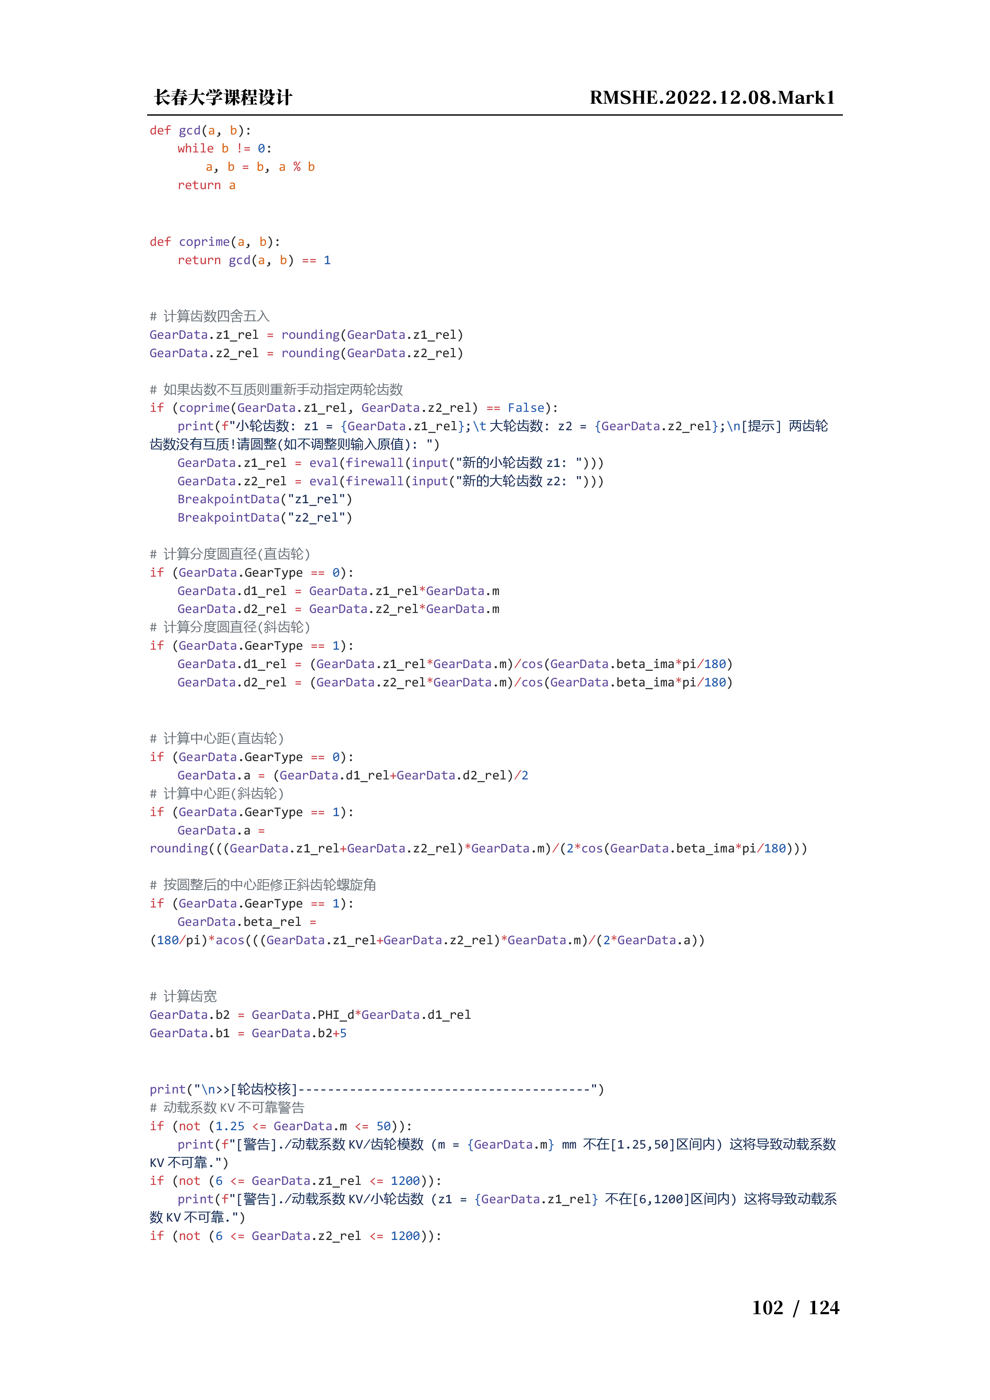
[picture p106: instruction/106.png]
instr

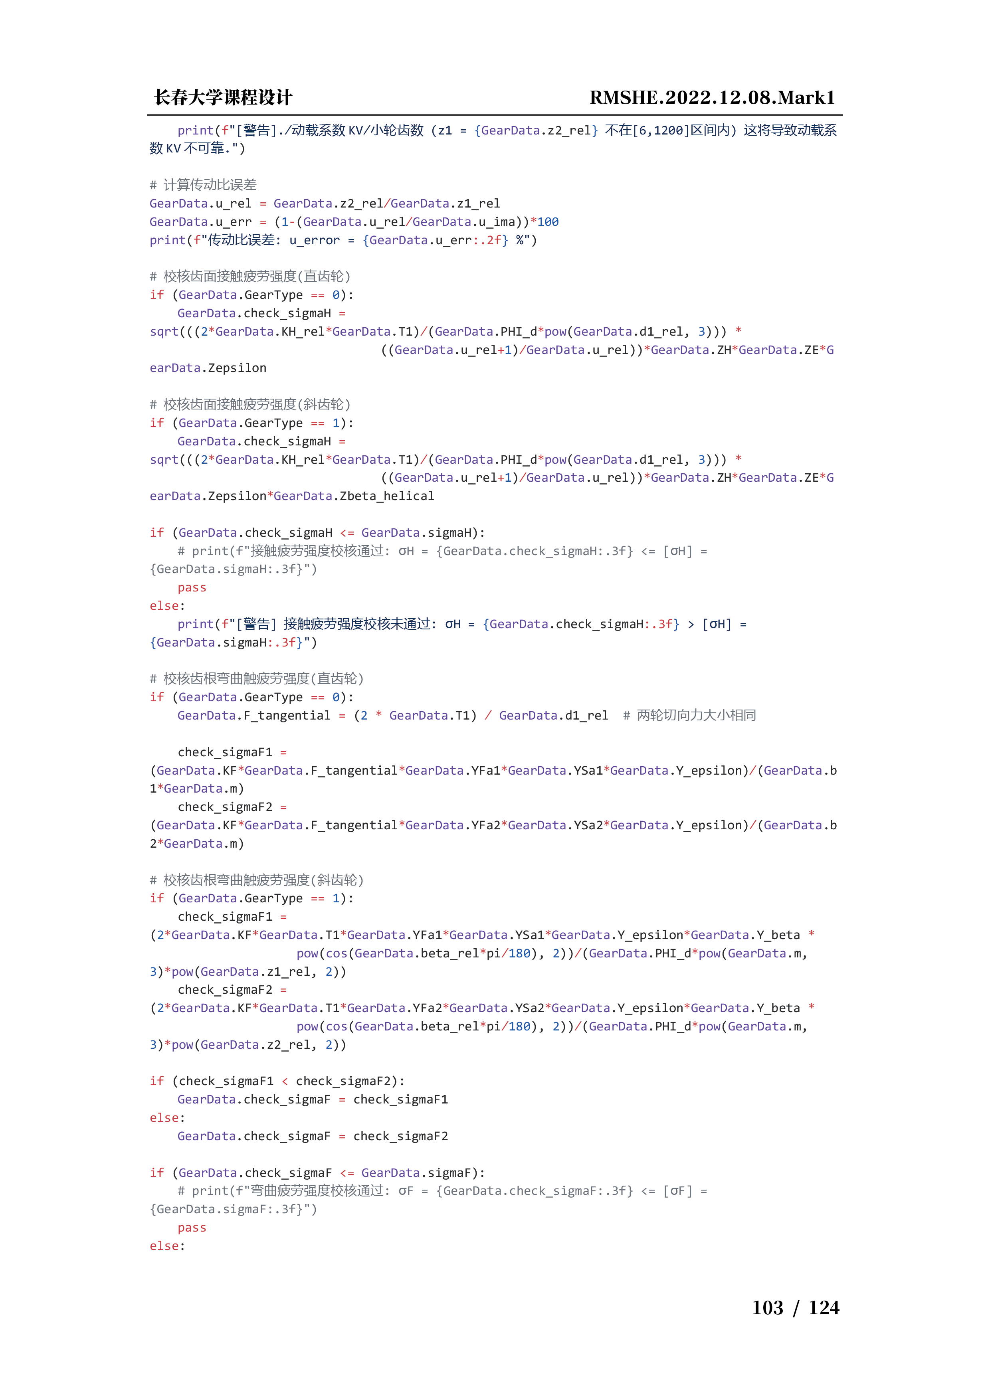
[picture p107: instruction/107.png]
instr

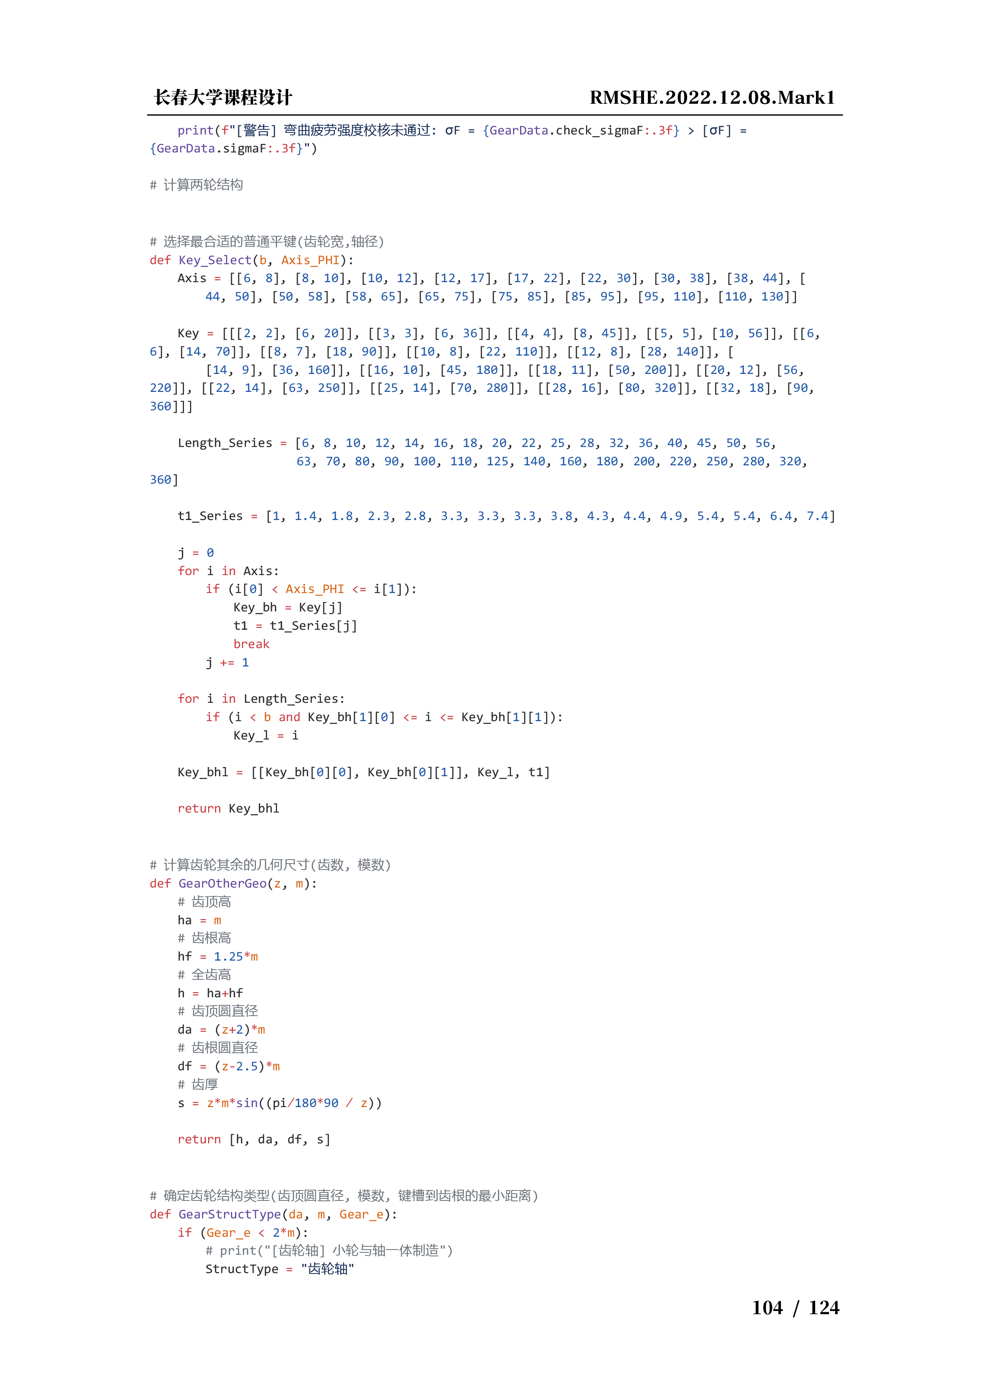
[picture p108: instruction/108.png]
instr

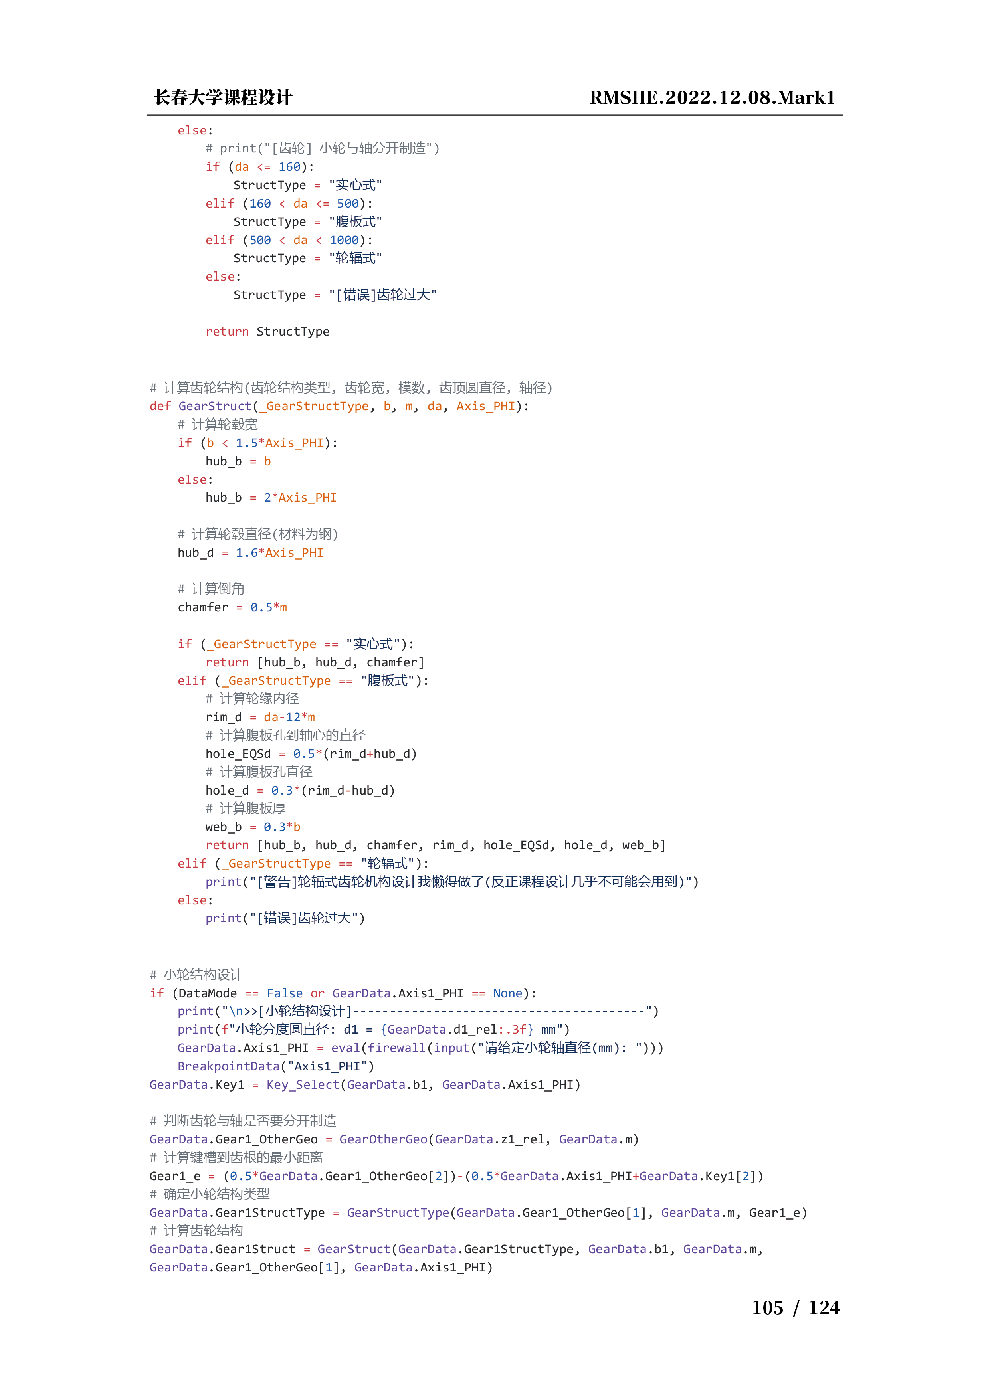
[picture p109: instruction/109.png]
instr

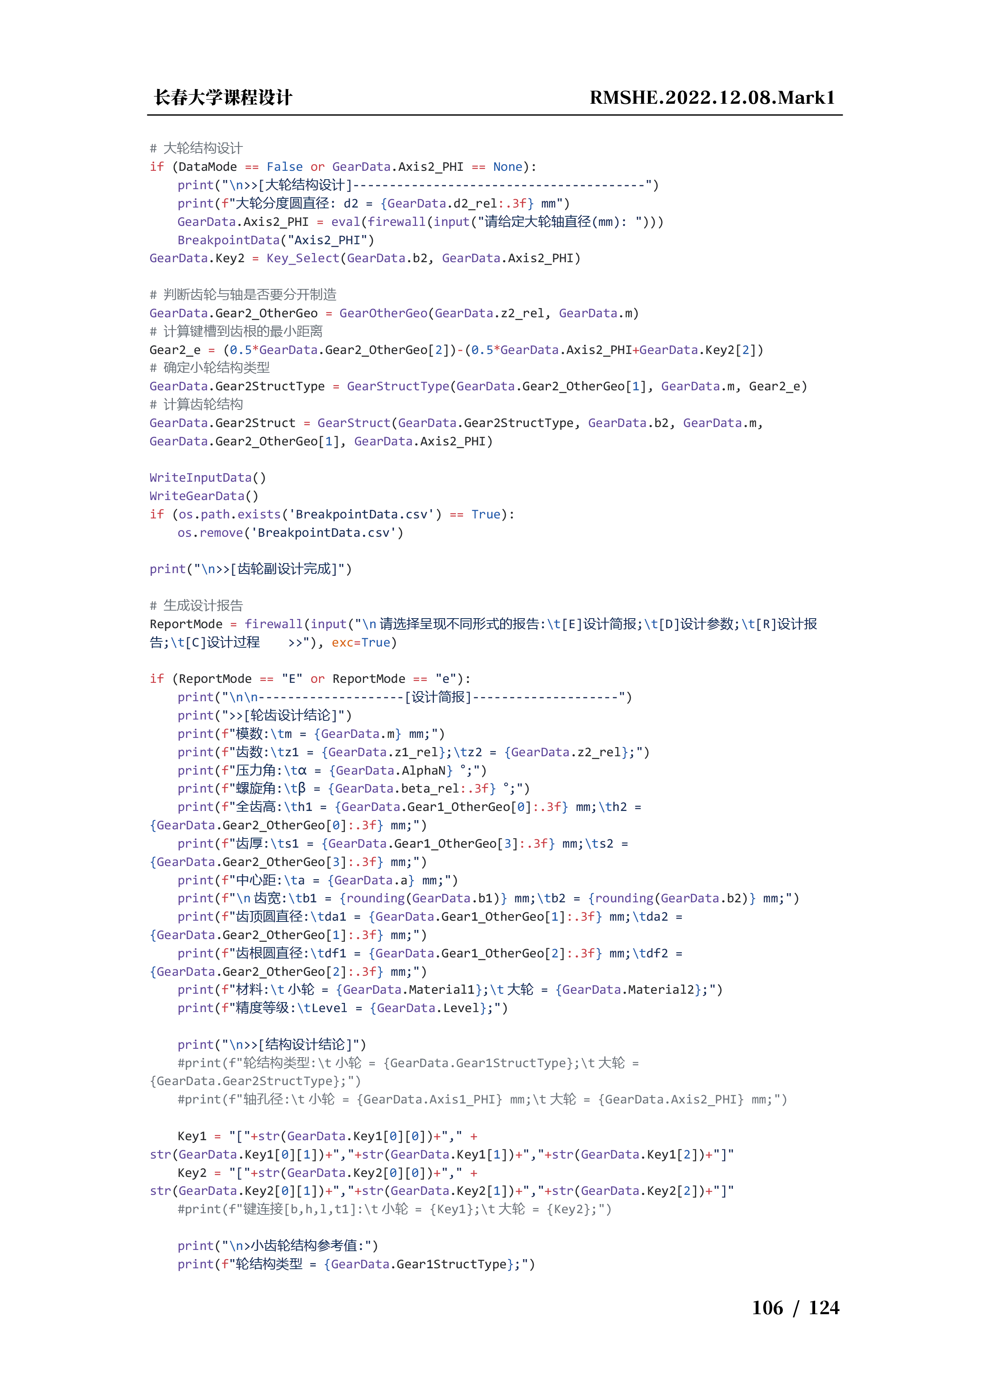
[picture p110: instruction/110.png]
instr

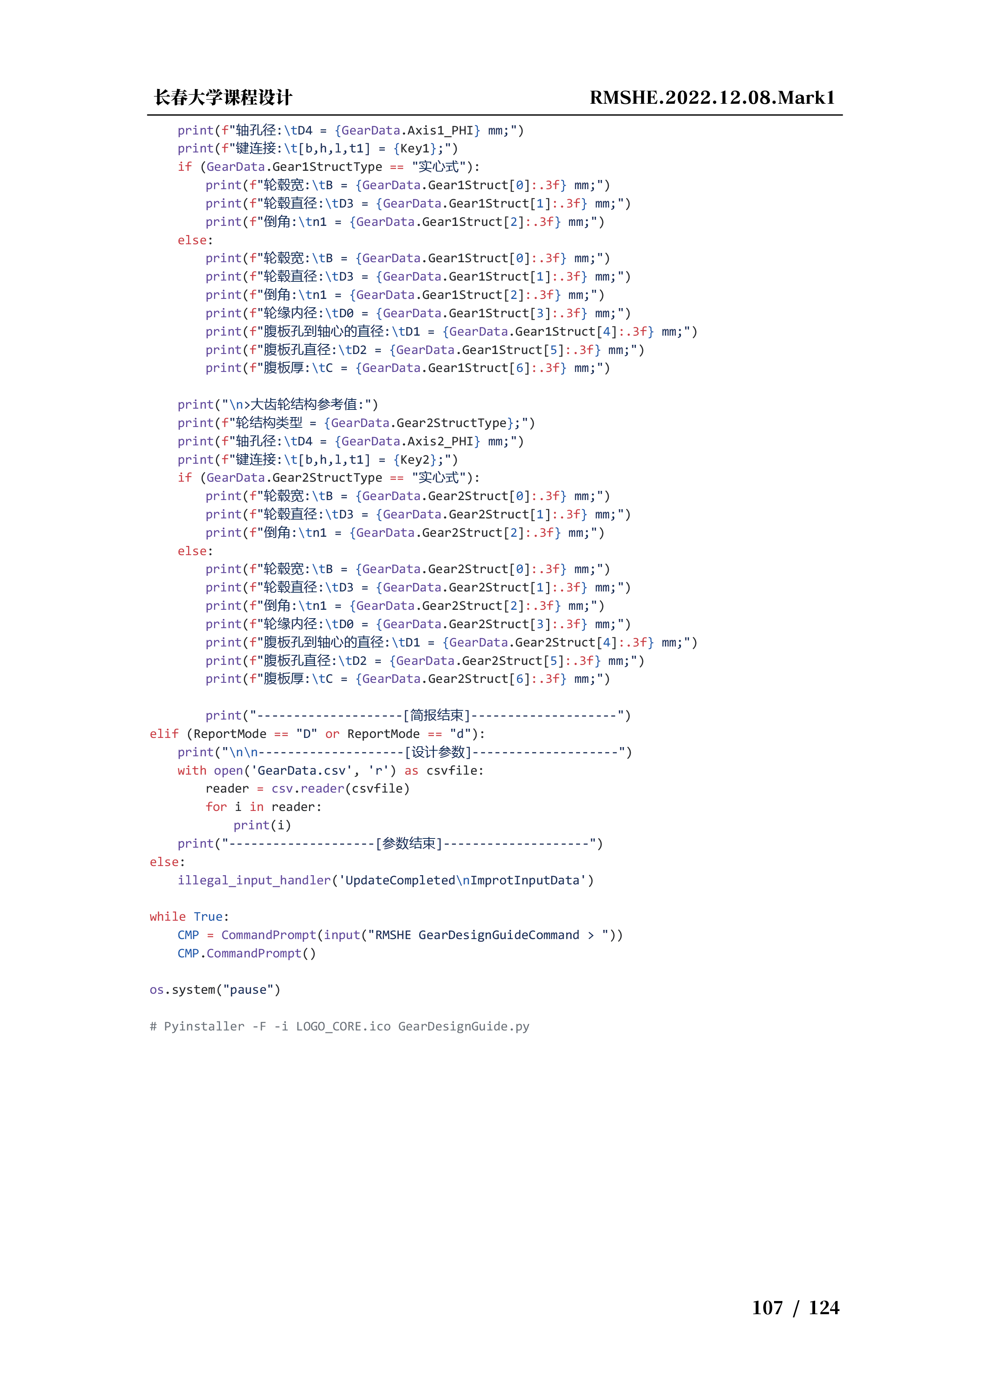
[picture p111: instruction/111.png]
instr

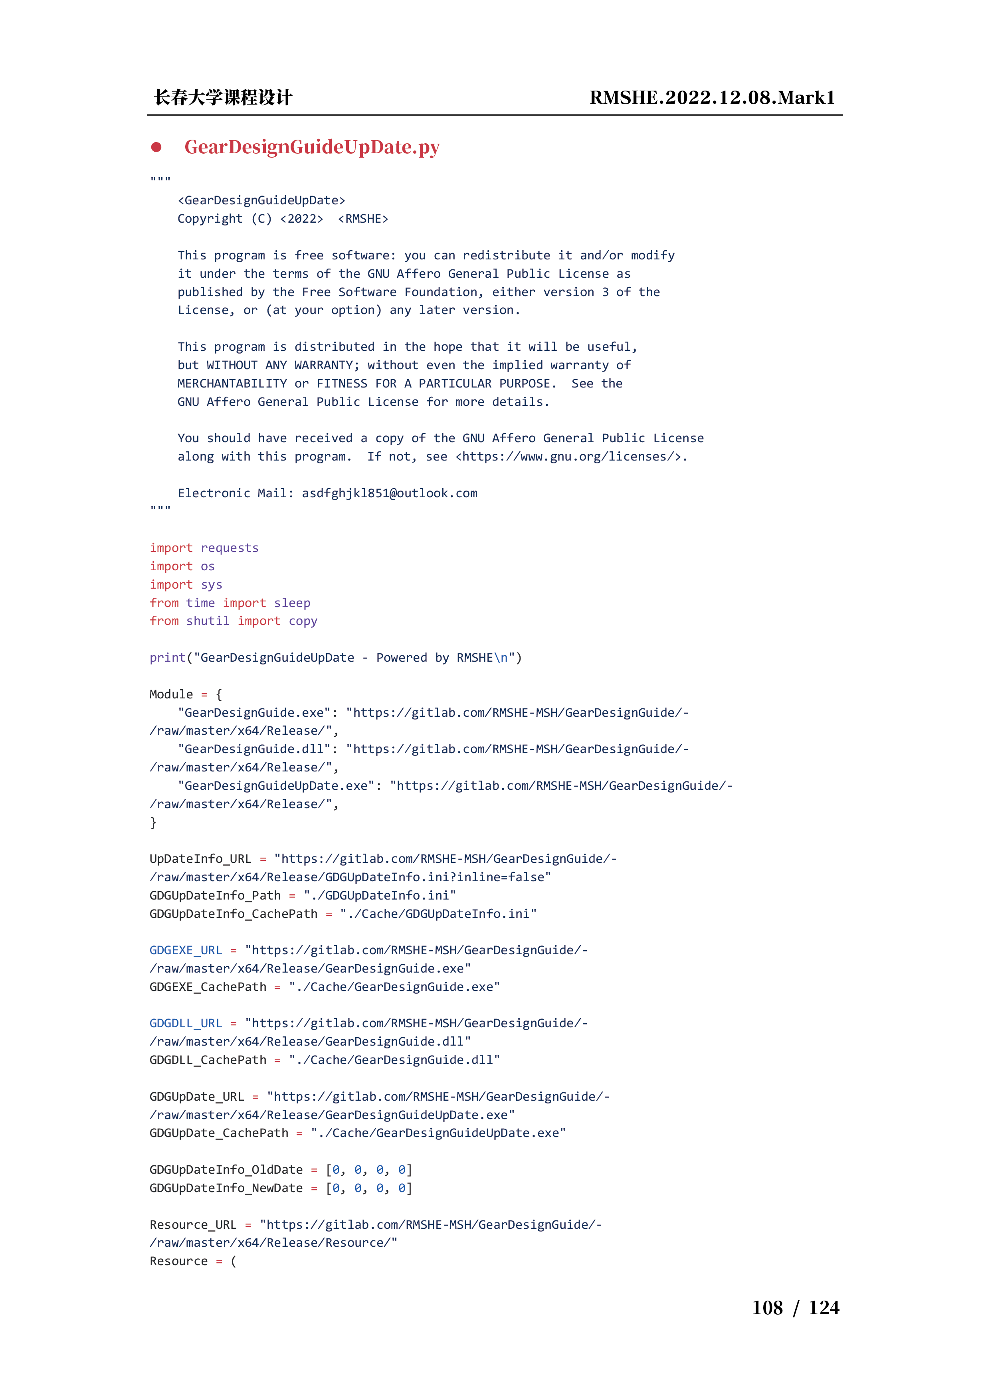
[picture p112: instruction/112.png]
instr

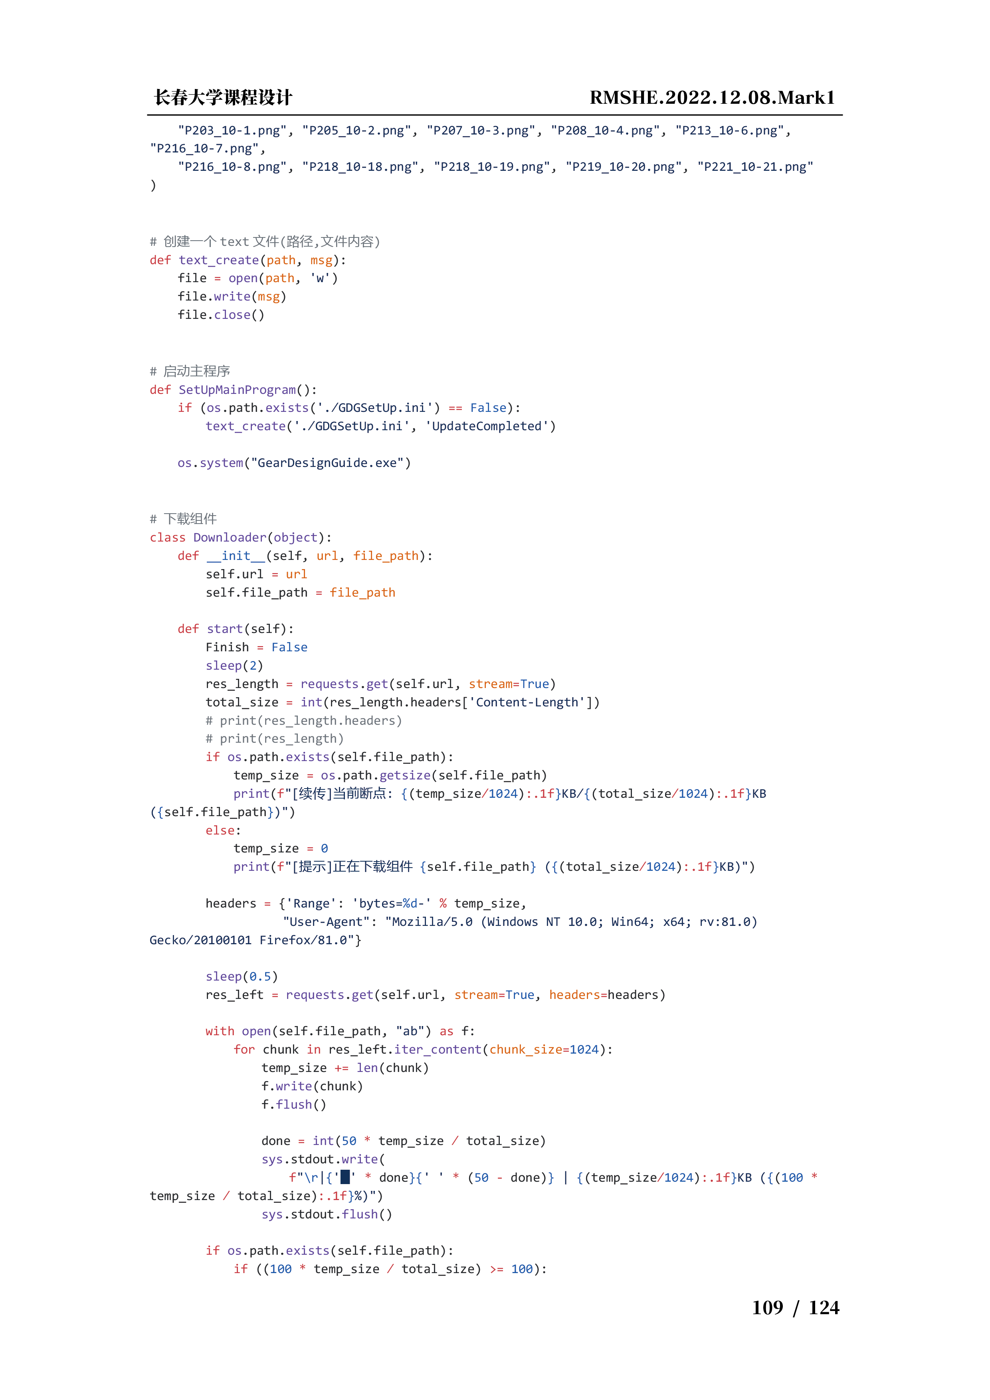
[picture p113: instruction/113.png]
instr

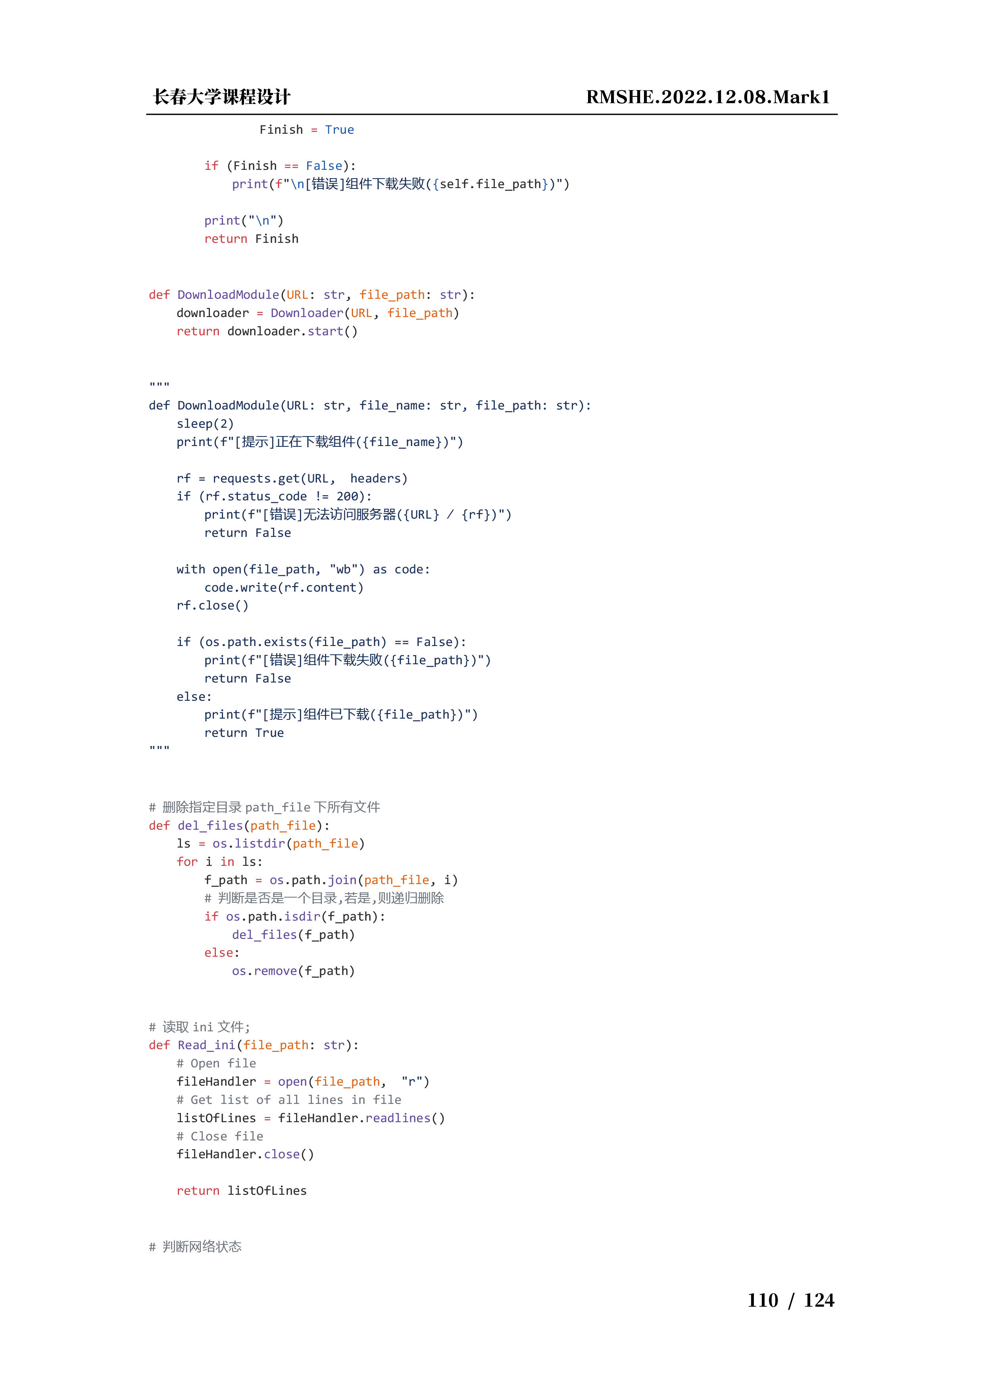
[picture p114: instruction/114.png]
instr

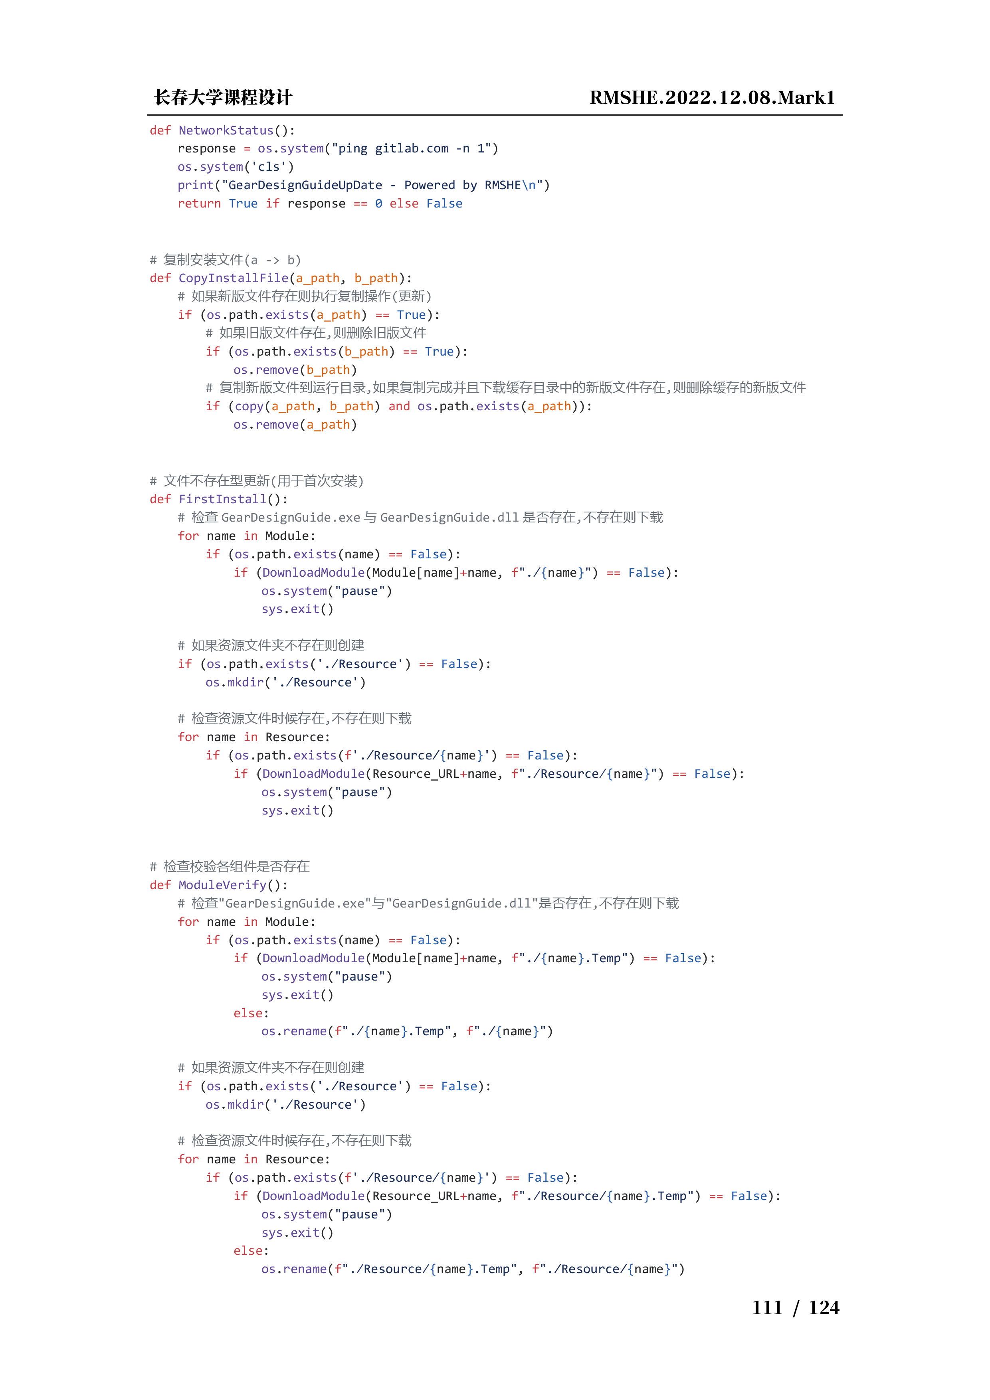
[picture p115: instruction/115.png]
instr

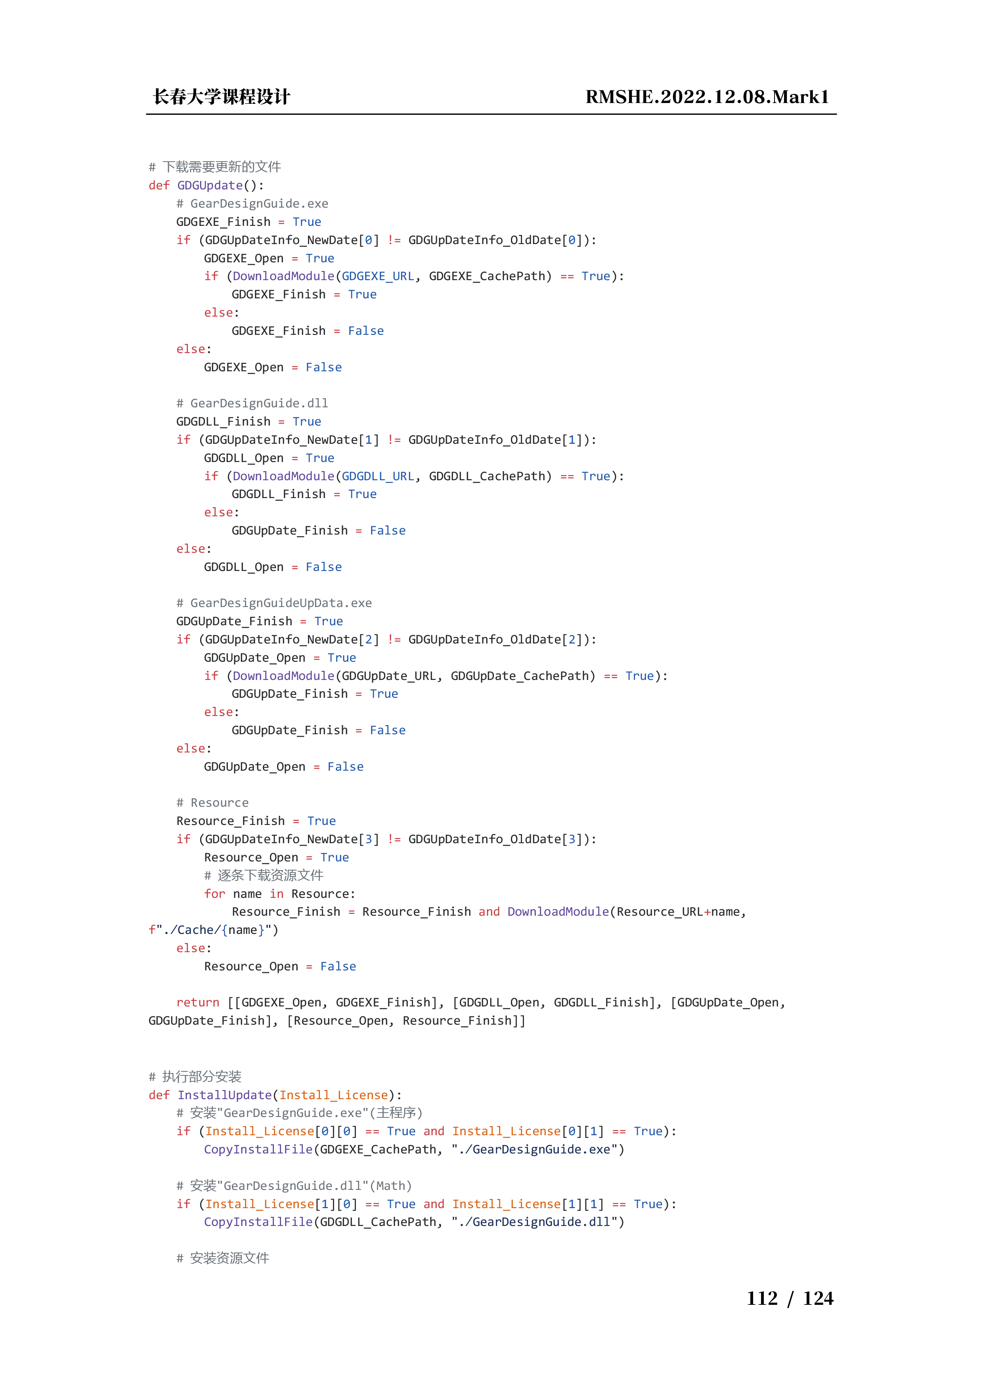
[picture p116: instruction/116.png]
instr

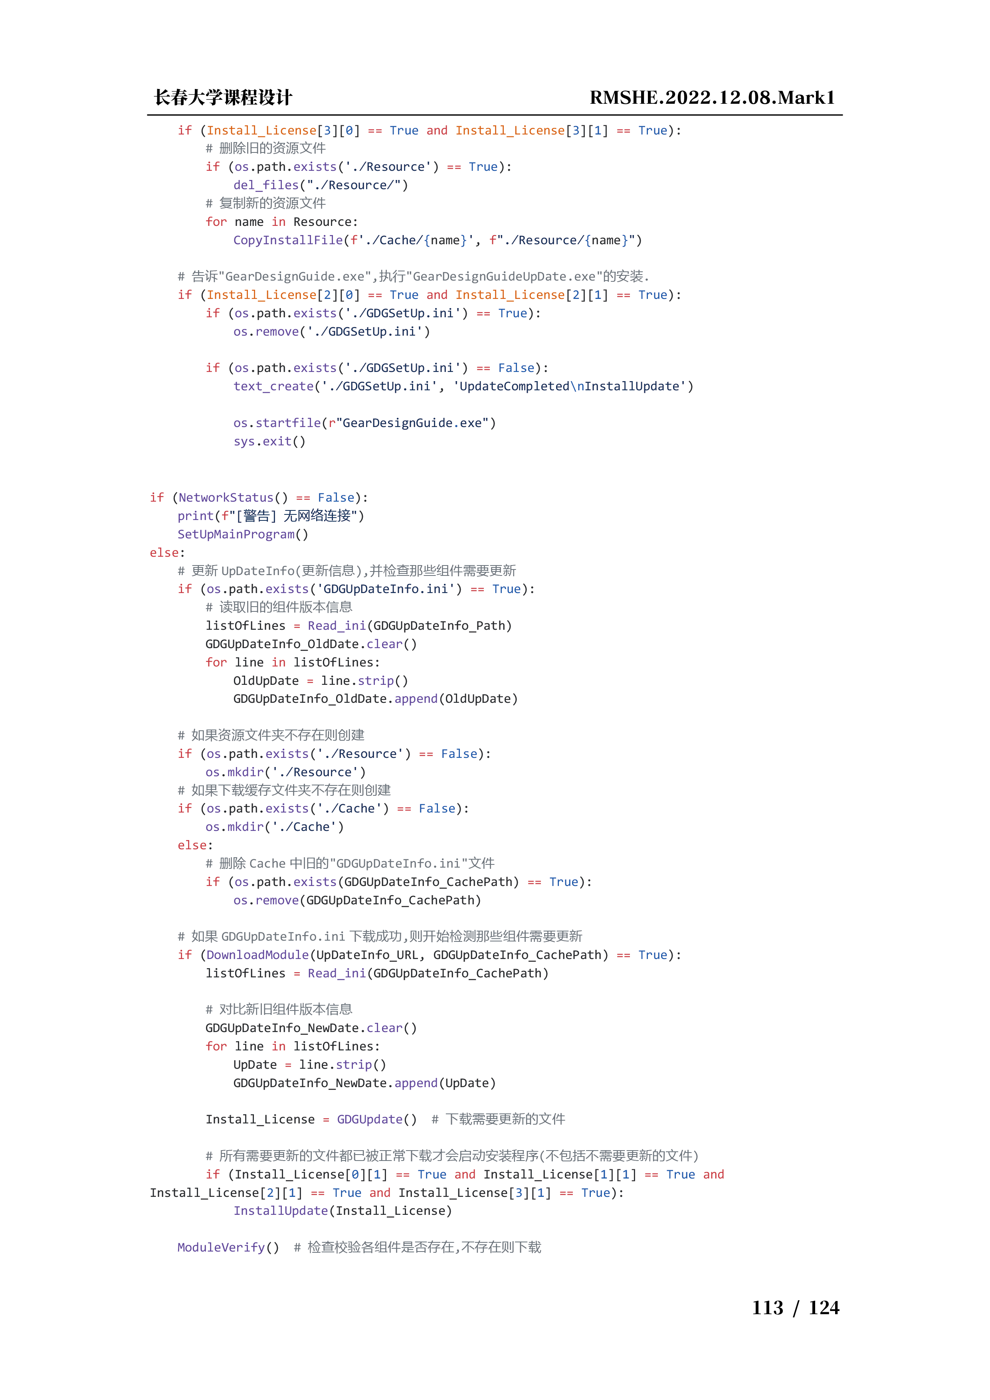
[picture p117: instruction/117.png]
instr

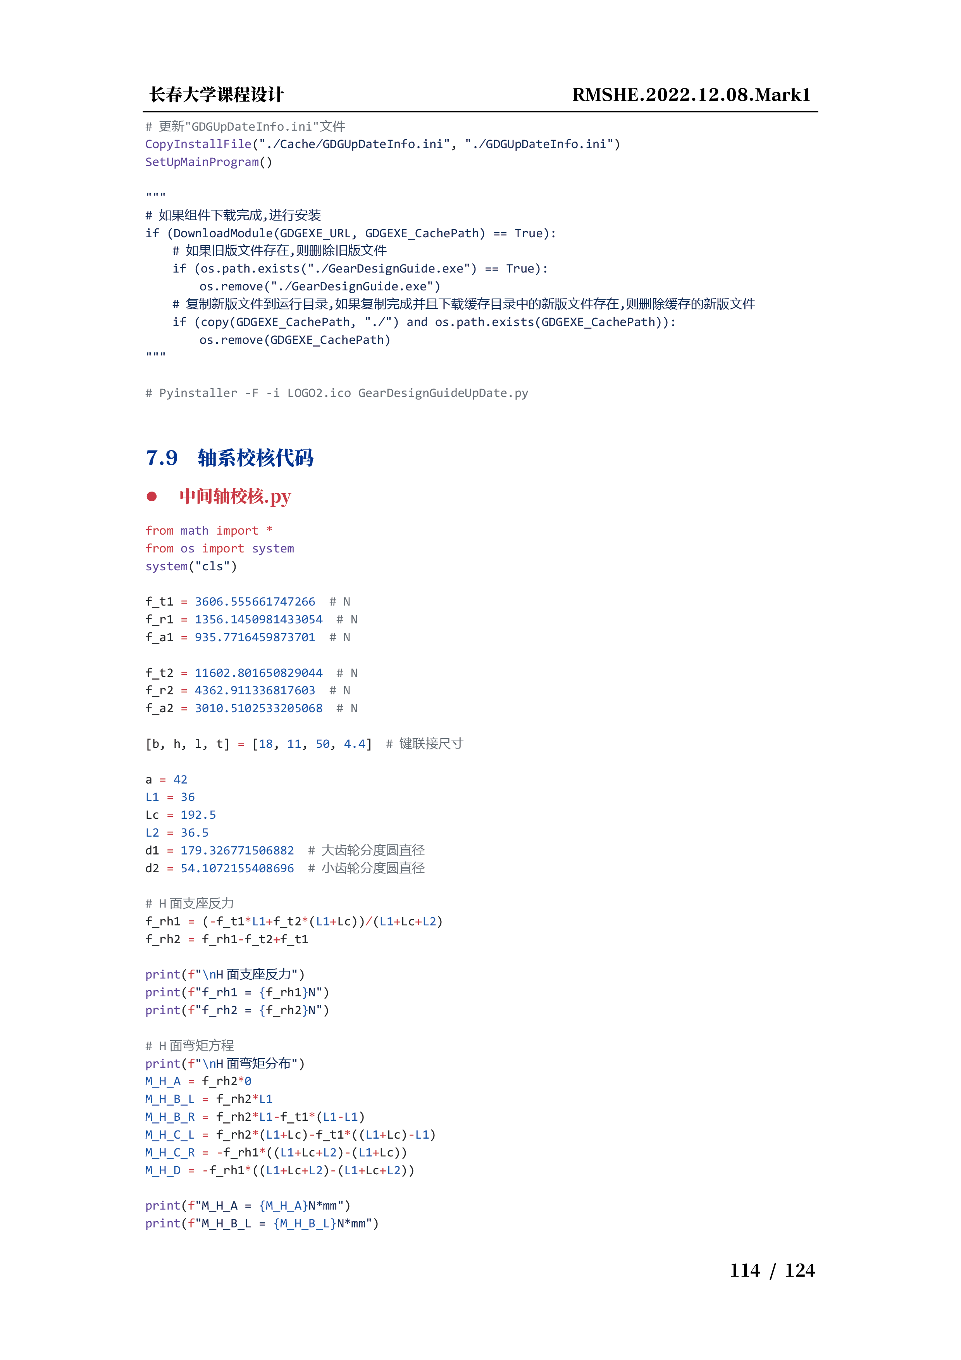
[picture p118: instruction/118.png]
instr

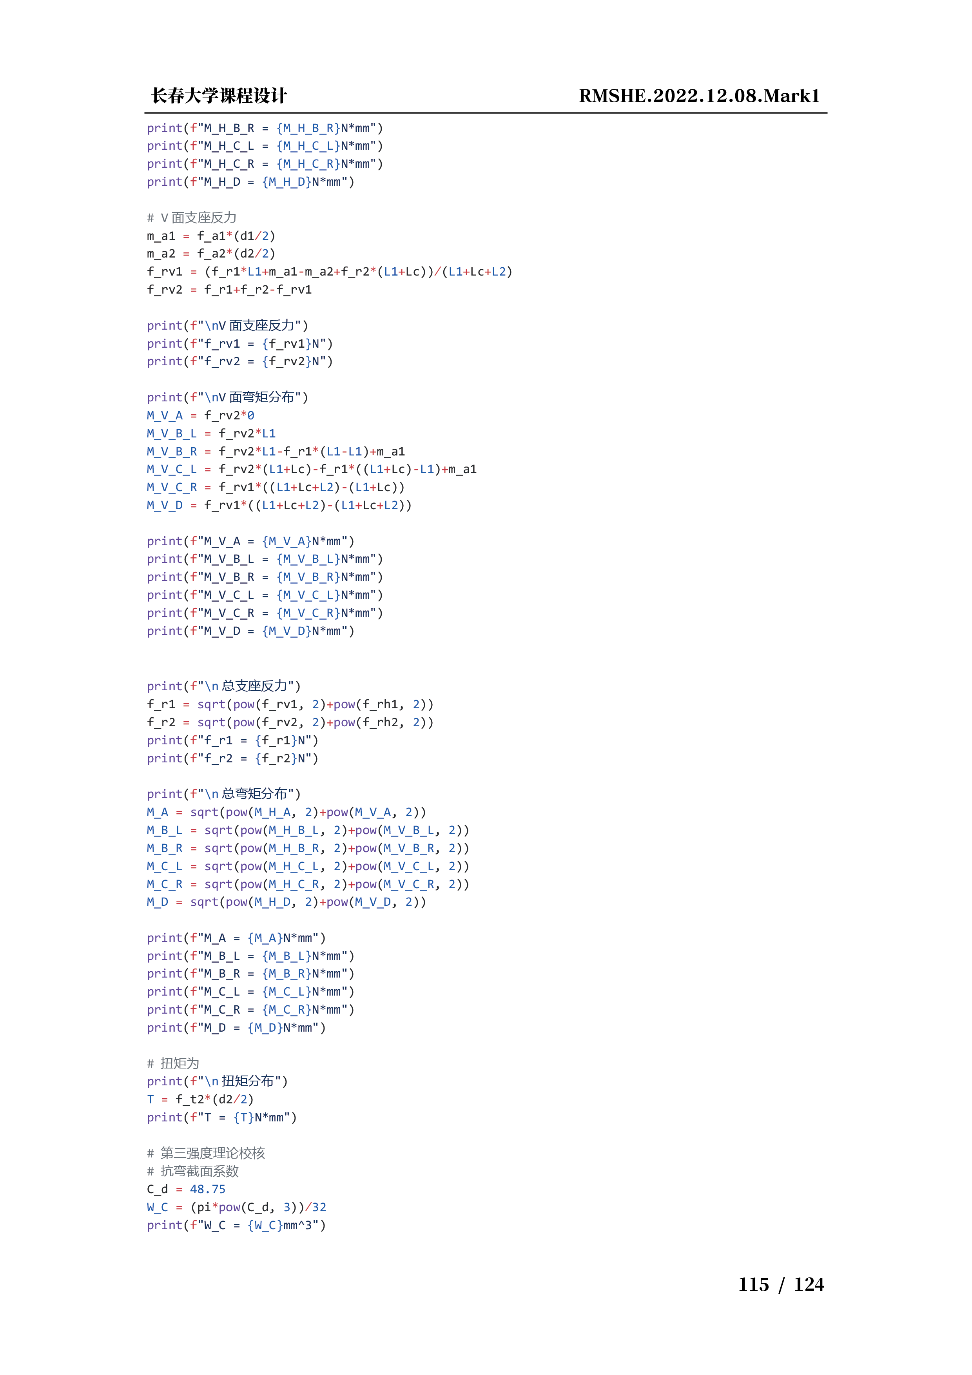
[picture p119: instruction/119.png]
instr

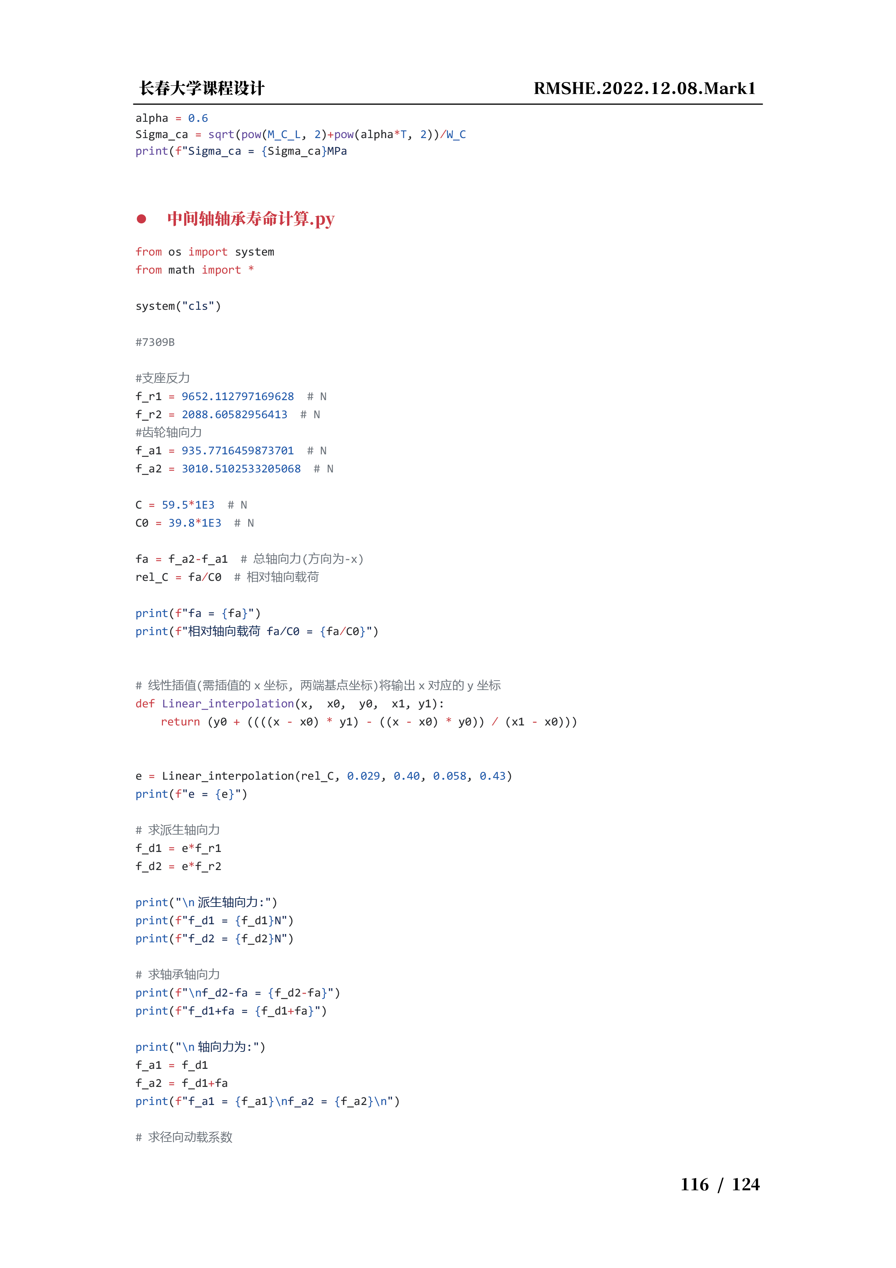
[picture p120: instruction/120.png]
instr

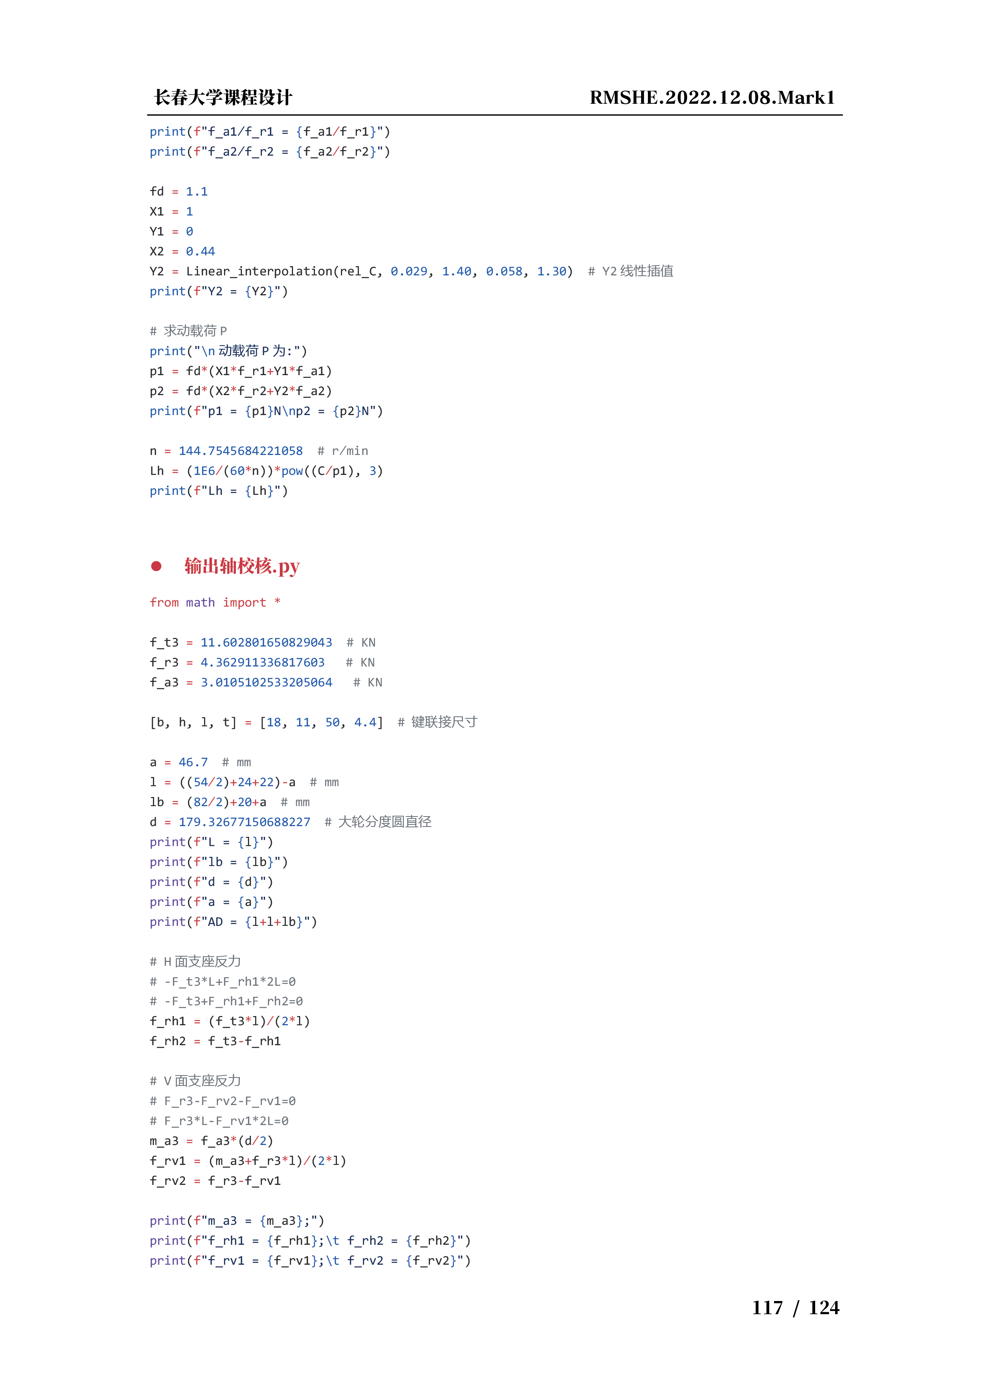
[picture p121: instruction/121.png]
instr

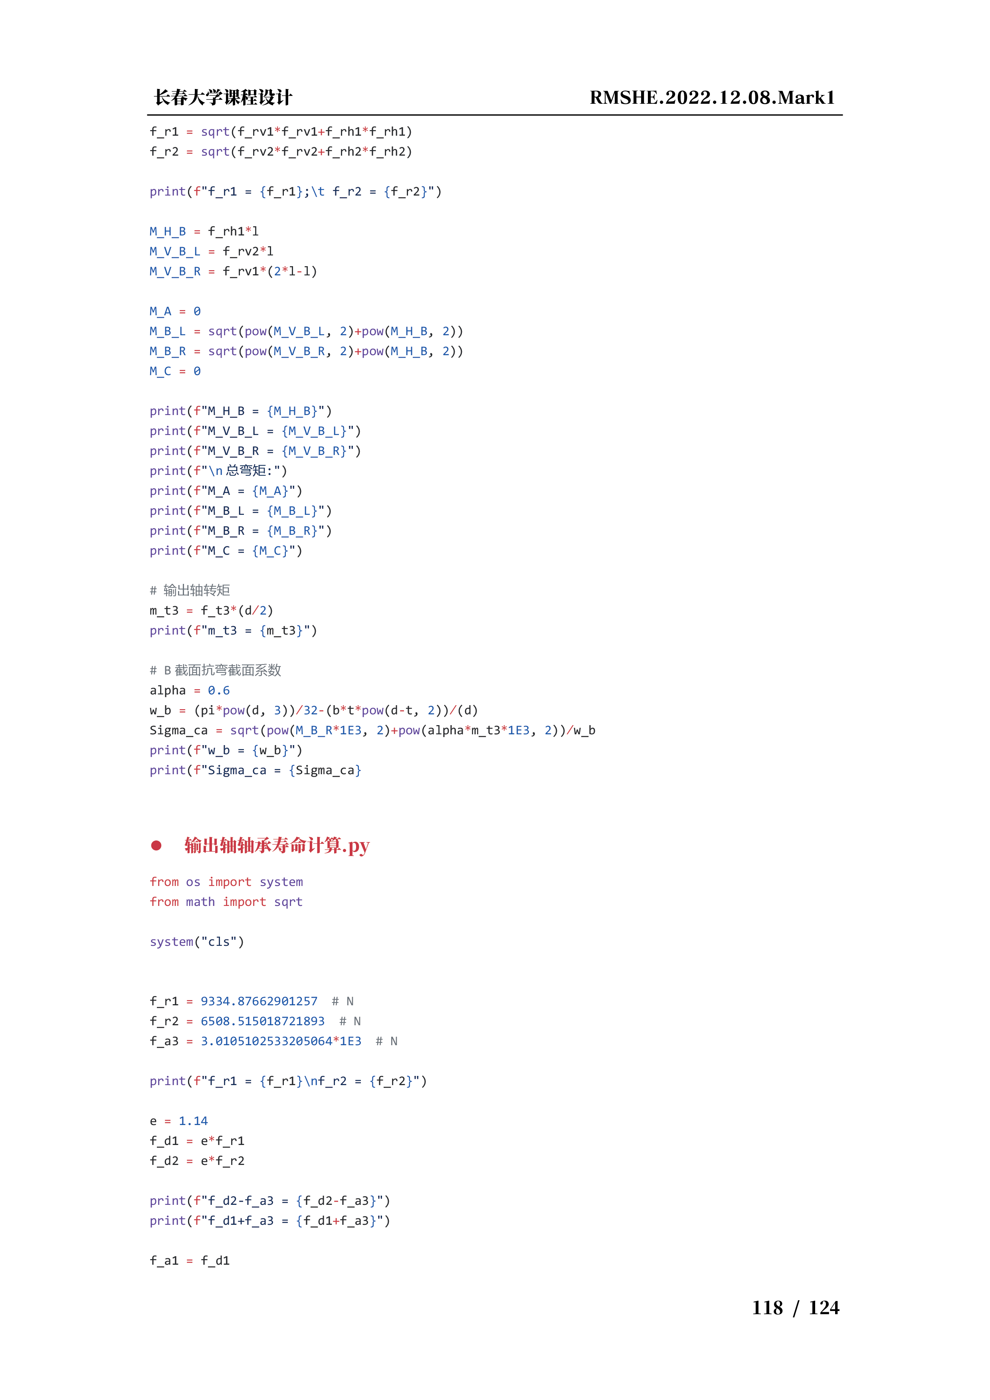
[picture p122: instruction/122.png]
instr

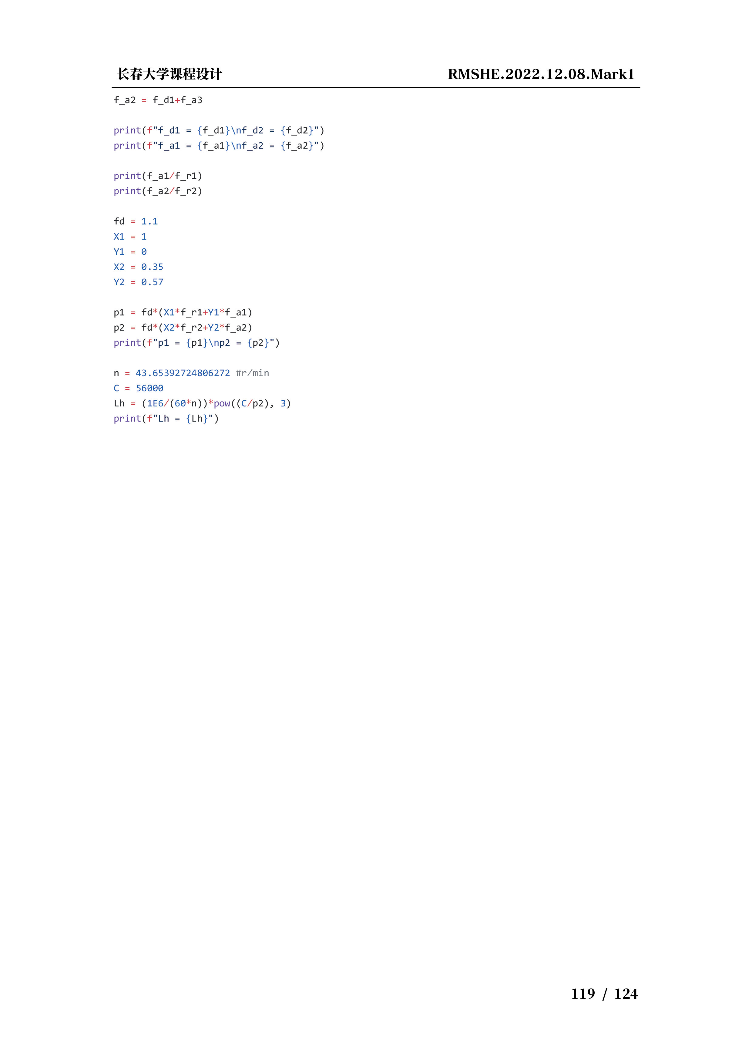
[picture p123: instruction/123.png]
instr

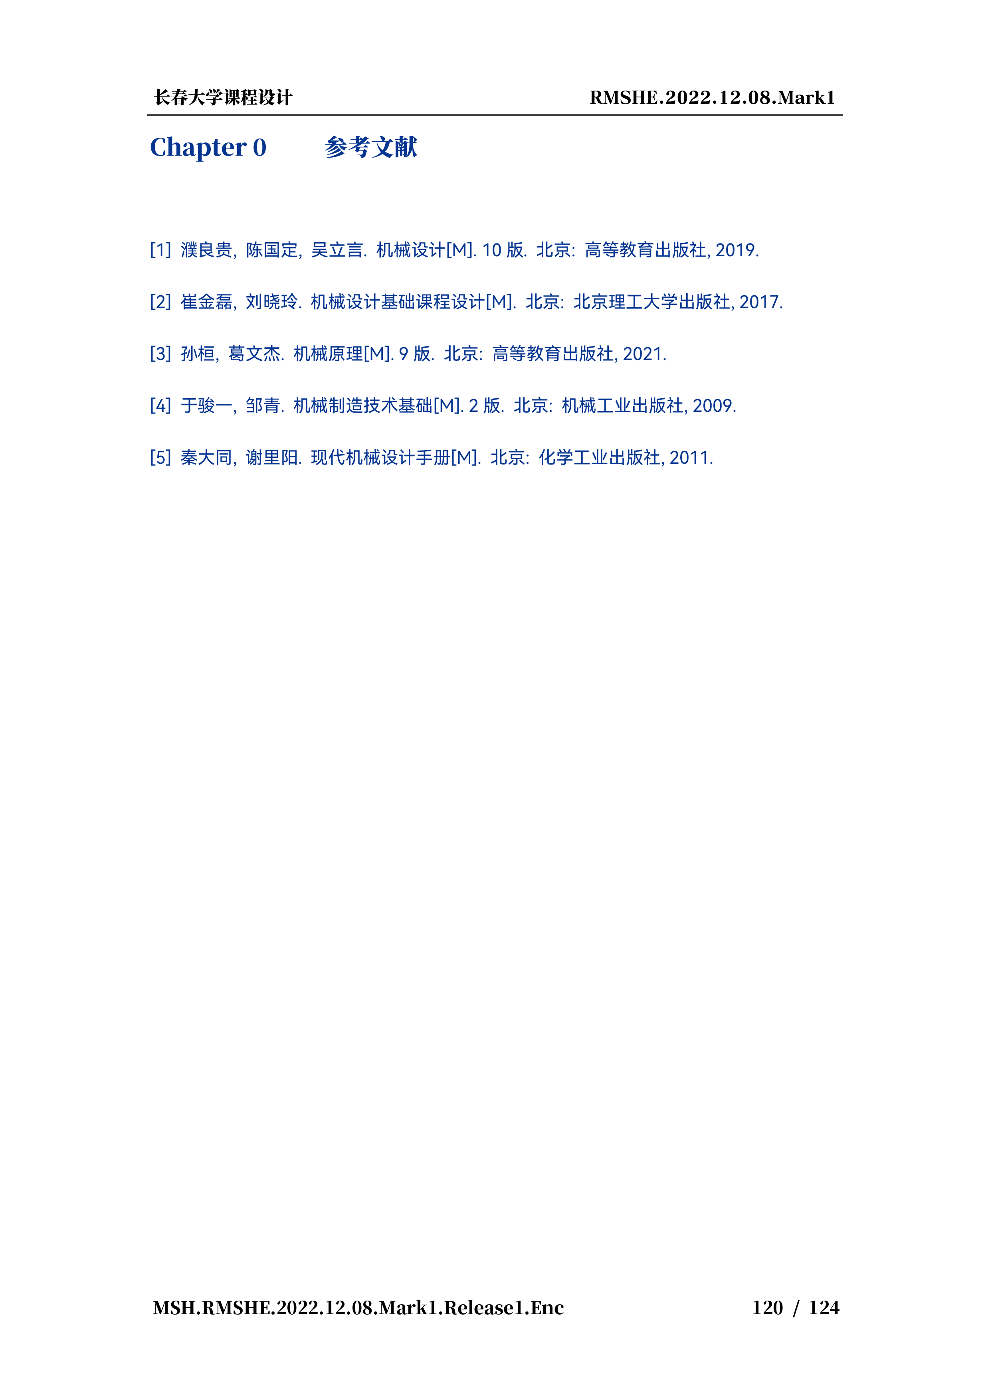
[picture p124: instruction/124.png]
instr
