RMSHE-MSH/Mechanical_Design_Course_Project_Open_Source/轴设计/输入轴/输入轴校核.docx

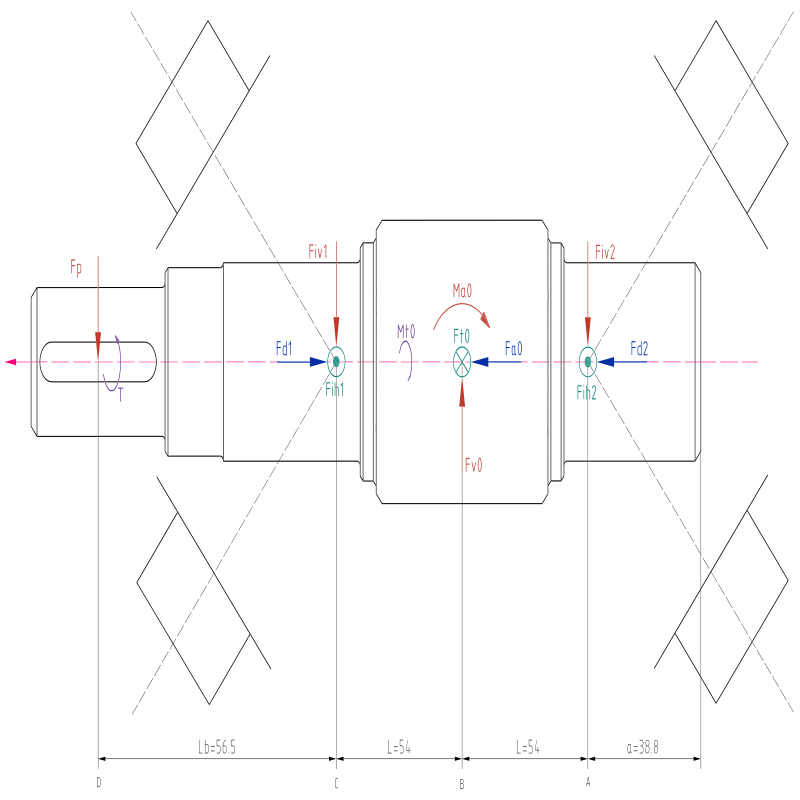
[picture p126: figure]
iAxis-受力分析图-模型

对于iAxis我们选用7308B轴承, 查得轴承支点距背面的距离 a=13.5mm , 并且安装方式为正装, 对于H面(XZ面)有:

{, &∑ F_H =0 ⇒ F_(t0) +(−F_(ih1) )+(−F_(ih2) )=0, &∑ M_(HA) =0 ⇒F_(t0) ∗L+(−F_(ih1) )∗2L=0

计算得H面的分支座反力:

F_(ih1) =F_(ih2) =1.8033KN

则H面轴的弯矩方程为:

{, &M(x)=−F_(ih2) ∗x (0≤x≤L) (KN∗mm), &M(x)=−F_(ih1) ∗x+F_(t0) ∗(x−L) (L≤x≤2L) (KN∗mm)

对于V面有:

{, &∑ F_V =0 ⇒F_(r0) +F_p −F_(iv1) −F_(iv2) =0, &∑ M_(VA) =0 ⇒−M_(a0) −F_(r0) ∗L+F_(iv1) ∗2L+F_p ∗(2L+L_b )=0, &M_(a0) =F_(a0) ∗d/2=25.3166653

(小轮的分度圆直径d=54.107mm），计算得V面的分支座反力:

F_(iv1) =−1.1424KN

F_(iv2) =3.8476KN

则V面的弯矩方程为:

{, &M(x)=F_(iv2) ∗x (0≤x≤L) (KN∗mm), &M(x)=−F_(iv2) ∗x+F_(r0) ∗(x−L) −M_(a0) (L≤x≤2L) (KN∗mm), M(x)=F_p ∗(2L+L_b −x) (2L≤x≤2L+L_b ) (KN∗mm)

则轴承总支座反力为:

F_(i1) =√(F_(iv1)^2 +F_(ih1)^2)=2.134705752557012247KN

F_(i2) =√(F_(iv2)^2 +F_(ih2)^2)=4.24922541764966853588KN

输入轴总弯矩图为:

M_A =0; M_(BL) =229.458KN∗mm; M_(BR) =252.611KN∗mm;

M_(CL) =367.628KN∗mm; M_(CR) =76.224KN∗MM; M_D =0

对于输入轴的BD段, 扭矩为:

−T=M_(t0) =F_(t0) ∗d/2=97.5711532KN∗mm

输入轴的弯矩和扭矩图为:

根据弯扭图, 输入轴(iAxis)危险截面为C截面(108mm处, 直径为40mm),轴截面因此抗弯截面系数为:

W_C =(πd^3)/32=4209.243mm^3

输入轴材料与热处理方式为40Cr调质后淬火, 查得许用弯曲应力 [σ_(−1) ]=70MPa , 轴所受弯矩所产生的弯曲应力为对称循环变应力, 而扭矩所产生的扭转切应力为脉动循环变应力, 故 α=0.6 , 则轴的弯扭合成强度条件为:

σ_(ca) =(√(M^2 +(αT)^2))/W=(√((M_(CL) )^2 +(αM_(t2) )^2))/(W_C)=60MPa<[σ_(−1) ]

输入轴第三强度理论偏于安全.

对于输入轴轴承, 设计期望寿命为3年2班制工作 ([ℎ]=17520ℎ) . 对于7308B轴承查表得 F_d =eF_r (e=0.401(线性插值)) 则:

F_(d1) =0.401∗F_(i1) =0.857311KN

F_(d2) =0.401∗F_(i2) =1.706989KN

所以轴承轴向力为:

F_(a1) =F_(a0) +F_(d2) =2.64276KN

F_(a2) =F_(d2) =1.706989KN

对于轴承1, 径向动载系数X与轴向动载系数Y为:

(F_(a1))/(F_(i1))=1.23>e=0.401

X_1 =0.44; Y_1 =1.39(线性插值);

对于轴承2, 径向动载系数X与轴向动载系数Y为:

(F_(a2))/(F_(i2))=0.401=e=0.401

X_2 =1; Y_2 =0;

根据工况条件, 轴承运行中冲击较小, 因此 f_d =1.1 , 则两轴承动载荷P为:

P_1 =f_d ∗(X_1 ∗F_(i1) +Y_1 ∗F_(a1) )=5.085856KN

P_2 =f_d ∗(X_2 ∗F_(i2) +Y_2 ∗F_(a2) )=4.6739KN

因为 P_1 >P_2 , 按1轴承的受力情况计算(对于球轴承 ε=3 )(C取46200N):

L_h =(10^6)/(60n_m)(C/(P_m))^ε =(10^6)/(60∗iAxis.n)(C/(P_1))^3 =26028h>[h]=17520h

输入轴轴承寿命符合设计预期.

输入轴与齿轮的连接使用GB/T 1096-2003 键A 8*7*40 (轴、带轮、键的材料均为45) ( [b, h, l] = [8, 7, 40] ), 轴径d为30mm, 工作方式为静连接, 受轻微冲击, 故 [σ_(bs) ]=100~120 MPa, 校核该键连接:

σ_(bs) =(4000∗T(N∗m))/(h∗work.l∗d)=(4000∗T∗10^(−3) (N∗m))/(h∗(l−b)∗d)=58.078067MPa<[σ_(bs) ]

带轮与输入轴的键连接可靠.
