RMSHE-MSH/Mechanical_Design_Course_Project_Open_Source/轴设计/输出轴/输出轴校核.pdf

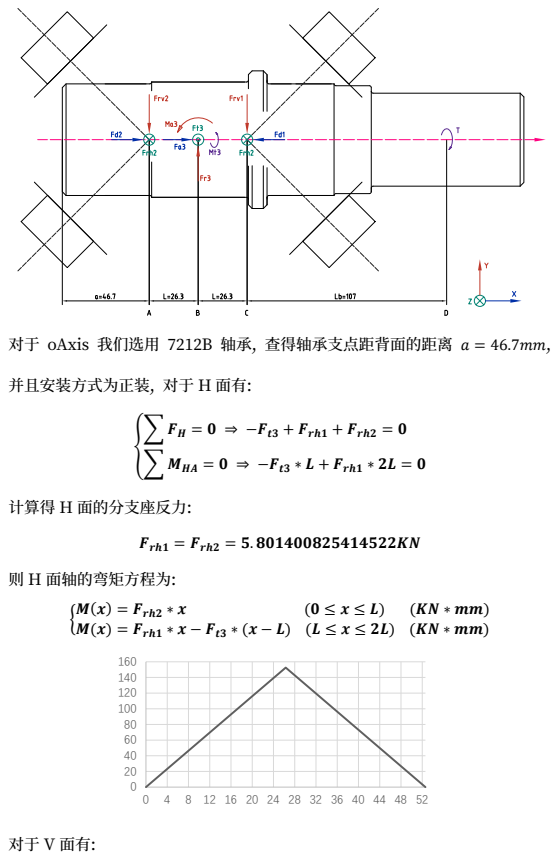
[picture p128: page 1]
计算得 H 面的分支座反力:; MM(xx) = FFrrrrrr ∗ xx; (00 ≤ xx ≤ LL) ( ∗ mmmm)

对于 oAxis 我们选用 7212B 轴承, 查得轴承支点距背面的距离 aa = 46.7mmmm,
并且安装方式为正装, 对于 H 面有:
FH = 0 ⇒ −Ftt + Frrr + Frrr = 0
MHH = 0 ⇒ −Ftt ∗ L + Frrr ∗ = 0
Frrr = Frrr = 5. 8 8 8 8 8 88
则 H 面轴的弯矩方程为:
MM(xx) = FFrrrrrr ∗ xx − FFtttt ∗ (xx − LL) (LL ≤ xx ≤ ) ( ∗ mmmm)

⎩

⎪

⎨

⎪

⎧FV = 0 ⇒ Fr − Frrr − Frrr = 0
MV = 0 ⇒ Ma + Fr ∗ L − Frrr ∗ = 0 Ma = Fa ∗

dd
计算得 V 面的分支座反力:
FFrr = 77. 33 33
FFrrrrrr = − . 99
则 V 面的弯矩方程为:

MM(xx) = FFrrrrrr ∗ xx (00 ≤ xx ≤ LL) ( ∗ mmmm) MM(xx) = FFrrrrrr ∗ ( ∗ LL − xx) (LL ≤ xx ≤ ) ( ∗ mmmm)

则轴承总支座反力为:
Frr = Frrr + Frrr = 9. 33
Frr = Frrr + Frrr = . 5 5 5 5
输出轴总弯矩图(矢量合成)为:

MM = 00; MMBB = 77 . 99 ∗ mmmm; MMBBBB = . 99 ∗ mmmm; MMCC = 00

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
0 4 8 12 16 20 24 28 32 36 40 44 48 52

0

50

100

150

200

250

0 4 8 12 16 20 24 28 32 36 40 44 48 52

对于输出轴的 BD 段, 扭矩为:
−T = Mtt = Ftt ∗

dd = . 33 ∗ mmmm
输出轴的弯矩和扭矩图为:

根据弯扭图, 输出轴(oAxis)危险截面为 B 截面(26.3mm 处, 直径为 62mm), 由于 B 截面为双键槽( [b, h, l, t] = [18, 11, 50, 4.4] )180°均布, 的轴截面因此 抗弯截面系数为:
WB = πd − b (d − t) d = 55 . m
输出轴材料与热处理方式为 45 调质, 查得许用弯曲应力 [σσ−1] = 60MMMMaa, 轴所 受弯矩所产生的弯曲应力为对称循环变应力, 而扭矩所产生的扭转切应力为脉 动循环变应力, 故αα = 0.6, 则轴的弯扭合成强度条件为:
σσcc = MM + (αα )
W = (MBB ∗ 0 ) + (αMtt ∗ 0 ) WB | = . MMa < [σ− ]

输出轴第三强度理论非常安全.
对于输出轴轴承, 设计期望寿命为 3 年 2 班制工作([ℎ] = 5840ℎ). 对于 7212B
轴承查表得FFdd = eeFFrr(ee = 1.14)则:
Fd = . ∗ Frr = . 7 7 7 Fd = . ∗ Frr = 7 . 7 7

0

200

400

600

800

1000

1200

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
0 | 20 | 40 | 60 | 80 | 100 120 140 160

根据最大值法, 轴承派生轴向力为:
Fd − Fa = . < Fd =
Fa = Fd = . 7 7 7
Fd + Fa = . > Fd = 7 Fa = Fd + Fa = .
对于轴承 1, 径向动载系数 X 与轴向动载系数 Y 为:
FFaa
FFrrrr

= . = ee = .
XX = ; YY = 00;
对于轴承 2, 径向动载系数 X 与轴向动载系数 Y 为:
FFaa
FFrrrr

= . 00 > ee = .
XX = 00. ; YY = 00. 55 ;
根据工况条件, 轴承运行中冲击较小, 因此ffdd = 1.1, 则两轴承动载荷 P 为:
= fd ∗ (X ∗ Frr + Y ∗ Fa ) = . 3
= fd ∗ (X ∗ Frr + Y ∗ Fa ) = . 7 7
因为 1 < 2, 按 2 轴承的受力情况计算(对于球轴承εε = 3)(C 取 56000N):
LL = nnmm
CC mm εε = ∗ oo AAAA. nn | CC = . 99 > [ ] =

输出轴轴承寿命符合设计预期.

输出轴与齿轮的连接使用 GB/T 1096-2003 键 B 18*11*50 (轴、齿轮、键的材 料均为 45) ( [b, h, l, t] = [18, 11, 50, 4.4] ), 轴径 d 为 62mm, 两键 180°均布 连接工作方式为静连接, 受轻微冲击, 故[σσbbbb] = 100~120MPa, 校核该键连接:
σσbb = ∗ TT( ∗ mm)

∗ ww ww.ll ∗ dd = ∗ MMtttt( ∗ mmmm)
| ∗ . 55 ∗ ll ∗ dd = 88 . < [σσbb ]
齿轮与输出轴的键连接可靠.

输出轴与联轴器的连接使用 GB/T 1096-2003 键 A 14*9*70 (轴、联轴器 GYSJ1A50×84、键的材料均为 45) ( [b, h, l] = [14, 9, 70] ), 轴径 d 为 50mm, 两键 180°均布连接工作方式为静连接, 受轻微冲击, 故[σσbbbb] = 100~120MPa, 校核该键连接:
σσbb = ∗ TT( ∗ mm)

∗ ww ww.ll ∗ dd = ∗ MMtttt( ∗ mmmm) ∗ . 55 ∗ (ll − bb) ∗ dd = . 00 < [σσbb ]
输出轴与联轴器的键连接可靠.
