RMSHE-MSH/Mechanical_Design_Course_Project_Open_Source/V带传动/VBeltDesignerData.xlsx

KA | 名义功率(kW) | 小轮转速(r/min) | 带型 | 基准宽度Bd | Hamin | Hfmin | e | Fmin | δmin | 轴孔径d
1.1 | 5.5 | 960 | A | 11 '/ 11 | 2.75 / 2.75 | 8.7 / 8.7 | 15 / 15 | 9 '/ 9 | 6 '/ 6 | 38 / 23.8688 | 警告: 大轮部分结构参数待定(特别是轴孔径)
小轮 / 大轮直径 | 传动比 | 带基准长度 | 中心矩 | 小轮包角(°) | 带速(m/s) | 带的根数 | 建议带轮结构 | 槽轮角φ(°) | 最小带轮宽B | 轮毂宽度L | 最小外径da | 轮毂直径d1 | 轮缘内径D1 | 腹板厚度C' | 预估毛坯质量(Kg)
100 / 200 | 2 | 890 | 203.428 | 151.835 | 5.02655 | 7 | 实心 / 孔板 | 34 / 38 | 108 / 108 | 76 / 47.7376 | 105.5 / 205.5 | 76 / 47.7376 | 70.6 / 170.6 | 0~0 / 15~27 | 6.12 / 9.25
100 / 200 | 2 | 990 | 253.946 | 157.438 | 5.02655 | 7 | 实心 / 孔板 | 34 / 38 | 108 / 108 | 76 / 47.7376 | 105.5 / 205.5 | 76 / 47.7376 | 70.6 / 170.6 | 0~0 / 15~27 | 6.12 / 9.25
100 / 200 | 2 | 990 | 254.381 | 157.476 | 5.02655 | 7 | 实心 / 孔板 | 34 / 38 | 108 / 108 | 76 / 47.7376 | 105.5 / 205.5 | 76 / 47.7376 | 70.6 / 170.6 | 0~0 / 15~27 | 6.12 / 9.25
100 / 200 | 2 | 990 | 254.751 | 157.509 | 5.02655 | 7 | 实心 / 孔板 | 34 / 38 | 108 / 108 | 76 / 47.7376 | 105.5 / 205.5 | 76 / 47.7376 | 70.6 / 170.6 | 0~0 / 15~27 | 6.12 / 9.25
100 / 200 | 2 | 1100 | 310.07 | 161.522 | 5.02655 | 7 | 实心 / 孔板 | 34 / 38 | 108 / 108 | 76 / 47.7376 | 105.5 / 205.5 | 76 / 47.7376 | 70.6 / 170.6 | 0~0 / 15~27 | 6.12 / 9.25
100 / 200 | 2 | 1100 | 310.348 | 161.538 | 5.02655 | 7 | 实心 / 孔板 | 34 / 38 | 108 / 108 | 76 / 47.7376 | 105.5 / 205.5 | 76 / 47.7376 | 70.6 / 170.6 | 0~0 / 15~27 | 6.12 / 9.25
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
280 / 560 | 2 | 2700 | 684.246 | 156.554 | 14.0743 | 2 | 实心 / 孔板 | 38 / 38 | 33 / 33 | 33 / 33 | 285.5 / 565.5 | 76 / 47.7376 | 250.6 / 530.6 | 0~0 / 5~8 | 4.69 / 8.14
280 / 560 | 2 | 2700 | 684.319 | 156.557 | 14.0743 | 2 | 实心 / 孔板 | 38 / 38 | 33 / 33 | 33 / 33 | 285.5 / 565.5 | 76 / 47.7376 | 250.6 / 530.6 | 0~0 / 5~8 | 4.69 / 8.14
280 / 560 | 2 | 2700 | 684.39 | 156.559 | 14.0743 | 2 | 实心 / 孔板 | 38 / 38 | 33 / 33 | 33 / 33 | 285.5 / 565.5 | 76 / 47.7376 | 250.6 / 530.6 | 0~0 / 5~8 | 4.69 / 8.14
