RMSHE-MSH/Mechanical_Design_Course_Project_Open_Source/圆柱斜齿轮副/数据/弯曲疲劳寿命系数.png

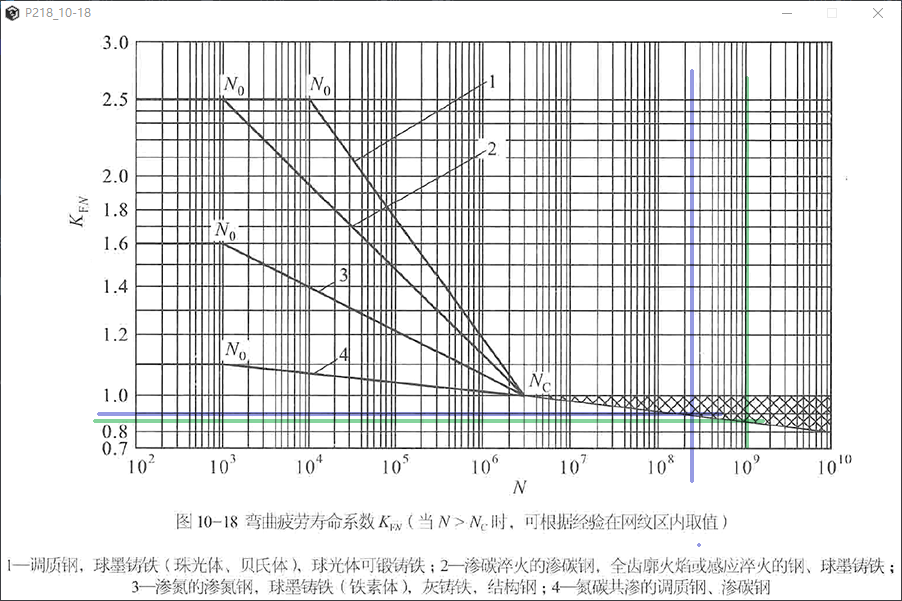
圆柱斜齿轮副/数据/弯曲疲劳寿命系数.png
