RMSHE-MSH/Mechanical_Design_Course_Project_Open_Source/圆柱斜齿轮副/齿轮副设计程序/源代码/控制台指令说明/IMGDATA/P208_10-13.png

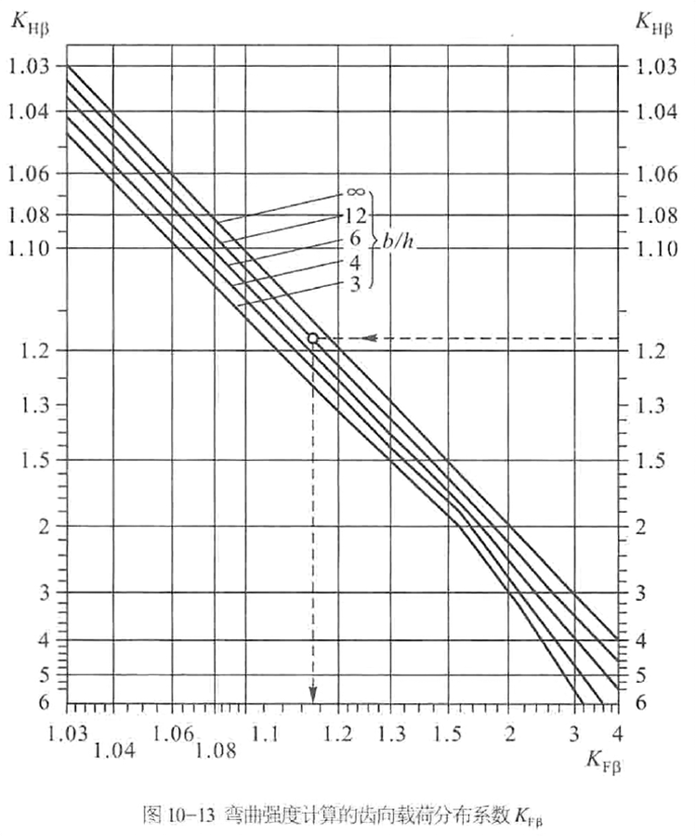
圆柱斜齿轮副/齿轮副设计程序/源代码/控制台指令说明/IMGDATA/P208_10-13.png
