RMSHE-MSH/Mechanical_Design_Course_Project_Open_Source/轴设计/输入轴/结构设计/iAxis-模型.png

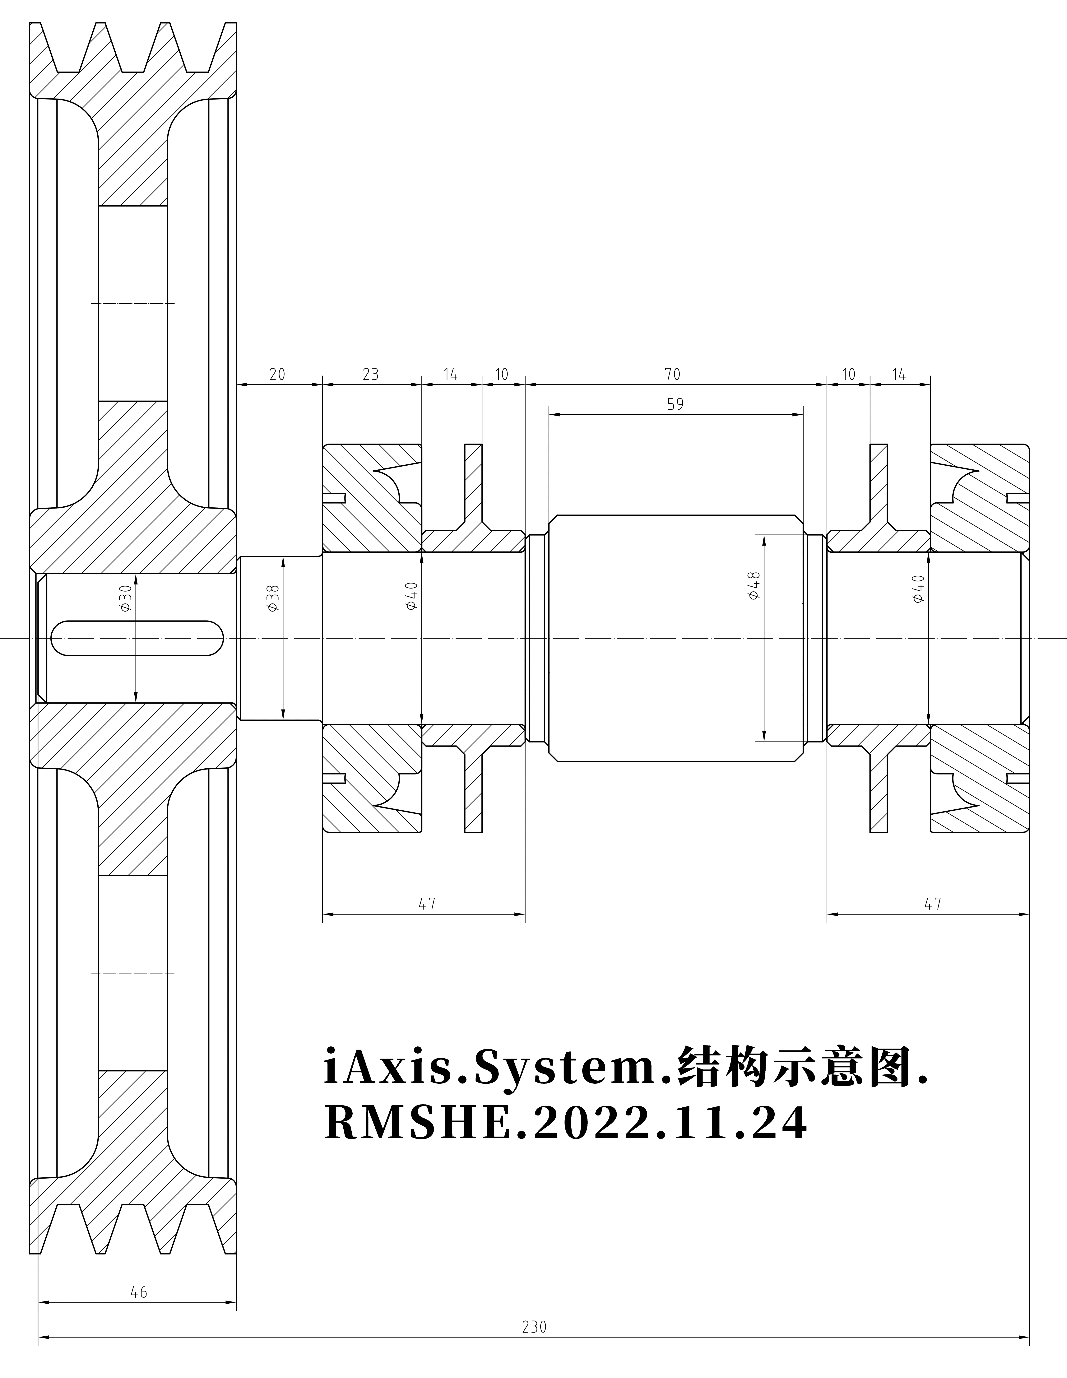
轴设计/输入轴/结构设计/iAxis-模型.png
