RMSHE-MSH/Mechanical_Design_Course_Project_Open_Source/轴设计/输入轴/结构设计/结构示意图.png

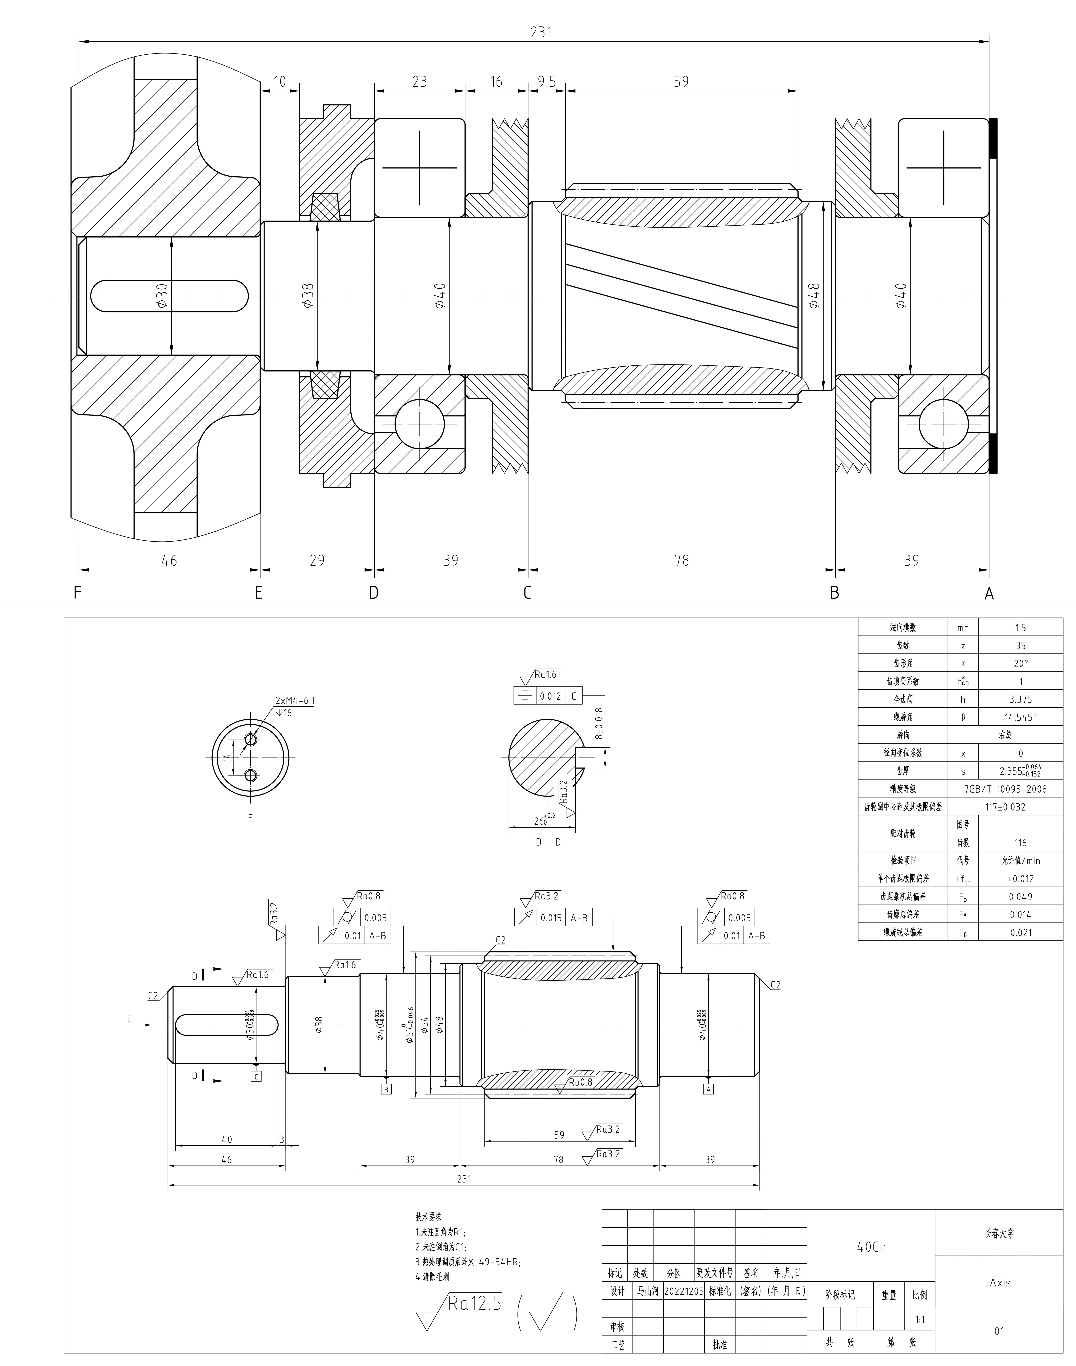
轴设计/输入轴/结构设计/结构示意图.png
