RMSHE-MSH/Mechanical_Design_Course_Project_Open_Source/轴设计/输出轴/轴承/7212B.png

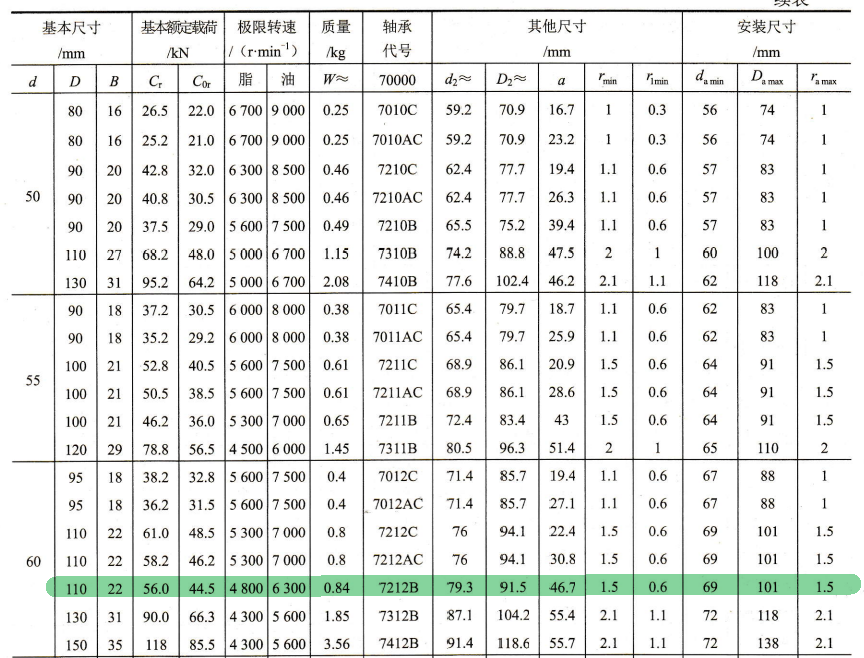
轴设计/输出轴/轴承/7212B.png
