RMSHE-MSH/Mechanical_Design_Course_Project_Open_Source/V带传动/装配(SOLIDWORK)/实心轮_孔板轮.STEP

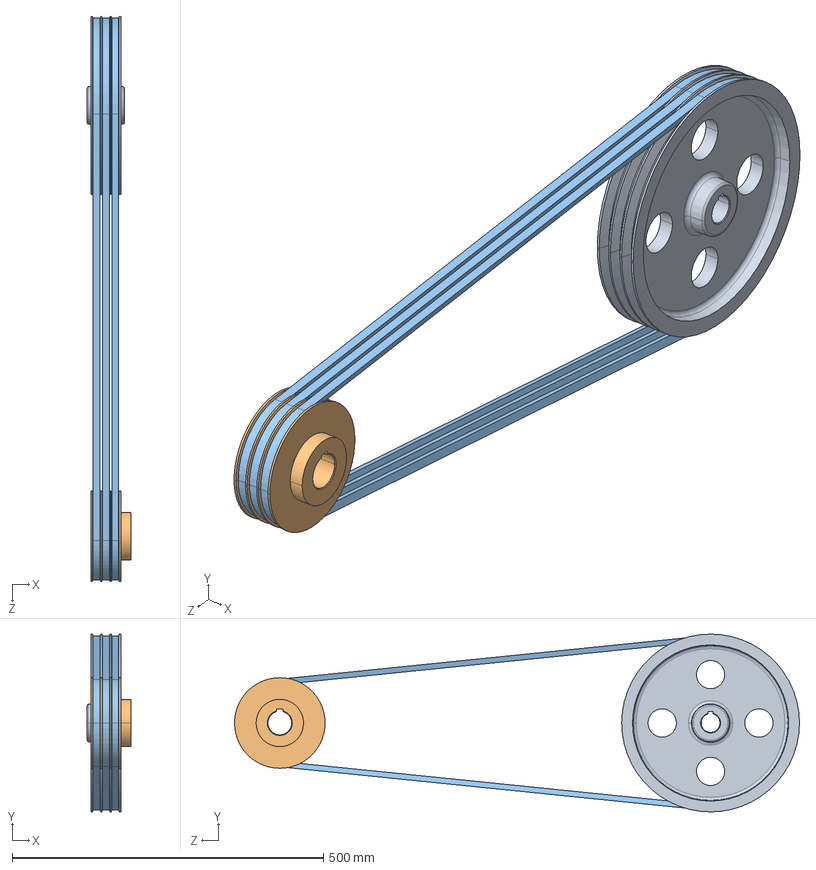
[picture p140: CAD file, 2023-09-12]
V带传动/装配(SOLIDWORK)/实心轮_孔板轮.STEP
70.0 x 285.5 x 907.1 mm
大带轮_孔板轮_A
小带轮_实心轮
sk_皮带 x 3
