RMSHE-MSH/Mechanical_Design_Course_Project_Open_Source/箱体/LowerBox.stp

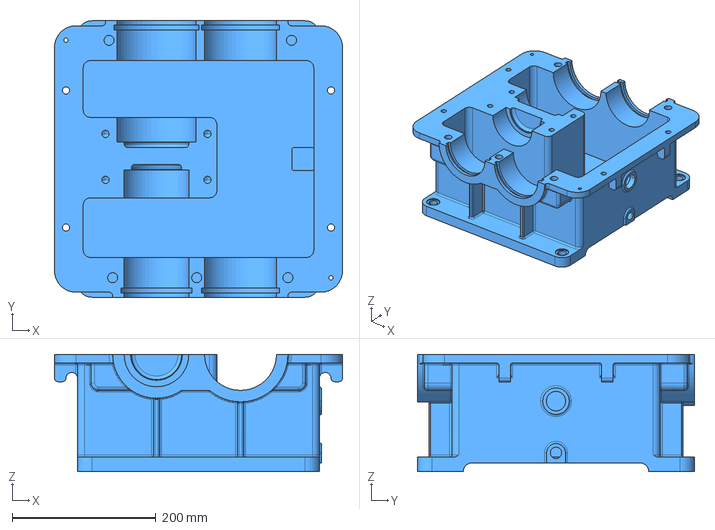
[picture p141: CAD file, 2023-09-12]
箱体/LowerBox.stp
401.0 x 385.0 x 163.0 mm
