RMSHE-MSH/Mechanical_Design_Course_Project_Open_Source/轴设计/中间轴/三维/Gear2.stp

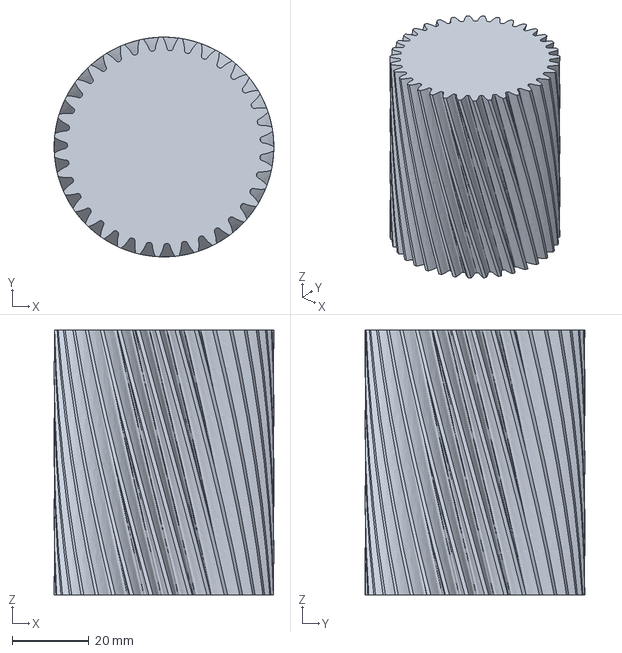
[picture p142: CAD file, 2023-09-12]
轴设计/中间轴/三维/Gear2.stp
57.2 x 57.2 x 69.0 mm
