RMSHE-MSH/Mechanical_Design_Course_Project_Open_Source/轴设计/中间轴/结构设计/cAxis_Product.dxf

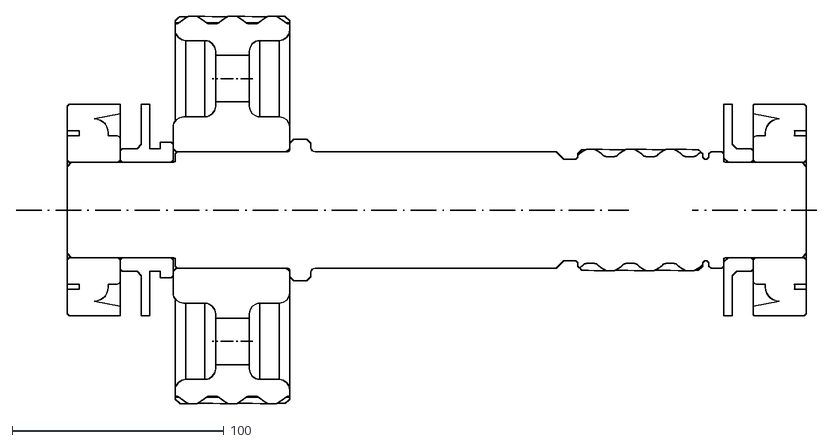
[picture p143: CAD file, 2023-09-12]
轴设计/中间轴/结构设计/cAxis_Product.dxf
378.0 x 182.7
