RMSHE-MSH/Mechanical_Design_Course_Project_Open_Source/轴设计/中间轴/轴承/7309B.step

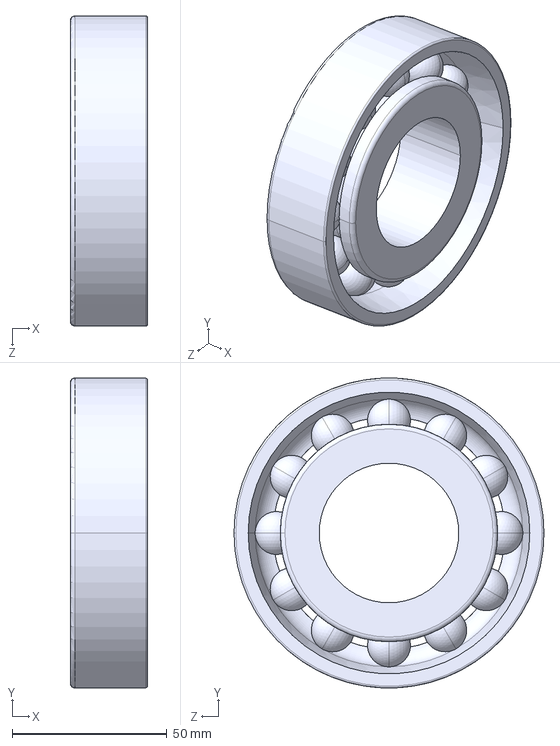
[picture p144: CAD file, 2023-09-12]
轴设计/中间轴/轴承/7309B.step
25.0 x 100.0 x 100.0 mm
