RMSHE-MSH/Mechanical_Design_Course_Project_Open_Source/轴设计/输入轴/结构设计/iAxis.dxf

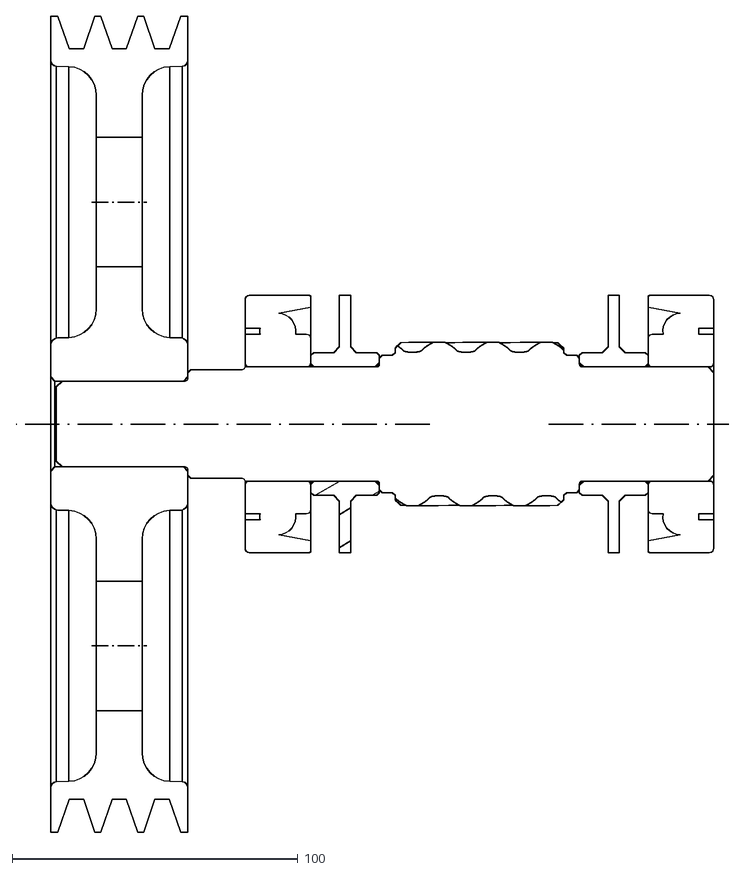
[picture p145: CAD file, 2023-09-12]
轴设计/输入轴/结构设计/iAxis.dxf
249.3 x 285.5
