RMSHE-MSH/Mechanical_Design_Course_Project_Open_Source/轴设计/输入轴/轴承/7308B.step

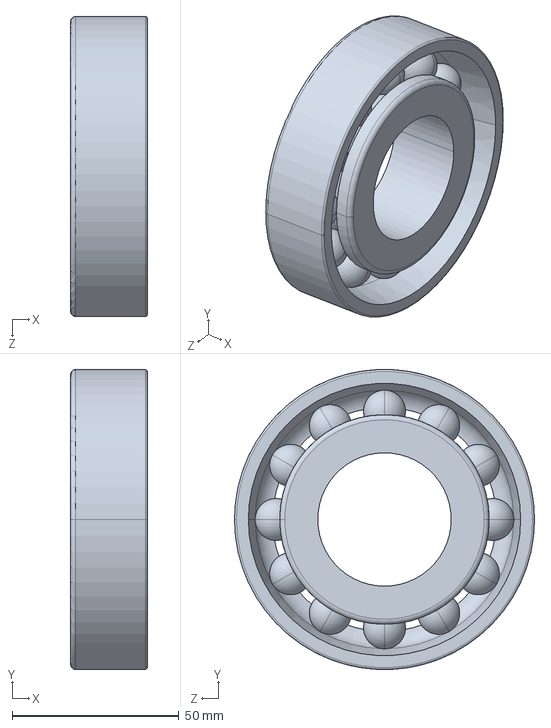
[picture p146: CAD file, 2023-09-12]
轴设计/输入轴/轴承/7308B.step
23.0 x 90.0 x 90.0 mm
