RMSHE-MSH/Mechanical_Design_Course_Project_Open_Source/轴设计/输入轴/键/A 8X7X40.step

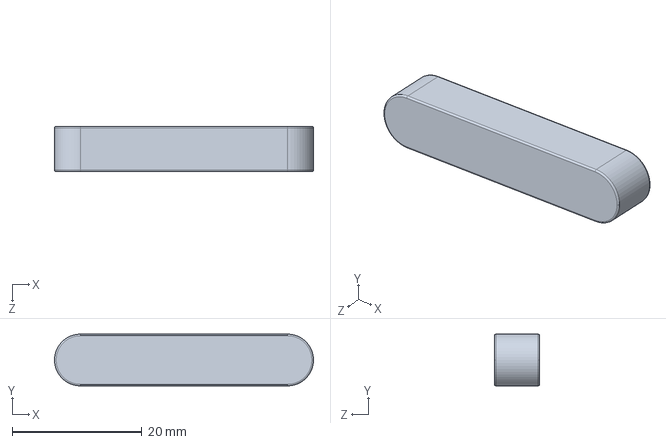
[picture p147: CAD file, 2023-09-12]
轴设计/输入轴/键/A 8X7X40.step
40.0 x 8.00 x 7.00 mm
