RMSHE-MSH/Mechanical_Design_Course_Project_Open_Source/轴设计/输出轴/结构设计/oAxis.dxf

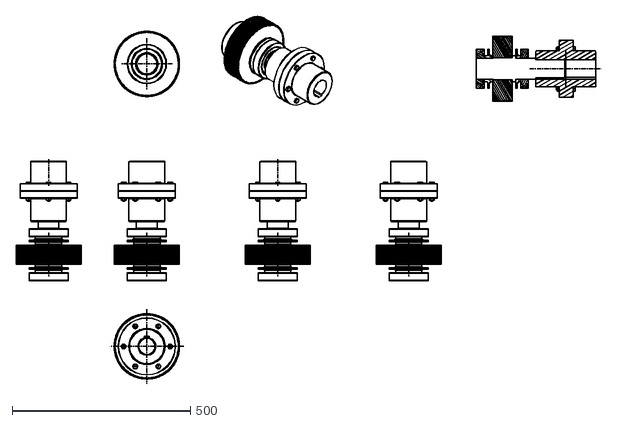
[picture p148: CAD file, 2023-09-12]
轴设计/输出轴/结构设计/oAxis.dxf
1641.9 x 1028.4
