RMSHE-MSH/Mechanical_Design_Course_Project_Open_Source/轴设计/输出轴/轴承/oAxis-7212B.step

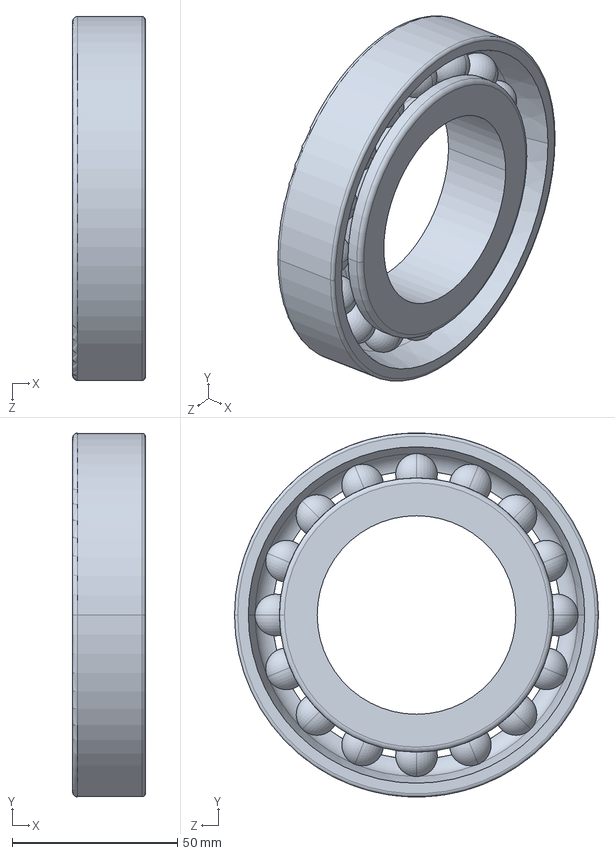
[picture p149: CAD file, 2023-09-12]
轴设计/输出轴/轴承/oAxis-7212B.step
22.0 x 110.0 x 110.0 mm
