RMSHE-MSH/Mechanical_Design_Course_Project_Open_Source/V带传动/装配(SOLIDWORK)/小带轮.STEP

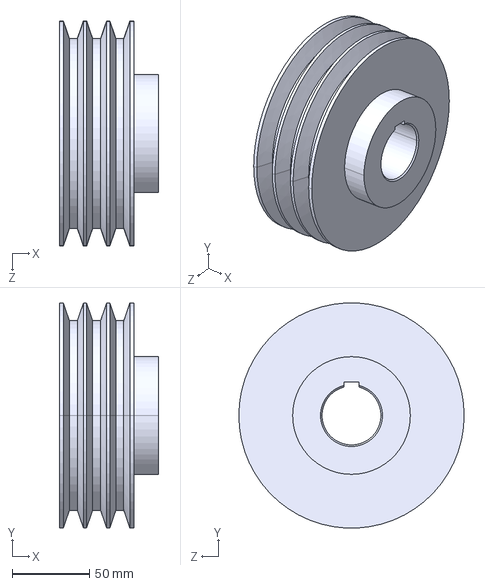
[picture p150: CAD file, 2023-09-12]
V带传动/装配(SOLIDWORK)/小带轮.STEP
64.0 x 145.3 x 145.5 mm
