RMSHE-MSH/Mechanical_Design_Course_Project_Open_Source/箱体/UpperBox.stp

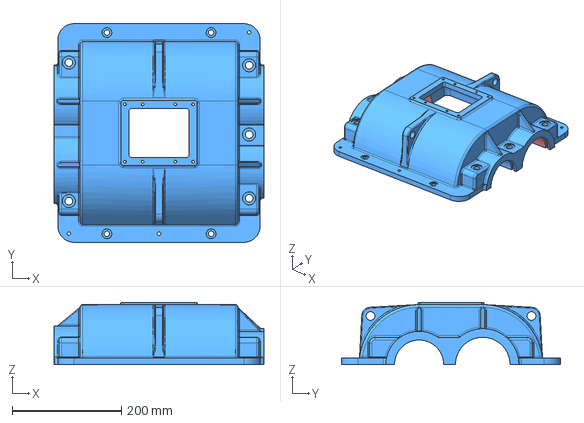
[picture p151: CAD file, 2023-09-12]
箱体/UpperBox.stp
385.0 x 401.0 x 114.0 mm
