RMSHE-MSH/Mechanical_Design_Course_Project_Open_Source/轴设计/中间轴/结构设计/cAxis.dxf

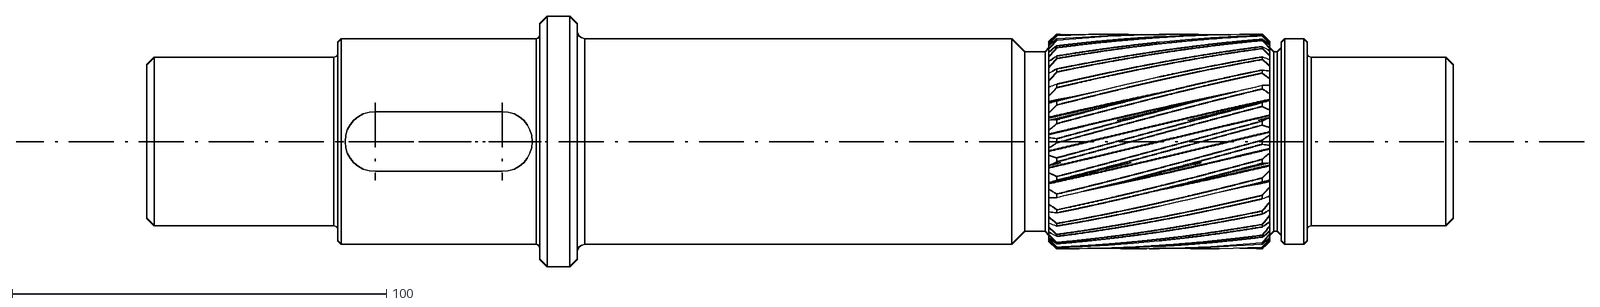
[picture p152: CAD file, 2023-09-12]
轴设计/中间轴/结构设计/cAxis.dxf
418.8 x 67.0
