RMSHE-MSH/Mechanical_Design_Course_Project_Open_Source/轴设计/输入轴/结构设计/BWheel.STEP

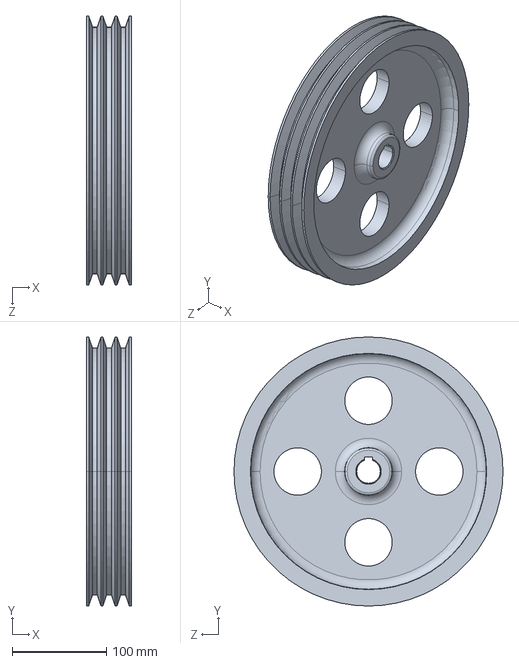
[picture p153: CAD file, 2023-09-12]
轴设计/输入轴/结构设计/BWheel.STEP
48.0 x 285.5 x 285.5 mm
