RMSHE-MSH/Mechanical_Design_Course_Project_Open_Source/V带传动/装配(SOLIDWORK)/大带轮_孔板轮.SLDPRT

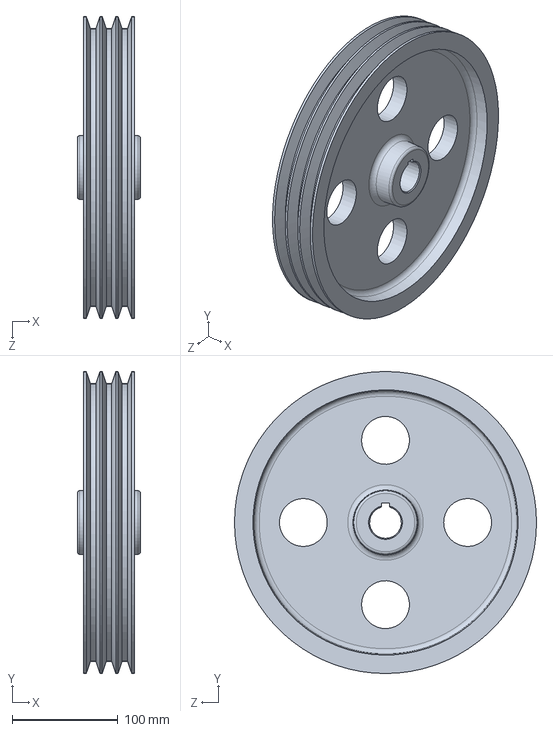
[picture p154: CAD file, 2023-09-12]
V带传动/装配(SOLIDWORK)/大带轮_孔板轮.SLDPRT
60.0 x 285.5 x 285.5 mm
