RMSHE-MSH/Mechanical_Design_Course_Project_Open_Source/轴设计/输入轴/结构设计/iAxis2.dxf

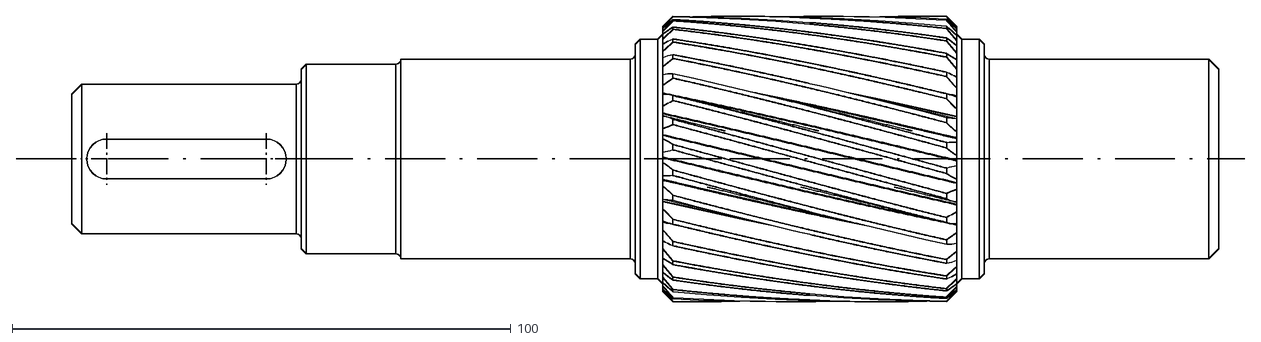
[picture p155: CAD file, 2023-09-12]
轴设计/输入轴/结构设计/iAxis2.dxf
246.4 x 57.2
