RMSHE-MSH/Mechanical_Design_Course_Project_Open_Source/V带传动/装配(SOLIDWORK)/sk_皮带.SLDPRT

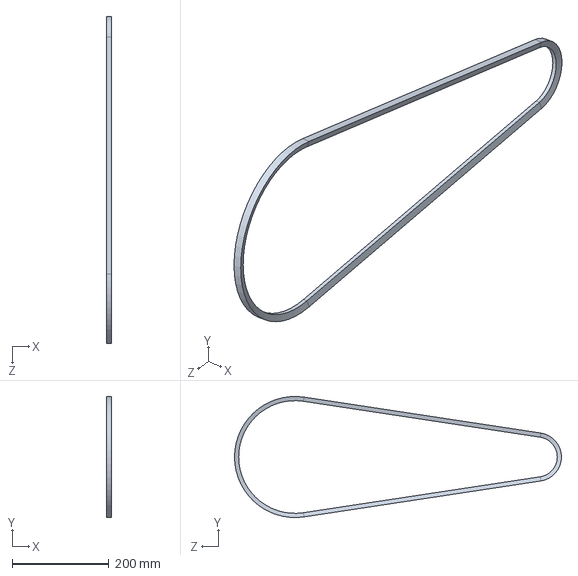
[picture p156: CAD file, 2023-09-12]
V带传动/装配(SOLIDWORK)/sk_皮带.SLDPRT
11.0 x 249.8 x 675.0 mm
