RMSHE-MSH/Mechanical_Design_Course_Project_Open_Source/(list of files, cad)

Other CAD files:
V带传动/装配(SOLIDWORK)/大带轮.STEP
V带传动/装配(SOLIDWORK)/小带轮_实心轮.SLDPRT
V带传动/BiglWheel.CATPart
V带传动/SmallWheel.CATPart
V带传动/VBelt_Product.CATProduct
V带传动/_NPart#2068.CATPart
V带传动/装配(SOLIDWORK)/实心轮_孔板轮.SLDASM
圆柱斜齿轮副/Gear0.CATPart
圆柱斜齿轮副/Gear2.CATPart
箱体/LowerBox.CATPart
箱体/UpperBox.CATPart
轴设计/中间轴/三维/Part1.CATPart
轴设计/中间轴/三维/cAxis.CATPart
轴设计/中间轴/三维/cAxis_System.CATProduct
轴设计/中间轴/三维/cBushing.CATPart
轴设计/中间轴/三维/cBushing2.CATPart
轴设计/中间轴/三维/cCover.CATPart
轴设计/中间轴/三维/cCoverR.CATPart
轴设计/中间轴/三维/cGasket.CATPart
轴设计/中间轴/结构设计/cAxis.CATPart
轴设计/中间轴/结构设计/cAxis_Product.CATProduct
轴设计/中间轴/结构设计/cBushingL.CATPart
轴设计/中间轴/结构设计/cBushingR.CATPart
轴设计/中间轴/轴承/7309B.CATPart
轴设计/中间轴/键/A16X10X50.CATPart
轴设计/轴系装配/Axis_Assemble.CATProduct
轴设计/轴系装配/GYS7_J1B1_50X84.CATPart
轴设计/输入轴/三维/7308B.CATPart
轴设计/输入轴/三维/A 8X7X40.CATPart
轴设计/输入轴/三维/Symmetry of 7308 B.CATPart
轴设计/输入轴/三维/Symmetry of iBushing.CATPart
轴设计/输入轴/三维/iAxis.CATPart
轴设计/输入轴/三维/iAxis_System.CATProduct
轴设计/输入轴/三维/iBushing.CATPart
轴设计/输入轴/三维/iCover.CATPart
轴设计/输入轴/三维/iGasket.CATPart
轴设计/输入轴/结构设计/7308 B.1.CATPart
轴设计/输入轴/结构设计/7308B.CATPart
轴设计/输入轴/结构设计/A 8X7X40.CATPart
轴设计/输入轴/结构设计/BWheel.CATPart
轴设计/输入轴/结构设计/Symmetry of iBushingL_1.CATPart
轴设计/输入轴/结构设计/iAxis.CATPart
轴设计/输入轴/结构设计/iAxis_Product.CATProduct
轴设计/输入轴/结构设计/iBushingL.CATPart
轴设计/输出轴/三维/Part1.CATPart
轴设计/输出轴/三维/Part2.CATPart
轴设计/输出轴/三维/oAxis.CATPart
轴设计/输出轴/三维/oAxis_System.CATProduct
轴设计/输出轴/三维/oBushingL.CATPart
轴设计/输出轴/三维/oBushingR.CATPart
轴设计/输出轴/三维/oCover.CATPart
轴设计/输出轴/三维/oGasket.CATPart
轴设计/输出轴/结构设计/GYS7_J1B1_50X84.CATPart
轴设计/输出轴/结构设计/Part1.CATPart
轴设计/输出轴/结构设计/Part2.CATPart
轴设计/输出轴/结构设计/oAxis2.CATPart
轴设计/输出轴/结构设计/oAxis_Product.CATProduct
轴设计/输出轴/结构设计/oBushingL.CATPart
轴设计/输出轴/结构设计/oBushingR.CATPart
轴设计/输出轴/轴承/oAxis-7212B.CATPart
轴设计/输出轴/键/A 18x11x56.CATPart
轴设计/输出轴/键/A14x9x70.CATPart
