RMSHE-MSH/Mechanical_Design_Course_Project_Open_Source/总装配图.pdf

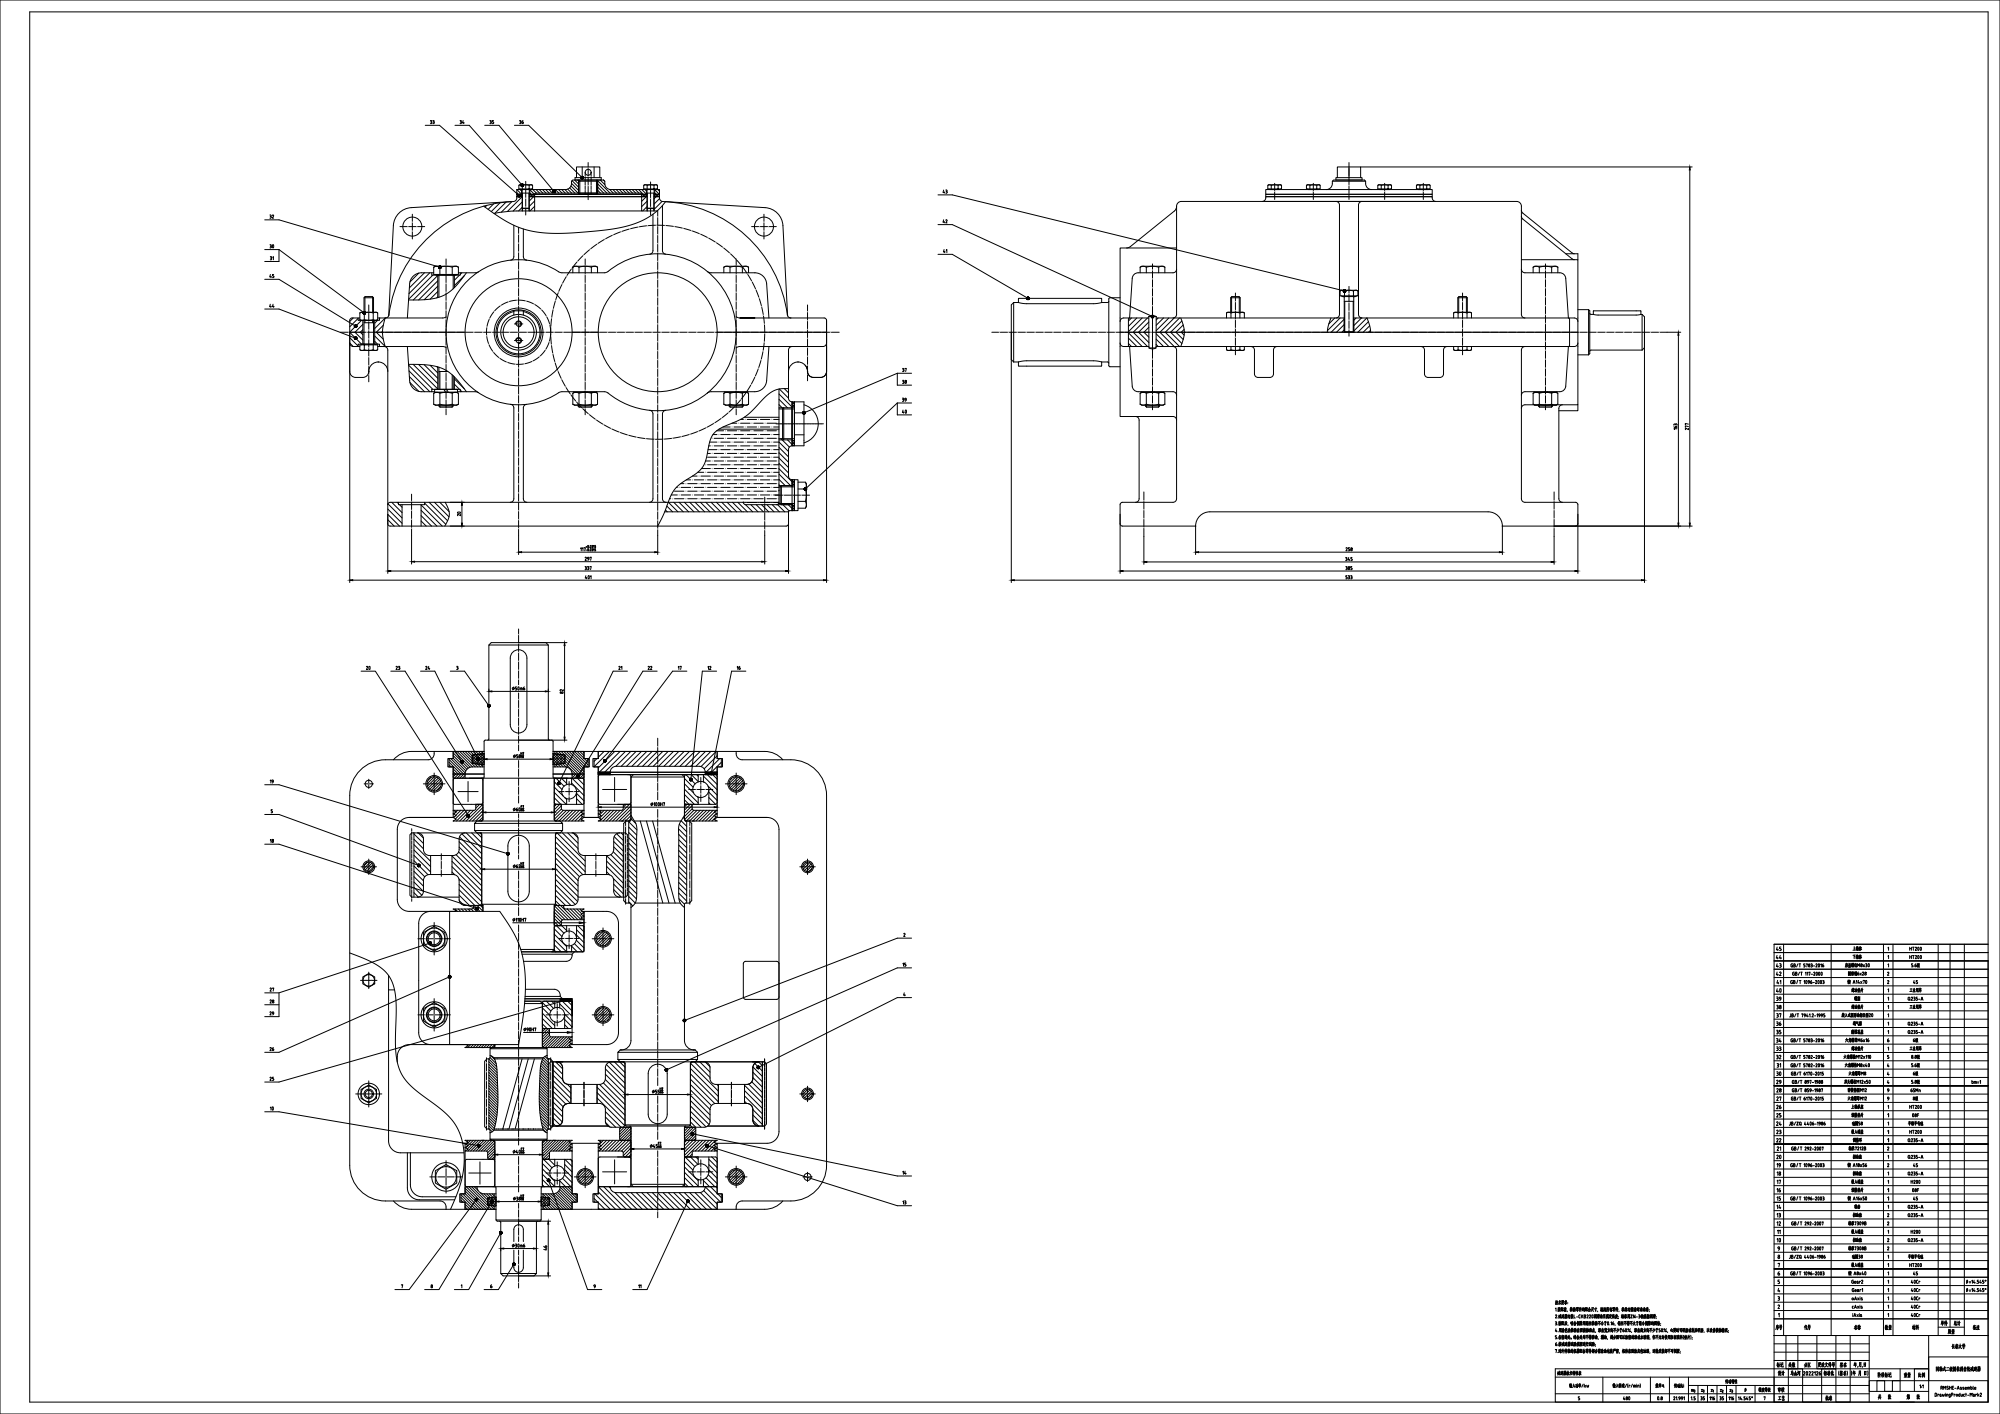
[picture p157: page 1]
