RMSHE-MSH/Mechanical_Design_Course_Project_Open_Source/中间轴零件图.pdf

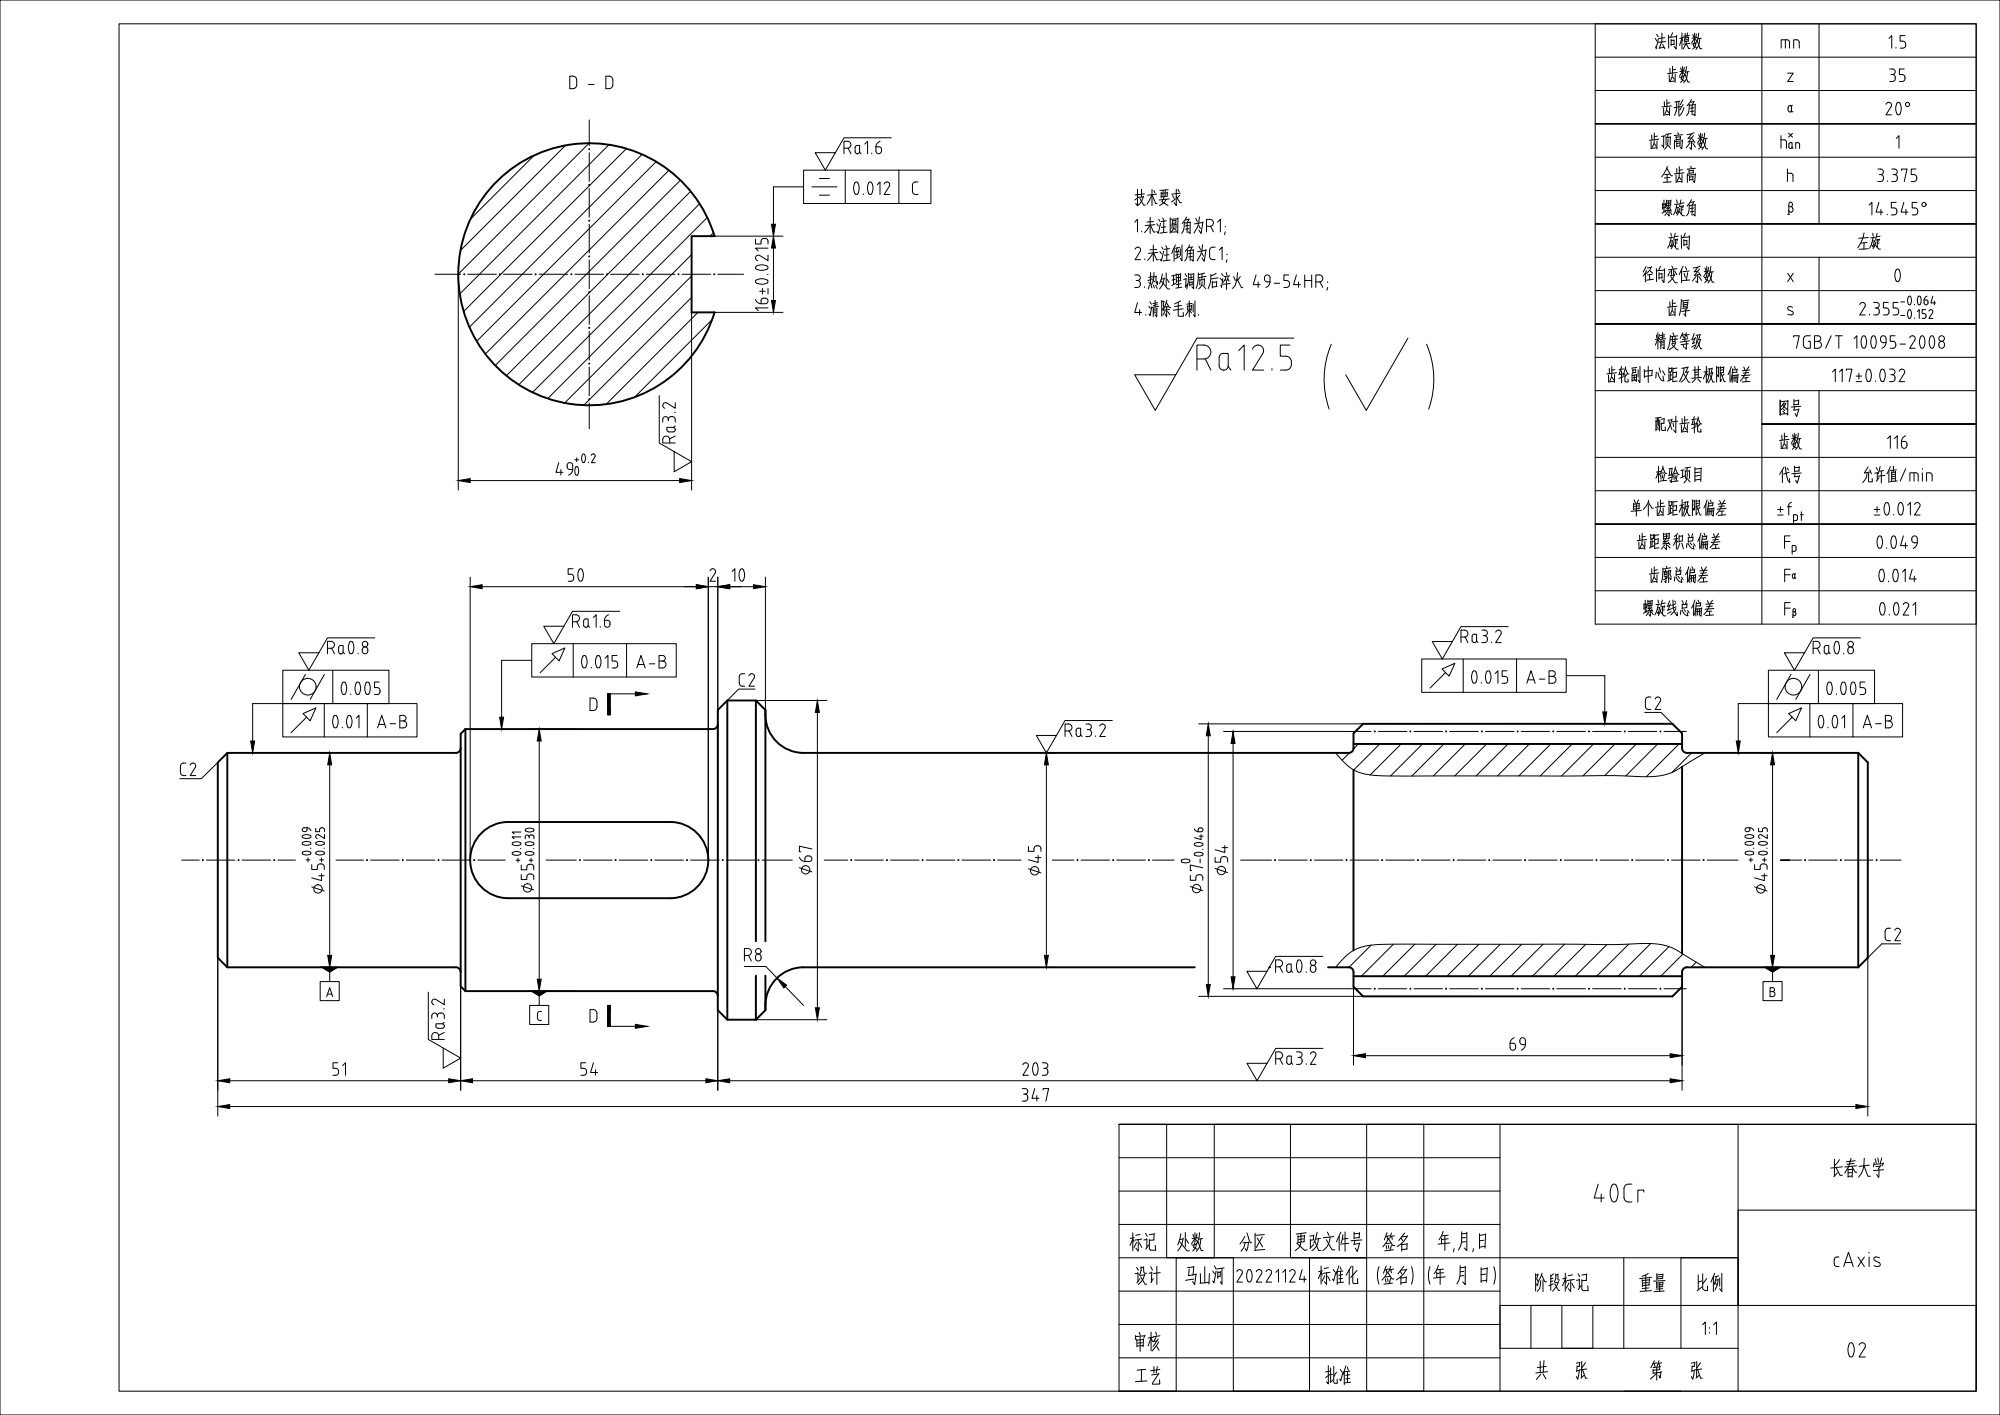
[picture p158: page 1]
