RMSHE-MSH/Mechanical_Design_Course_Project_Open_Source/低速级齿轮零件图.pdf

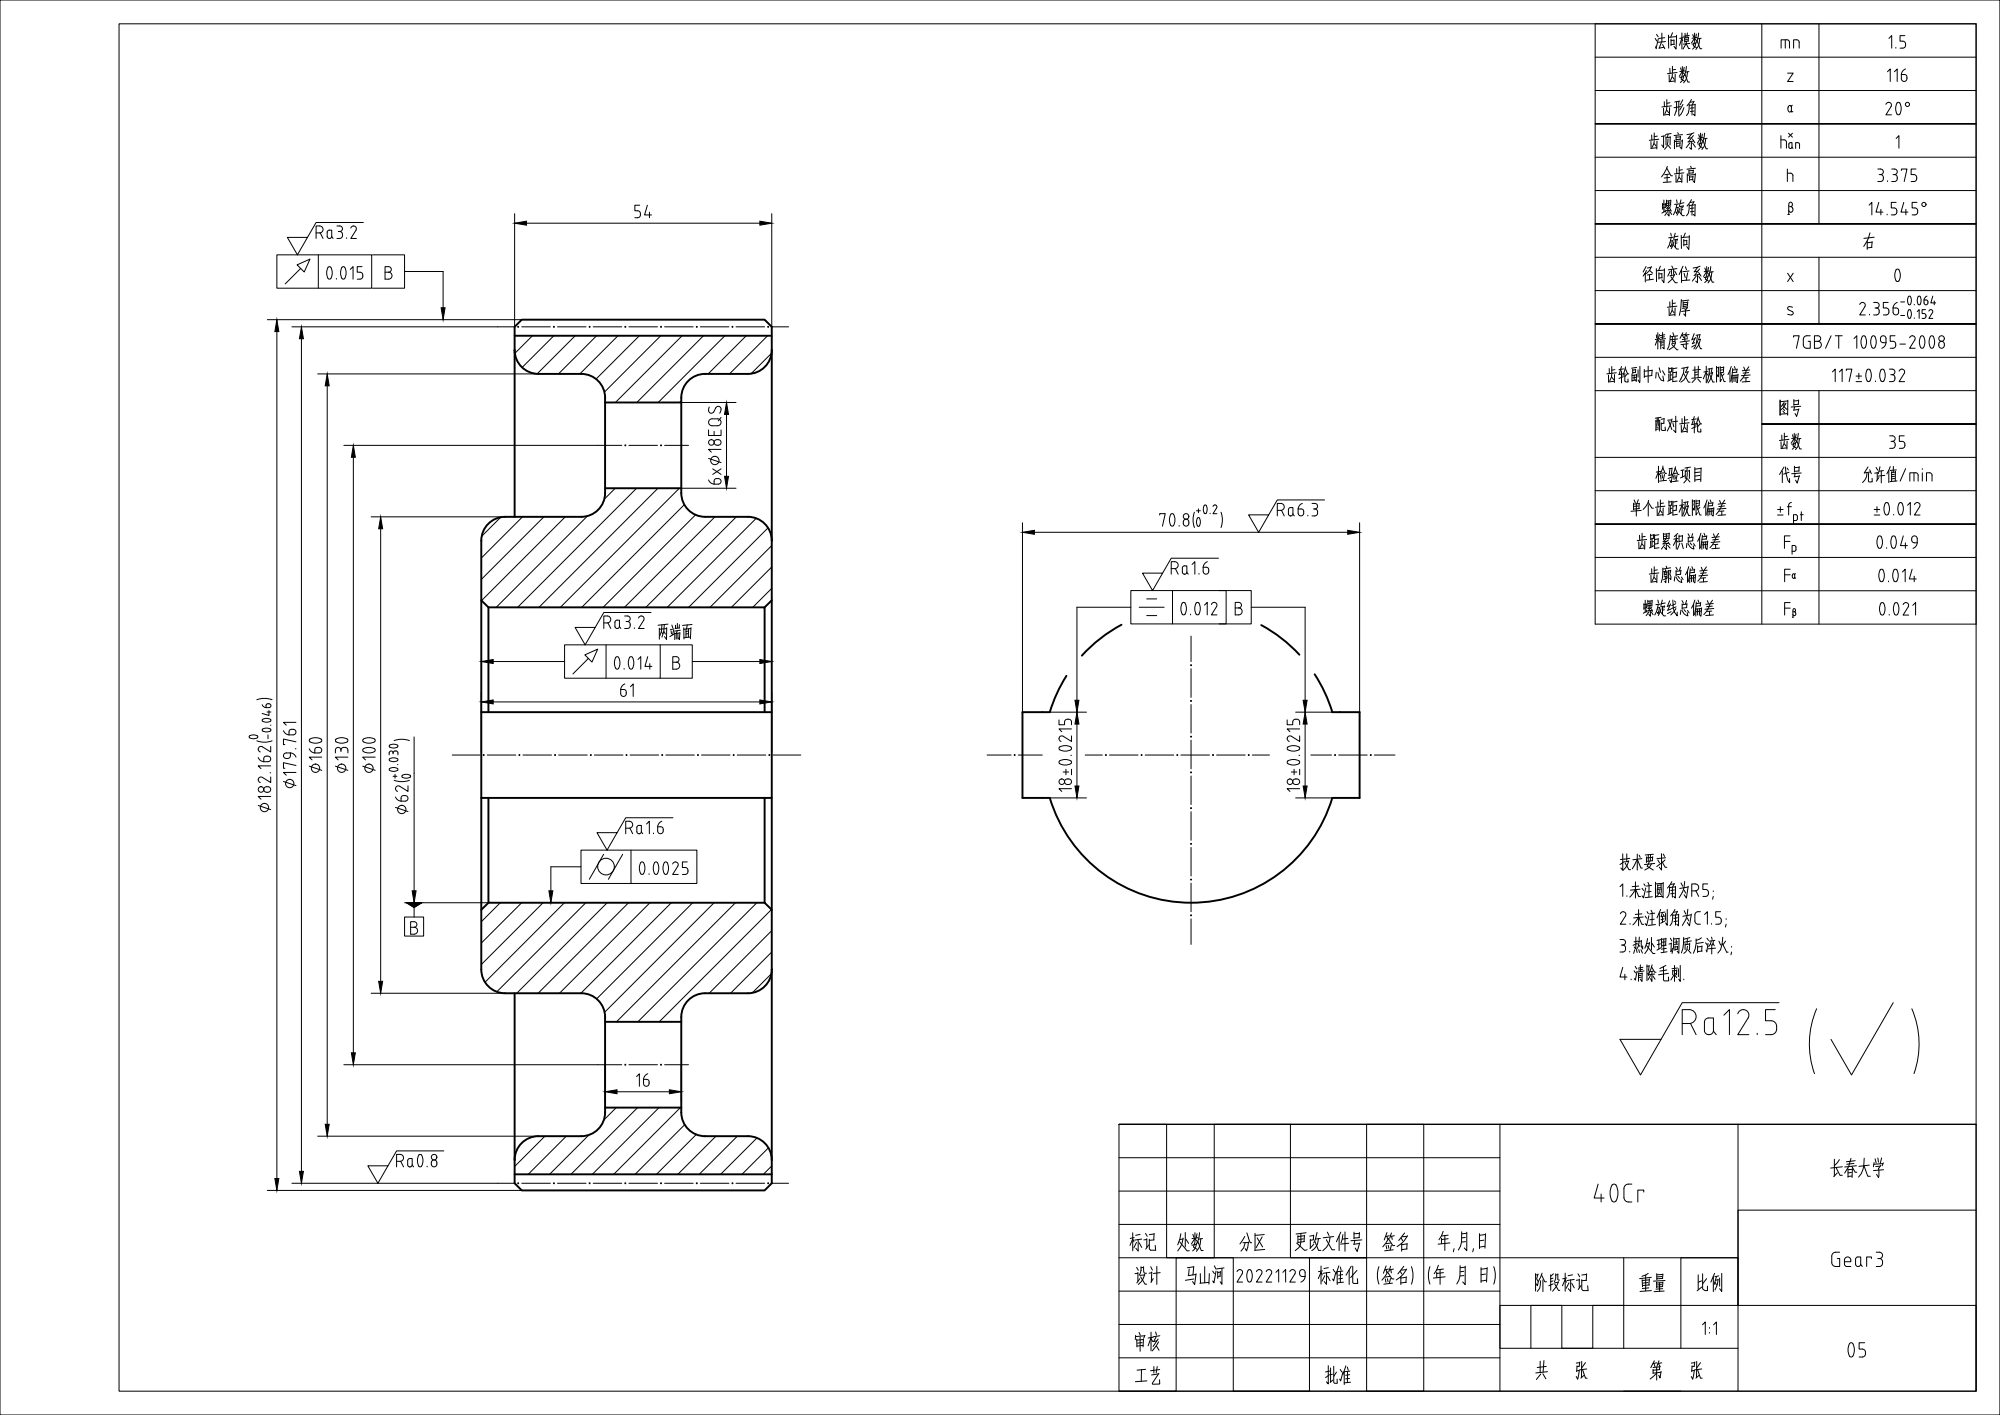
[picture p159: page 1]
