RMSHE-MSH/Mechanical_Design_Course_Project_Open_Source/输入轴零件图.pdf

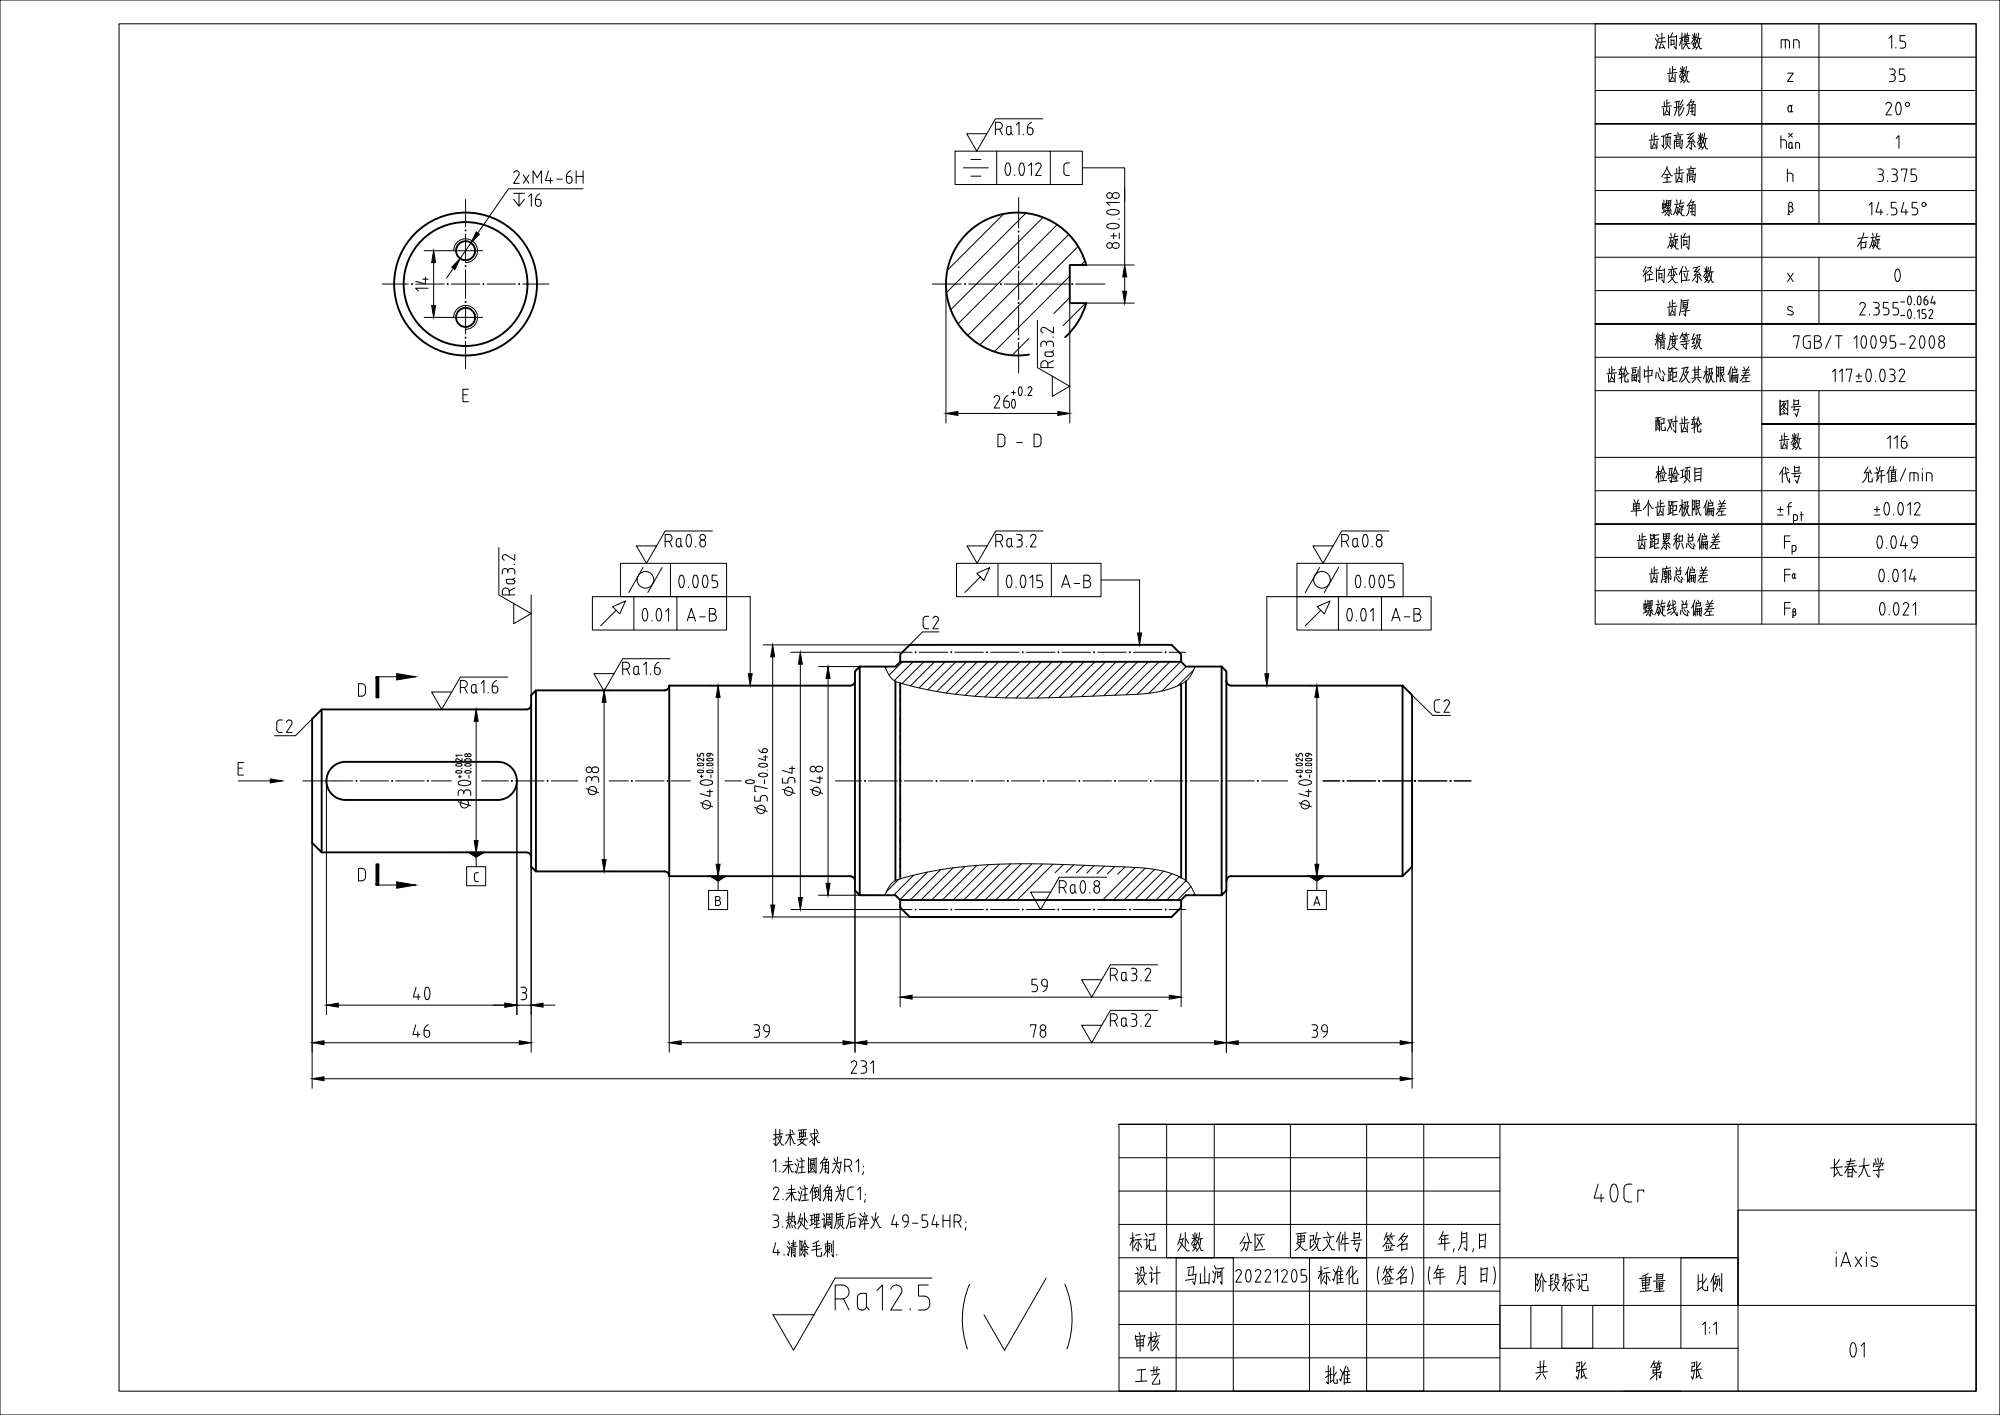
[picture p160: page 1]
