RMSHE-MSH/Mechanical_Design_Course_Project_Open_Source/输出轴零件图.pdf

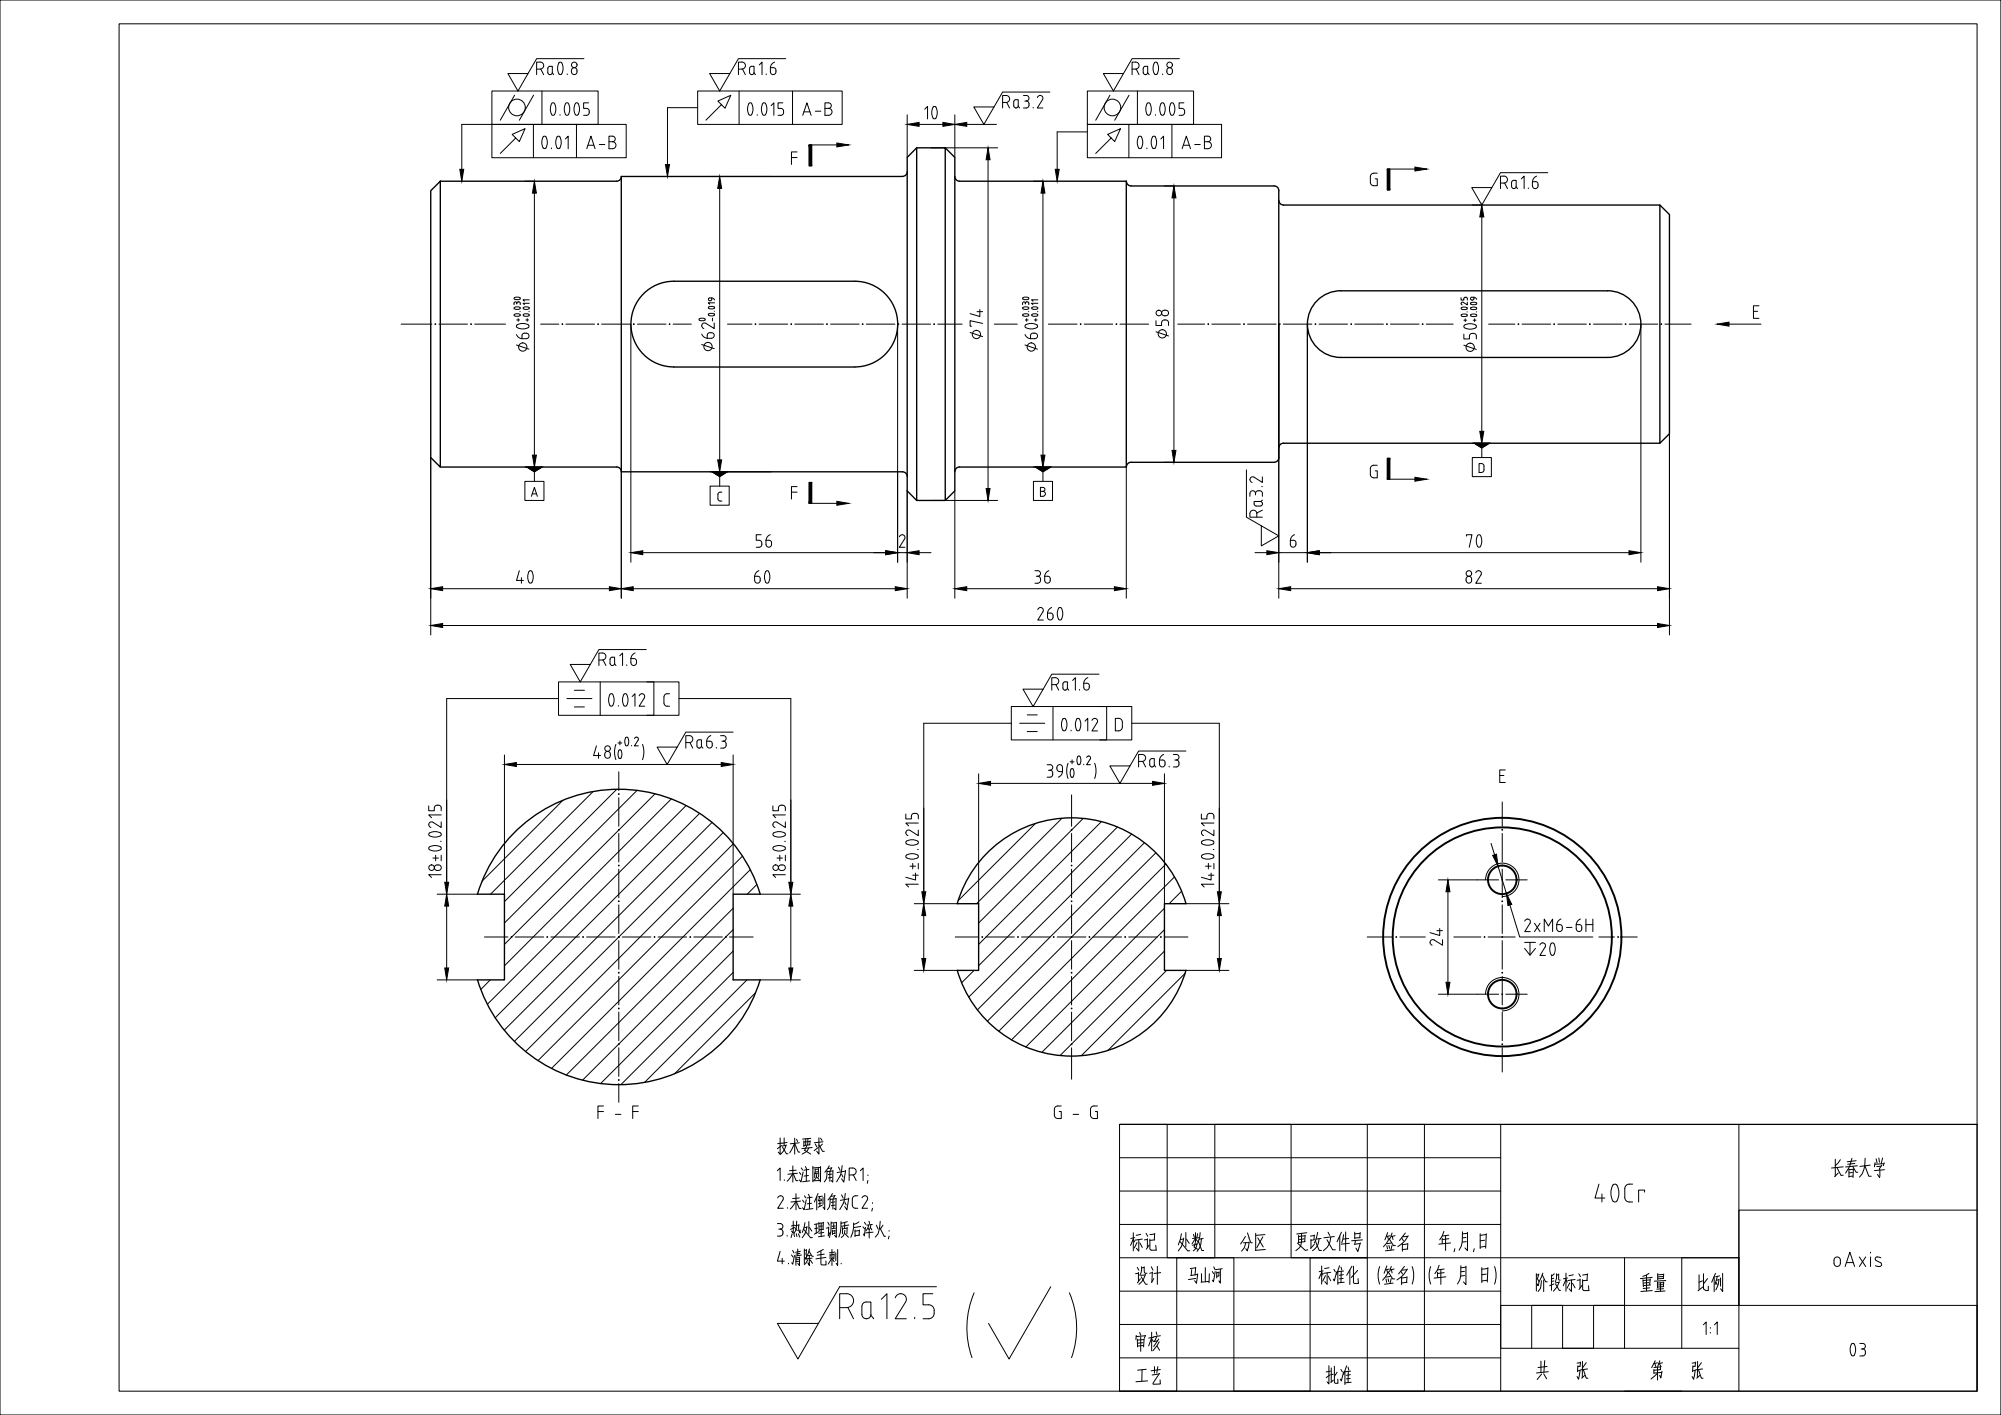
[picture p161: page 1]
