RMSHE-MSH/Mechanical_Design_Course_Project_Open_Source/高速级齿轮零件图.pdf

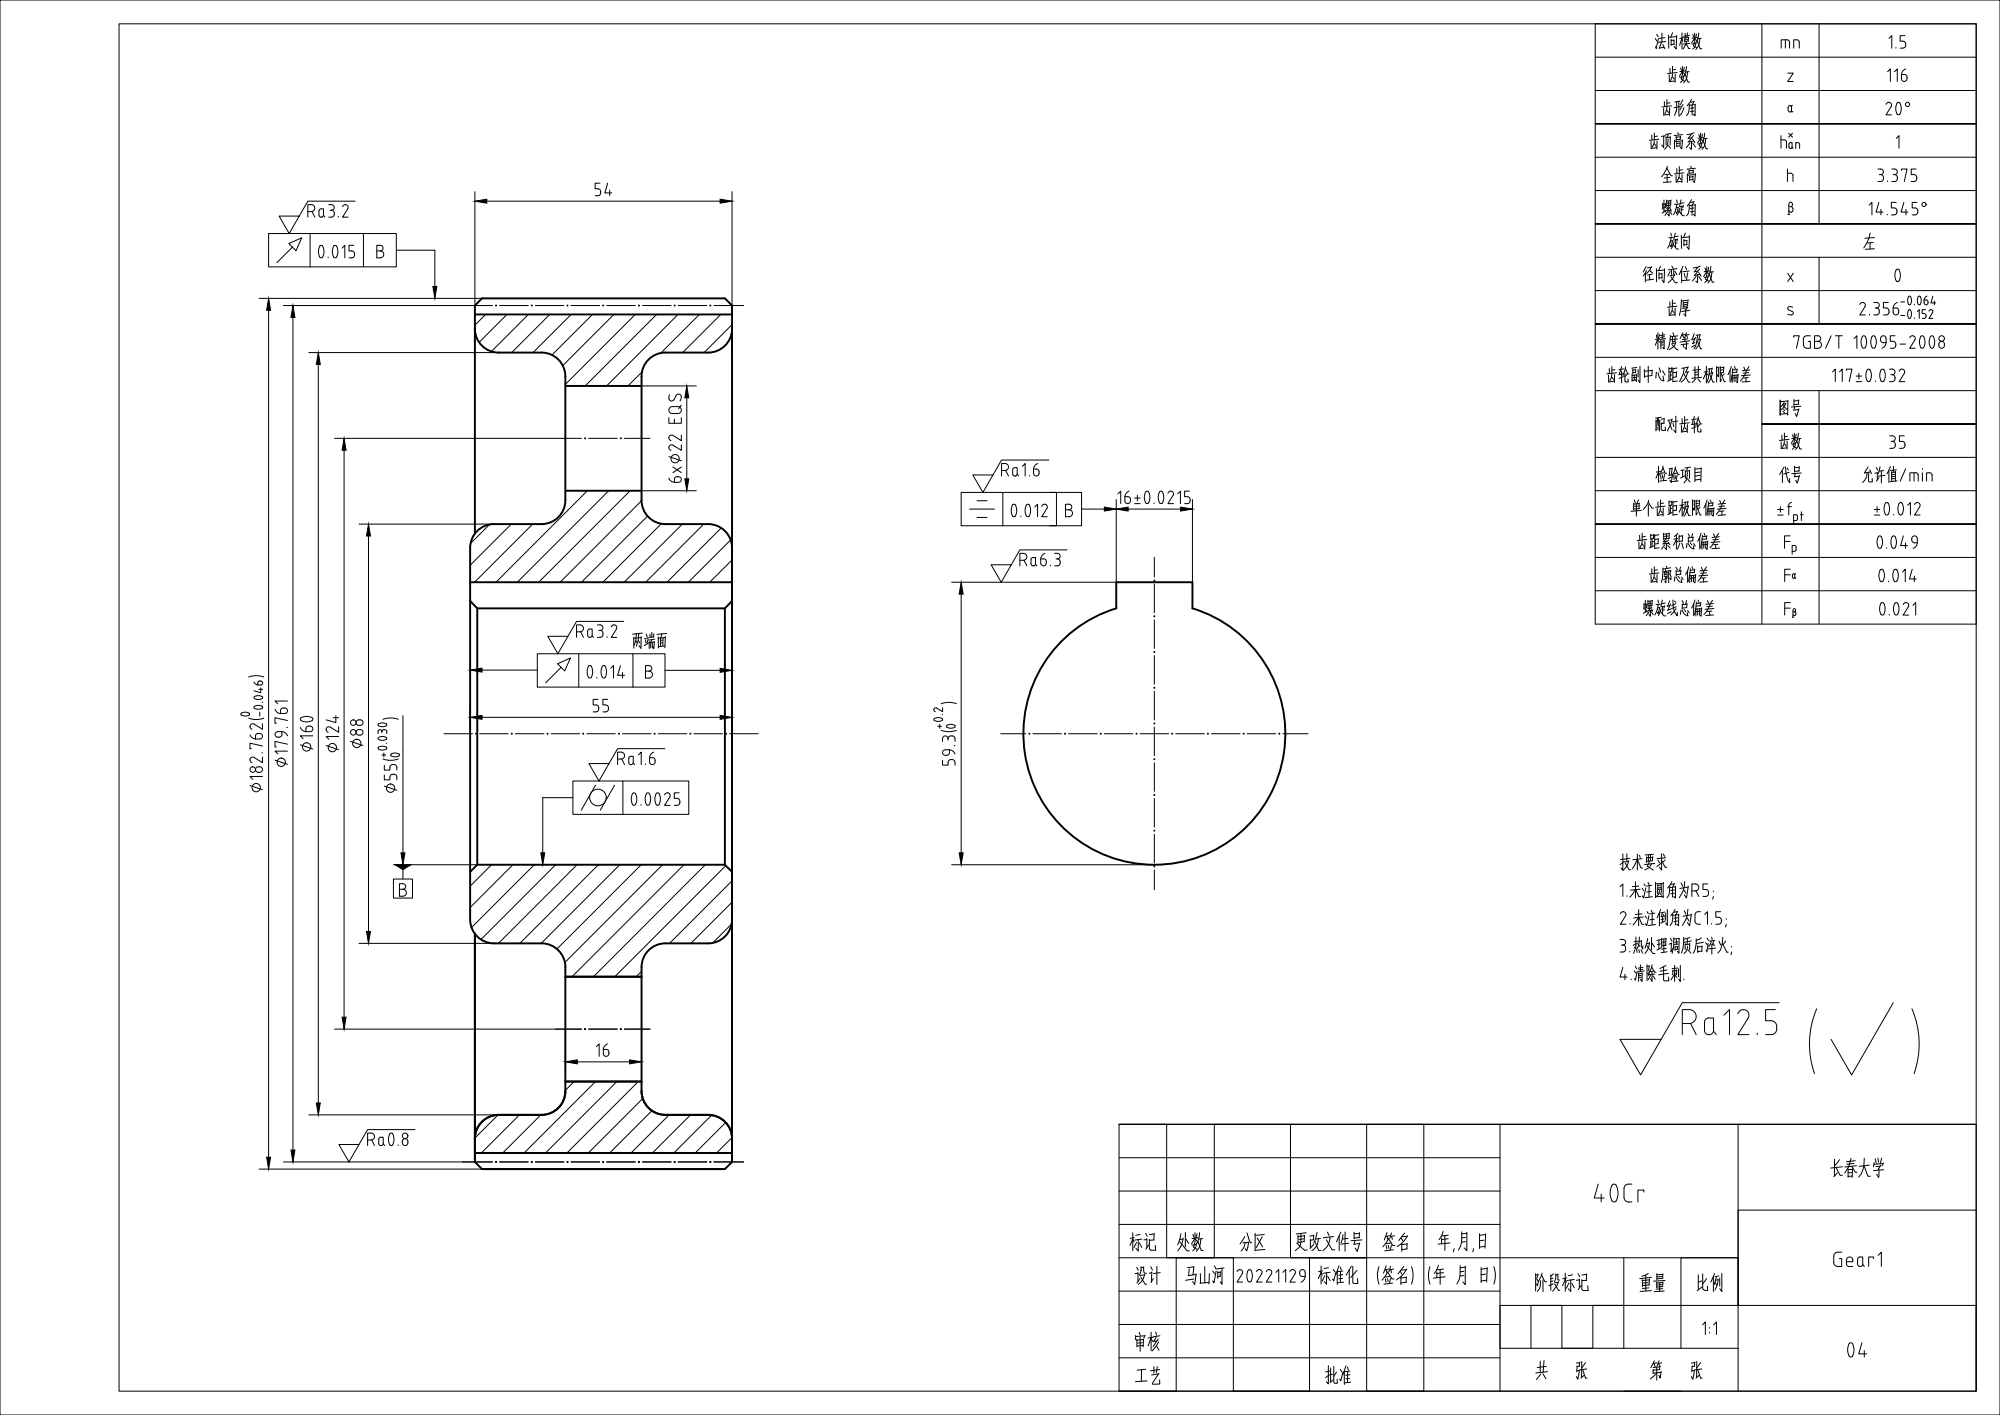
[picture p162: page 1]
