RMSHE-MSH/Mechanical_Design_Course_Project_Open_Source/总体传动方案/传动方案.pdf

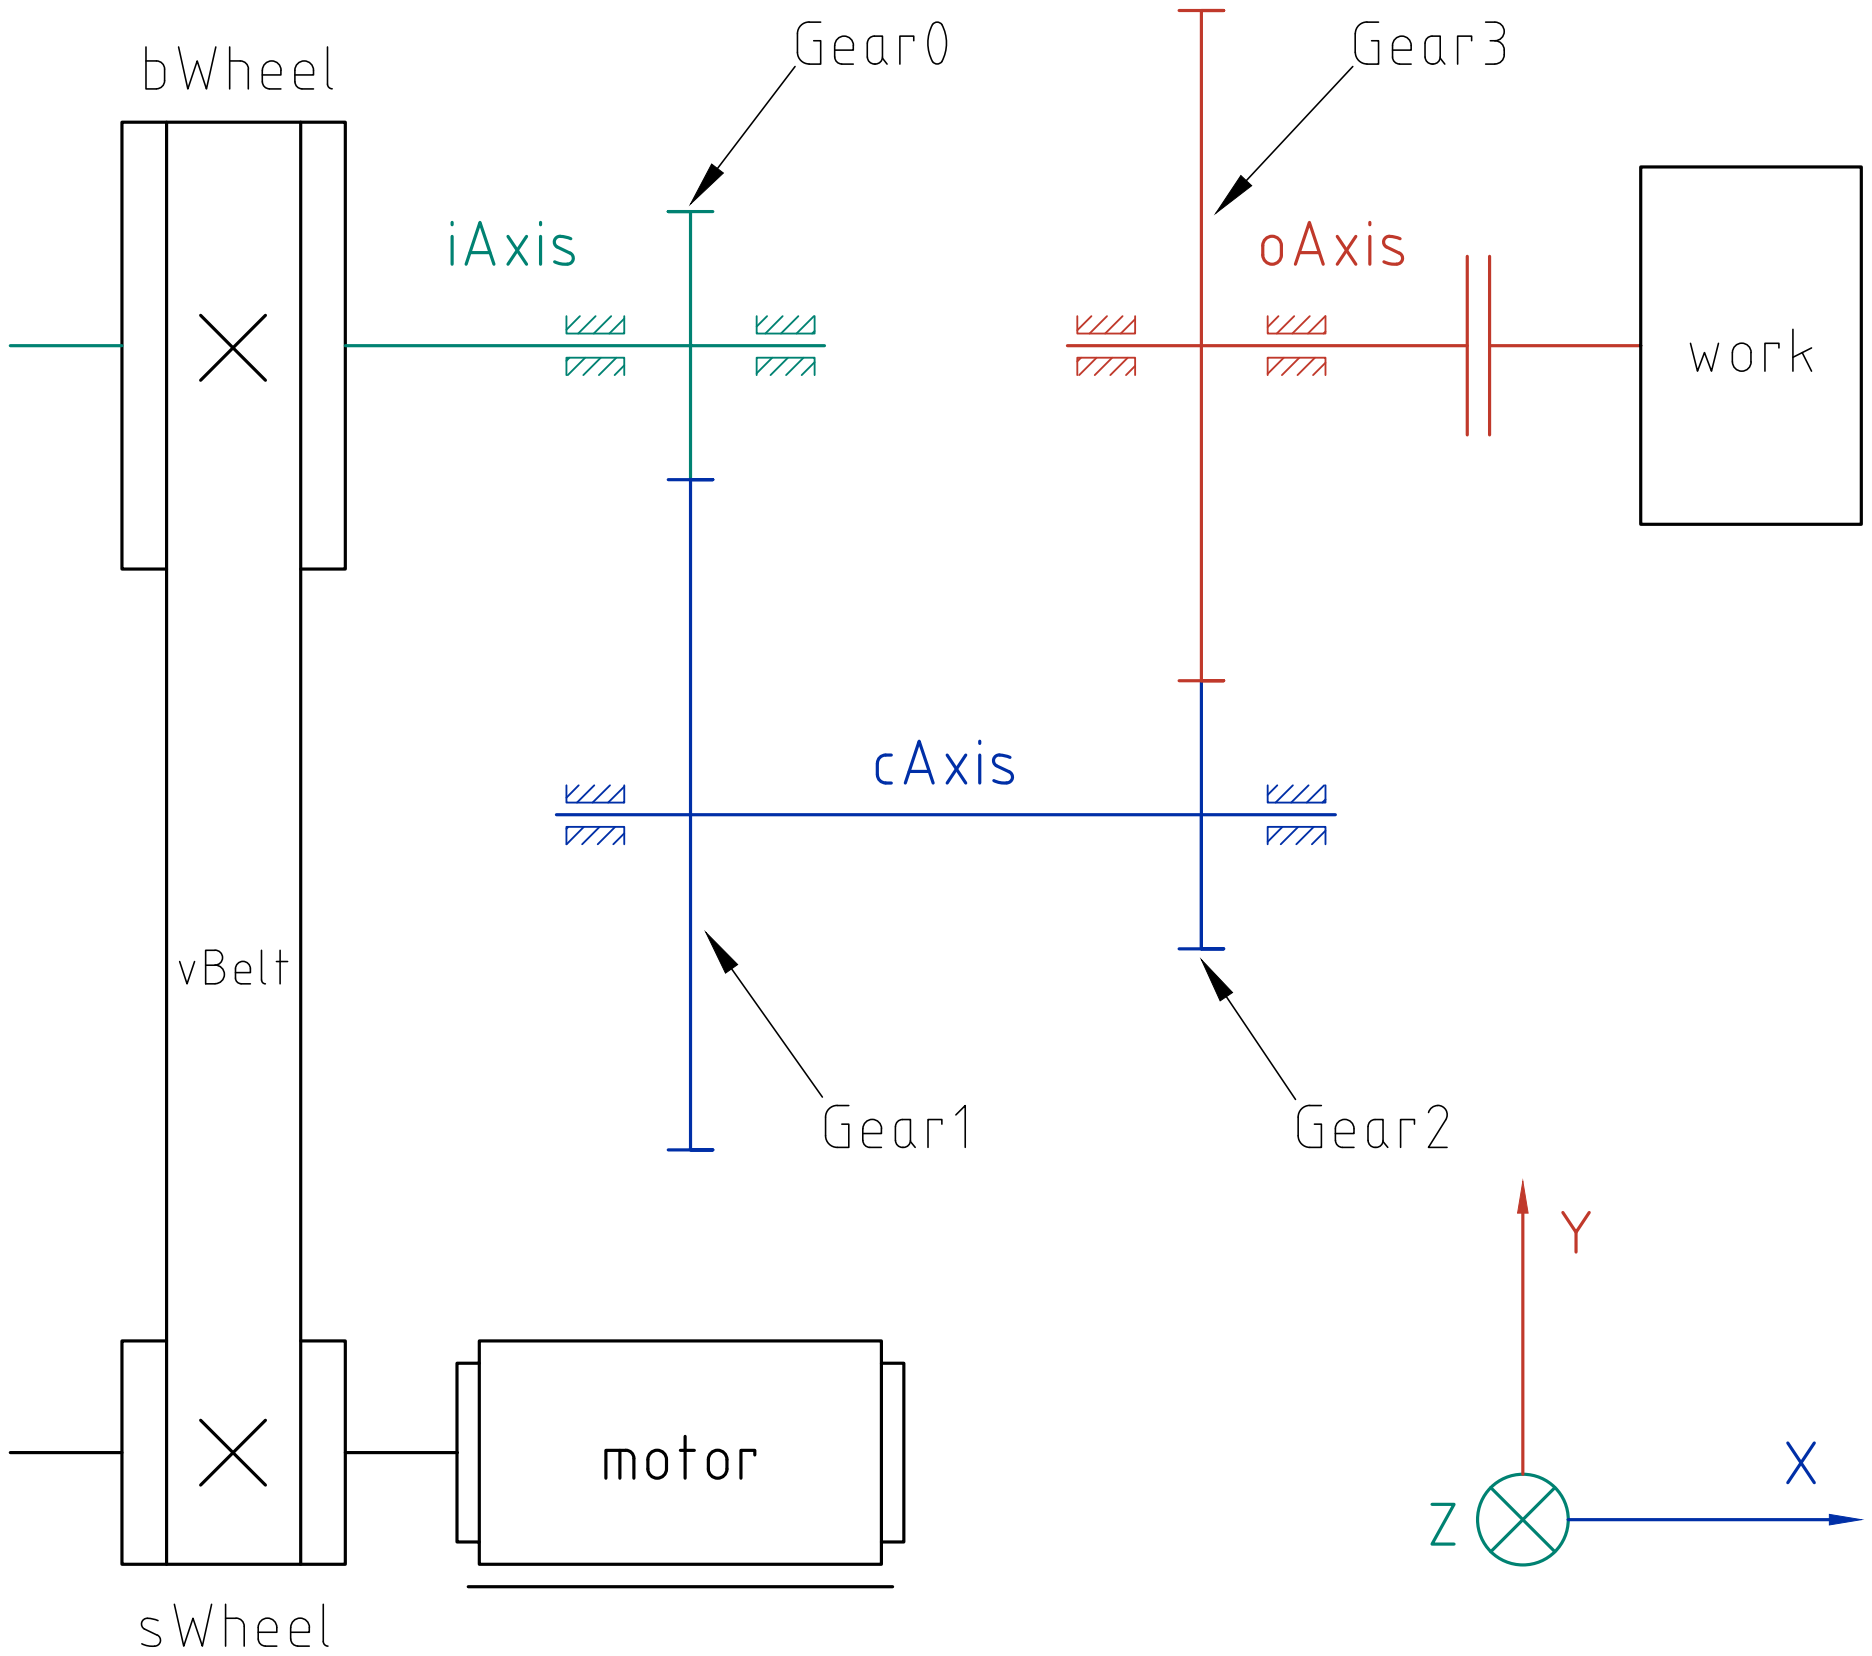
[picture p163: page 1]
