RMSHE-MSH/Mechanical_Design_Course_Project_Open_Source/轴设计/三轴受力模型.pdf

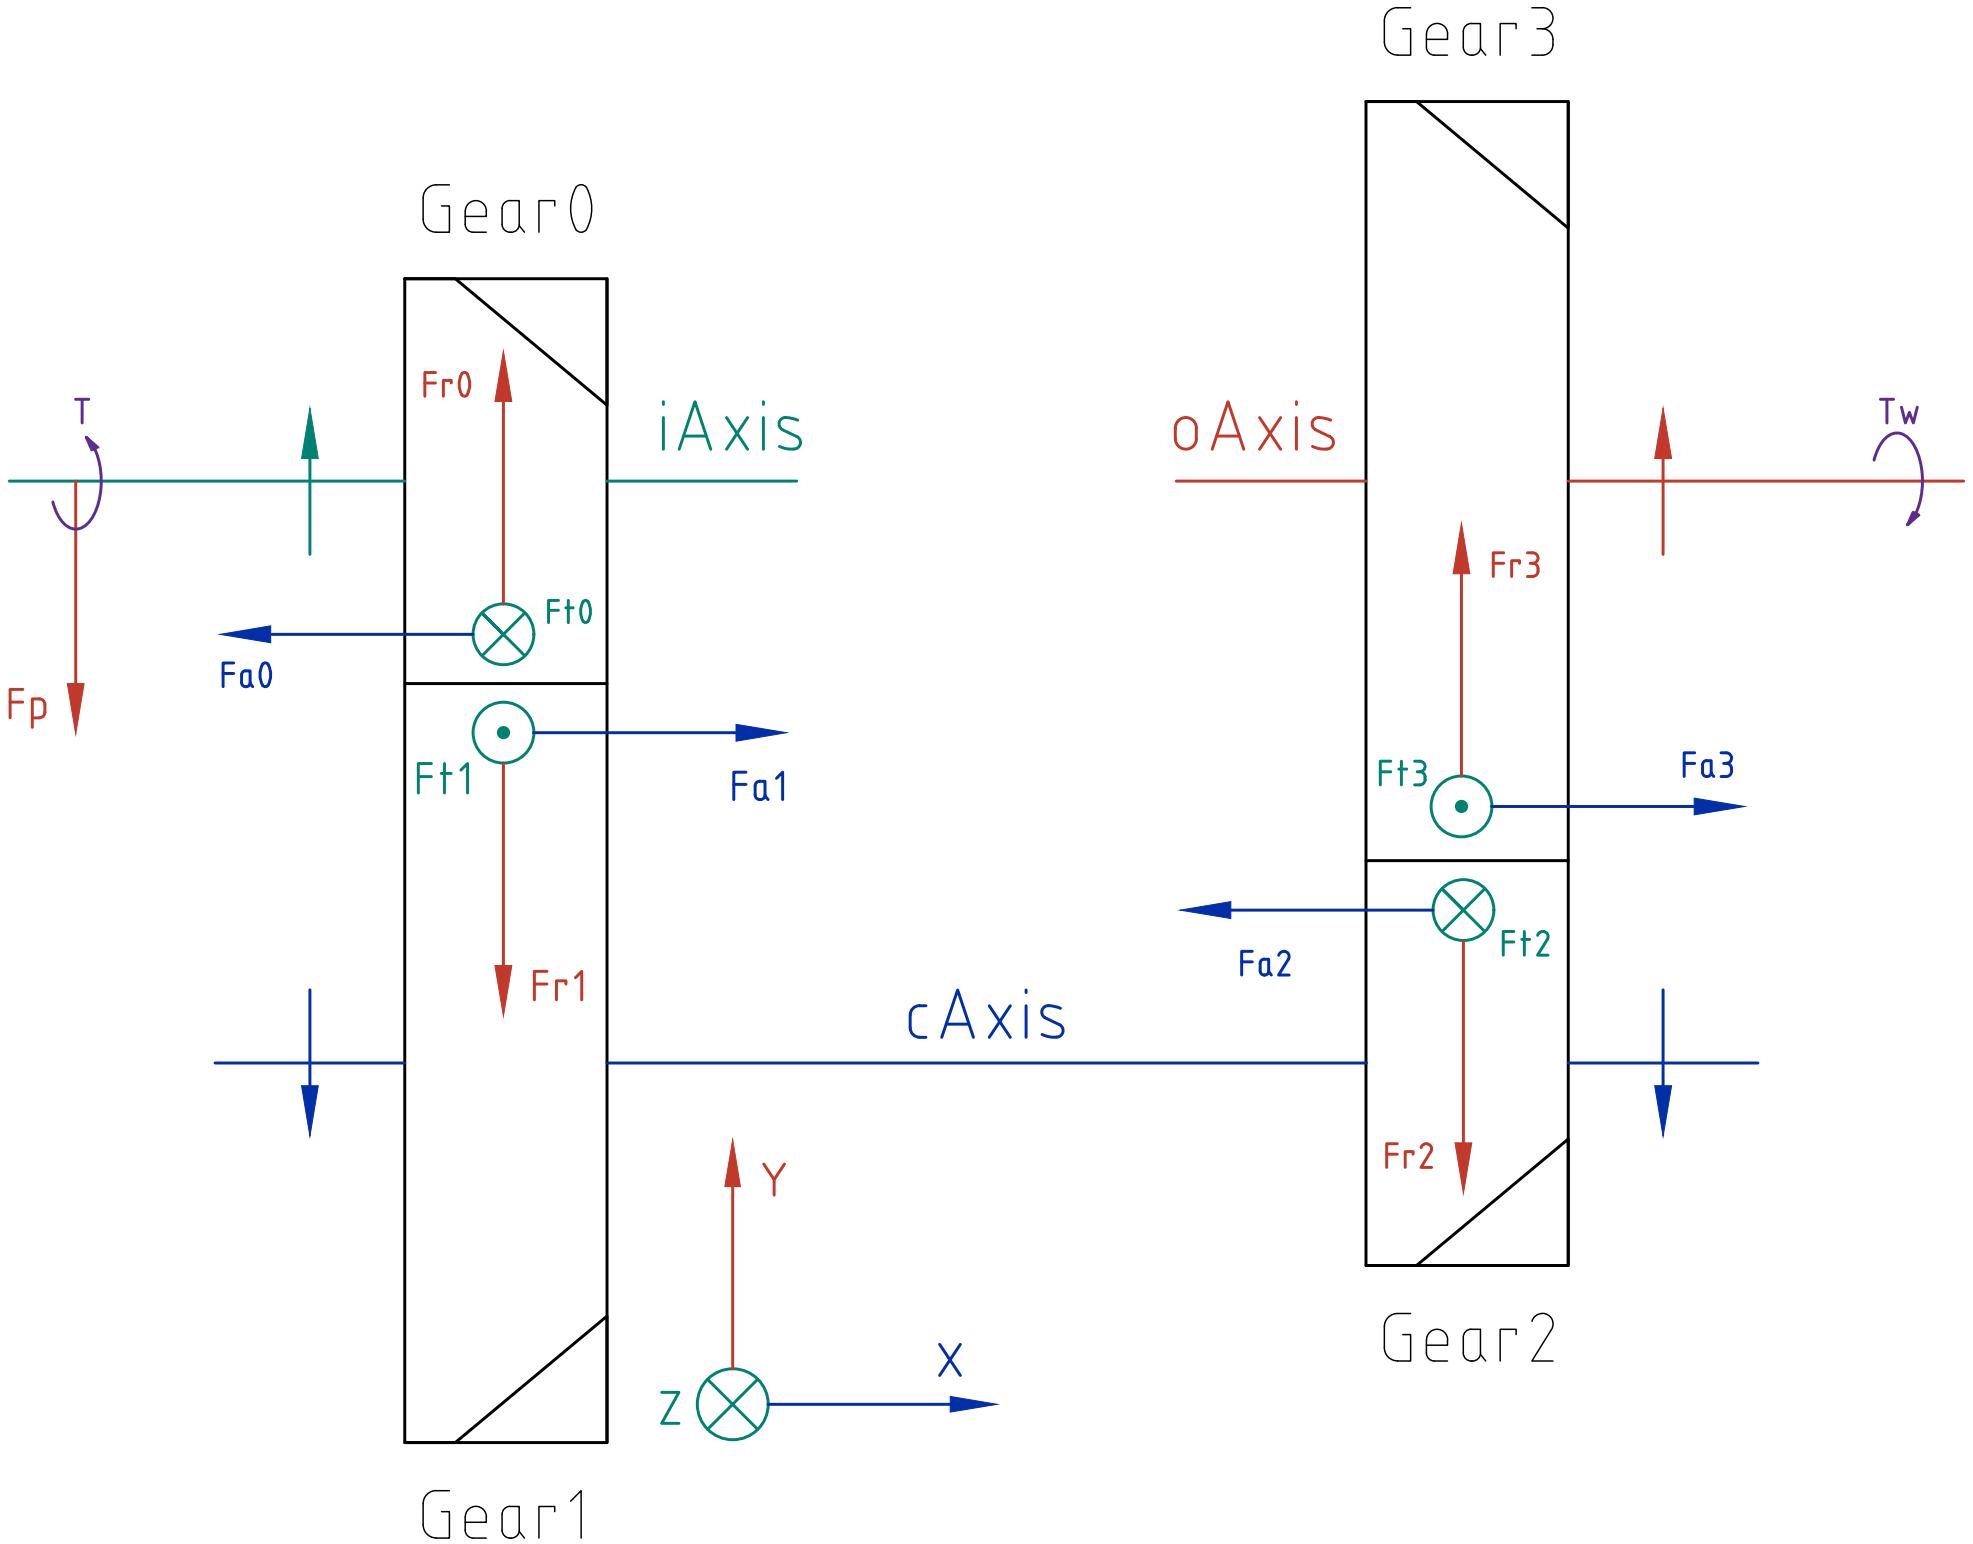
[picture p164: page 1]
