RMSHE-MSH/Mechanical_Design_Course_Project_Open_Source/V带传动/工程图/bWheel.pdf

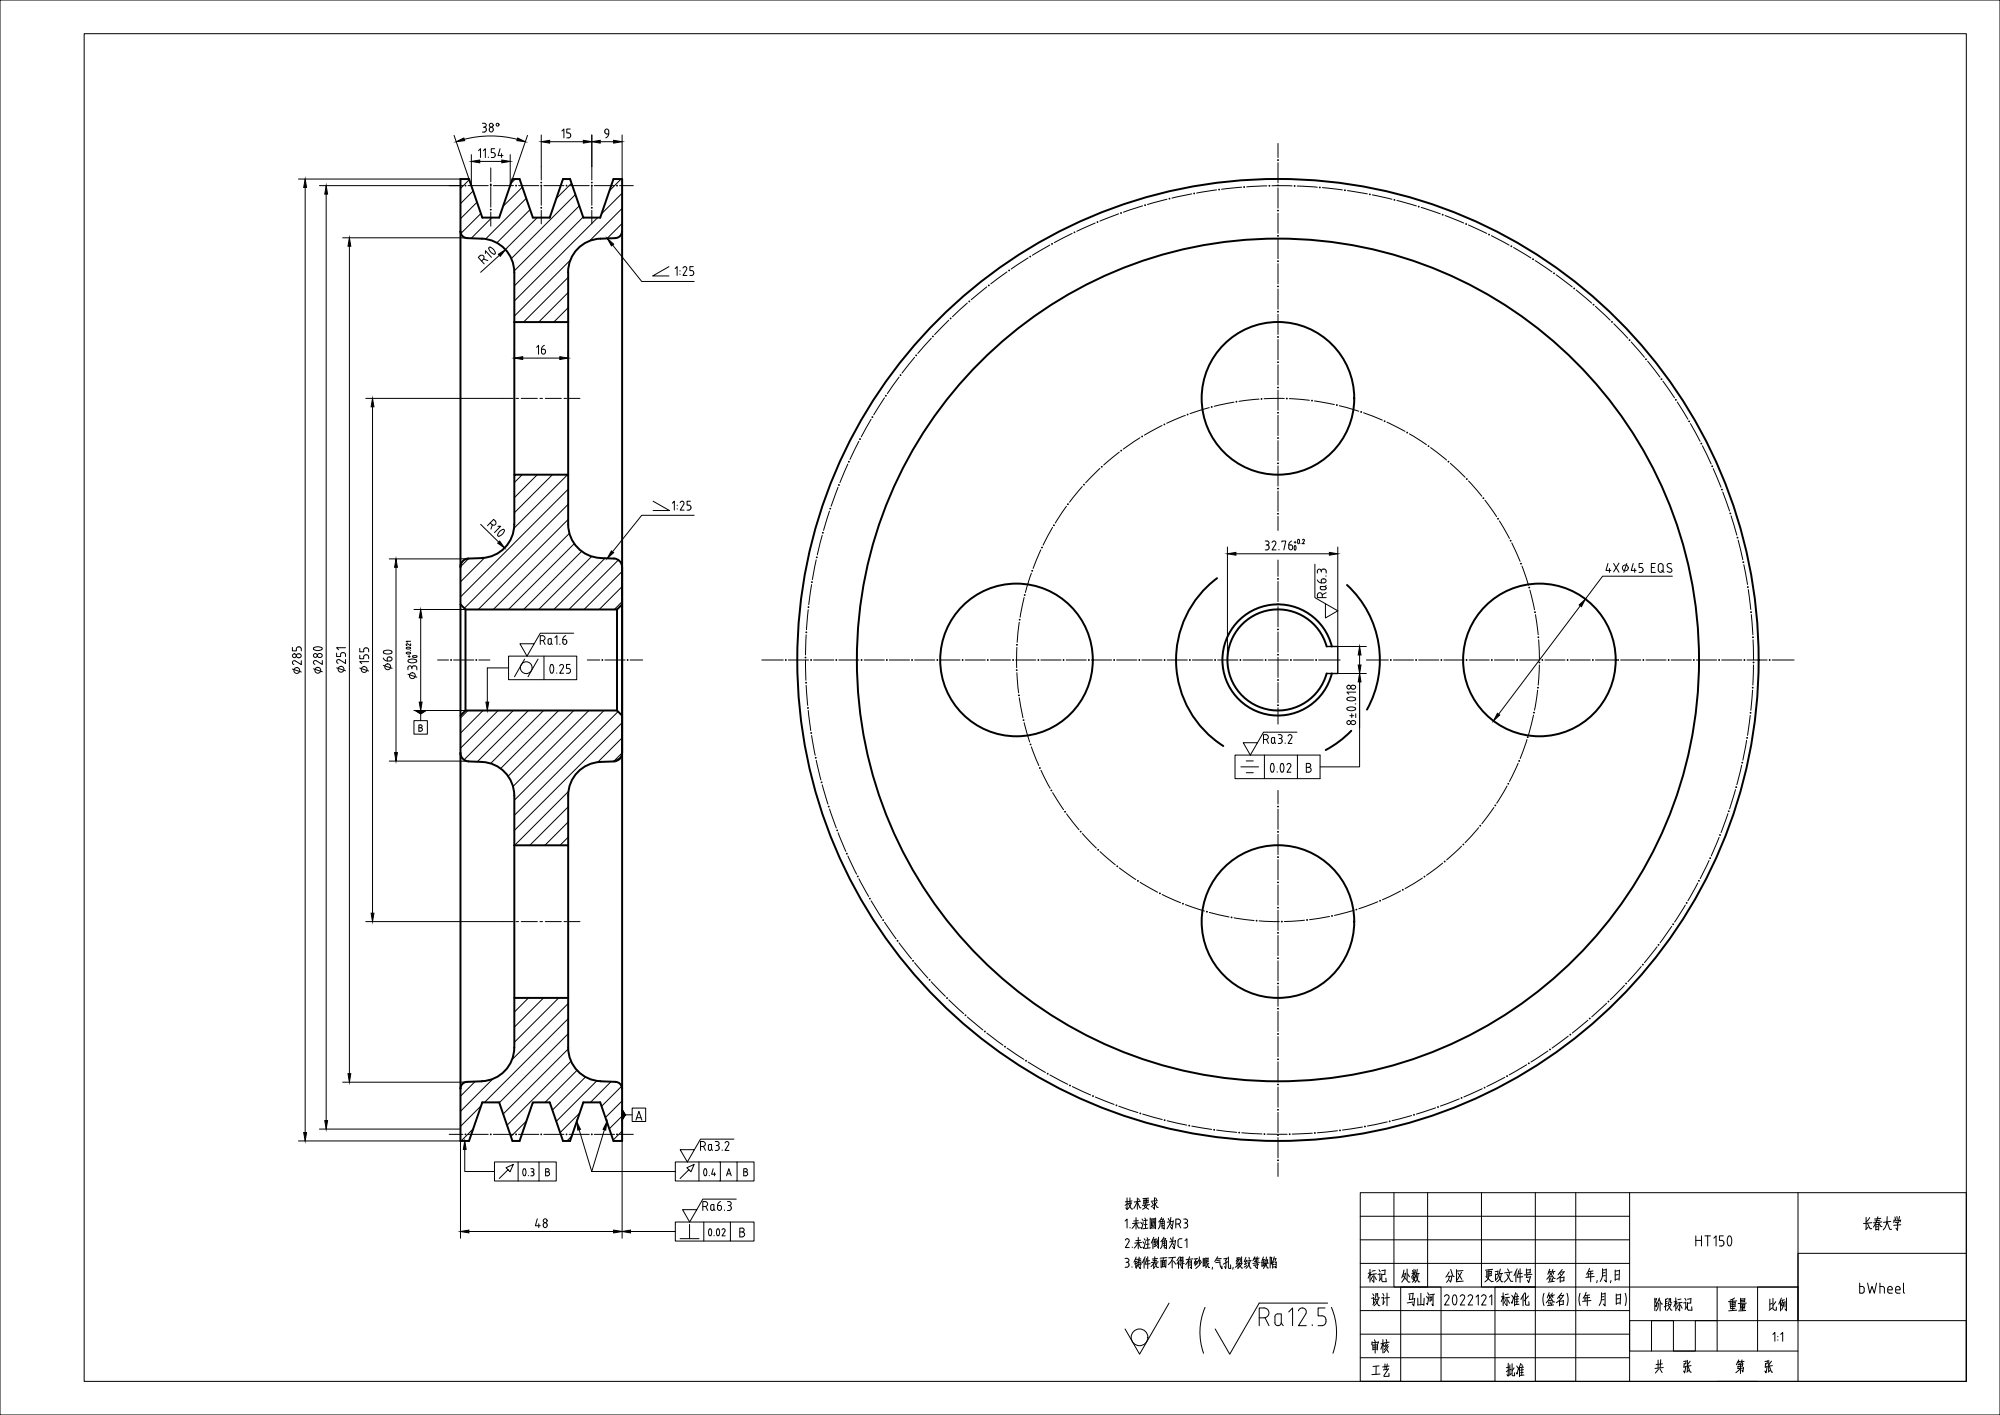
[picture p165: page 1]
