RMSHE-MSH/Mechanical_Design_Course_Project_Open_Source/V带传动/工程图/sWheel.pdf

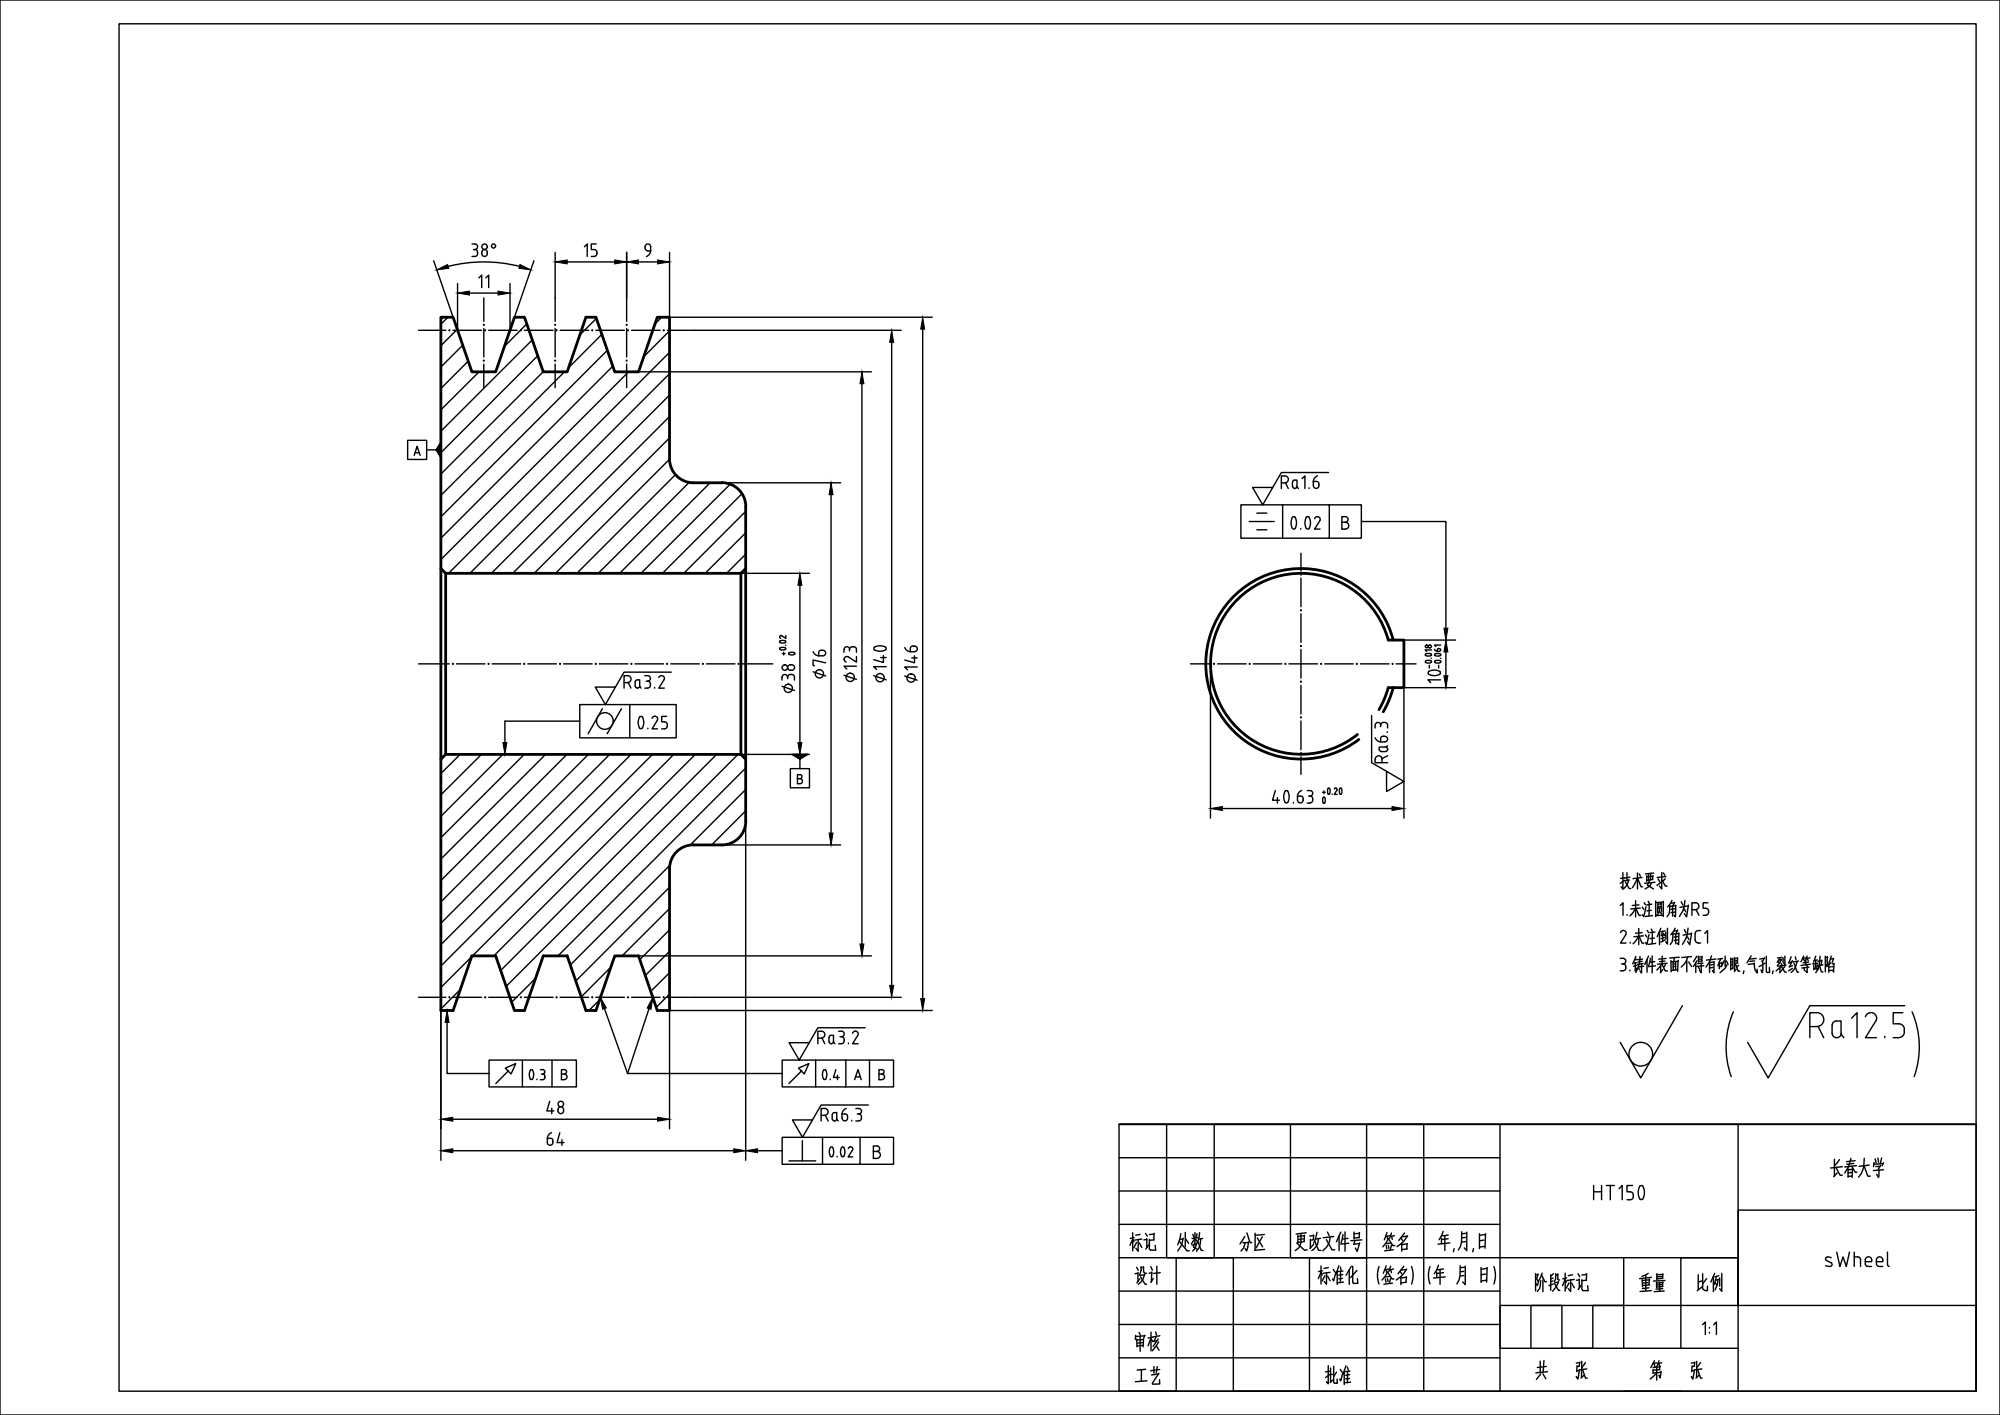
[picture p166: page 1]
