RMSHE-MSH/Mechanical_Design_Course_Project_Open_Source/轴设计/中间轴/结构设计/cAxis-模型.pdf

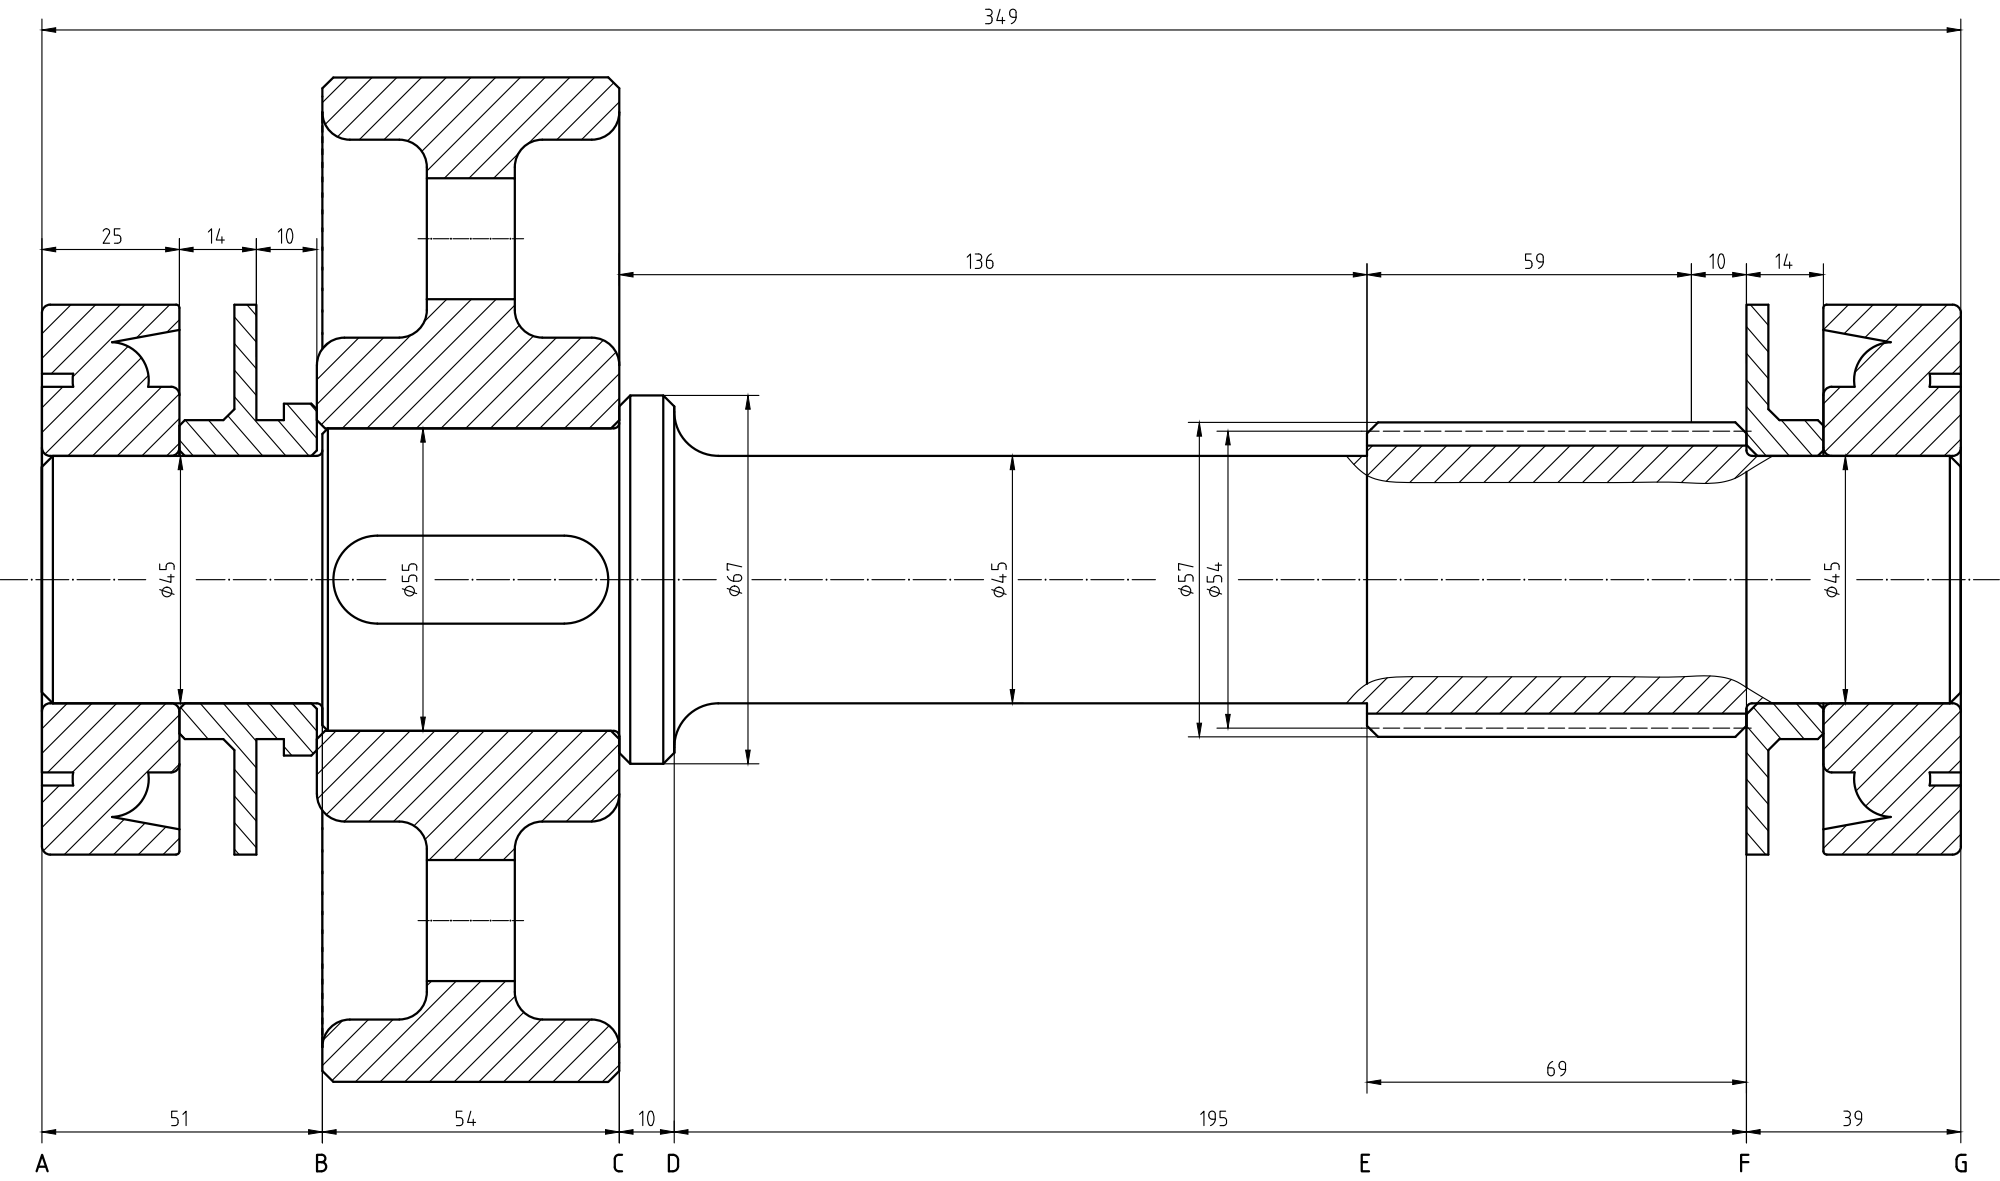
[picture p168: page 1]
