RMSHE-MSH/Mechanical_Design_Course_Project_Open_Source/轴设计/中间轴/结构设计/cAxis-说明书示意图.pdf

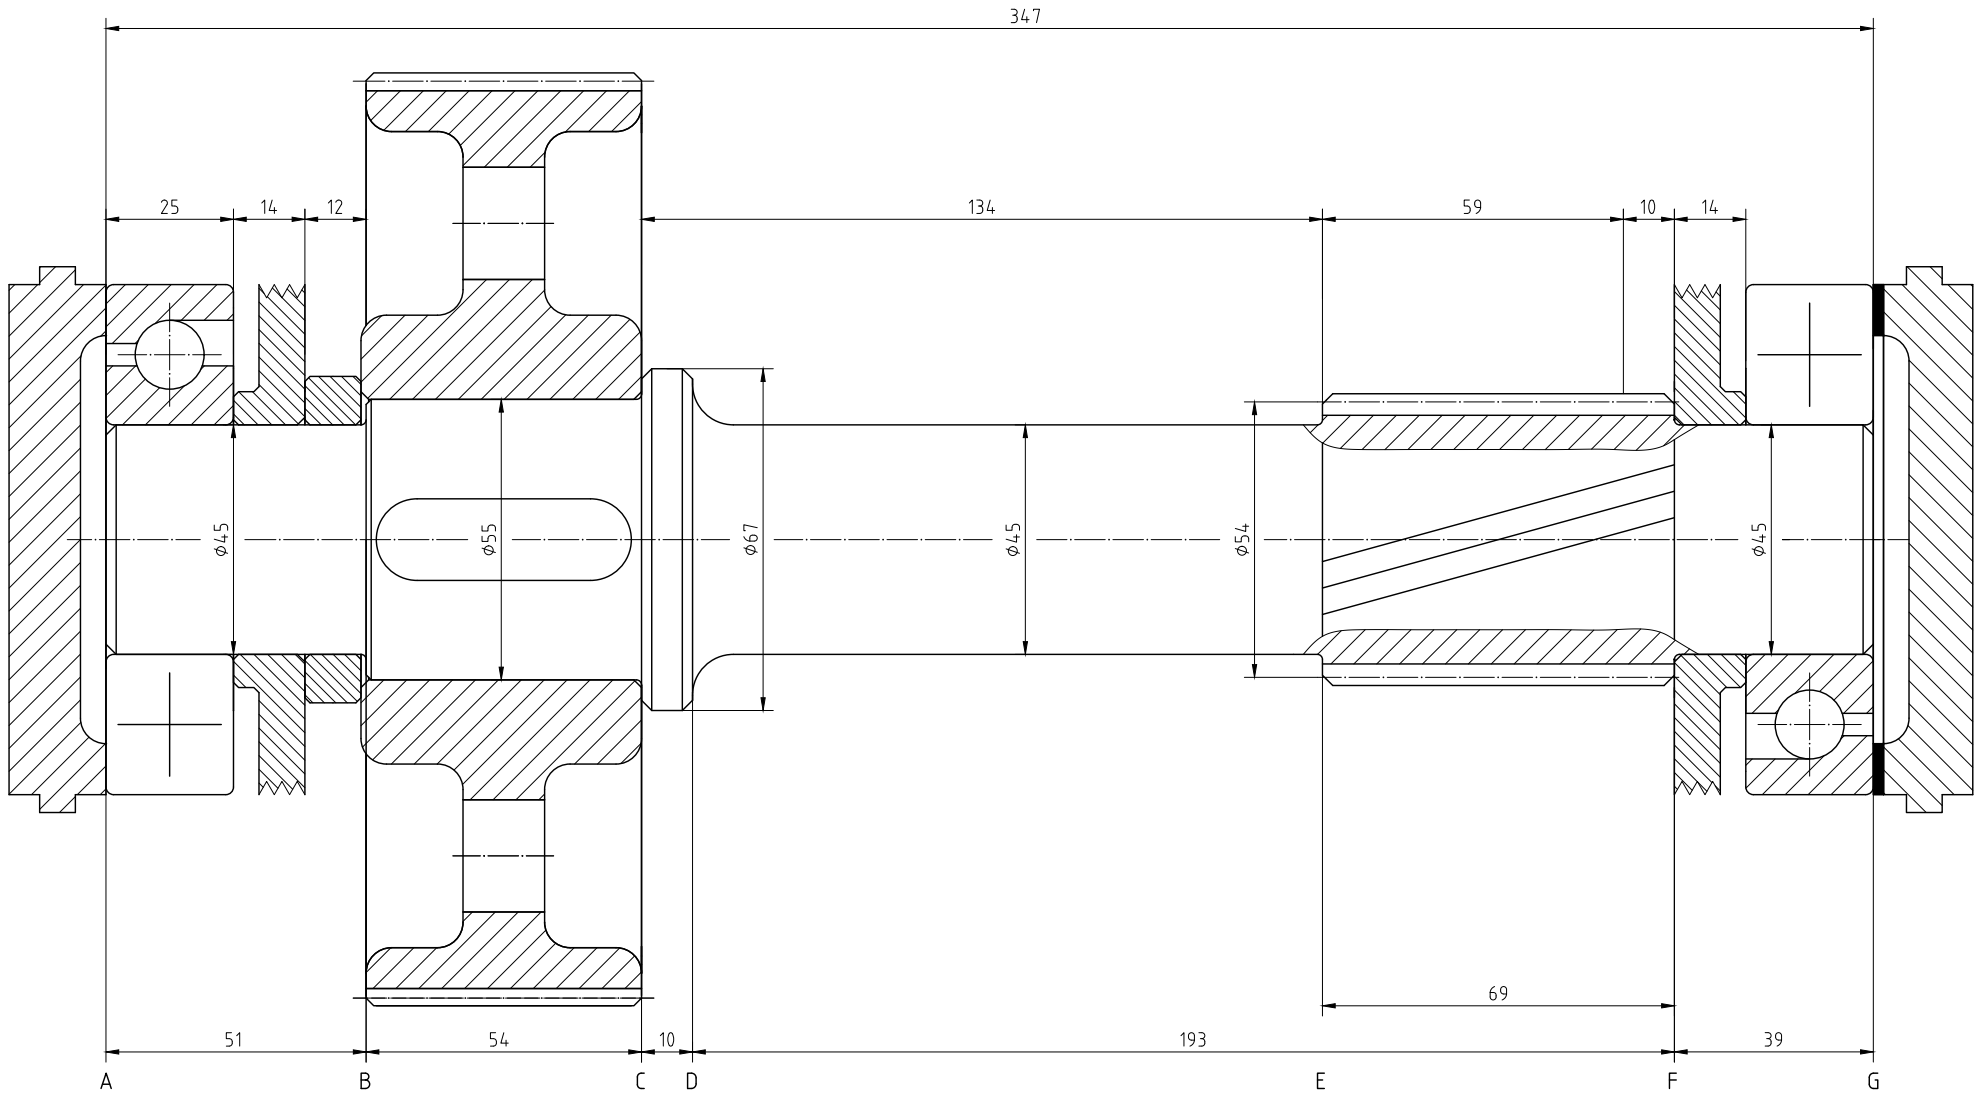
[picture p169: page 1]
