RMSHE-MSH/Mechanical_Design_Course_Project_Open_Source/轴设计/输入轴/力学模型/iAxis-受力分析图-模型.pdf

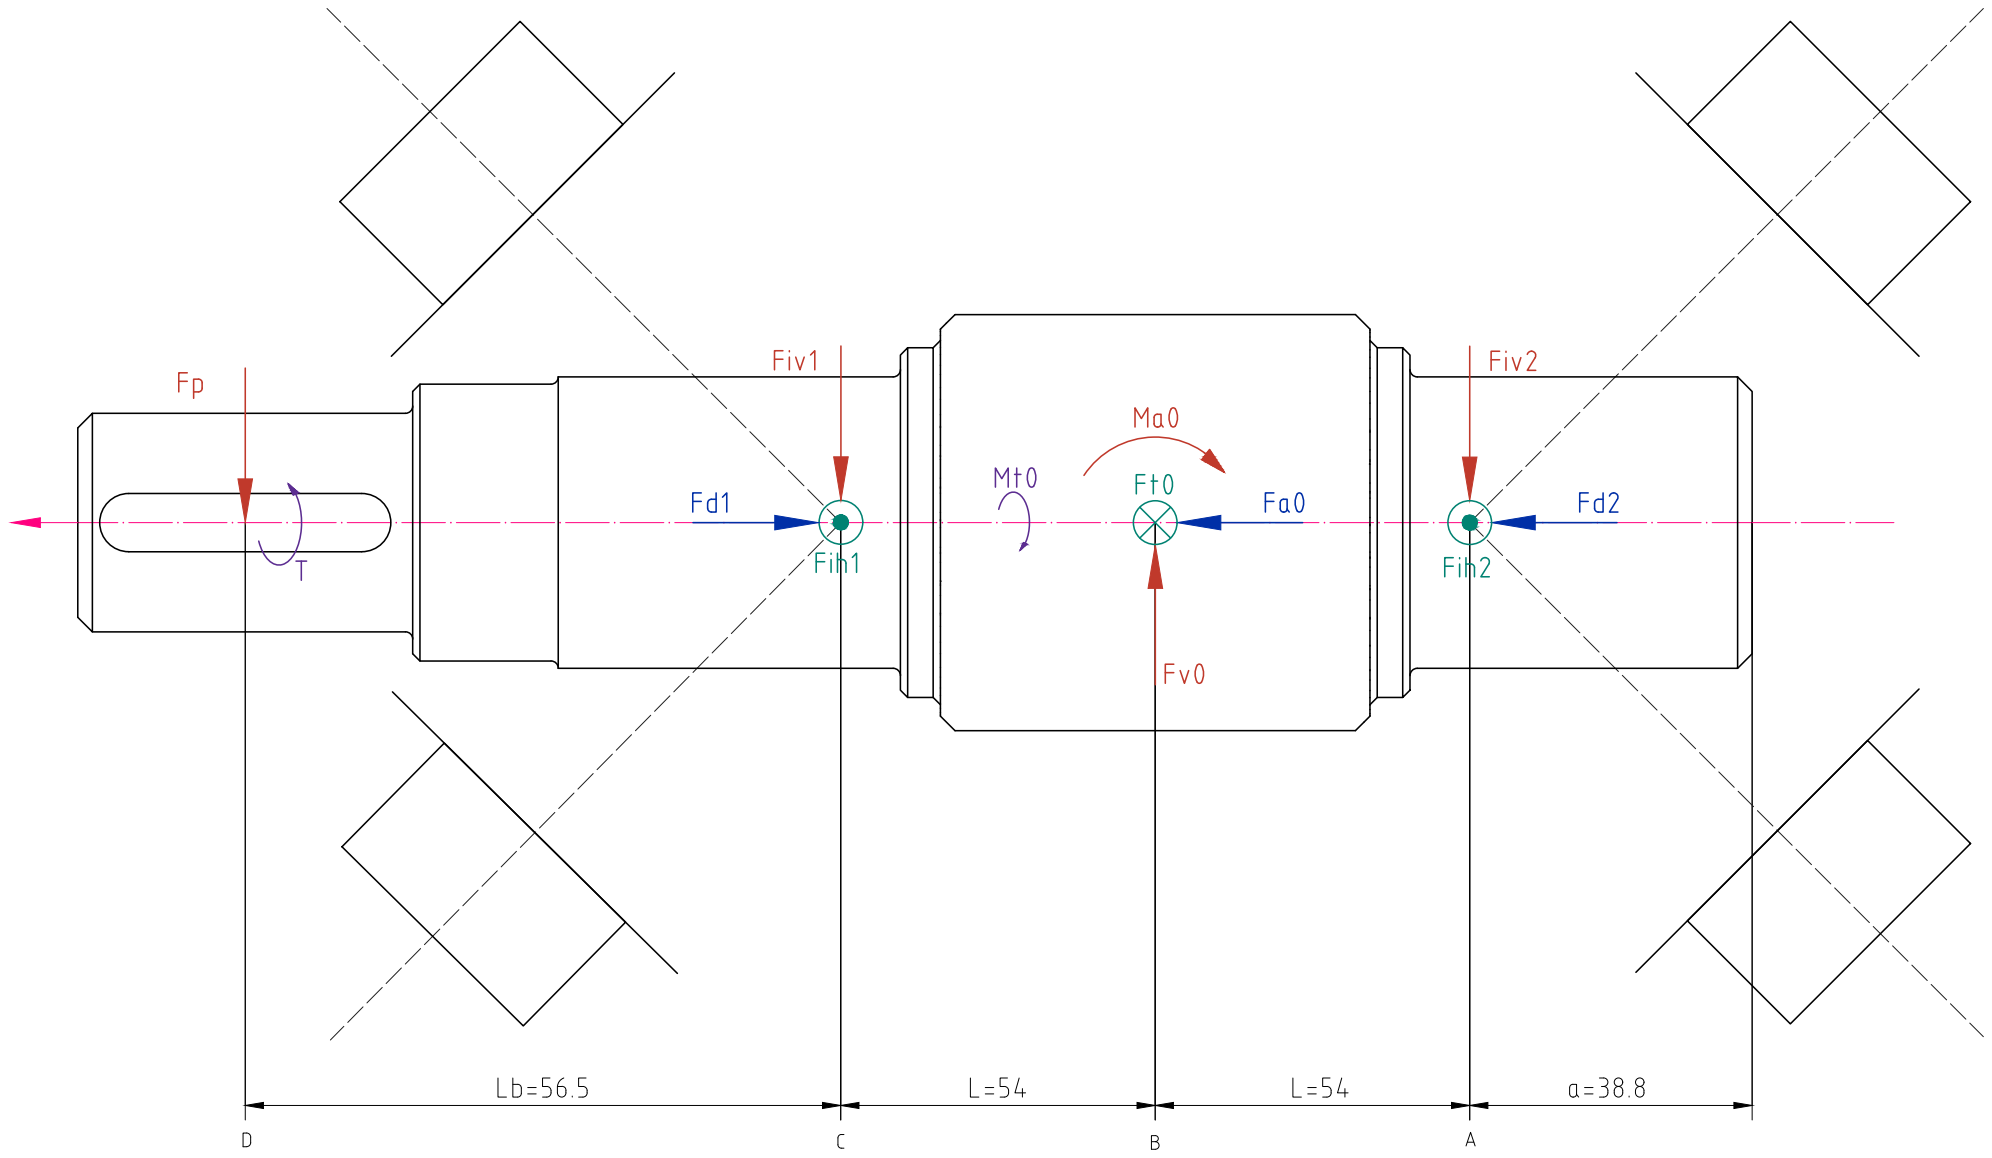
[picture p170: page 1]
