RMSHE-MSH/Mechanical_Design_Course_Project_Open_Source/轴设计/输入轴/结构设计/iAxis-说明书示意图.pdf

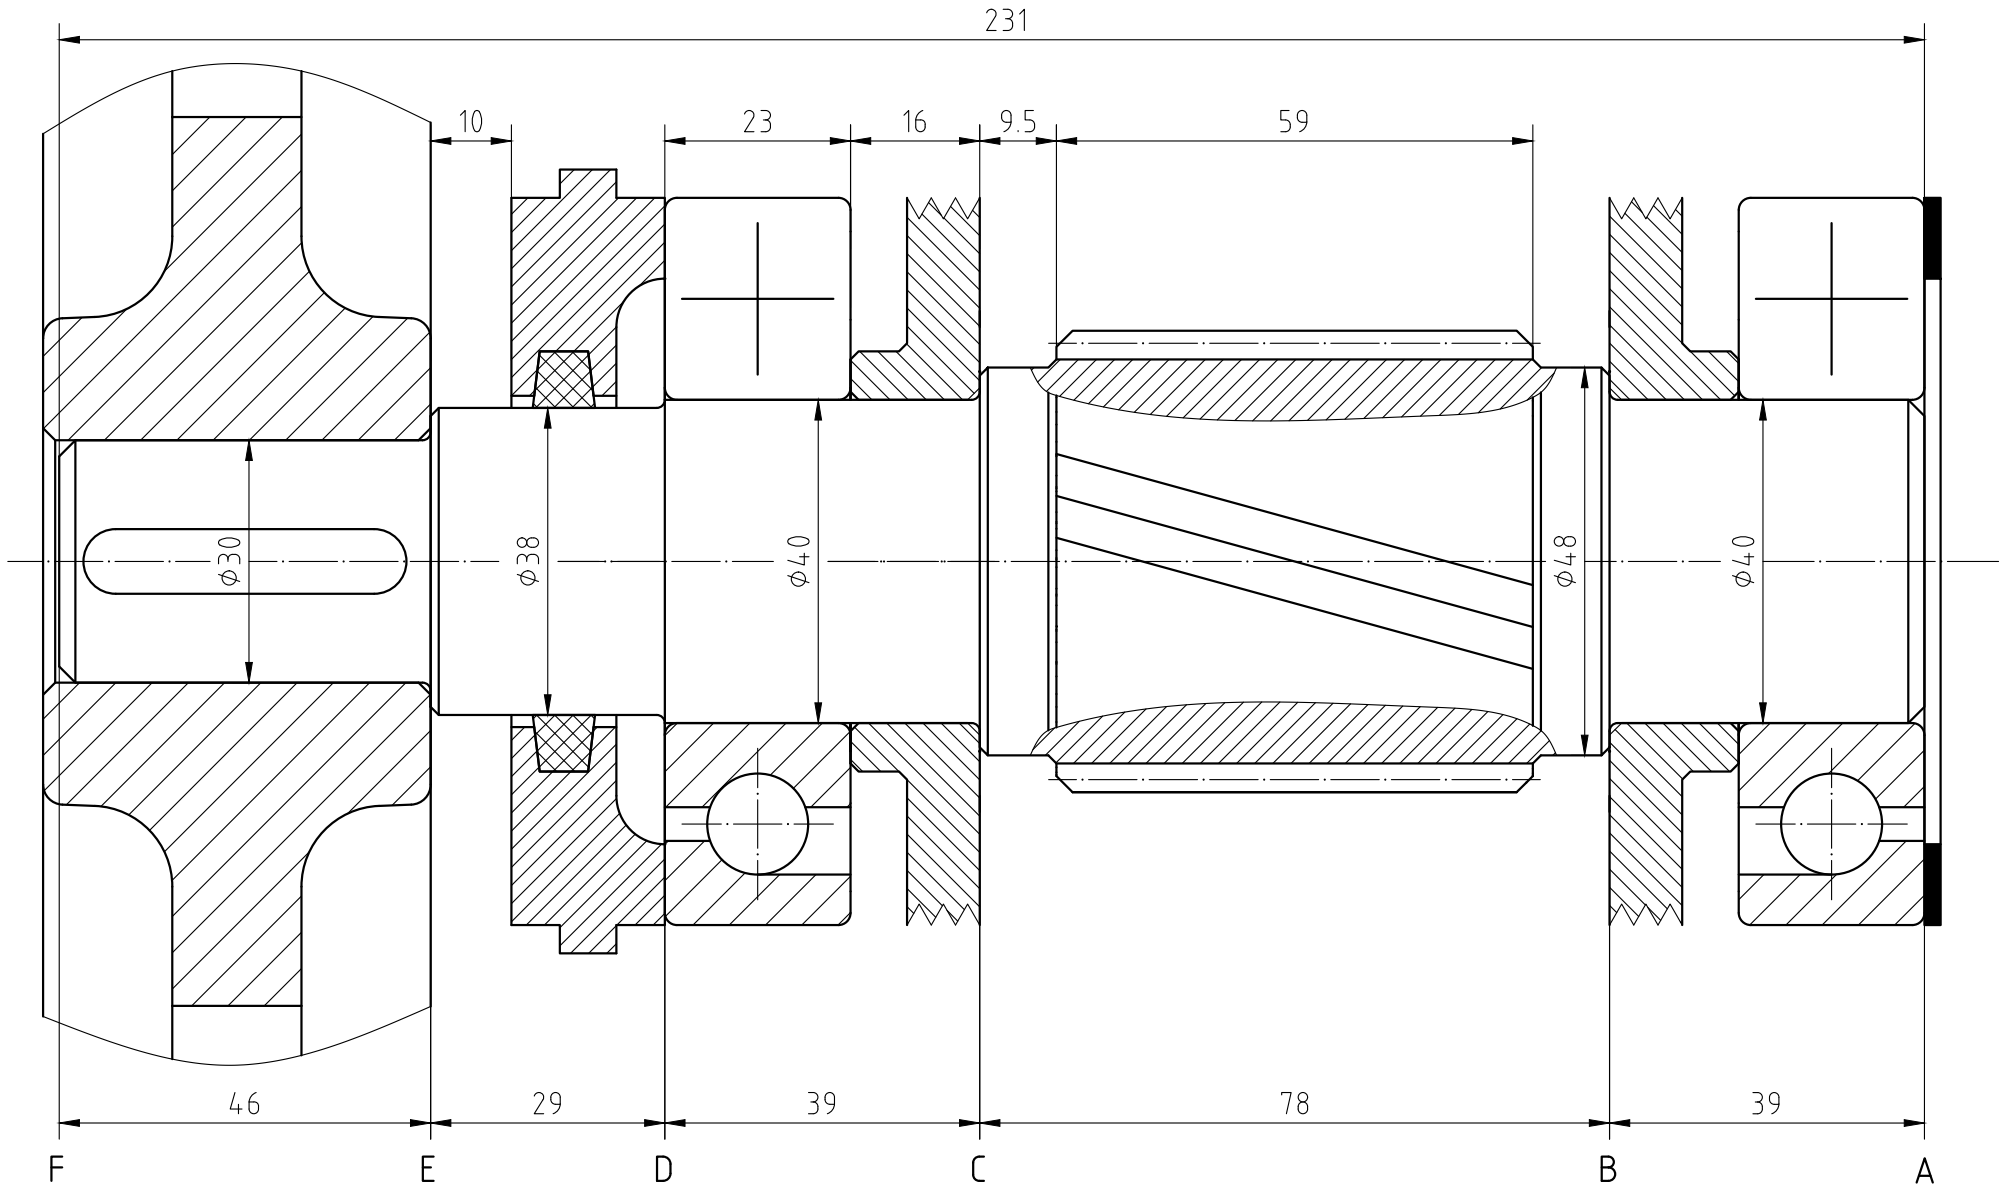
[picture p172: page 1]
