RMSHE-MSH/Mechanical_Design_Course_Project_Open_Source/轴设计/输出轴/力学模型/力学模型-模型.pdf

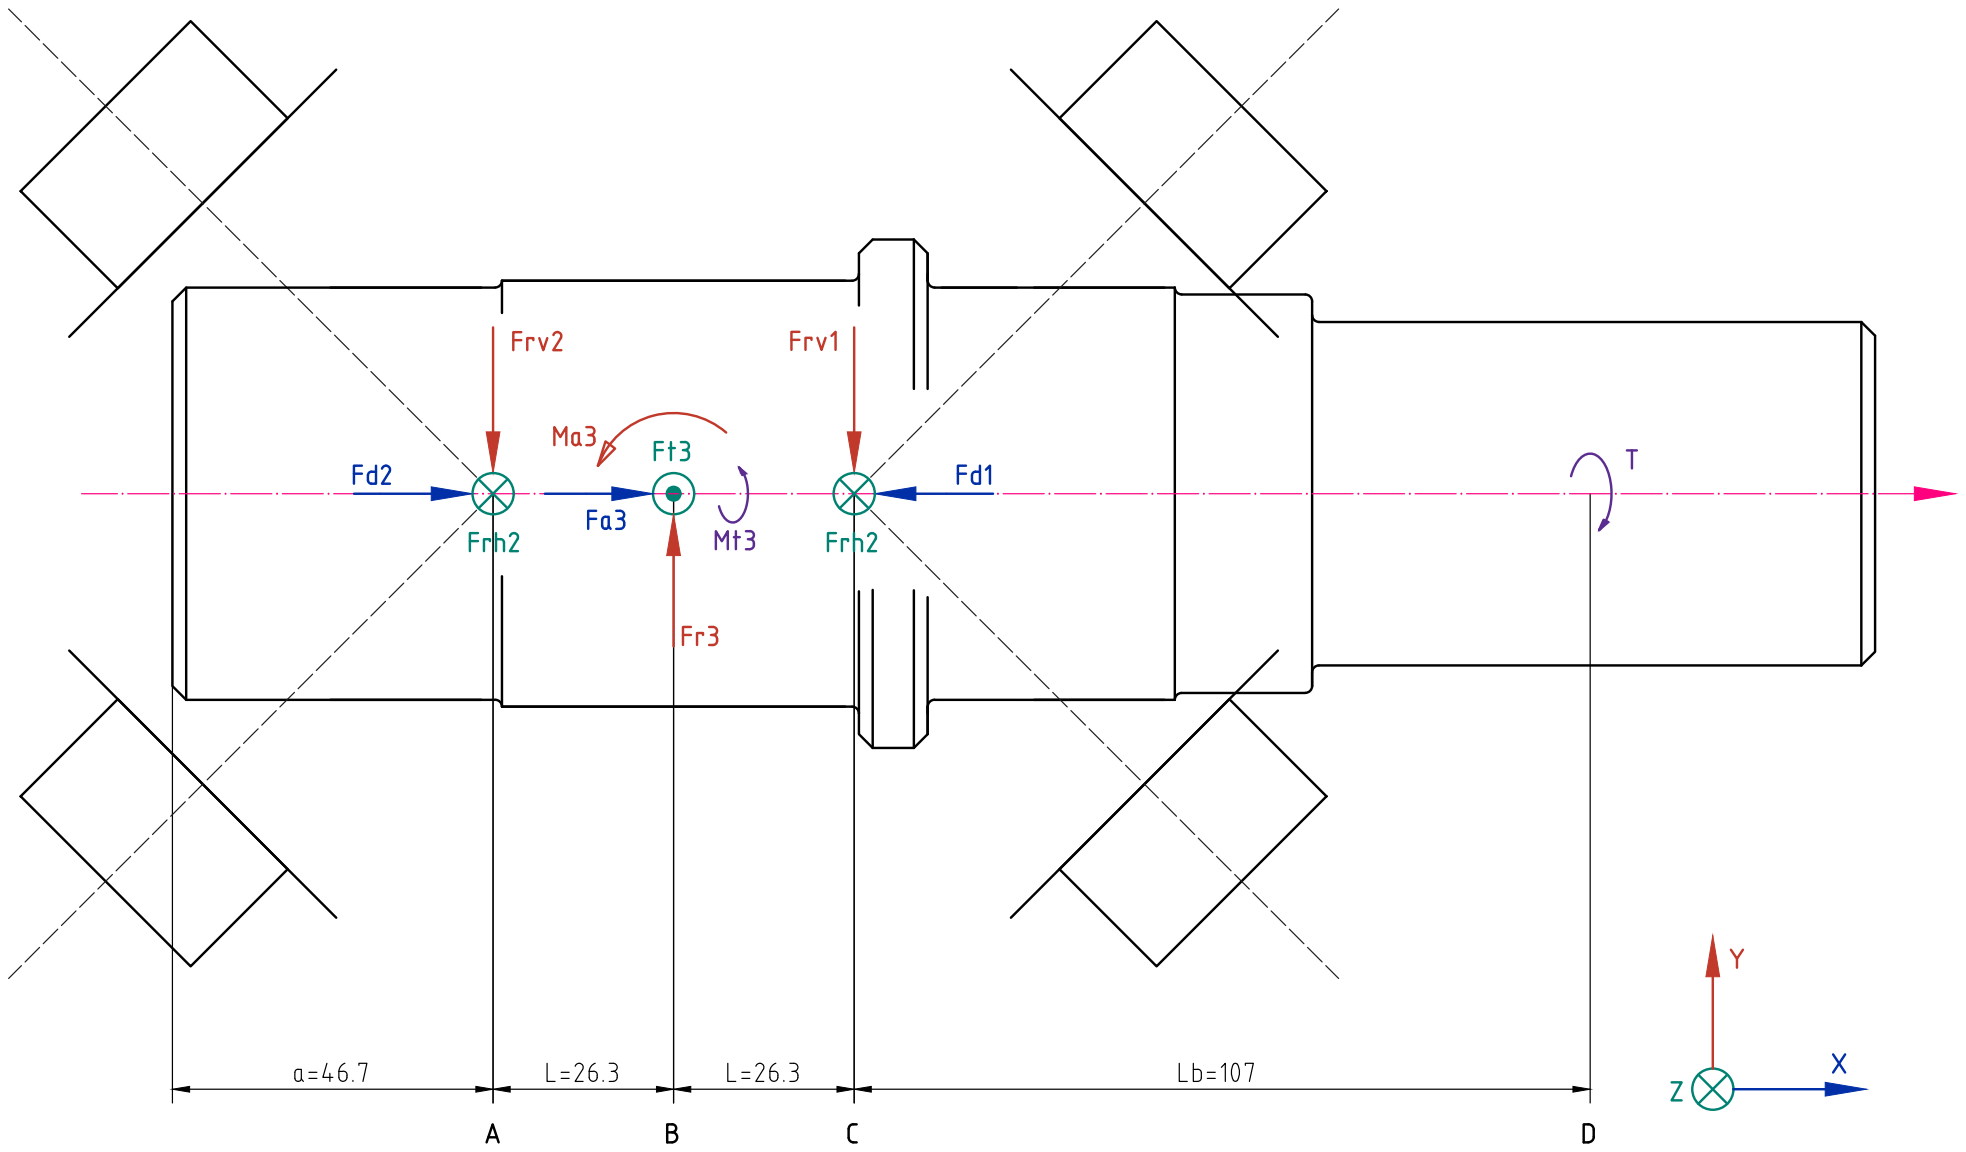
[picture p173: page 1]
