RMSHE-MSH/Mechanical_Design_Course_Project_Open_Source/轴设计/输出轴/结构设计/oAxis-草图-模型.pdf

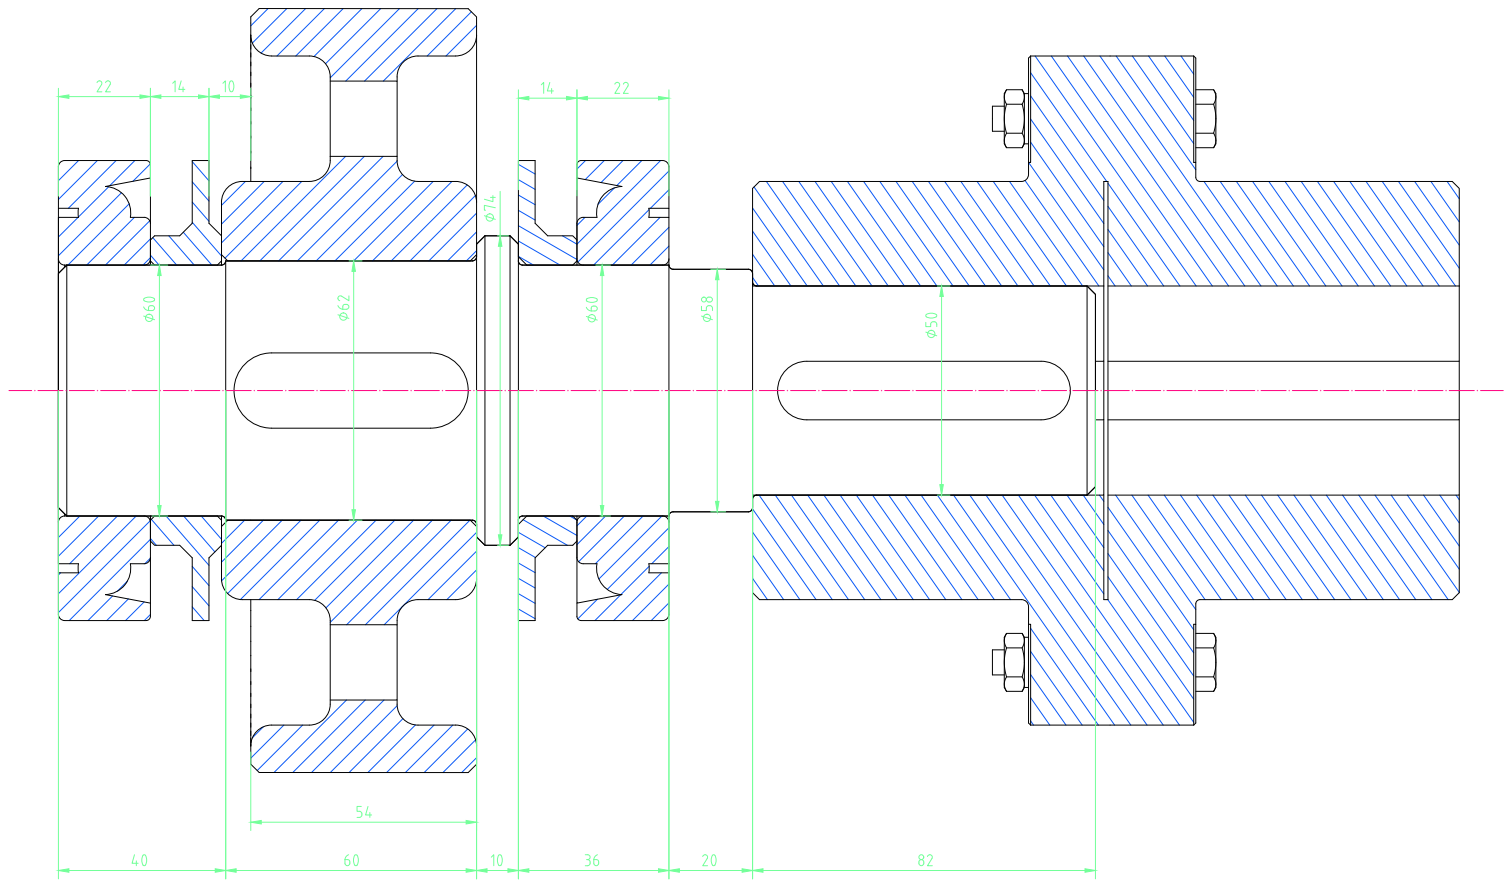
[picture p174: page 1]
