RMSHE-MSH/Mechanical_Design_Course_Project_Open_Source/轴设计/输出轴/结构设计/oAxis-说明书示意图.pdf

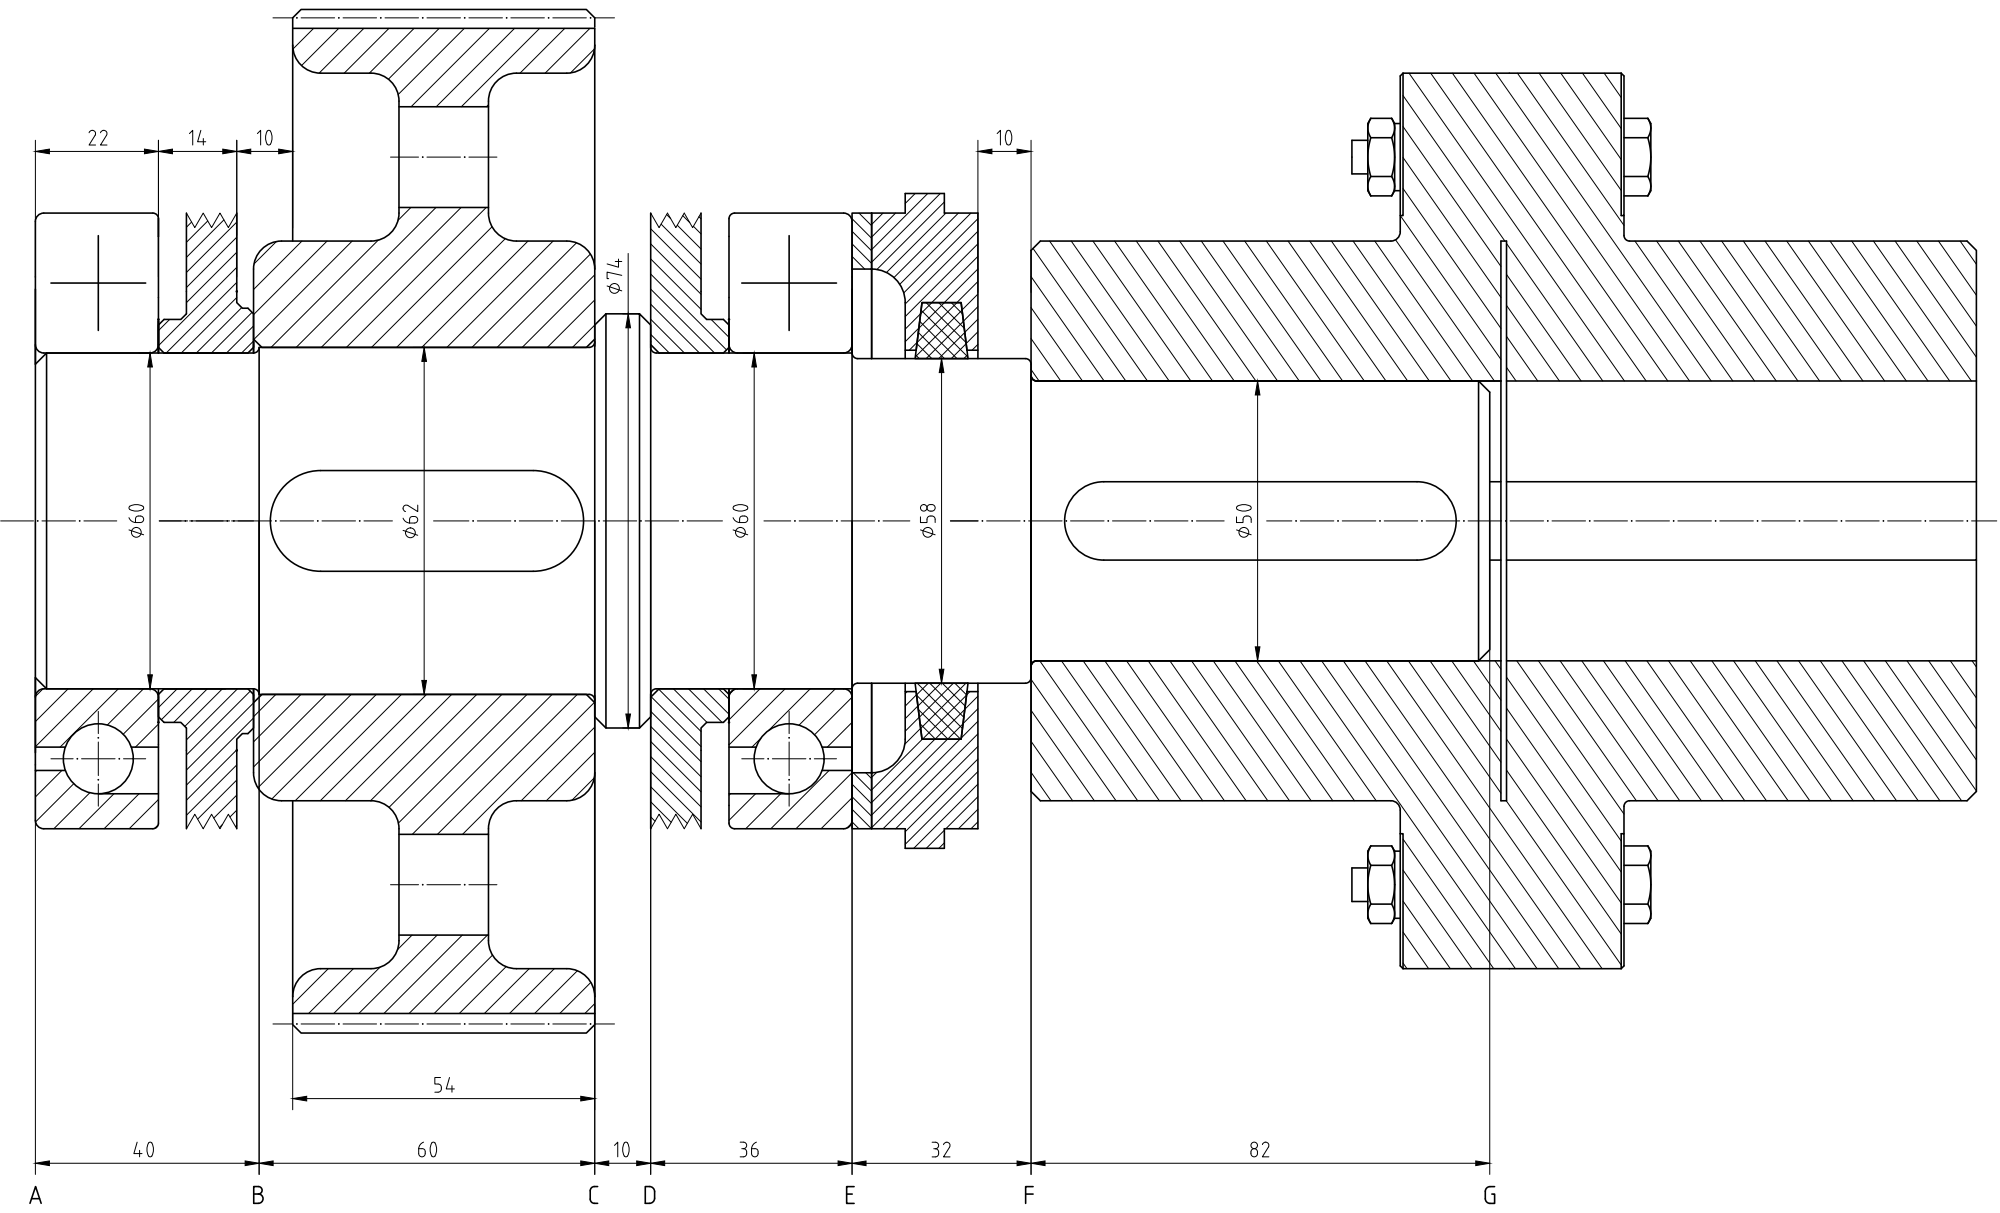
[picture p175: page 1]
