RMSHE-MSH/Mechanical_Design_Course_Project_Open_Source/圆柱斜齿轮副/齿轮副设计程序/源代码/控制台指令说明/GearDesignGuideCommandPrompt.xlsx

GearDesignGuideCommand
CommandName | Using | Example | Explain
DownloadModule | DownloadModule <url> <path> | DownloadModule https://gitlab.com/RMSHE-MSH/GearDesignGuide/-/raw/master/x64/Release/GearDesignGuide.exe ./Cache/GearDesignGuide.exe | 下载指定组件
pop / back | pop | pop | 撤销一步操作
 | back | back
 | pop <Num> | pop 2 | 撤销多步操作
 | back <Num> | back 3
save | save <path> | save ./Gear1.csv | 保存设计文件
import | import <path> | import ./Gear1.csv | 导入设计文件
exit | exit | exit | 退出命令提示符
rest | rest <parameter> | rest ImprotBreakpointData | 带参数重新启动
 | rest | rest | 不带参数重新启动
reinstall | reinstall | reinstall | 程序重装
