RMSHE-MSH/Mechanical_Design_Course_Project_Open_Source/圆柱斜齿轮副/齿轮副设计程序/源代码/x64/Release/build/GearDesignGuide/xref-GearDesignGuide.html

# modulegraph cross reference for GearDesignGuide.py, pyi_rth_inspect.py, pyi_rth_subprocess.py

GearDesignGuide.py Script

imports: _bootlocale • _collections_abc • _weakrefset • abc • ast • codecs • collections • collections.abc • copyreg • csv • ctypes • decimal • encodings • encodings.aliases • encodings.ascii • encodings.base64_codec • encodings.big5 • encodings.big5hkscs • encodings.bz2_codec • encodings.charmap • encodings.cp037 • encodings.cp1006 • encodings.cp1026 • encodings.cp1125 • encodings.cp1140 • encodings.cp1250 • encodings.cp1251 • encodings.cp1252 • encodings.cp1253 • encodings.cp1254 • encodings.cp1255 • encodings.cp1256 • encodings.cp1257 • encodings.cp1258 • encodings.cp273 • encodings.cp424 • encodings.cp437 • encodings.cp500 • encodings.cp720 • encodings.cp737 • encodings.cp775 • encodings.cp850 • encodings.cp852 • encodings.cp855 • encodings.cp856 • encodings.cp857 • encodings.cp858 • encodings.cp860 • encodings.cp861 • encodings.cp862 • encodings.cp863 • encodings.cp864 • encodings.cp865 • encodings.cp866 • encodings.cp869 • encodings.cp874 • encodings.cp875 • encodings.cp932 • encodings.cp949 • encodings.cp950 • encodings.euc_jis_2004 • encodings.euc_jisx0213 • encodings.euc_jp • encodings.euc_kr • encodings.gb18030 • encodings.gb2312 • encodings.gbk • encodings.hex_codec • encodings.hp_roman8 • encodings.hz • encodings.idna • encodings.iso2022_jp • encodings.iso2022_jp_1 • encodings.iso2022_jp_2 • encodings.iso2022_jp_2004 • encodings.iso2022_jp_3 • encodings.iso2022_jp_ext • encodings.iso2022_kr • encodings.iso8859_1 • encodings.iso8859_10 • encodings.iso8859_11 • encodings.iso8859_13 • encodings.iso8859_14 • encodings.iso8859_15 • encodings.iso8859_16 • encodings.iso8859_2 • encodings.iso8859_3 • encodings.iso8859_4 • encodings.iso8859_5 • encodings.iso8859_6 • encodings.iso8859_7 • encodings.iso8859_8 • encodings.iso8859_9 • encodings.johab • encodings.koi8_r • encodings.koi8_t • encodings.koi8_u • encodings.kz1048 • encodings.latin_1 • encodings.mac_arabic • encodings.mac_croatian • encodings.mac_cyrillic • encodings.mac_farsi • encodings.mac_greek • encodings.mac_iceland • encodings.mac_latin2 • encodings.mac_roman • encodings.mac_romanian • encodings.mac_turkish • encodings.mbcs • encodings.oem • encodings.palmos • encodings.ptcp154 • encodings.punycode • encodings.quopri_codec • encodings.raw_unicode_escape • encodings.rot_13 • encodings.shift_jis • encodings.shift_jis_2004 • encodings.shift_jisx0213 • encodings.tis_620 • encodings.undefined • encodings.unicode_escape • encodings.utf_16 • encodings.utf_16_be • encodings.utf_16_le • encodings.utf_32 • encodings.utf_32_be • encodings.utf_32_le • encodings.utf_7 • encodings.utf_8 • encodings.utf_8_sig • encodings.uu_codec • encodings.zlib_codec • enum • fnmatch • functools • genericpath • heapq • io • keyword • linecache • locale • math • ntpath • ntpath • operator • os • pathlib • posixpath • pyi_rth_inspect.py • pyi_rth_subprocess.py • re • reprlib • requests • shutil • sre_compile • sre_constants • sre_parse • stat • sys • tabulate • time • token • tokenize • traceback • types • urllib • urllib.error • urllib.parse • urllib.request • urllib.response • urllib.robotparser • warnings • weakref

pyi_rth_inspect.py Script

imports: inspect • os • sys

imported by: GearDesignGuide.py

pyi_rth_subprocess.py Script

imports: io • subprocess • sys

imported by: GearDesignGuide.py

"'urllib3.packages.six.moves.urllib'.parse" MissingModule

imported by: urllib3.poolmanager • urllib3.request

'OpenSSL.crypto' MissingModule

imported by: urllib3.contrib.pyopenssl

'cryptography.hazmat' MissingModule

imported by: urllib3.contrib.pyopenssl

'cryptography.x509' MissingModule

imported by: urllib3.contrib.pyopenssl

'org.python' MissingModule

imported by: copy

'typing.io' MissingModule

imported by: importlib.resources

'urllib3.packages.six.moves.urllib' MissingModule

imported by: 'urllib3.packages.six.moves.urllib'

OpenSSL MissingModule

imported by: urllib3.contrib.pyopenssl

Queue MissingModule

imported by: urllib3.util.queue

StringIO MissingModule

imported by: urllib3.packages.six

__future__ SourceModule

imported by: urllib3 • urllib3._collections • urllib3.connection • urllib3.connectionpool • urllib3.contrib.pyopenssl • urllib3.contrib.socks • urllib3.exceptions • urllib3.fields • urllib3.filepost • urllib3.packages.six • urllib3.poolmanager • urllib3.request • urllib3.response • urllib3.util • urllib3.util.connection • urllib3.util.request • urllib3.util.response • urllib3.util.retry • urllib3.util.ssl_ • urllib3.util.timeout • urllib3.util.url

_abc (builtin module)

imported by: abc

_ast (builtin module)

imported by: ast

_bisect (builtin module)

imported by: bisect

_blake2 (builtin module)

imported by: hashlib

_bootlocale SourceModule

imports: _locale • locale • sys

imported by: GearDesignGuide.py • locale

_bz2 E:\Application\Python\Python39\DLLs\_bz2.pyd

imported by: bz2

_codecs (builtin module)

imported by: codecs

_codecs_cn (builtin module)

imported by: encodings.gb18030 • encodings.gb2312 • encodings.gbk • encodings.hz

_codecs_hk (builtin module)

imported by: encodings.big5hkscs

_codecs_iso2022 (builtin module)

imported by: encodings.iso2022_jp • encodings.iso2022_jp_1 • encodings.iso2022_jp_2 • encodings.iso2022_jp_2004 • encodings.iso2022_jp_3 • encodings.iso2022_jp_ext • encodings.iso2022_kr

_codecs_jp (builtin module)

imported by: encodings.cp932 • encodings.euc_jis_2004 • encodings.euc_jisx0213 • encodings.euc_jp • encodings.shift_jis • encodings.shift_jis_2004 • encodings.shift_jisx0213

_codecs_kr (builtin module)

imported by: encodings.cp949 • encodings.euc_kr • encodings.johab

_codecs_tw (builtin module)

imported by: encodings.big5 • encodings.cp950

_collections (builtin module)

imported by: collections • threading

_collections_abc SourceModule

imports: abc • sys • warnings

imported by: GearDesignGuide.py • collections • collections.abc • contextlib • locale • os • pathlib • random • types • weakref

_compat_pickle SourceModule

imported by: _pickle • pickle

_compression SourceModule

imports: io

imported by: bz2 • gzip • lzma

_contextvars (builtin module)

imported by: contextvars

_csv (builtin module)

imported by: csv

_ctypes E:\Application\Python\Python39\DLLs\_ctypes.pyd

imported by: ctypes

_datetime (builtin module)

imports: _strptime • time

imported by: datetime

_decimal E:\Application\Python\Python39\DLLs\_decimal.pyd

imported by: decimal

_frozen_importlib ExcludedModule

imported by: importlib • importlib.abc

_frozen_importlib_external MissingModule

imported by: importlib • importlib._bootstrap • importlib.abc

_functools (builtin module)

imported by: functools

_hashlib E:\Application\Python\Python39\DLLs\_hashlib.pyd

imported by: hashlib • hmac

_heapq (builtin module)

imported by: heapq

_imp (builtin module)

imported by: importlib • importlib._bootstrap_external • importlib.machinery • importlib.util

_io (builtin module)

imported by: importlib._bootstrap_external • io

_json (builtin module)

imports: json.decoder

imported by: json.decoder • json.encoder • json.scanner

_locale (builtin module)

imported by: _bootlocale • locale • re

_lzma E:\Application\Python\Python39\DLLs\_lzma.pyd

imported by: lzma

_md5 (builtin module)

imported by: hashlib

_multibytecodec (builtin module)

imported by: charset_normalizer.utils • encodings.big5 • encodings.big5hkscs • encodings.cp932 • encodings.cp949 • encodings.cp950 • encodings.euc_jis_2004 • encodings.euc_jisx0213 • encodings.euc_jp • encodings.euc_kr • encodings.gb18030 • encodings.gb2312 • encodings.gbk • encodings.hz • encodings.iso2022_jp • encodings.iso2022_jp_1 • encodings.iso2022_jp_2 • encodings.iso2022_jp_2004 • encodings.iso2022_jp_3 • encodings.iso2022_jp_ext • encodings.iso2022_kr • encodings.johab • encodings.shift_jis • encodings.shift_jis_2004 • encodings.shift_jisx0213

_opcode (builtin module)

imported by: opcode

_operator (builtin module)

imported by: hmac • operator

_pickle (builtin module)

imports: _compat_pickle • codecs • copyreg

imported by: pickle

_posixsubprocess MissingModule

imports: gc

imported by: subprocess

_py_abc SourceModule

imports: _weakrefset

imported by: abc

_pydecimal SourceModule

imports: collections • contextvars • itertools • locale • math • numbers • re • sys

imported by: decimal

_queue E:\Application\Python\Python39\DLLs\_queue.pyd

imported by: queue

_random (builtin module)

imported by: random

_scproxy MissingModule

imported by: urllib.request

_sha1 (builtin module)

imported by: hashlib

_sha256 (builtin module)

imported by: hashlib

_sha3 (builtin module)

imported by: hashlib

_sha512 (builtin module)

imported by: hashlib • random

_signal (builtin module)

imported by: signal

_socket E:\Application\Python\Python39\DLLs\_socket.pyd

imported by: socket

_sre (builtin module)

imports: copy • re

imported by: sre_compile • sre_constants

_ssl E:\Application\Python\Python39\DLLs\_ssl.pyd

imports: socket

imported by: ssl

_stat (builtin module)

imported by: stat

_statistics (builtin module)

imported by: statistics

_string (builtin module)

imported by: string

_strptime SourceModule

imports: _thread • calendar • datetime • locale • re • time

imported by: _datetime • datetime • time

_struct (builtin module)

imported by: struct

_thread (builtin module)

imported by: _strptime • dataclasses • functools • reprlib • tempfile • threading

_threading_local SourceModule

imports: contextlib • threading • weakref

imported by: threading

_tracemalloc (builtin module)

imported by: tracemalloc

_warnings (builtin module)

imported by: importlib._bootstrap_external • warnings

_weakref (builtin module)

imported by: _weakrefset • collections • weakref

_weakrefset SourceModule

imports: _weakref • types

imported by: GearDesignGuide.py • _py_abc • threading • weakref

_winapi (builtin module)

imported by: encodings • subprocess

abc SourceModule

imports: _abc • _py_abc

imported by: GearDesignGuide.py • _collections_abc • contextlib • email._policybase • functools • importlib.abc • importlib.metadata • inspect • io • numbers • os • selectors • typing

argparse SourceModule

imports: copy • gettext • os • re • shutil • sys • textwrap • warnings

imported by: ast • calendar • dis • gzip • inspect • tarfile • tokenize • zipfile

array (builtin module)

imported by: socket

ast SourceModule

imports: _ast • argparse • collections • contextlib • enum • inspect • sys • warnings

imported by: GearDesignGuide.py • inspect

atexit (builtin module)

imported by: logging • weakref

base64 SourceModule

imports: binascii • getopt • re • struct • sys

imported by: email._encoded_words • email.base64mime • email.encoders • encodings.base64_codec • requests.auth • ssl • urllib.request • urllib3.util.request

binascii (builtin module)

imported by: base64 • email._encoded_words • email.base64mime • email.contentmanager • email.header • encodings.hex_codec • encodings.uu_codec • quopri • urllib3.filepost • urllib3.util.ssl_ • uu • zipfile

bisect SourceModule

imports: _bisect

imported by: idna.core • idna.intranges • random • statistics • urllib.request

brotli MissingModule

imported by: urllib3.response • urllib3.util.request

brotlicffi MissingModule

imported by: urllib3.response • urllib3.util.request

builtins (builtin module)

imported by: bz2 • codecs • dataclasses • gettext • gzip • inspect • locale • lzma • operator • reprlib • subprocess • tarfile • tokenize • warnings

bz2 SourceModule

imports: _bz2 • _compression • builtins • io • os • threading

imported by: encodings.bz2_codec • shutil • tarfile • zipfile

calendar SourceModule

imports: argparse • datetime • itertools • locale • sys

imported by: _strptime • email._parseaddr • http.cookiejar • requests.cookies • ssl

certifi Package

imports: certifi.core

imported by: certifi.core • requests.certs

certifi.core SourceModule

imports: certifi • importlib.resources • os • sys • types • typing

imported by: certifi

chardet MissingModule

imported by: requests • requests.compat • requests.packages

charset_normalizer Package

imports: charset_normalizer.api • charset_normalizer.legacy • charset_normalizer.models • charset_normalizer.utils • charset_normalizer.version • logging

imported by: charset_normalizer.api • charset_normalizer.assets • charset_normalizer.cd • charset_normalizer.constant • charset_normalizer.legacy • charset_normalizer.md • charset_normalizer.models • charset_normalizer.utils • charset_normalizer.version • requests • requests.compat • requests.packages

charset_normalizer.api SourceModule

imports: charset_normalizer • charset_normalizer.cd • charset_normalizer.constant • charset_normalizer.md • charset_normalizer.models • charset_normalizer.utils • logging • ntpath • os • typing • warnings

imported by: charset_normalizer • charset_normalizer.legacy

charset_normalizer.assets Package

imports: charset_normalizer • typing

imported by: charset_normalizer.cd • charset_normalizer.constant

charset_normalizer.cd SourceModule

imports: charset_normalizer • charset_normalizer.assets • charset_normalizer.constant • charset_normalizer.md • charset_normalizer.models • charset_normalizer.utils • codecs • collections • functools • importlib • typing

imported by: charset_normalizer.api • charset_normalizer.models

charset_normalizer.constant SourceModule

imports: charset_normalizer • charset_normalizer.assets • codecs • encodings.aliases • re • typing

imported by: charset_normalizer.api • charset_normalizer.cd • charset_normalizer.legacy • charset_normalizer.md • charset_normalizer.models • charset_normalizer.utils

charset_normalizer.legacy SourceModule

imports: charset_normalizer • charset_normalizer.api • charset_normalizer.constant • charset_normalizer.models • typing • warnings

imported by: charset_normalizer

charset_normalizer.md SourceModule

imports: charset_normalizer • charset_normalizer.constant • charset_normalizer.utils • functools • typing

imported by: charset_normalizer.api • charset_normalizer.cd • charset_normalizer.models

charset_normalizer.models SourceModule

imports: charset_normalizer • charset_normalizer.cd • charset_normalizer.constant • charset_normalizer.md • charset_normalizer.utils • collections • encodings.aliases • hashlib • json • re • typing • warnings

imported by: charset_normalizer • charset_normalizer.api • charset_normalizer.cd • charset_normalizer.legacy

charset_normalizer.utils SourceModule

imports: _multibytecodec • charset_normalizer • charset_normalizer.constant • codecs • encodings.aliases • functools • importlib • logging • re • typing • unicodedata • unicodedata2

imported by: charset_normalizer • charset_normalizer.api • charset_normalizer.cd • charset_normalizer.md • charset_normalizer.models

charset_normalizer.version SourceModule

imports: charset_normalizer

imported by: charset_normalizer

codecs SourceModule

imports: _codecs • builtins • encodings • sys

imported by: GearDesignGuide.py • _pickle • charset_normalizer.cd • charset_normalizer.constant • charset_normalizer.utils • encodings • encodings.ascii • encodings.base64_codec • encodings.big5 • encodings.big5hkscs • encodings.bz2_codec • encodings.charmap • encodings.cp037 • encodings.cp1006 • encodings.cp1026 • encodings.cp1125 • encodings.cp1140 • encodings.cp1250 • encodings.cp1251 • encodings.cp1252 • encodings.cp1253 • encodings.cp1254 • encodings.cp1255 • encodings.cp1256 • encodings.cp1257 • encodings.cp1258 • encodings.cp273 • encodings.cp424 • encodings.cp437 • encodings.cp500 • encodings.cp720 • encodings.cp737 • encodings.cp775 • encodings.cp850 • encodings.cp852 • encodings.cp855 • encodings.cp856 • encodings.cp857 • encodings.cp858 • encodings.cp860 • encodings.cp861 • encodings.cp862 • encodings.cp863 • encodings.cp864 • encodings.cp865 • encodings.cp866 • encodings.cp869 • encodings.cp874 • encodings.cp875 • encodings.cp932 • encodings.cp949 • encodings.cp950 • encodings.euc_jis_2004 • encodings.euc_jisx0213 • encodings.euc_jp • encodings.euc_kr • encodings.gb18030 • encodings.gb2312 • encodings.gbk • encodings.hex_codec • encodings.hp_roman8 • encodings.hz • encodings.idna • encodings.iso2022_jp • encodings.iso2022_jp_1 • encodings.iso2022_jp_2 • encodings.iso2022_jp_2004 • encodings.iso2022_jp_3 • encodings.iso2022_jp_ext • encodings.iso2022_kr • encodings.iso8859_1 • encodings.iso8859_10 • encodings.iso8859_11 • encodings.iso8859_13 • encodings.iso8859_14 • encodings.iso8859_15 • encodings.iso8859_16 • encodings.iso8859_2 • encodings.iso8859_3 • encodings.iso8859_4 • encodings.iso8859_5 • encodings.iso8859_6 • encodings.iso8859_7 • encodings.iso8859_8 • encodings.iso8859_9 • encodings.johab • encodings.koi8_r • encodings.koi8_t • encodings.koi8_u • encodings.kz1048 • encodings.latin_1 • encodings.mac_arabic • encodings.mac_croatian • encodings.mac_cyrillic • encodings.mac_farsi • encodings.mac_greek • encodings.mac_iceland • encodings.mac_latin2 • encodings.mac_roman • encodings.mac_romanian • encodings.mac_turkish • encodings.mbcs • encodings.oem • encodings.palmos • encodings.ptcp154 • encodings.punycode • encodings.quopri_codec • encodings.raw_unicode_escape • encodings.rot_13 • encodings.shift_jis • encodings.shift_jis_2004 • encodings.shift_jisx0213 • encodings.tis_620 • encodings.undefined • encodings.unicode_escape • encodings.utf_16 • encodings.utf_16_be • encodings.utf_16_le • encodings.utf_32 • encodings.utf_32_be • encodings.utf_32_le • encodings.utf_7 • encodings.utf_8 • encodings.utf_8_sig • encodings.uu_codec • encodings.zlib_codec • json • pickle • requests.utils • tokenize • urllib3.filepost

collections Package

imports: _collections • _collections_abc • _weakref • collections.Mapping • collections.MutableMapping • copy • heapq • itertools • keyword • operator • reprlib • sys • warnings

imported by: GearDesignGuide.py • _pydecimal • ast • charset_normalizer.cd • charset_normalizer.models • collections.abc • configparser • contextlib • dis • email.feedparser • functools • importlib.metadata • inspect • pprint • queue • requests.compat • requests.sessions • requests.structures • requests.utils • selectors • shlex • shutil • ssl • statistics • string • tabulate • threading • tokenize • traceback • typing • urllib.parse • urllib.robotparser • urllib3._collections • urllib3.poolmanager • urllib3.util.queue • urllib3.util.retry • urllib3.util.url

collections.Mapping MissingModule

imported by: collections • urllib3._collections

collections.MutableMapping MissingModule

imported by: collections • urllib3._collections

collections.abc SourceModule

imports: _collections_abc • collections

imported by: GearDesignGuide.py • configparser • http.client • inspect • logging • requests.compat • selectors • tabulate • tracemalloc • typing • urllib3._collections

configparser SourceModule

imports: collections • collections.abc • functools • io • itertools • os • re • sys • warnings

imported by: importlib.metadata

contextlib SourceModule

imports: _collections_abc • abc • collections • functools • sys • types

imported by: _threading_local • ast • getpass • importlib._common • importlib.metadata • importlib.resources • importlib.util • requests.utils • subprocess • typing • urllib.request • urllib3.response • zipfile

contextvars SourceModule

imports: _contextvars

imported by: _pydecimal

copy SourceModule

imports: 'org.python' • copyreg • types • weakref

imported by: _sre • argparse • collections • dataclasses • email.generator • gettext • http.cookiejar • requests.cookies • tarfile • weakref

copyreg SourceModule

imported by: GearDesignGuide.py • _pickle • copy • pickle • re

cryptography MissingModule

imported by: requests • urllib3.contrib.pyopenssl

csv SourceModule

imports: _csv • io • re

imported by: GearDesignGuide.py • importlib.metadata

ctypes Package

imports: _ctypes • ctypes._endian • nt • os • struct • sys • types

imported by: GearDesignGuide.py • ctypes._endian

ctypes._endian SourceModule

imports: ctypes • sys

imported by: ctypes

dataclasses SourceModule

imports: _thread • builtins • copy • functools • inspect • keyword • re • sys • types

imported by: tabulate

datetime SourceModule

imports: _datetime • _strptime • math • sys • time • warnings

imported by: _strptime • calendar • email.utils • http.cookiejar • requests.models • requests.sessions • urllib3.connection

decimal SourceModule

imports: _decimal • _pydecimal

imported by: GearDesignGuide.py • fractions • statistics

dis SourceModule

imports: argparse • collections • io • opcode • sys • types

imported by: inspect

dummy_threading MissingModule

imported by: requests.cookies

email Package

imports: email._header_value_parser • email.charset • email.errors • email.header • email.parser

imported by: email._encoded_words • email._header_value_parser • email._parseaddr • email._policybase • email.base64mime • email.charset • email.contentmanager • email.encoders • email.errors • email.feedparser • email.generator • email.header • email.headerregistry • email.iterators • email.message • email.parser • email.policy • email.quoprimime • email.utils • importlib.metadata • urllib.request • urllib3.util.retry

email._encoded_words SourceModule

imports: base64 • binascii • email • email.errors • functools • re • string

imported by: email._header_value_parser • email.message

email._header_value_parser SourceModule

imports: email • email._encoded_words • email.errors • email.utils • operator • re • string • sys • urllib

imported by: email • email.headerregistry

email._parseaddr SourceModule

imports: calendar • email • time

imported by: email.utils

email._policybase SourceModule

imports: abc • email • email.charset • email.header • email.utils

imported by: email.feedparser • email.message • email.parser • email.policy

email.base64mime SourceModule

imports: base64 • binascii • email

imported by: email.charset • email.header

email.charset SourceModule

imports: email • email.base64mime • email.encoders • email.errors • email.quoprimime • functools

imported by: email • email._policybase • email.contentmanager • email.header • email.message • email.utils

email.contentmanager SourceModule

imports: binascii • email • email.charset • email.errors • email.message • email.quoprimime

imported by: email.policy

email.encoders SourceModule

imports: base64 • email • quopri

imported by: email.charset

email.errors SourceModule

imports: email

imported by: email • email._encoded_words • email._header_value_parser • email.charset • email.contentmanager • email.feedparser • email.header • email.headerregistry • email.message • urllib3.util.response

email.feedparser SourceModule

imports: collections • email • email._policybase • email.errors • email.message • io • re

imported by: email.parser

email.generator SourceModule

imports: copy • email • email.utils • io • random • re • sys • time

imported by: email.message

email.header SourceModule

imports: binascii • email • email.base64mime • email.charset • email.errors • email.quoprimime • re

imported by: email • email._policybase

email.headerregistry SourceModule

imports: email • email._header_value_parser • email.errors • email.utils • types

imported by: email.policy

email.iterators SourceModule

imports: email • io • sys

imported by: email.message

email.message SourceModule

imports: email • email._encoded_words • email._policybase • email.charset • email.errors • email.generator • email.iterators • email.policy • email.utils • io • quopri • re • uu

imported by: email.contentmanager • email.feedparser • email.policy • http.client

email.parser SourceModule

imports: email • email._policybase • email.feedparser • io

imported by: email • http.client

email.policy SourceModule

imports: email • email._policybase • email.contentmanager • email.headerregistry • email.message • email.utils • re • sys

imported by: email.message

email.quoprimime SourceModule

imports: email • re • string

imported by: email.charset • email.contentmanager • email.header

email.utils SourceModule

imports: datetime • email • email._parseaddr • email.charset • os • random • re • socket • time • urllib.parse

imported by: email._header_value_parser • email._policybase • email.generator • email.headerregistry • email.message • email.policy • urllib.request • urllib3.fields

encodings Package

imports: _winapi • codecs • encodings • encodings.aliases • encodings.ascii • encodings.base64_codec • encodings.big5 • encodings.big5hkscs • encodings.bz2_codec • encodings.charmap • encodings.cp037 • encodings.cp1006 • encodings.cp1026 • encodings.cp1125 • encodings.cp1140 • encodings.cp1250 • encodings.cp1251 • encodings.cp1252 • encodings.cp1253 • encodings.cp1254 • encodings.cp1255 • encodings.cp1256 • encodings.cp1257 • encodings.cp1258 • encodings.cp273 • encodings.cp424 • encodings.cp437 • encodings.cp500 • encodings.cp720 • encodings.cp737 • encodings.cp775 • encodings.cp850 • encodings.cp852 • encodings.cp855 • encodings.cp856 • encodings.cp857 • encodings.cp858 • encodings.cp860 • encodings.cp861 • encodings.cp862 • encodings.cp863 • encodings.cp864 • encodings.cp865 • encodings.cp866 • encodings.cp869 • encodings.cp874 • encodings.cp875 • encodings.cp932 • encodings.cp949 • encodings.cp950 • encodings.euc_jis_2004 • encodings.euc_jisx0213 • encodings.euc_jp • encodings.euc_kr • encodings.gb18030 • encodings.gb2312 • encodings.gbk • encodings.hex_codec • encodings.hp_roman8 • encodings.hz • encodings.idna • encodings.iso2022_jp • encodings.iso2022_jp_1 • encodings.iso2022_jp_2 • encodings.iso2022_jp_2004 • encodings.iso2022_jp_3 • encodings.iso2022_jp_ext • encodings.iso2022_kr • encodings.iso8859_1 • encodings.iso8859_10 • encodings.iso8859_11 • encodings.iso8859_13 • encodings.iso8859_14 • encodings.iso8859_15 • encodings.iso8859_16 • encodings.iso8859_2 • encodings.iso8859_3 • encodings.iso8859_4 • encodings.iso8859_5 • encodings.iso8859_6 • encodings.iso8859_7 • encodings.iso8859_8 • encodings.iso8859_9 • encodings.johab • encodings.koi8_r • encodings.koi8_t • encodings.koi8_u • encodings.kz1048 • encodings.latin_1 • encodings.mac_arabic • encodings.mac_croatian • encodings.mac_cyrillic • encodings.mac_farsi • encodings.mac_greek • encodings.mac_iceland • encodings.mac_latin2 • encodings.mac_roman • encodings.mac_romanian • encodings.mac_turkish • encodings.mbcs • encodings.oem • encodings.palmos • encodings.ptcp154 • encodings.punycode • encodings.quopri_codec • encodings.raw_unicode_escape • encodings.rot_13 • encodings.shift_jis • encodings.shift_jis_2004 • encodings.shift_jisx0213 • encodings.tis_620 • encodings.undefined • encodings.unicode_escape • encodings.utf_16 • encodings.utf_16_be • encodings.utf_16_le • encodings.utf_32 • encodings.utf_32_be • encodings.utf_32_le • encodings.utf_7 • encodings.utf_8 • encodings.utf_8_sig • encodings.uu_codec • encodings.zlib_codec • sys

imported by: GearDesignGuide.py • codecs • encodings • encodings.aliases • encodings.ascii • encodings.base64_codec • encodings.big5 • encodings.big5hkscs • encodings.bz2_codec • encodings.charmap • encodings.cp037 • encodings.cp1006 • encodings.cp1026 • encodings.cp1125 • encodings.cp1140 • encodings.cp1250 • encodings.cp1251 • encodings.cp1252 • encodings.cp1253 • encodings.cp1254 • encodings.cp1255 • encodings.cp1256 • encodings.cp1257 • encodings.cp1258 • encodings.cp273 • encodings.cp424 • encodings.cp437 • encodings.cp500 • encodings.cp720 • encodings.cp737 • encodings.cp775 • encodings.cp850 • encodings.cp852 • encodings.cp855 • encodings.cp856 • encodings.cp857 • encodings.cp858 • encodings.cp860 • encodings.cp861 • encodings.cp862 • encodings.cp863 • encodings.cp864 • encodings.cp865 • encodings.cp866 • encodings.cp869 • encodings.cp874 • encodings.cp875 • encodings.cp932 • encodings.cp949 • encodings.cp950 • encodings.euc_jis_2004 • encodings.euc_jisx0213 • encodings.euc_jp • encodings.euc_kr • encodings.gb18030 • encodings.gb2312 • encodings.gbk • encodings.hex_codec • encodings.hp_roman8 • encodings.hz • encodings.idna • encodings.iso2022_jp • encodings.iso2022_jp_1 • encodings.iso2022_jp_2 • encodings.iso2022_jp_2004 • encodings.iso2022_jp_3 • encodings.iso2022_jp_ext • encodings.iso2022_kr • encodings.iso8859_1 • encodings.iso8859_10 • encodings.iso8859_11 • encodings.iso8859_13 • encodings.iso8859_14 • encodings.iso8859_15 • encodings.iso8859_16 • encodings.iso8859_2 • encodings.iso8859_3 • encodings.iso8859_4 • encodings.iso8859_5 • encodings.iso8859_6 • encodings.iso8859_7 • encodings.iso8859_8 • encodings.iso8859_9 • encodings.johab • encodings.koi8_r • encodings.koi8_t • encodings.koi8_u • encodings.kz1048 • encodings.latin_1 • encodings.mac_arabic • encodings.mac_croatian • encodings.mac_cyrillic • encodings.mac_farsi • encodings.mac_greek • encodings.mac_iceland • encodings.mac_latin2 • encodings.mac_roman • encodings.mac_romanian • encodings.mac_turkish • encodings.mbcs • encodings.oem • encodings.palmos • encodings.ptcp154 • encodings.punycode • encodings.quopri_codec • encodings.raw_unicode_escape • encodings.rot_13 • encodings.shift_jis • encodings.shift_jis_2004 • encodings.shift_jisx0213 • encodings.tis_620 • encodings.undefined • encodings.unicode_escape • encodings.utf_16 • encodings.utf_16_be • encodings.utf_16_le • encodings.utf_32 • encodings.utf_32_be • encodings.utf_32_le • encodings.utf_7 • encodings.utf_8 • encodings.utf_8_sig • encodings.uu_codec • encodings.zlib_codec • locale

encodings.aliases SourceModule

imports: encodings

imported by: GearDesignGuide.py • charset_normalizer.constant • charset_normalizer.models • charset_normalizer.utils • encodings • locale

encodings.ascii SourceModule

imports: codecs • encodings

imported by: GearDesignGuide.py • encodings

encodings.base64_codec SourceModule

imports: base64 • codecs • encodings

imported by: GearDesignGuide.py • encodings

encodings.big5 SourceModule

imports: _codecs_tw • _multibytecodec • codecs • encodings

imported by: GearDesignGuide.py • encodings

encodings.big5hkscs SourceModule

imports: _codecs_hk • _multibytecodec • codecs • encodings

imported by: GearDesignGuide.py • encodings

encodings.bz2_codec SourceModule

imports: bz2 • codecs • encodings

imported by: GearDesignGuide.py • encodings

encodings.charmap SourceModule

imports: codecs • encodings

imported by: GearDesignGuide.py • encodings

encodings.cp037 SourceModule

imports: codecs • encodings

imported by: GearDesignGuide.py • encodings

encodings.cp1006 SourceModule

imports: codecs • encodings

imported by: GearDesignGuide.py • encodings

encodings.cp1026 SourceModule

imports: codecs • encodings

imported by: GearDesignGuide.py • encodings

encodings.cp1125 SourceModule

imports: codecs • encodings

imported by: GearDesignGuide.py • encodings

encodings.cp1140 SourceModule

imports: codecs • encodings

imported by: GearDesignGuide.py • encodings

encodings.cp1250 SourceModule

imports: codecs • encodings

imported by: GearDesignGuide.py • encodings

encodings.cp1251 SourceModule

imports: codecs • encodings

imported by: GearDesignGuide.py • encodings

encodings.cp1252 SourceModule

imports: codecs • encodings

imported by: GearDesignGuide.py • encodings

encodings.cp1253 SourceModule

imports: codecs • encodings

imported by: GearDesignGuide.py • encodings

encodings.cp1254 SourceModule

imports: codecs • encodings

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

imported by: GearDesignGuide.py • encodings

encodings.iso8859_8 SourceModule

imports: codecs • encodings

imported by: GearDesignGuide.py • encodings

encodings.iso8859_9 SourceModule

imports: codecs • encodings

imported by: GearDesignGuide.py • encodings

encodings.johab SourceModule

imports: _codecs_kr • _multibytecodec • codecs • encodings

imported by: GearDesignGuide.py • encodings

encodings.koi8_r SourceModule

imports: codecs • encodings

imported by: GearDesignGuide.py • encodings

encodings.koi8_t SourceModule

imports: codecs • encodings

imported by: GearDesignGuide.py • encodings

encodings.koi8_u SourceModule

imports: codecs • encodings

imported by: GearDesignGuide.py • encodings

encodings.kz1048 SourceModule

imports: codecs • encodings

imported by: GearDesignGuide.py • encodings

encodings.latin_1 SourceModule

imports: codecs • encodings

imported by: GearDesignGuide.py • encodings

encodings.mac_arabic SourceModule

imports: codecs • encodings

imported by: GearDesignGuide.py • encodings

encodings.mac_croatian SourceModule

imports: codecs • encodings

imported by: GearDesignGuide.py • encodings

encodings.mac_cyrillic SourceModule

imports: codecs • encodings

imported by: GearDesignGuide.py • encodings

encodings.mac_farsi SourceModule

imports: codecs • encodings

imported by: GearDesignGuide.py • encodings

encodings.mac_greek SourceModule

imports: codecs • encodings

imported by: GearDesignGuide.py • encodings

encodings.mac_iceland SourceModule

imports: codecs • encodings

imported by: GearDesignGuide.py • encodings

encodings.mac_latin2 SourceModule

imports: codecs • encodings

imported by: GearDesignGuide.py • encodings

encodings.mac_roman SourceModule

imports: codecs • encodings

imported by: GearDesignGuide.py • encodings

encodings.mac_romanian SourceModule

imports: codecs • encodings

imported by: GearDesignGuide.py • encodings

encodings.mac_turkish SourceModule

imports: codecs • encodings

imported by: GearDesignGuide.py • encodings

encodings.mbcs SourceModule

imports: codecs • encodings

imported by: GearDesignGuide.py • encodings

encodings.oem SourceModule

imports: codecs • encodings

imported by: GearDesignGuide.py • encodings

encodings.palmos SourceModule

imports: codecs • encodings

imported by: GearDesignGuide.py • encodings

encodings.ptcp154 SourceModule

imports: codecs • encodings

imported by: GearDesignGuide.py • encodings

encodings.punycode SourceModule

imports: codecs • encodings

imported by: GearDesignGuide.py • encodings

encodings.quopri_codec SourceModule

imports: codecs • encodings • io • quopri

imported by: GearDesignGuide.py • encodings

encodings.raw_unicode_escape SourceModule

imports: codecs • encodings

imported by: GearDesignGuide.py • encodings

encodings.rot_13 SourceModule

imports: codecs • encodings • sys

imported by: GearDesignGuide.py • encodings

encodings.shift_jis SourceModule

imports: _codecs_jp • _multibytecodec • codecs • encodings

imported by: GearDesignGuide.py • encodings

encodings.shift_jis_2004 SourceModule

imports: _codecs_jp • _multibytecodec • codecs • encodings

imported by: GearDesignGuide.py • encodings

encodings.shift_jisx0213 SourceModule

imports: _codecs_jp • _multibytecodec • codecs • encodings

imported by: GearDesignGuide.py • encodings

encodings.tis_620 SourceModule

imports: codecs • encodings

imported by: GearDesignGuide.py • encodings

encodings.undefined SourceModule

imports: codecs • encodings

imported by: GearDesignGuide.py • encodings

encodings.unicode_escape SourceModule

imports: codecs • encodings

imported by: GearDesignGuide.py • encodings

encodings.utf_16 SourceModule

imports: codecs • encodings • sys

imported by: GearDesignGuide.py • encodings

encodings.utf_16_be SourceModule

imports: codecs • encodings

imported by: GearDesignGuide.py • encodings

encodings.utf_16_le SourceModule

imports: codecs • encodings

imported by: GearDesignGuide.py • encodings

encodings.utf_32 SourceModule

imports: codecs • encodings • sys

imported by: GearDesignGuide.py • encodings

encodings.utf_32_be SourceModule

imports: codecs • encodings

imported by: GearDesignGuide.py • encodings

encodings.utf_32_le SourceModule

imports: codecs • encodings

imported by: GearDesignGuide.py • encodings

encodings.utf_7 SourceModule

imports: codecs • encodings

imported by: GearDesignGuide.py • encodings

encodings.utf_8 SourceModule

imports: codecs • encodings

imported by: GearDesignGuide.py • encodings

encodings.utf_8_sig SourceModule

imports: codecs • encodings

imported by: GearDesignGuide.py • encodings

encodings.uu_codec SourceModule

imports: binascii • codecs • encodings • io

imported by: GearDesignGuide.py • encodings

encodings.zlib_codec SourceModule

imports: codecs • encodings • zlib

imported by: GearDesignGuide.py • encodings

enum SourceModule

imports: sys • types • warnings

imported by: GearDesignGuide.py • ast • http • inspect • py_compile • re • signal • socket • ssl

errno (builtin module)

imported by: gettext • gzip • http.client • pathlib • shutil • socket • ssl • subprocess • tempfile • urllib3.connectionpool • urllib3.util.wait

fnmatch SourceModule

imports: functools • itertools • os • posixpath • re

imported by: GearDesignGuide.py • pathlib • shutil • tracemalloc • urllib.request

fractions SourceModule

imports: decimal • math • numbers • operator • re • sys

imported by: statistics

ftplib SourceModule

imports: netrc • re • socket • ssl • sys • warnings

imported by: urllib.request

functools SourceModule

imports: _functools • _thread • abc • collections • reprlib • types • typing • weakref

imported by: GearDesignGuide.py • charset_normalizer.cd • charset_normalizer.md • charset_normalizer.utils • configparser • contextlib • dataclasses • email._encoded_words • email.charset • fnmatch • importlib._common • importlib.metadata • importlib.util • inspect • ipaddress • linecache • locale • operator • pathlib • pickle • re • tabulate • tempfile • threading • tracemalloc • types • typing • urllib3.packages.six • urllib3.poolmanager • urllib3.util.wait

gc (builtin module)

imports: time

imported by: _posixsubprocess • weakref

genericpath SourceModule

imports: os • stat

imported by: GearDesignGuide.py • ntpath • posixpath

getopt SourceModule

imports: gettext • os • sys

imported by: base64 • mimetypes • quopri • tabulate

getpass SourceModule

imports: contextlib • io • msvcrt • os • pwd • sys • termios • warnings

imported by: urllib.request

gettext SourceModule

imports: builtins • copy • errno • locale • os • re • struct • sys • warnings

imported by: argparse • getopt • optparse

grp MissingModule

imported by: pathlib • shutil • subprocess • tarfile

gzip SourceModule

imports: _compression • argparse • builtins • errno • io • os • struct • sys • time • warnings • zlib

imported by: tarfile

hashlib SourceModule

imports: _blake2 • _hashlib • _md5 • _sha1 • _sha256 • _sha3 • _sha512 • logging

imported by: charset_normalizer.models • hmac • random • requests.auth • urllib.request • urllib3.util.ssl_

heapq SourceModule

imports: _heapq

imported by: GearDesignGuide.py • collections • queue

hmac SourceModule

imports: _hashlib • _operator • hashlib • warnings

imported by: urllib3.util.ssl_

html Package

imports: html.entities • re

imported by: html.entities • tabulate

html.entities SourceModule

imports: html

imported by: html

http Package

imports: enum

imported by: http.client • http.cookiejar • http.cookies • requests.compat

http.client SourceModule

imports: collections.abc • email.message • email.parser • errno • http • io • re • socket • ssl • urllib.parse • warnings

imported by: http.client • http.cookiejar • urllib.request

http.client AliasNode

imports: http.client • urllib3.packages.six.moves

imported by: urllib3.connection • urllib3.exceptions • urllib3.util.response

http.cookiejar SourceModule

imports: calendar • copy • datetime • http • http.client • io • logging • os • re • threading • time • traceback • urllib.parse • urllib.request • warnings

imported by: requests.compat • urllib.request

http.cookies SourceModule

imports: http • re • string • time • types

imported by: requests.compat

idna Package

imports: idna • idna.core • idna.idnadata • idna.intranges • idna.package_data

imported by: idna • idna.core • idna.idnadata • idna.intranges • idna.package_data • idna.uts46data • requests.models • urllib3.contrib.pyopenssl • urllib3.util.url

idna.core SourceModule

imports: bisect • idna • idna.idnadata • idna.intranges • idna.uts46data • re • typing • unicodedata

imported by: idna

idna.idnadata SourceModule

imports: idna

imported by: idna • idna.core

idna.intranges SourceModule

imports: bisect • idna • typing

imported by: idna • idna.core

idna.package_data SourceModule

imports: idna

imported by: idna

idna.uts46data SourceModule

imports: idna • typing

imported by: idna.core

importlib Package

imports: _frozen_importlib • _frozen_importlib_external • _imp • importlib • importlib._bootstrap • importlib._bootstrap_external • importlib._common • importlib.machinery • sys • types • warnings

imported by: charset_normalizer.cd • charset_normalizer.utils • importlib • importlib._bootstrap • importlib._bootstrap_external • importlib._common • importlib.abc • importlib.machinery • importlib.metadata • importlib.resources • importlib.util • inspect

importlib._bootstrap SourceModule

imports: _frozen_importlib_external • importlib

imported by: importlib • importlib.abc • importlib.machinery • importlib.util

importlib._bootstrap_external SourceModule

imports: _imp • _io • _warnings • importlib • importlib.metadata • marshal • nt • posix • sys • tokenize • winreg

imported by: importlib • importlib.abc • importlib.machinery • importlib.util • py_compile

importlib._common SourceModule

imports: contextlib • functools • importlib • os • pathlib • tempfile • zipfile

imported by: importlib • importlib.resources

importlib.abc SourceModule

imports: _frozen_importlib • _frozen_importlib_external • abc • importlib • importlib._bootstrap • importlib._bootstrap_external • importlib.machinery • typing • warnings

imported by: importlib.metadata • importlib.resources • importlib.util

importlib.machinery SourceModule

imports: _imp • importlib • importlib._bootstrap • importlib._bootstrap_external

imported by: importlib • importlib.abc • inspect • py_compile

importlib.metadata SourceModule

imports: abc • collections • configparser • contextlib • csv • email • functools • importlib • importlib.abc • io • itertools • operator • os • pathlib • pep517 • posixpath • re • sys • zipfile

imported by: importlib._bootstrap_external

importlib.resources SourceModule

imports: 'typing.io' • contextlib • importlib • importlib._common • importlib.abc • io • os • pathlib • types • typing

imported by: certifi.core

importlib.util SourceModule

imports: _imp • contextlib • functools • importlib • importlib._bootstrap • importlib._bootstrap_external • importlib.abc • sys • types • warnings

imported by: py_compile • urllib3.packages.six • zipfile

inspect SourceModule

imports: abc • argparse • ast • builtins • collections • collections.abc • dis • enum • functools • importlib • importlib.machinery • itertools • linecache • operator • os • re • sys • token • tokenize • types • warnings

imported by: ast • dataclasses • pyi_rth_inspect.py

io SourceModule

imports: _io • abc

imported by: GearDesignGuide.py • _compression • bz2 • configparser • csv • dis • email.feedparser • email.generator • email.iterators • email.message • email.parser • encodings.quopri_codec • encodings.uu_codec • getpass • gzip • http.client • http.cookiejar • importlib.metadata • importlib.resources • logging • lzma • os • pathlib • pickle • pprint • pyi_rth_subprocess.py • quopri • requests.compat • requests.models • requests.utils • shlex • socket • subprocess • tabulate • tarfile • tempfile • tokenize • urllib.request • urllib3.contrib.pyopenssl • urllib3.filepost • urllib3.packages.backports.makefile • urllib3.packages.six • urllib3.response • urllib3.util.ssltransport • zipfile

ipaddress SourceModule

imports: functools • re

imported by: urllib3.util.ssl_match_hostname

itertools (builtin module)

imported by: _pydecimal • calendar • collections • configparser • fnmatch • importlib.metadata • inspect • pickle • random • reprlib • statistics • tabulate • threading • tokenize • traceback • urllib3.packages.six • urllib3.util.retry • weakref • zipfile

json Package

imports: codecs • json.decoder • json.encoder • json.scanner

imported by: charset_normalizer.models • json.decoder • json.encoder • json.scanner • requests.compat

json.decoder SourceModule

imports: _json • json • json.scanner • re

imported by: _json • json

json.encoder SourceModule

imports: _json • json • re

imported by: json

json.scanner SourceModule

imports: _json • json • re

imported by: json • json.decoder

keyword SourceModule

imported by: GearDesignGuide.py • collections • dataclasses

linecache SourceModule

imports: functools • os • sys • tokenize

imported by: GearDesignGuide.py • inspect • traceback • tracemalloc • warnings

locale SourceModule

imports: _bootlocale • _collections_abc • _locale • builtins • encodings • encodings.aliases • functools • os • re • sys • warnings

imported by: GearDesignGuide.py • _bootlocale • _pydecimal • _strptime • calendar • gettext

logging Package

imports: atexit • collections.abc • io • os • pickle • re • string • sys • threading • time • traceback • warnings • weakref

imported by: charset_normalizer • charset_normalizer.api • charset_normalizer.utils • hashlib • http.cookiejar • requests • urllib3 • urllib3.connection • urllib3.connectionpool • urllib3.contrib.pyopenssl • urllib3.poolmanager • urllib3.response • urllib3.util.retry

lzma SourceModule

imports: _compression • _lzma • builtins • io • os

imported by: shutil • tarfile • zipfile

marshal (builtin module)

imported by: importlib._bootstrap_external

math (builtin module)

imported by: GearDesignGuide.py • _pydecimal • datetime • fractions • random • selectors • statistics • tabulate

mimetypes SourceModule

imports: getopt • os • posixpath • sys • urllib.parse • winreg

imported by: urllib.request • urllib3.fields

msvcrt (builtin module)

imported by: getpass • subprocess

netrc SourceModule

imports: os • pwd • shlex • stat

imported by: ftplib • requests.utils

nt (builtin module)

imported by: ctypes • importlib._bootstrap_external • ntpath • os • pathlib • shutil

ntpath SourceModule

imports: genericpath • nt • os • stat • string • sys

imported by: GearDesignGuide.py • ntpath • os • pathlib

ntpath AliasNode

imports: ntpath • os

imported by: GearDesignGuide.py • charset_normalizer.api • os • py_compile • requests.adapters • tracemalloc

nturl2path SourceModule

imports: string • urllib.parse

imported by: urllib.request

numbers SourceModule

imports: abc

imported by: _pydecimal • fractions • statistics

opcode SourceModule

imports: _opcode

imported by: dis

operator SourceModule

imports: _operator • builtins • functools

imported by: GearDesignGuide.py • collections • email._header_value_parser • fractions • importlib.metadata • inspect • pathlib • statistics • typing • urllib3.packages.six

optparse SourceModule

imports: gettext • os • sys • textwrap

imported by: uu

org MissingModule

imported by: pickle

os SourceModule

imports: _collections_abc • abc • io • nt • ntpath • ntpath • posix • posixpath • stat • subprocess • sys • warnings

imported by: GearDesignGuide.py • argparse • bz2 • certifi.core • charset_normalizer.api • configparser • ctypes • email.utils • fnmatch • genericpath • getopt • getpass • gettext • gzip • http.cookiejar • importlib._common • importlib.metadata • importlib.resources • inspect • linecache • locale • logging • lzma • mimetypes • netrc • ntpath • ntpath • optparse • pathlib • posixpath • py_compile • pyi_rth_inspect.py • random • requests.auth • requests.sessions • requests.utils • shlex • shutil • socket • ssl • subprocess • tarfile • tempfile • threading • urllib.request • urllib3.connection • urllib3.contrib._appengine_environ • urllib3.filepost • urllib3.util.ssl_ • uu • zipfile

pathlib SourceModule

imports: _collections_abc • errno • fnmatch • functools • grp • io • nt • ntpath • operator • os • posixpath • pwd • re • stat • sys • urllib.parse

imported by: GearDesignGuide.py • importlib._common • importlib.metadata • importlib.resources

pep517 MissingModule

imported by: importlib.metadata

pickle SourceModule

imports: _compat_pickle • _pickle • codecs • copyreg • functools • io • itertools • org • pprint • re • struct • sys • types

imported by: logging • tracemalloc

posix MissingModule

imports: resource

imported by: importlib._bootstrap_external • os • shutil

posixpath SourceModule

imports: genericpath • os • pwd • re • stat • sys

imported by: GearDesignGuide.py • fnmatch • importlib.metadata • mimetypes • os • pathlib • urllib.request • zipfile

pprint SourceModule

imports: collections • io • re • sys • time • types

imported by: pickle

pwd MissingModule

imported by: getpass • netrc • pathlib • posixpath • shutil • subprocess • tarfile

py_compile SourceModule

imports: enum • importlib._bootstrap_external • importlib.machinery • importlib.util • ntpath • os • sys • traceback

imported by: zipfile

queue SourceModule

imports: _queue • collections • heapq • threading • time • types

imported by: queue

queue AliasNode

imports: queue

imported by: urllib3.connectionpool • urllib3.packages.six.moves • urllib3.util.queue

quopri SourceModule

imports: binascii • getopt • io • sys

imported by: email.encoders • email.message • encodings.quopri_codec

random SourceModule

imports: _collections_abc • _random • _sha512 • bisect • hashlib • itertools • math • os • statistics • time • warnings

imported by: email.generator • email.utils • statistics • tempfile

re SourceModule

imports: _locale • copyreg • enum • functools • sre_compile • sre_constants • sre_parse

imported by: GearDesignGuide.py • _pydecimal • _sre • _strptime • argparse • base64 • charset_normalizer.constant • charset_normalizer.models • charset_normalizer.utils • configparser • csv • dataclasses • email._encoded_words • email._header_value_parser • email.feedparser • email.generator • email.header • email.message • email.policy • email.quoprimime • email.utils • encodings.idna • fnmatch • fractions • ftplib • gettext • html • http.client • http.cookiejar • http.cookies • idna.core • importlib.metadata • inspect • ipaddress • json.decoder • json.encoder • json.scanner • locale • logging • pathlib • pickle • posixpath • pprint • requests._internal_utils • requests.auth • requests.utils • shlex • string • tabulate • tarfile • textwrap • tokenize • typing • urllib.parse • urllib.request • urllib3.connection • urllib3.connectionpool • urllib3.fields • urllib3.util.retry • urllib3.util.ssl_match_hostname • urllib3.util.url • warnings

reprlib SourceModule

imports: _thread • builtins • itertools

imported by: GearDesignGuide.py • collections • functools

requests Package

imports: chardet • charset_normalizer • cryptography • logging • requests • requests.__version__ • requests.api • requests.certs • requests.exceptions • requests.models • requests.packages • requests.sessions • requests.status_codes • requests.utils • ssl • urllib3 • urllib3.contrib • urllib3.contrib.pyopenssl • urllib3.exceptions • warnings

imported by: GearDesignGuide.py • requests • requests.__version__ • requests._internal_utils • requests.adapters • requests.api • requests.auth • requests.certs • requests.compat • requests.cookies • requests.exceptions • requests.hooks • requests.models • requests.packages • requests.sessions • requests.status_codes • requests.structures • requests.utils

requests.__version__ SourceModule

imports: requests

imported by: requests • requests.utils

requests._internal_utils SourceModule

imports: re • requests • requests.compat

imported by: requests.auth • requests.cookies • requests.models • requests.sessions • requests.utils

requests.adapters SourceModule

imports: ntpath • requests • requests.auth • requests.compat • requests.cookies • requests.exceptions • requests.models • requests.structures • requests.utils • socket • urllib3.contrib.socks • urllib3.exceptions • urllib3.poolmanager • urllib3.response • urllib3.util • urllib3.util.retry

imported by: requests.sessions

requests.api SourceModule

imports: requests • requests.sessions

imported by: requests

requests.auth SourceModule

imports: base64 • hashlib • os • re • requests • requests._internal_utils • requests.compat • requests.cookies • requests.utils • threading • time • warnings

imported by: requests.adapters • requests.models • requests.sessions

requests.certs SourceModule

imports: certifi • requests

imported by: requests • requests.utils

requests.compat SourceModule

imports: chardet • charset_normalizer • collections • collections.abc • http • http.cookiejar • http.cookies • io • json • requests • simplejson • sys • urllib.parse • urllib.request

imported by: requests._internal_utils • requests.adapters • requests.auth • requests.cookies • requests.exceptions • requests.models • requests.sessions • requests.structures • requests.utils

requests.cookies SourceModule

imports: calendar • copy • dummy_threading • requests • requests._internal_utils • requests.compat • threading • time

imported by: requests.adapters • requests.auth • requests.models • requests.sessions • requests.utils

requests.exceptions SourceModule

imports: requests • requests.compat • urllib3.exceptions

imported by: requests • requests.adapters • requests.models • requests.sessions • requests.utils

requests.hooks SourceModule

imports: requests

imported by: requests.models • requests.sessions

requests.models SourceModule

imports: datetime • encodings.idna • idna • io • requests • requests._internal_utils • requests.auth • requests.compat • requests.cookies • requests.exceptions • requests.hooks • requests.status_codes • requests.structures • requests.utils • urllib3.exceptions • urllib3.fields • urllib3.filepost • urllib3.util

imported by: requests • requests.adapters • requests.sessions

requests.packages SourceModule

imports: chardet • charset_normalizer • requests • sys • warnings

imported by: requests

requests.sessions SourceModule

imports: collections • datetime • os • requests • requests._internal_utils • requests.adapters • requests.auth • requests.compat • requests.cookies • requests.exceptions • requests.hooks • requests.models • requests.status_codes • requests.structures • requests.utils • sys • time

imported by: requests • requests.api

requests.status_codes SourceModule

imports: requests • requests.structures

imported by: requests • requests.models • requests.sessions

requests.structures SourceModule

imports: collections • requests • requests.compat

imported by: requests.adapters • requests.models • requests.sessions • requests.status_codes • requests.utils

requests.utils SourceModule

imports: codecs • collections • contextlib • io • netrc • os • re • requests • requests.__version__ • requests._internal_utils • requests.certs • requests.compat • requests.cookies • requests.exceptions • requests.structures • socket • struct • sys • tempfile • urllib3.util • warnings • winreg • zipfile

imported by: requests • requests.adapters • requests.auth • requests.models • requests.sessions

resource MissingModule

imported by: posix

select E:\Application\Python\Python39\DLLs\select.pyd

imported by: selectors • subprocess • urllib3.util.wait

selectors SourceModule

imports: abc • collections • collections.abc • math • select • sys

imported by: socket • subprocess

shlex SourceModule

imports: collections • io • os • re • sys • warnings

imported by: netrc

shutil SourceModule

imports: bz2 • collections • errno • fnmatch • grp • lzma • nt • os • posix • pwd • stat • sys • tarfile • zipfile • zlib

imported by: GearDesignGuide.py • argparse • tarfile • tempfile • zipfile

signal SourceModule

imports: _signal • enum

imported by: subprocess

simplejson MissingModule

imported by: requests.compat

socket SourceModule

imports: _socket • array • enum • errno • io • os • selectors • sys

imported by: _ssl • email.utils • ftplib • http.client • requests.adapters • requests.utils • ssl • urllib.request • urllib3.connection • urllib3.connectionpool • urllib3.contrib.pyopenssl • urllib3.contrib.socks • urllib3.packages.backports.makefile • urllib3.response • urllib3.util.connection • urllib3.util.ssltransport • urllib3.util.timeout

socks MissingModule

imported by: urllib3.contrib.socks

sre_compile SourceModule

imports: _sre • sre_constants • sre_parse • sys

imported by: GearDesignGuide.py • re

sre_constants SourceModule

imports: _sre

imported by: GearDesignGuide.py • re • sre_compile • sre_parse

sre_parse SourceModule

imports: sre_constants • unicodedata • warnings

imported by: GearDesignGuide.py • re • sre_compile

ssl SourceModule

imports: _ssl • base64 • calendar • collections • enum • errno • os • socket • sys • time • warnings

imported by: ftplib • http.client • requests • urllib.request • urllib3.connection • urllib3.contrib.pyopenssl • urllib3.contrib.socks • urllib3.util.ssl_ • urllib3.util.ssltransport

stat SourceModule

imports: _stat

imported by: GearDesignGuide.py • genericpath • netrc • ntpath • os • pathlib • posixpath • shutil • tarfile • zipfile

statistics SourceModule

imports: _statistics • bisect • collections • decimal • fractions • itertools • math • numbers • operator • random

imported by: random

string SourceModule

imports: _string • collections • re

imported by: email._encoded_words • email._header_value_parser • email.quoprimime • http.cookies • logging • ntpath • nturl2path • urllib.request

stringprep SourceModule

imports: unicodedata

imported by: encodings.idna

struct SourceModule

imports: _struct

imported by: base64 • ctypes • gettext • gzip • pickle • requests.utils • tarfile • urllib3.packages.six • zipfile

subprocess SourceModule

imports: _posixsubprocess • _winapi • builtins • contextlib • errno • grp • io • msvcrt • os • pwd • select • selectors • signal • sys • threading • time • types • warnings

imported by: os • pyi_rth_subprocess.py

sys (builtin module)

imported by: GearDesignGuide.py • _bootlocale • _collections_abc • _pydecimal • argparse • ast • base64 • calendar • certifi.core • codecs • collections • configparser • contextlib • ctypes • ctypes._endian • dataclasses • datetime • dis • email._header_value_parser • email.generator • email.iterators • email.policy • encodings • encodings.rot_13 • encodings.utf_16 • encodings.utf_32 • enum • fractions • ftplib • getopt • getpass • gettext • gzip • importlib • importlib._bootstrap_external • importlib.metadata • importlib.util • inspect • linecache • locale • logging • mimetypes • ntpath • optparse • os • pathlib • pickle • posixpath • pprint • py_compile • pyi_rth_inspect.py • pyi_rth_subprocess.py • quopri • requests.compat • requests.packages • requests.sessions • requests.utils • selectors • shlex • shutil • socket • sre_compile • ssl • subprocess • tabulate • tarfile • tempfile • threading • tokenize • traceback • types • typing • urllib.parse • urllib.request • urllib3.connectionpool • urllib3.contrib.pyopenssl • urllib3.packages.six • urllib3.response • urllib3.util.ssl_ • urllib3.util.ssl_match_hostname • urllib3.util.wait • uu • warnings • weakref • zipfile

tabulate Package

imports: collections • collections.abc • dataclasses • functools • getopt • html • io • itertools • math • re • sys • tabulate.version • textwrap • wcwidth

imported by: GearDesignGuide.py • tabulate.version

tabulate.version SourceModule

imports: tabulate

imported by: tabulate

tarfile SourceModule

imports: argparse • builtins • bz2 • copy • grp • gzip • io • lzma • os • pwd • re • shutil • stat • struct • sys • time • zlib

imported by: shutil

tempfile SourceModule

imports: _thread • errno • functools • io • os • random • shutil • sys • types • warnings • weakref

imported by: importlib._common • requests.utils • urllib.request • urllib.response

termios MissingModule

imported by: getpass

textwrap SourceModule

imports: re

imported by: argparse • optparse • tabulate

threading SourceModule

imports: _collections • _thread • _threading_local • _weakrefset • collections • functools • itertools • os • sys • time • traceback

imported by: _threading_local • bz2 • http.cookiejar • logging • queue • requests.auth • requests.cookies • subprocess • urllib3._collections • zipfile

time (builtin module)

imports: _strptime

imported by: GearDesignGuide.py • _datetime • _strptime • datetime • email._parseaddr • email.generator • email.utils • gc • gzip • http.cookiejar • http.cookies • logging • pprint • queue • random • requests.auth • requests.cookies • requests.sessions • ssl • subprocess • tarfile • threading • urllib.request • urllib.robotparser • urllib3.util.retry • urllib3.util.timeout • urllib3.util.wait • zipfile

token SourceModule

imported by: GearDesignGuide.py • inspect • tokenize

tokenize SourceModule

imports: argparse • builtins • codecs • collections • io • itertools • re • sys • token

imported by: GearDesignGuide.py • importlib._bootstrap_external • inspect • linecache

traceback SourceModule

imports: collections • itertools • linecache • sys

imported by: GearDesignGuide.py • http.cookiejar • logging • py_compile • threading • warnings

tracemalloc SourceModule

imports: _tracemalloc • collections.abc • fnmatch • functools • linecache • ntpath • pickle

imported by: warnings

types SourceModule

imports: _collections_abc • functools • sys

imported by: GearDesignGuide.py • _weakrefset • certifi.core • contextlib • copy • ctypes • dataclasses • dis • email.headerregistry • enum • functools • http.cookies • importlib • importlib.resources • importlib.util • inspect • pickle • pprint • queue • subprocess • tempfile • typing • urllib.parse • urllib3.packages.six

typing SourceModule

imports: abc • collections • collections.abc • contextlib • functools • operator • re • sys • types

imported by: certifi.core • charset_normalizer.api • charset_normalizer.assets • charset_normalizer.cd • charset_normalizer.constant • charset_normalizer.legacy • charset_normalizer.md • charset_normalizer.models • charset_normalizer.utils • functools • idna.core • idna.intranges • idna.uts46data • importlib.abc • importlib.resources

unicodedata E:\Application\Python\Python39\DLLs\unicodedata.pyd

imported by: charset_normalizer.utils • encodings.idna • idna.core • sre_parse • stringprep • urllib.parse

unicodedata2 MissingModule

imported by: charset_normalizer.utils

urllib Package

imported by: GearDesignGuide.py • email._header_value_parser • urllib.error • urllib.parse • urllib.request • urllib.response • urllib.robotparser

urllib.error SourceModule

imports: urllib • urllib.response

imported by: GearDesignGuide.py • urllib.request

urllib.parse SourceModule

imports: collections • re • sys • types • unicodedata • urllib • warnings

imported by: GearDesignGuide.py • email.utils • http.client • http.cookiejar • mimetypes • nturl2path • pathlib • requests.compat • urllib.request • urllib.robotparser

urllib.request SourceModule

imports: _scproxy • base64 • bisect • contextlib • email • email.utils • fnmatch • ftplib • getpass • hashlib • http.client • http.cookiejar • io • mimetypes • nturl2path • os • posixpath • re • socket • ssl • string • sys • tempfile • time • urllib • urllib.error • urllib.parse • urllib.response • warnings • winreg

imported by: GearDesignGuide.py • http.cookiejar • requests.compat • urllib.robotparser

urllib.response SourceModule

imports: tempfile • urllib

imported by: GearDesignGuide.py • urllib.error • urllib.request

urllib.robotparser SourceModule

imports: collections • time • urllib • urllib.parse • urllib.request

imported by: GearDesignGuide.py

urllib3 Package

imports: __future__ • logging • urllib3 • urllib3._version • urllib3.connectionpool • urllib3.exceptions • urllib3.filepost • urllib3.poolmanager • urllib3.response • urllib3.util.request • urllib3.util.retry • urllib3.util.timeout • urllib3.util.url • urllib3_secure_extra • warnings

imported by: requests • urllib3 • urllib3._collections • urllib3._version • urllib3.connection • urllib3.connectionpool • urllib3.contrib • urllib3.contrib.pyopenssl • urllib3.exceptions • urllib3.fields • urllib3.filepost • urllib3.packages • urllib3.poolmanager • urllib3.request • urllib3.response • urllib3.util

urllib3._collections SourceModule

imports: __future__ • collections • collections.Mapping • collections.MutableMapping • collections.abc • threading • urllib3 • urllib3.exceptions • urllib3.packages • urllib3.packages.six

imported by: urllib3.connection • urllib3.poolmanager • urllib3.response

urllib3._version SourceModule

imports: urllib3

imported by: urllib3 • urllib3.connection

urllib3.connection SourceModule

imports: __future__ • datetime • http.client • logging • os • re • socket • ssl • urllib3 • urllib3._collections • urllib3._version • urllib3.exceptions • urllib3.packages • urllib3.packages.six • urllib3.util • urllib3.util.connection • urllib3.util.proxy • urllib3.util.ssl_ • urllib3.util.ssl_match_hostname • warnings

imported by: urllib3.connectionpool • urllib3.contrib.socks • urllib3.response

urllib3.connectionpool SourceModule

imports: __future__ • errno • logging • queue • re • socket • sys • urllib3 • urllib3.connection • urllib3.exceptions • urllib3.packages • urllib3.packages.six • urllib3.packages.six.moves • urllib3.request • urllib3.response • urllib3.util.connection • urllib3.util.proxy • urllib3.util.queue • urllib3.util.request • urllib3.util.response • urllib3.util.retry • urllib3.util.ssl_match_hostname • urllib3.util.timeout • urllib3.util.url • warnings

imported by: urllib3 • urllib3.contrib.socks • urllib3.poolmanager

urllib3.contrib Package

imports: urllib3 • urllib3.contrib._appengine_environ • urllib3.contrib.pyopenssl

imported by: requests • urllib3.contrib._appengine_environ • urllib3.contrib.pyopenssl • urllib3.contrib.socks • urllib3.util.connection

urllib3.contrib._appengine_environ SourceModule

imports: os • urllib3.contrib

imported by: urllib3.contrib • urllib3.util.connection

urllib3.contrib.pyopenssl SourceModule

imports: 'OpenSSL.crypto' • 'cryptography.hazmat' • 'cryptography.x509' • OpenSSL • __future__ • cryptography • idna • io • logging • socket • ssl • sys • urllib3 • urllib3.contrib • urllib3.packages • urllib3.packages.backports.makefile • urllib3.packages.six • urllib3.util • urllib3.util.ssl_ • warnings

imported by: requests • urllib3.contrib

urllib3.contrib.socks SourceModule

imports: __future__ • socket • socks • ssl • urllib3.connection • urllib3.connectionpool • urllib3.contrib • urllib3.exceptions • urllib3.poolmanager • urllib3.util.url • warnings

imported by: requests.adapters

urllib3.exceptions SourceModule

imports: __future__ • http.client • urllib3

imported by: requests • requests.adapters • requests.exceptions • requests.models • urllib3 • urllib3._collections • urllib3.connection • urllib3.connectionpool • urllib3.contrib.socks • urllib3.poolmanager • urllib3.response • urllib3.util.connection • urllib3.util.request • urllib3.util.response • urllib3.util.retry • urllib3.util.ssl_ • urllib3.util.ssltransport • urllib3.util.timeout • urllib3.util.url

urllib3.fields SourceModule

imports: __future__ • email.utils • mimetypes • re • urllib3 • urllib3.packages • urllib3.packages.six

imported by: requests.models • urllib3.filepost

urllib3.filepost SourceModule

imports: __future__ • binascii • codecs • io • os • urllib3 • urllib3.fields • urllib3.packages • urllib3.packages.six

imported by: requests.models • urllib3 • urllib3.request

urllib3.packages Package

imports: urllib3

imported by: urllib3._collections • urllib3.connection • urllib3.connectionpool • urllib3.contrib.pyopenssl • urllib3.fields • urllib3.filepost • urllib3.packages.backports • urllib3.packages.six • urllib3.poolmanager • urllib3.response • urllib3.util.connection • urllib3.util.queue • urllib3.util.retry • urllib3.util.ssl_ • urllib3.util.ssltransport • urllib3.util.url

urllib3.packages.backports Package

imports: urllib3.packages

imported by: urllib3.packages.backports.makefile

urllib3.packages.backports.makefile SourceModule

imports: io • socket • urllib3.packages.backports

imported by: urllib3.contrib.pyopenssl

urllib3.packages.six SourceModule

imports: StringIO • __future__ • functools • importlib.util • io • itertools • operator • struct • sys • types • urllib3.packages

imported by: urllib3._collections • urllib3.connection • urllib3.connectionpool • urllib3.contrib.pyopenssl • urllib3.fields • urllib3.filepost • urllib3.packages.six.moves • urllib3.poolmanager • urllib3.response • urllib3.util.connection • urllib3.util.queue • urllib3.util.request • urllib3.util.retry • urllib3.util.ssl_ • urllib3.util.ssltransport • urllib3.util.url

urllib3.packages.six.moves RuntimePackage

imports: queue • urllib3.packages.six

imported by: 'urllib3.packages.six.moves.urllib' • http.client • urllib3.connectionpool • urllib3.util.queue • urllib3.util.response

urllib3.poolmanager SourceModule

imports: "'urllib3.packages.six.moves.urllib'.parse" • __future__ • collections • functools • logging • urllib3 • urllib3._collections • urllib3.connectionpool • urllib3.exceptions • urllib3.packages • urllib3.packages.six • urllib3.request • urllib3.util.proxy • urllib3.util.retry • urllib3.util.url

imported by: requests.adapters • urllib3 • urllib3.contrib.socks

urllib3.request SourceModule

imports: "'urllib3.packages.six.moves.urllib'.parse" • __future__ • urllib3 • urllib3.filepost

imported by: urllib3.connectionpool • urllib3.poolmanager

urllib3.response SourceModule

imports: __future__ • brotli • brotlicffi • contextlib • io • logging • socket • sys • urllib3 • urllib3._collections • urllib3.connection • urllib3.exceptions • urllib3.packages • urllib3.packages.six • urllib3.util • urllib3.util.response • zlib

imported by: requests.adapters • urllib3 • urllib3.connectionpool

urllib3.util Package

imports: __future__ • urllib3 • urllib3.util.connection • urllib3.util.request • urllib3.util.response • urllib3.util.retry • urllib3.util.ssl_ • urllib3.util.timeout • urllib3.util.url • urllib3.util.wait

imported by: requests.adapters • requests.models • requests.utils • urllib3.connection • urllib3.contrib.pyopenssl • urllib3.response • urllib3.util.connection • urllib3.util.proxy • urllib3.util.queue • urllib3.util.request • urllib3.util.response • urllib3.util.retry • urllib3.util.ssl_ • urllib3.util.ssl_match_hostname • urllib3.util.ssltransport • urllib3.util.timeout • urllib3.util.url • urllib3.util.wait

urllib3.util.connection SourceModule

imports: __future__ • socket • urllib3.contrib • urllib3.contrib._appengine_environ • urllib3.exceptions • urllib3.packages • urllib3.packages.six • urllib3.util • urllib3.util.wait

imported by: urllib3.connection • urllib3.connectionpool • urllib3.util

urllib3.util.proxy SourceModule

imports: urllib3.util • urllib3.util.ssl_

imported by: urllib3.connection • urllib3.connectionpool • urllib3.poolmanager

urllib3.util.queue SourceModule

imports: Queue • collections • queue • urllib3.packages • urllib3.packages.six • urllib3.packages.six.moves • urllib3.util

imported by: urllib3.connectionpool

urllib3.util.request SourceModule

imports: __future__ • base64 • brotli • brotlicffi • urllib3.exceptions • urllib3.packages.six • urllib3.util

imported by: urllib3 • urllib3.connectionpool • urllib3.util

urllib3.util.response SourceModule

imports: __future__ • email.errors • http.client • urllib3.exceptions • urllib3.packages.six.moves • urllib3.util

imported by: urllib3.connectionpool • urllib3.response • urllib3.util

urllib3.util.retry SourceModule

imports: __future__ • collections • email • itertools • logging • re • time • urllib3.exceptions • urllib3.packages • urllib3.packages.six • urllib3.util • warnings

imported by: requests.adapters • urllib3 • urllib3.connectionpool • urllib3.poolmanager • urllib3.util

urllib3.util.ssl_ SourceModule

imports: __future__ • binascii • hashlib • hmac • os • ssl • sys • urllib3.exceptions • urllib3.packages • urllib3.packages.six • urllib3.util • urllib3.util.ssltransport • urllib3.util.url • warnings

imported by: urllib3.connection • urllib3.contrib.pyopenssl • urllib3.util • urllib3.util.proxy

urllib3.util.ssl_match_hostname SourceModule

imports: ipaddress • re • sys • urllib3.util

imported by: urllib3.connection • urllib3.connectionpool

urllib3.util.ssltransport SourceModule

imports: io • socket • ssl • urllib3.exceptions • urllib3.packages • urllib3.packages.six • urllib3.util

imported by: urllib3.util.ssl_

urllib3.util.timeout SourceModule

imports: __future__ • socket • time • urllib3.exceptions • urllib3.util

imported by: urllib3 • urllib3.connectionpool • urllib3.util

urllib3.util.url SourceModule

imports: __future__ • collections • idna • re • urllib3.exceptions • urllib3.packages • urllib3.packages.six • urllib3.util

imported by: urllib3 • urllib3.connectionpool • urllib3.contrib.socks • urllib3.poolmanager • urllib3.util • urllib3.util.ssl_

urllib3.util.wait SourceModule

imports: errno • functools • select • sys • time • urllib3.util

imported by: urllib3.util • urllib3.util.connection

urllib3_secure_extra MissingModule

imported by: urllib3

uu SourceModule

imports: binascii • optparse • os • sys

imported by: email.message

warnings SourceModule

imports: _warnings • builtins • linecache • re • sys • traceback • tracemalloc

imported by: GearDesignGuide.py • _collections_abc • argparse • ast • charset_normalizer.api • charset_normalizer.legacy • charset_normalizer.models • collections • configparser • datetime • enum • ftplib • getpass • gettext • gzip • hmac • http.client • http.cookiejar • importlib • importlib.abc • importlib.util • inspect • locale • logging • os • random • requests • requests.auth • requests.packages • requests.utils • shlex • sre_parse • ssl • subprocess • tempfile • urllib.parse • urllib.request • urllib3 • urllib3.connection • urllib3.connectionpool • urllib3.contrib.pyopenssl • urllib3.contrib.socks • urllib3.util.retry • urllib3.util.ssl_ • zipfile

wcwidth MissingModule

imported by: tabulate

weakref SourceModule

imports: _collections_abc • _weakref • _weakrefset • atexit • copy • gc • itertools • sys

imported by: GearDesignGuide.py • _threading_local • copy • functools • logging • tempfile

winreg (builtin module)

imported by: importlib._bootstrap_external • mimetypes • requests.utils • urllib.request

zipfile SourceModule

imports: argparse • binascii • bz2 • contextlib • importlib.util • io • itertools • lzma • os • posixpath • py_compile • shutil • stat • struct • sys • threading • time • warnings • zlib

imported by: importlib._common • importlib.metadata • requests.utils • shutil

zlib (builtin module)

imported by: encodings.zlib_codec • gzip • shutil • tarfile • urllib3.response • zipfile
